simoninns/valiant-turtle/README.md

# valiant-turtle
Information and resources on the original 1980s Valiant Turtle robot

Please see the GitHub wiki for details.
