simoninns/valiant-turtle/valiant_docs/leaflets/The Valiant Turtle on the BBC.pdf

### VALIANT TECHNOLOGY LTD

(Sales) Gulf House, 370 York Aoad,Wandsworlh,London SW18 1SP Tel: (01) 874 8747/874 9000

THE VALIANT TURTLE ON THE BBC

The valiant Turtle can run fro,a most aicrocomputers. It is interfaced to various LOGOs and LOGO-type languages.

The performance of the Valiant TUrtle is affected by the software with which it is used. To obtain optimum performance, you should use a full implementation of LOGO.

These instructions cover the operation of the Valiant Turtle on the BBC Model 8 and BBC Kaster ~ith:

11 | Logotron LOGO and Serial Interface
21 | Logotron LOGO and Parallel Interface
3) LSL (LOGOsoftl LOGO
4) Acornsoft LOGO
51 | DART
6J | Valiant Mover Proqram.

We have recommended the adoption of a one-centimetre Turtle step as standard. You will find, however, that both the Loqotron Serial Interface and DART default to a TUrtle step of one millimetre. Using the software, in most cases you can altar the set Turtle step to your preference.

Unlike some other computer equipment, the Valiant TUrtle has a VERY PRECISE START-UP PROCEDURE. It is important to follow the instructions given step by step unless you are very confident
in using the equipment . This is because the Valiant Turtle is remote-controlled. The Communicator has to be synchronised with .the computer if the Turtle is to receive intelligible signal&.

If the Turtle does no t respond after you have carried out the various instructions IN TKE CORR£CT ORDER, consult the Trouble-shootinq section at the back of the Valiant Turtle User Guide.

(c J 1987 Valiant Technology Ltd. Part No. 29716 Issue B

The Valiant Turtle on the BBC

I N D E X

Page No.

Introduction

I N D E X

STARTING THE VALIANT TURTLE WITH,

pl

p2

1) Logotron LOGO & Serial Interface | pJ
2) Logotron LOGO & Parallel Interface | p4
3) LSL (LOGOsoft, LOGO | p5
4) Acornsoft LOGO | p6
5) DART {Making a Valiant driver file) | pi
DART (Starting up) | p8
6) Valiant Mover Program (Starting up) | p9
Valiant Mover Program details | plO,
Multiple Valiant Turtles | p6

pll

1 ) Starting the Valiant Turtle with Logotron ux;o and the Serial Interface

l | Switch the computer OFF.
2 | Position the 4 small coloured switches on the side of the Communicator
as follows (see Fig. l):
~ Switches l & 2 ON | i | g Switches 3 & 4 OFF | 0
Fig. l | Fig. 2 | Fig. 3
3 | Set both switches underneath the Turtle to OFF (see Fig 2).
4 | Insert the end of the Communicator lead which corresponds to Fig. 3 into
the serial socket on the Communicator Csee Fig. 4).
Fig . 4 | ~
~

Fig. 5
5 Insert the other end of the Communicator lead {Fig. 5)
into the RS423 socket at the back of the microcomputer.
IMPORTANT NOTE: | (a) | If you are using a BBC 'B' computer, FACE THE NOTCH
TOWARDS THE RGB SCX:KET 4on the left hand side when viewed from the rear of the computer].
(b) If you are using a BBC MASTER computer, FACE THE NOTCH AWAY FROM THE RGB SOCKET (on the right hand side when viewed from the rear of the computer).
Care MUST be taken since it is possible for the lead to be plugged in the wrong way round, when no signals will be transmitted to the Turtle.
6 | Switch ON the computer.
7 | Plug the Valiant power adaptor into your niains supply and turn on the
power.

B Push the jack plug on the end of the power adapter ' s lead firmly into the power socket at the rear of the Communicator (see Fig. 4).

9 If the red light behind the red Communicator screen does not illwninate, consult the Troubleshooting section of the Valiant Turtle User Guide.

10 You may switch on your Turtla any time from now.

11 Type *LOGO and press the RETURN key.

12 Insert EITHER the Valiant BBC software disc 29903 issue J or later OR Logotron LOGO Extension disc (from your LOGO pack) into the disc drive.

13 If you hav,e inserted the Valiant disc, type USE ·vALIANT and press the RETURN key.

If you have inserted the Lo9otron Extension dis c , type USE "uVAL and press the RETURN key .

14 Your Turtle system is now r e ady for use .

Remember your special Floor Turtle primitives in the Serial Interface: FLOOR, SCREEN, BOTH, SCALE, SETSCALE. The turtle's steps a re set at 1mm . Typing SCALE tells you this is 3 units. So typin9 St:rSCALE 30, for example, will set the turtle's steps at 1 centimetce.

2) starting the Valiant Turtle with Logotron LOGO and the Parallel Interface

Switch the computer OFF.

2 Position the 4 small coloured switches on the side of the Conununicator as follows (see Fig. 1):
~ Switch l OFF | lffi Switches 2, 3 "4 OM
Fig. 1 | Fig. 2 | Fig. 3
3 | Set both small switches underneath the Turtle to OFF (see Fig.2>.

### 4 Insert the end of the Communicator lead with 15 holes (see Fig. J) into

the D-shaped ("Parallel"! socket on the Communicator (see Fig. 4).

,~r1d,pCot
1,11d 1oock.tl

~
\.!!!!!!!.I | Fig. 4
5 | Insert the other end of the Communicator lead into the socket marked
'User Port' located underneath the computer.
6 | Switch ON the computer.
7 | Plug the Valiant power adaptor into your mains supply and turn on the
power.

8 Push the jack plug on the end of the power adaptor's lead firmly into the power socket at the rear of the Communicator Csee Fig. 41.

9 If the red light behind the red Communicator screen does not illuminate, consult the Troubleshooting section of the Valiant Turtle User Guide.

10 | You may switch on your TUrtle any ti•e from now.
11 | Typ@ *LOGO and press the RETURN key.
12 | Insert the Valiant BBC software disc 29903 OR the Logotron LOGO
Extension disc (from your LOGO pack] into the disc drive.

13 If you have inserted the Valiant disc, type USE "VI\LIANl and press the RETURN key.

| If you have inserted the Logotron Extension disc, type USE "uV.PARA
- and press t he RETURN key.

14 Your Turtle system is now ready for use.

The special Valiant floor turtle primitives in the Parallel Interface are : TURTLEON (floor and screen turtles f o llow LOGO commandst, TURTLEOFF (screen turtle only), SCALE (tells you the size of the turtle's steps in mi lli metres), and SETSCALE !allows you t o set the si~e of the turtle's steps in whole millimetres - decimal places are not e ffective).

- !late : If you have an early version of the Logotron Extension disc, you n,ay find that you need to type USE ftuVAL to find the Valiant Para llel Interface. On later versions, uVAL is used only for the Serial Interface.

3) Starting the Valiant Turtle "'ith LSL (L(X;OSoft) LOGO
Note: | You will need the Valiant 88C Serial Interface Kit.
l | switch the computer OFF.
2 | Position the 4 small coloured switches on the side of the Communicator
as follows (see Fig. 1):

Fig.

Switches l & 2 ON
Switches 3 & 4 OFF

Fig. 2

3 Set both switches underneath the Turtle to OFF (see Fig. 2).

~
~

Fig. 3

4 Insert the end of the Collllllunicator lead which corresponds to Fig. 3 into the Serial socket on the Communicator (see Fig. 4J.

'o n r,::::::;)
~\..:!!!!.::..I
\ | \ | [ "•· .
® ⁰
z | j | s ,~ ,1d.lp1Df | Seri.\! | P.ui1ll.t
lt?~d jO(kCl | Soehl | SGCkfl

Fig. 5

5 Insert the other end of the Communicator lead (Fig. SI into the RS423 socket at the back of the microcomputer.
IMPORTANT NOTE: | (a) | If you are using a BBC 'B' computer, FACE THE NOTCH
TOWARDS THE RGB SOCKET (on the left hand side when viewed from the rear of the computer) .
(b) If you are using a BBC MASTER computer, FACE THE NOTCH AWAY FROM THE RGB SOCKET (on the right hand side when viewed from the rear of the computer) .

plugged in the

### 6 Switch ON

Care must be taken since it is possible for the lead to be wrong way round, when no signals will be transmitted to the Turtle . the computer.

7 Plug the Valiant power adaptor into your mains supply and turn on the power.

8 Push the jack plug an the end of the power adaptor' s lead firmly into th~ power socke t at the rear of the Communic ator (see Fig . 41.

9 If the red light behind the r e d Conununicator screen does not illumi nate , cons ult the Troubleshooting s e c tion of the Valiant Turtle User Guide .

10 | You may switch on your Turtle any time from now.
11 | Type *LOGO and press the RETURN key .
12 | If you have LSL LOGO version 1.0, insert the Valiant BBC so ftware disc
29903 issue I or later into the disc drive.
If you have LSL LOGO version 1. 2 or later, insert t he LOGOs o ft Toolkit Disc l [comes with your LOGO pack> into the disc drive .

13 If you have inserted the Valiant disc, type *EXEC LSL and press RETURN. If you have inserted the LOGOso ft disc , EITHER type *EXEC VALOBJ
OR ho ld down the SHIFT ke y a nd press the BREAK key (ca lled "SHIFT-BREAK") .

14 Your Turtle system is now ready f or use.

Your special fl oo r turtle co1111n3nds a dde d to LOGO are, TURTLE OFF (stops the floor tur tle moving], TURTLE ON (sta r ts it again), a nd UNITS (turtle's steps are 1cm - or UNITS 10. Size of ste p can be changed by typ~ng UNITS
and a new number.).

41

fig. s

Starting the Vali .. nt Turtle with Acornsoft LOOO

Note: You will need the Valiant BBC Parallel interfac e Kit.

1 | Swi t ch the computer OFF.
2 | Position the 4 small coloured switches on the side of the Co!Mlunicator
as follows (see Fig. 1):

Fig. l

Swit ches
Switches

& 2 OFF
and 4 ON
Fig. 2 | Fig. 3
3 | Set both small switches underneath the Turtle to Off (see Fig. 2).

### 4 Jnsert the end of the Communicator lead with 15 holes (see Fig. 3) into

the P-shaped ("Parallel") socket on the Coma,unicator (see Fig. 4 ).

,ow~ ~ | lat | S.,... | ,M~~ I ,C~fi ~lr.M | So(lrt | ~cd,f't
5 | Insert the other end o! the Comraunicator lead into the &ocket ~arked
'User Port • located underneath the compute r.
6 | Switch ON the computer.
7 | Plug the Valiant power adaptor into your mains supply and turn on the
power.

8 Push the Jack plug on the end of the power adaptor lead firmly into the power socket at the rear of the Communicator (see Fig. 4 ) .

9 It the red light behind th• red Communicator screen does not illuminate, consult the Troubleshooting sec tion of the Valiant Turtle user Guide.

10 | You ma y switch on your Turtle a ny time froM no1,1.
11 | Type ' l,OGO a nd pres s the RETURN key.
12 | Insert the disc provided with Acornsoft LOGO into the dis c drive,
13 | Type LOAO " VALIANT and press the RETURN key. Type FLOOR and press RETURN .
14 | Your Turtle syste~ is now ready for use.

For details of the specia l Valiant floor turtle options, see your Aco rnsoft L(X;O manual .

Using Multiple Turtles with Acornsott LOGO

You can program up to 4 Vali ant Turtles independently using Acornsoft LOGO . See Chapter 12 in the Acornsof t LOGO <Mnual for information.

Follo,_. t.he i nstruc tions above, but set the SD\al l s1,1i tches underneath Turtl~ as follows jsee fig . 5):

each
[i;] | ~ ~ | ~

5) Starting the Valiant TUrtle with DART

Note; You will need the Valiant BBC S£R1AL Interface Kit.
You will need a BASIC 2 chip in your BBC ~odel B computer unless you have Valiant BBC software disc 29903 (or 29908) ISSUE Kor later.

TO_MAKE_A_VALIANT_TURTLE_DRIVER_FILE_ON_T"E DART_DISC

(al | If you have DART version 2.4 or later versions -
Type CHAIN "DART" | DART will then ask you to select which floor
turtle you want to use. Select l | for the Valiant TUrtla and follow
the instruct ions in the program. You will finish up with a tile saved onto disc or. tape called CART3
(bi | If you have DART version 2 . 3 -
Type LOAD "DART" | Then type

22020A\ z lJ:CALL&FFEE:PR0Cdy(l00):A\=B5:CALL&FFEE:PR0Cdy(l00) :A\;0: CALL&FFEE:A\z-p\•16:CALL&FFEE:*FXJ,O

then type SAVE "DART" Now follow the instructions above for CART version 2.4 or later versions.

(cl If you have DART version 2.2 or earlier versions, you will not be able to drive the Valiant Turtle from your copy of DART. Please contact The Advisory Unit at Hatfield, Herts., telephone (07072) 65443, who will advise you about obtaining an up to date version.

The steps outlined above need only be performed once. When they have been completed and when you subsequently want to use the Valiant Turtle, please follow the instruc tions overleaf (pages 8 and 9).

... the Valiant Turtle with DART {/continued)

TO START_UP_THE_TURTLE_SYSTEH

1 | Switch the computer OFF.
2 | Position the 4 small coloured switches on the side of the Collllllunicator
as follows (see Fig. 1):

Fig. 1

Switches l, 2 ON
Switches 3, 4 OFF

Fig. 2

3 Set both switches underneath the Turtle to OFF (see Fig. 2).

~
~

Fig. )

4 Insert the end of the C0111111,unicator lead which corresponds to Fig. 3 into the Serial socket on the C0111municator (see Fig. 4).

Fig. 4

row•• .idaplor
k,•d wckN
Se•i•I | P•r..Uel Sockel | Socket

~
~ Fig. 5

5 Insert the other
socket at the back o!

end o! the Communicator
the co.puter.

lead (Fig. 5) into the RS423

IMPORTANT NOTE: {al If you are using a BBC 'B' computer, FACE THE NOTCH TOWARDS THE RGB SOCKET (on the left hand side when viewed from the rear of the computer) .
(b) If you are using a BBC MASTER computer, FACE THE NOTCH AWAY FROM THE RGB SOCKET {on the right hand side when viewed from the rear of the computer).
Care must be taken since it is possible for the lead to be plugged in the other way round, when no signal will be transmitted to the Turtle
6 | Switc h ON the computer.
7 | Plug the Valiant power adaptor into your mains supply and turn on the
power.

8 Push the jack plug on the end of the power adaptor's lead firmly i nto the power socket at the rear of the Coamunicator (sea Fig. 4).

9 If the red light behind the red Communicator screen does not illuminate, consult the Troubleshooting se c tion of the Valiant Turtle User Guide.

10 | You may switch on your turtle any time from now .
11 | Insert the DART disc into the disc drive .
12 | Type CHAHI "DART]" and press the RETURN key .
13 | When yo u wish t o sta rt the floor turtle, type TURTLE ON and press the
Rl::TURN key.

14 Your Turtle s ystem is now ready f or use .

6) Starting the Valiant Turtle with the Valiant Mover Program

This software was written before any full LOGOs for the BBC were available. The program is limited and is not reconunended for long-term use. It will
move the Valiant TUrtle, however, in the absence of an alternative.
Note - You will need the BBC SERIAL Interface kit.
Unless you have Valiant BBC software disc 29903 (or 299081 issue Kor later you will need a BASIC 2 chip in your BllC Model B computer.
1 | Switch the computer OFF.
2 | Position the 4 small coloured switches on the side of the Conununicator
as follows (see Fig, 1):

Fig. 1

Switchea 1 ~ 2 ON
Switches 3 & 4 OFF

Fig. 2

3 Set both switches underneath the TUrtle to OFF (see Fig. 2).

~
~

Fig. 3

4 Insert the end of the Communicator lead which corresponds to· Fig. 3 into the Serial socket on the Connunicator (see Fig. 4).

P~rMJ~plor
Sc.-.ad )tK.ef
5 Insert" the other
socket at the back of
Suial | P•r~Uel
Sock<1 | Sockot
| end of the Cornmunicator
| the computer.

Fig. 4

~
~

Fig. 5

| | lead (Fig. 5) into the RS423

IMPORTANT NOTE: If you are using a BBC Model B computer, FACE THE NOTCH TOWARDS THE RGB SOCKET (on the left hand side when viewed from the rear of the computer).
If you are using a BBC Master computer, FACE THE NOTCH AWAY FROM THE RGB SOCKET (on the right hand side when viewed from the rear of the computer).
Care must be taken since it is possible for the lead to be plugged in the wrong way round, when the Turtle will not respond to commands.
6 | Switch ON the computer.
7 | Plug the Valiant power adaptor into your mains supply and turn on the
power.

8 Push the jack plug on the end of the power adaptor lead firmly into the power socket at the rear of the Communicator (see Fig. 4).

9 !f the red light behind the red Communicator screen does not illuminate, consult the Troubleshooting section of the Valiant TUrtle User Guide.

10 | You •ay switch on your TUrtle any time from now.
11 | Insert the Valiant BBC Software disc (or tape) into the disc drive (or
tape recorder).

12 Type CHAIN "TURTLE" and press the RETURN key. With the disc version , you can save time by holding down the SHIFT key and then pressing BRE~K (called "SHIFT-BREAK·).

13 The scree n will tell you to check the Conununicator and Turtle are both switched on. Then press the RETURN key.
14 | Your TUrtle system is now ready for use. | !More details overleaf/ .. )

... the Valiant Turtle with the Valiant Mover Program (/continued l)

USlNG THE VALIANT MOVER PROGRAM

Note : With the disc version of the Valiant Mover Prograa if you have any problems keep the disc in the disc drive, type HELP and then press the RETURN key.

onc e you have the Valiant MOver Prograa started, you will see a ~enu of cOCMtands at your disposal. This is a guide to the use of these commands .

FORWARD (FO) and
BACK (BK)

RIGHT (RT) and
LEFT (LT)

PENUP (PU) and
PENDOWN (PO)

SCALE

QUIT

HELP (disc only)

HELP (disc only!

EDIT (ED) and
TO

Both of these c01M1ands need to be given a nwaber. This nuaber represents the distance in 'turtle steps' that the Turtle will aove . You need to put a space between the coamand and the nwnber, e.g.
FO 10

These two c01M1ands require a nuaber which is the nUllber of degrees that the Turtle is to turn. As with FORWARD and BACK, you must put a space between the command and the nuaber, e .g .
RT 90

These co ... ands make the Turtle raise and lower its pen. They do not need any other information and so should be entered on their own .

This coemand allows you to change the size of the Turtle's steps (set automatically to 10mm, lcmi. Just enter the word SCALE on its own and the computer will tell you what the current size ot a Turtle step is and give you the opportunity to change it if you wish.

When you have finished using the Turtle, type QUlT. The coaputer will ask if you are sure you want to QUIT.
Enter YES or you will be returned to the .. nu .
The coamand QUIT allow• you to leave the Valiant Mover Program. It will erase all the procedures in the computer's aUIOry.

HELP will tell you how to get infonaation on any co111111and.

HELP followed by a co111111&nd will give you inforiaation on how to use that command, e.g. HELP FD will tell you how to use FORWARD.

It is possible to define a 'procedure'. This is a way of stringing several coaiaanda together. To write a procedure, type TO followed by the name of your procedure, or EDlT followed by the na111e of the procedure .

This will get you into the 'Editor'. The Editor will allow you to enter text using the alphabetic and numeric keys, and to change text using the cursor keys and DELETE key . In the Editor, the DELETE key deletes the character behind the cursor.

The backslash key can be used to insert spaces into your procedure.

CURSOR KEYS

BACKSLASH KEY

••. the Valiant Turtle with the Valiant Mover Program.C/continued 21

USING THE VALIANT MOVER PROGRAM (/continued)

PROCS (PR)

ERASE (ERJ

SAVE

LOAD

Your procedures should comprise one CO!lffland to a line and may not exceed the size of the screen .

When you have finished writing or editing your procedure, press fO, or if you want to leave the Editor without saving the procedure, press f9.

If subsequently you wish to change your procedure, you can do so by entering
EDIT and the procedure name.

Note: (ii To rep<!at a routine a number of times, typ<! REPEAT space number space <:( space routine space> e.g.

TO SQUARE
REPEAT 4 Z FD 10 RT 90 >

You must insert a space before and after each angular bracket.

(iiJ To input a variable to a procedure, type : and t he variable name in the title line of the procedure, e.g.

TO SQUARE , SIDE
REPEAT 4 < FD :SIDE RT 90 >

SQUARE will then require a numeric input, e .g.
SQUARE 20

You may use •ore than one input with a procedure, e.g . TO POLY :NUMBER :SIDE :ANGLE

This command gives a list of the procedures in the
computer ' s memory . It does not need any othbr information.

This colNl!and needs the name of a procedure to follow it, e.g. ERASE SQUARE. ERASE will make the computer forget that procedure.

Note , Use this command with care. Once erased, a procedure cannot be got back again .

This comma nd will allow you to save either a specific procedure (e .g. SAVE SQUARE), or all the procedures currently in the computer 's memory, on disc or tape under the chosen file name (e.g. SAVE FILENAME).

This command will all ow you to load t he procedure you have saved on disc or tape back into the computer , e . g. LOAD SQUARE , or all the procedures saved under the chosen file name, e.g. LOAD FILENAME.

Note: Any procedure(sl already of that file name in the computer's memory will t her eby be erased.
