simoninns/valiant-turtle/valiant_docs/service/Valiant - Circuit Schematics.pdf

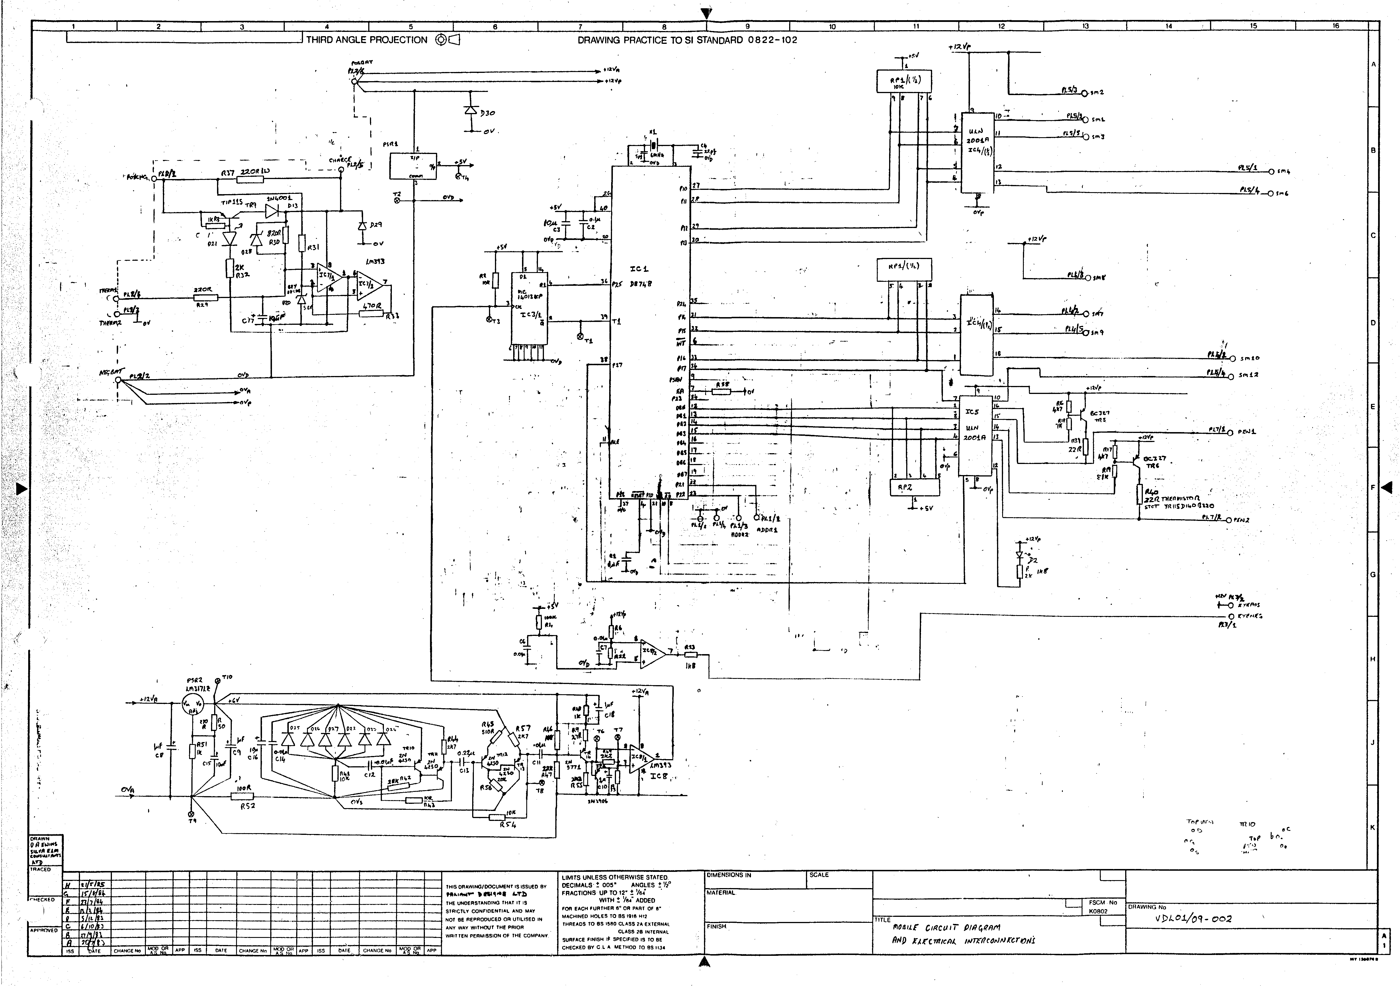
[picture p25: page 1]
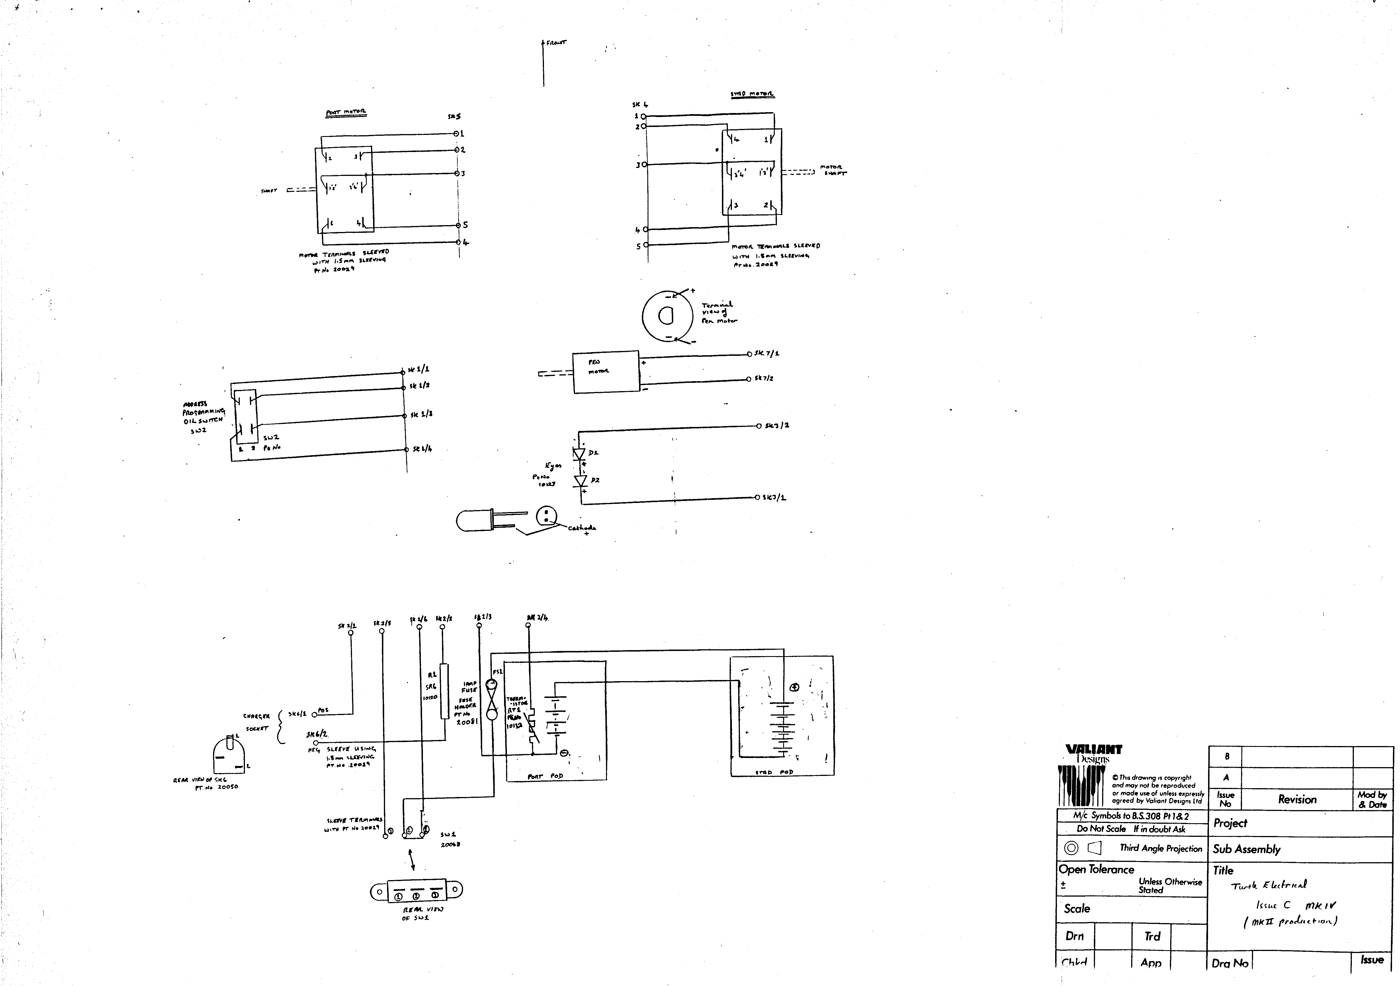
[picture p26: page 2]
