simoninns/valiant-turtle/valiant_docs/service/Valiant - Parts List for Mark II Valiant Turtle.pdf

\~~1.1,~NT

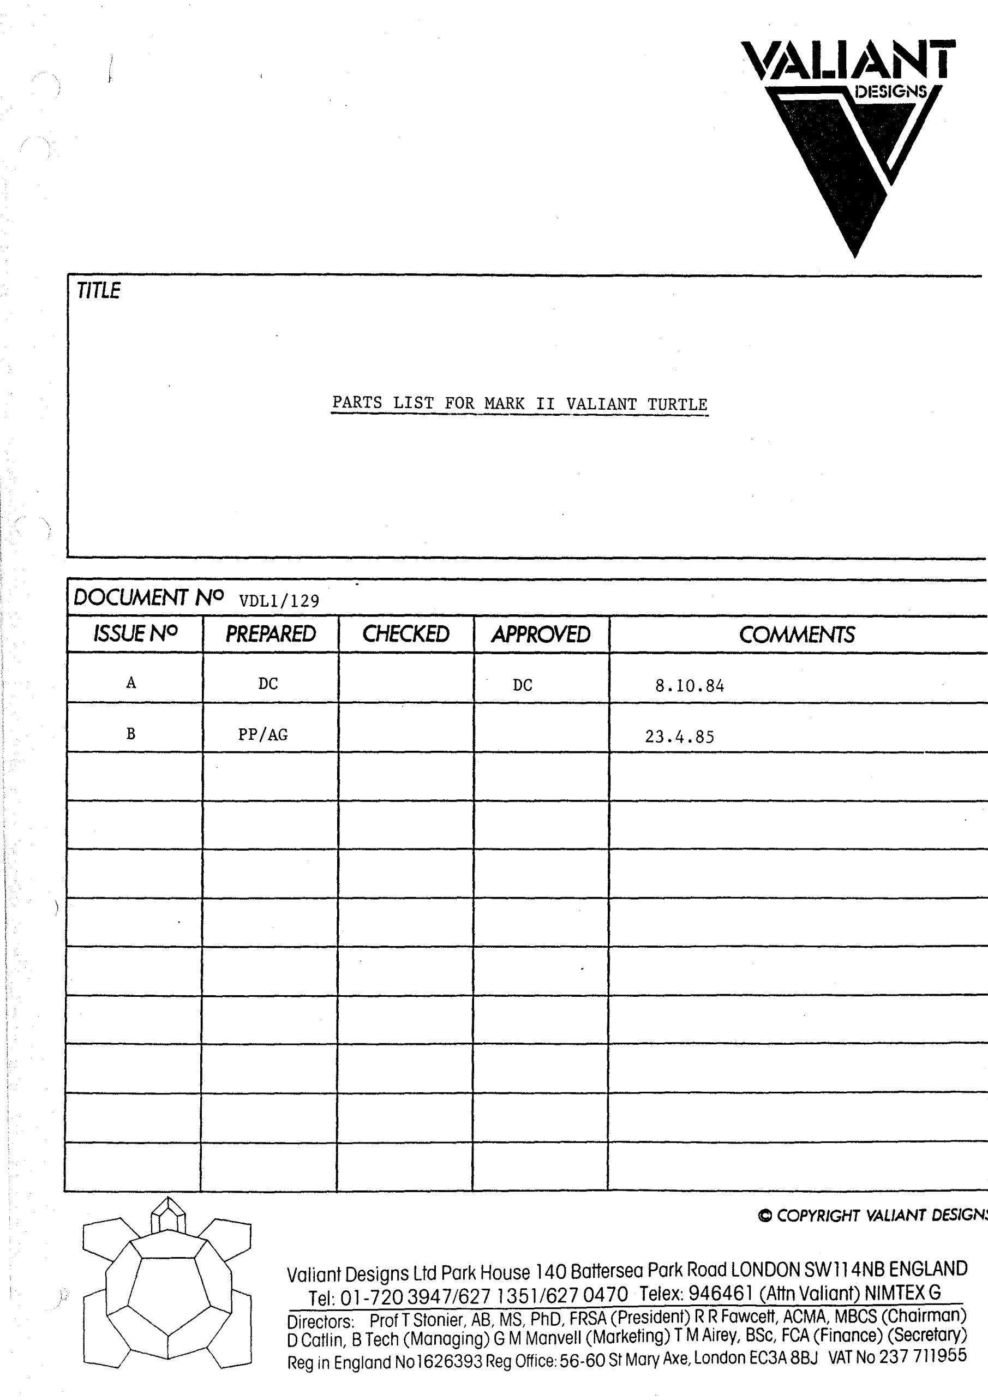
[picture p33: page 1]

### TITLE

PARTS LIST FOR MARK II VALIANT TURTLE

### DOCUMENT NO VDLl/129 ISSUE NO

A

B

PREPARED | CHECKED | APPROVED | COMMENTS
DC | DC | 8.10.84 | -
PP/AG | 23.4.85 | I

I

C COPYRIGHT VALIANT DESIGNS

Valiant Designs Ltd Park House 140 Battersea Park Road LONDON SWl l 4NB ENGLAND Tel: 01-720 394 7 /627 1351/62704 70 Telex: 946461 (Attn Valiant) NIMTEX G Directors: Prof T Stonier, AB, MS, PhD, FRSA (President) RR Fawcett, ACMA, MBCS (Chairman) D Catlin, B Tech (Managing) GM Manvel! (Marketing) TM Airey, BSc, FCA (Finance) (Secretary) Reg in England No 1626393 Reg Office: 56-60 St Mary Axe, London EC3A 8BJ VAT No 237 711955

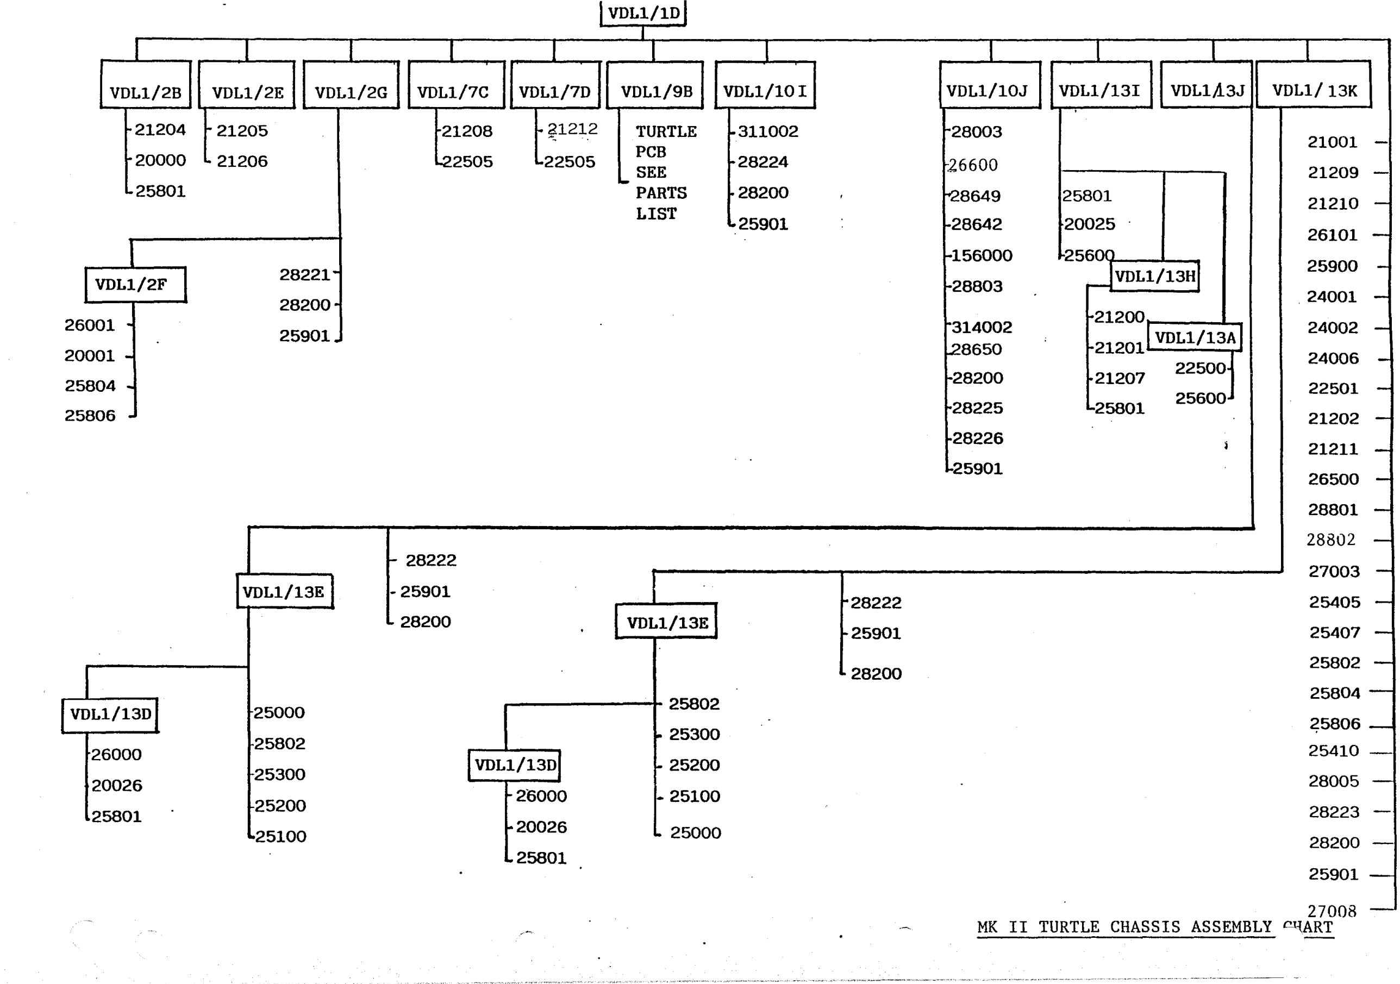
[picture p34: page 2]

VDL1/2B 11 VDL1/2E 11 VDL1/2G 11 VDL1/7C 11 VDL1/7D 11 VDL1/9B I I VDLl/10 I 21204 t 21205

20000 21206
25801

VDL1/2F

26001
20001
25804
25806

VDL1/13D

26000
20026
25801

28221
28200
25901

VDL1/13E

25000
25802
25300
25200
25100

21208
2505

28222
- 25901
28200

~1212
22505

TURTLE
PCB
SEE
PARTS
LIST

VDL1/13E

.--~~~~~+25802
25300
VDL1/13D
20000
20026
25801

25200
- 25100

25000

311002
28224
28200
25901

28222
25901

28200

VDLl/lOJ I I VDL1/13I 11 VDL1A.3J II VDLl/ 13K

28003
:26600
8649
28642
156000
28803

314002
8650
28200
28225
28226
·25901

25801
20025

21200

21201,-1 VD-Ll_/_1_1_~~ I

21207
25801

22500
25600

21001
21209
21210
26101
25900
24001
24002
24006
22501
21202
21211
26500
28801
28802
27003
25405
25407
25802
25804
~5806
25410 -
28005
28223
28200
25901
27008
MK II TURTLE CHASSIS ASSEMBLY ~qART

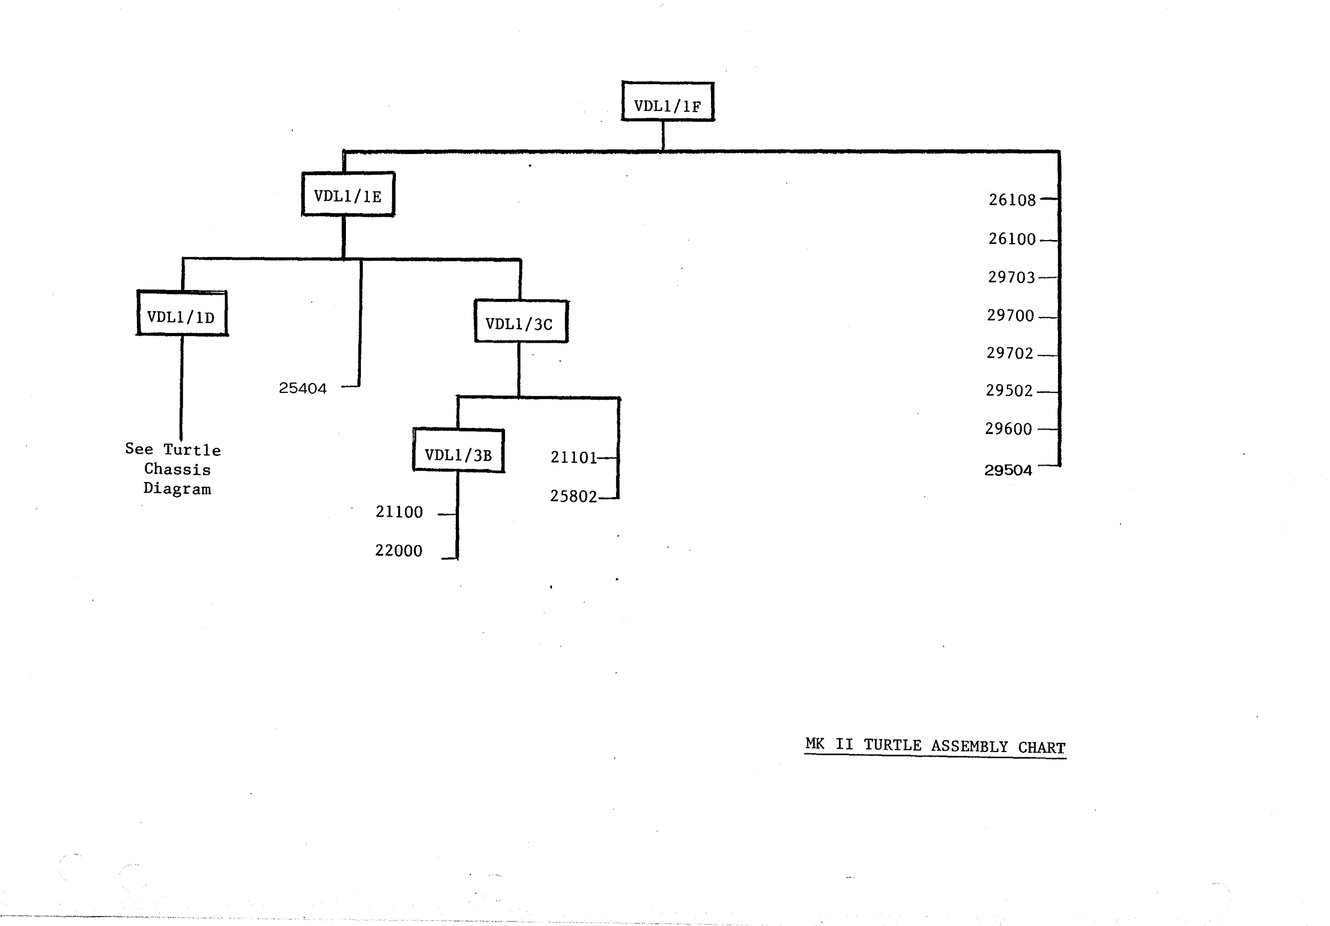
[picture p35: page 3]

VDL1/1D

See Turtle
Chassis
Diagram

VDLl/lE

25404

21100

22000

VDL1/3C

VDL1/3B | 21101
| 25802

VDLl/lF

26108

26100

29703-

29700

29702

29502

29600

29504

MK II TURTLE ASSEMBLY CHART

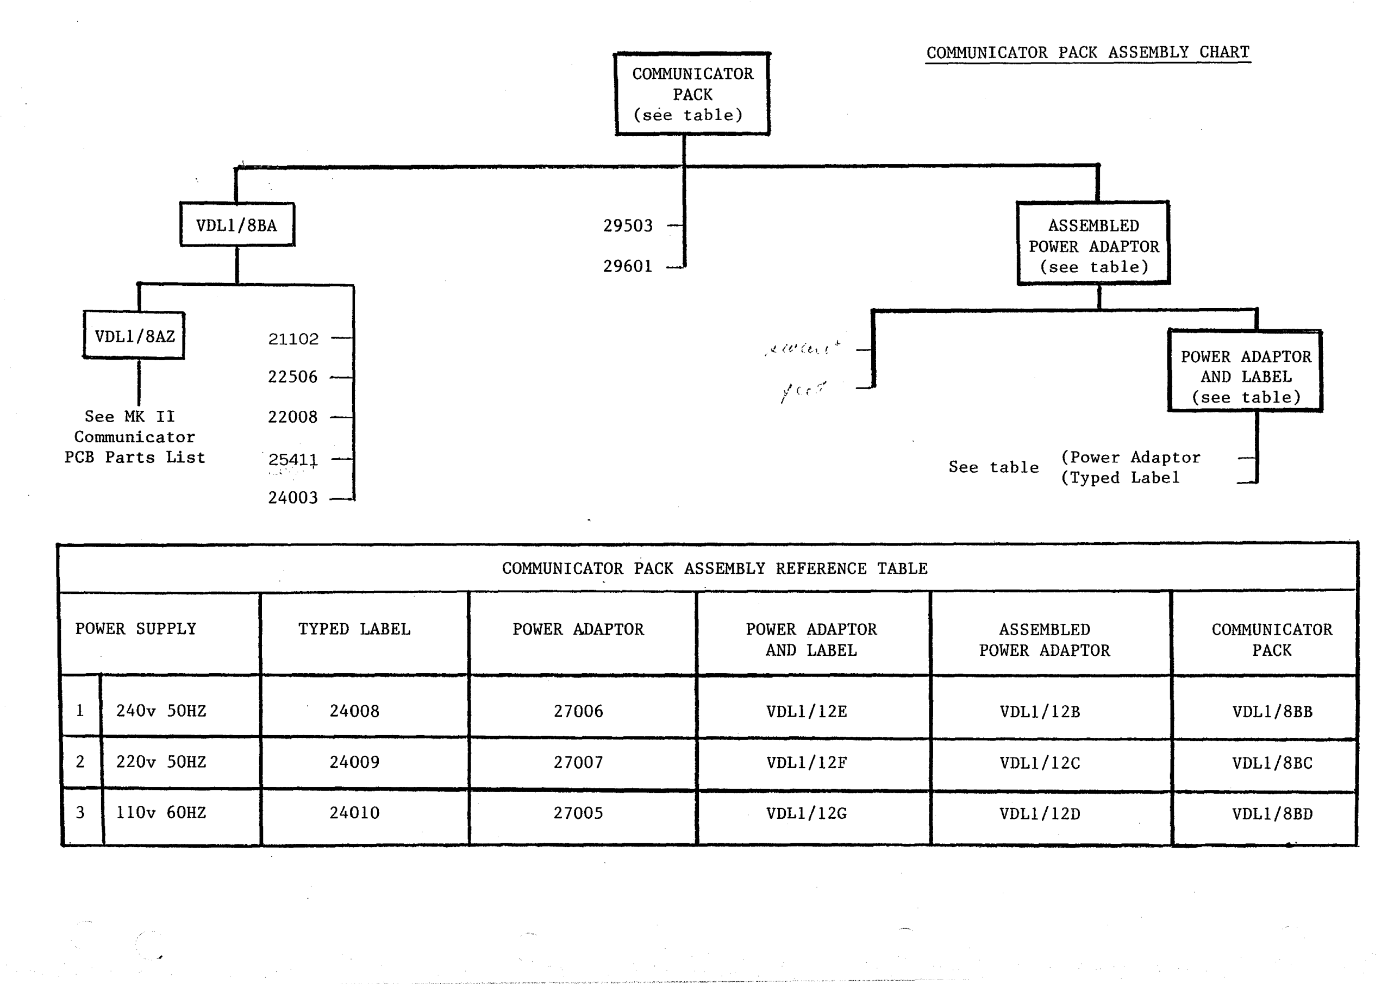
[picture p36: page 4]

VDL1/8BA

VDL1/8AZ

See MK II
Communicator
PCB Parts List

POWER SUPPLY

1 | 240v 50HZ
2 | 220v 50HZ
3 | 110v 60HZ

21102
22506

22008

2541+
24003

TYPED LABEL

24008

24009

24010

COMMUNICATOR PACK ASSEMBLY CHART COMMUNICATOR
PACK
(see table)

29503

29601

it. It' (ti t

/' ( r ·/

COMMUNICATOR PACK ASSEMBLY REFERENCE TABLE

POWER ADAPTOR | POWER ADAPTOR AND LABEL
27006 | VDLl/ 12E
27007 | VDL1/12F
27005 | VDL1/12G

ASSEMBLED
POWER ADAPTOR
(see table)

POWER ADAPTOR
AND LABEL
(see table)

See table (Power Adaptor
(Typed Label
ASSEMBLED | COMMUNICATOR
POWER ADAPTOR | PACK
VDL1/12B | VDL1/8BB
VDL1/12C | VDL1/8BC
VDL1/12D | VDL1/8BD

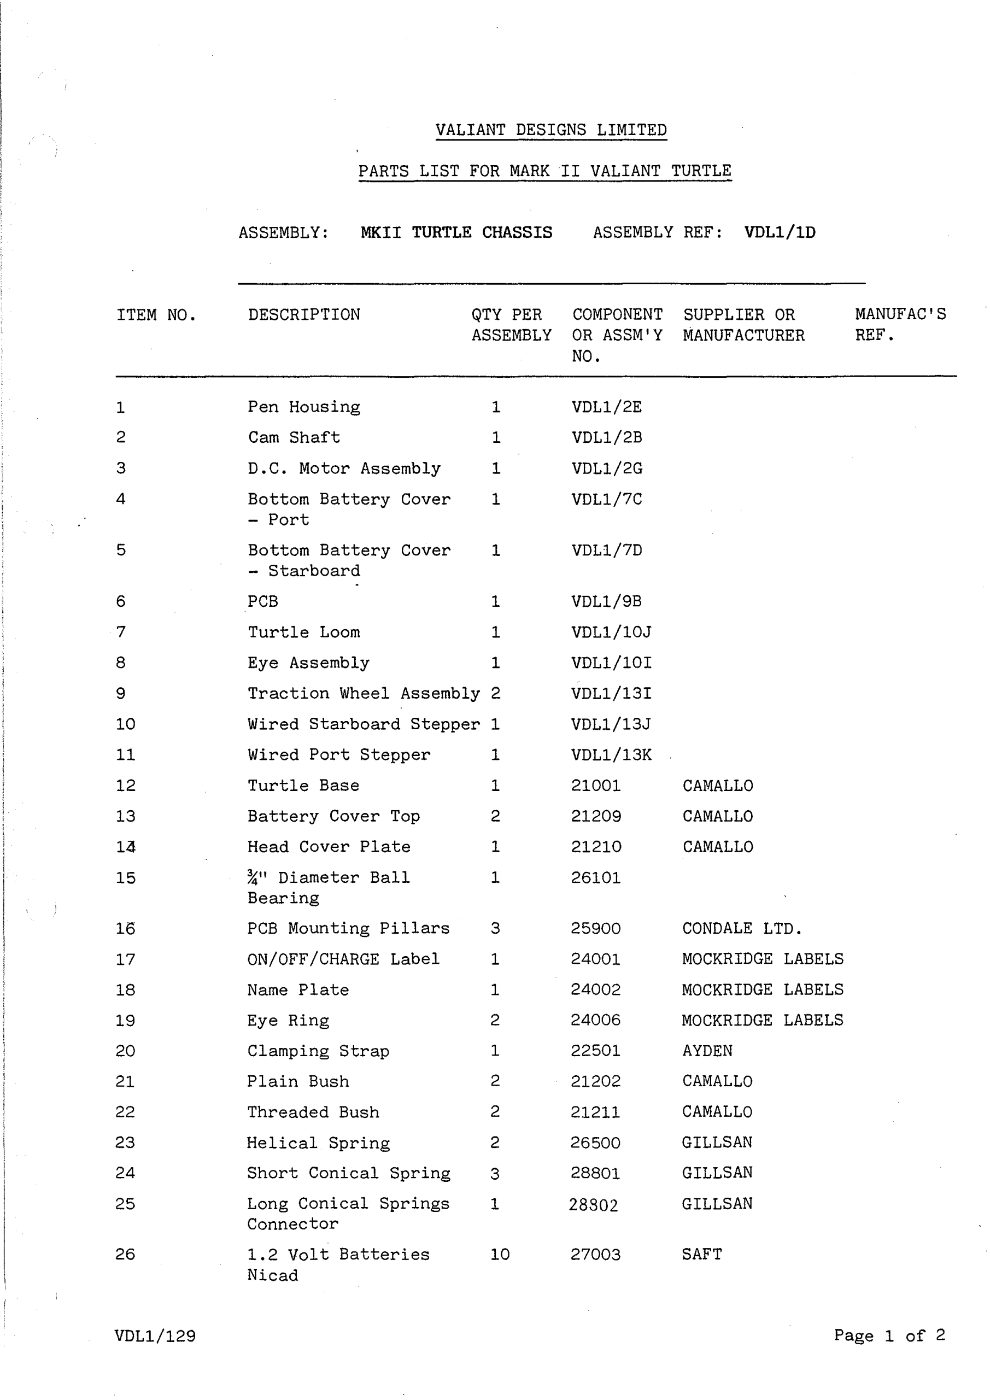
[picture p37: page 5]

ITEM NO.

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
VDLl/129

VALIANT DESIGNS LIMITED

PARTS LIST FOR MARK II VALIANT TURTLE

ASSEMBLY: | MKII TURTLE CHASSIS | ASSEMBLY REF: VDL1/1D
DESCRIPTION | QTY PER | COMPONENT SUPPLIER OR
ASSEMBLY OR ASSM'Y MANUFACTURER
| | NO.

Pen Housing
Cam Shaft
D.C. Motor Assembly
Bottom Battery Cover
- Port
Bottom Battery Cover
- Starboard
PCB
Turtle Loom
Eye Assembly

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
Traction Wheel Assembly 2
Wired Starboard Stepper 1
Wired Port Stepper
Turtle Base
Battery Cover Top
Head Cover Plate
%¹¹ Diameter Ball
Bearing
PCB Mounting Pillars
ON/OFF/CHARGE Label
Name Plate
Eye Ring
Clamping Strap
Plain Bush
Threaded Bush
Helical Spring
Short Conical Spring
Long Conical Springs
Connector
1.2 Volt Batteries
Nicad

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
VDL1/2E
VDL1/2B
VDL1/2G
VDL1/7C

VDL1/7D

VDL1/9B
VDLl/lOJ
VDLl/lOI
VDL1/13I
VDL1/13J
VDL1/13K
21001
21209
21210
26101

25900
24001
24002
24006
22501
21202
21211
26500
28801
28802

27003

CAMALLO
CAMALLO
CAMALLO

CONDALE LTD.
MOCKRIDGE LABELS
MOCKRIDGE LABELS
MOCKRIDGE LABELS
AYDEN
CAMALLO
CAMALLO
GILLSAN
GILLSAN
GILLSAN

SAFT

MANUFAC'S
REF.

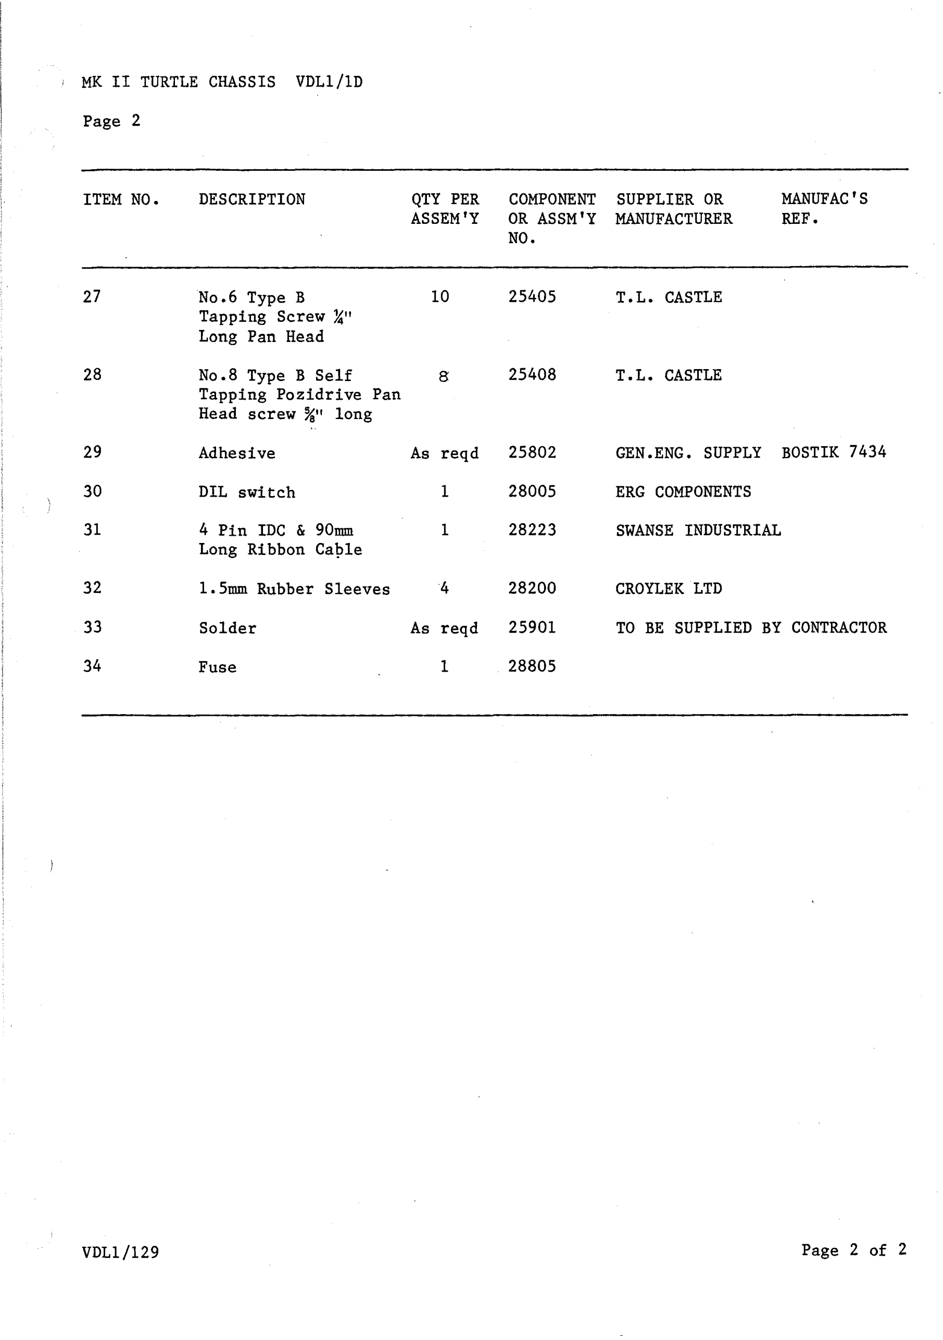
[picture p38: page 6]

1 | MK II TURTLE CHASSIS VDLl/lD
| Page 2
ITEM NO. | DESCRIPTION
27 | No.6 Type B Tapping Screw~" Long Pan Head
28 | No.8 Type B Self Tapping Pozidrive Pan Head screw%" long ..
29 | Adhesive
30 | DIL switch
31 | 4 Pin !DC & 90mm. Long Ribbon Caple
32 | 1.5mm Rubber Sleeves
33 | Solder
34 | Fuse
QTY PER | COMPONENT SUPPLIER OR | MANUFAC'S
ASSEM'Y | OR ASSM'Y MANUFACTURER | REF.
NO.
10 | 25405 | T.L. CASTLE
8 | 25408 | T.L. CASTLE
As reqd | 25802 | GEN.ENG. SUPPLY BOSTIK 7434
1 | 28005 | ERG COMPONENTS
1 | 28223 | SWANSE INDUSTRIAL
4 | 28200 | CROYLEK LTD
As reqd | 25901 | TO BE SUPPLIED BY CONTRACTOR
1 | 28805

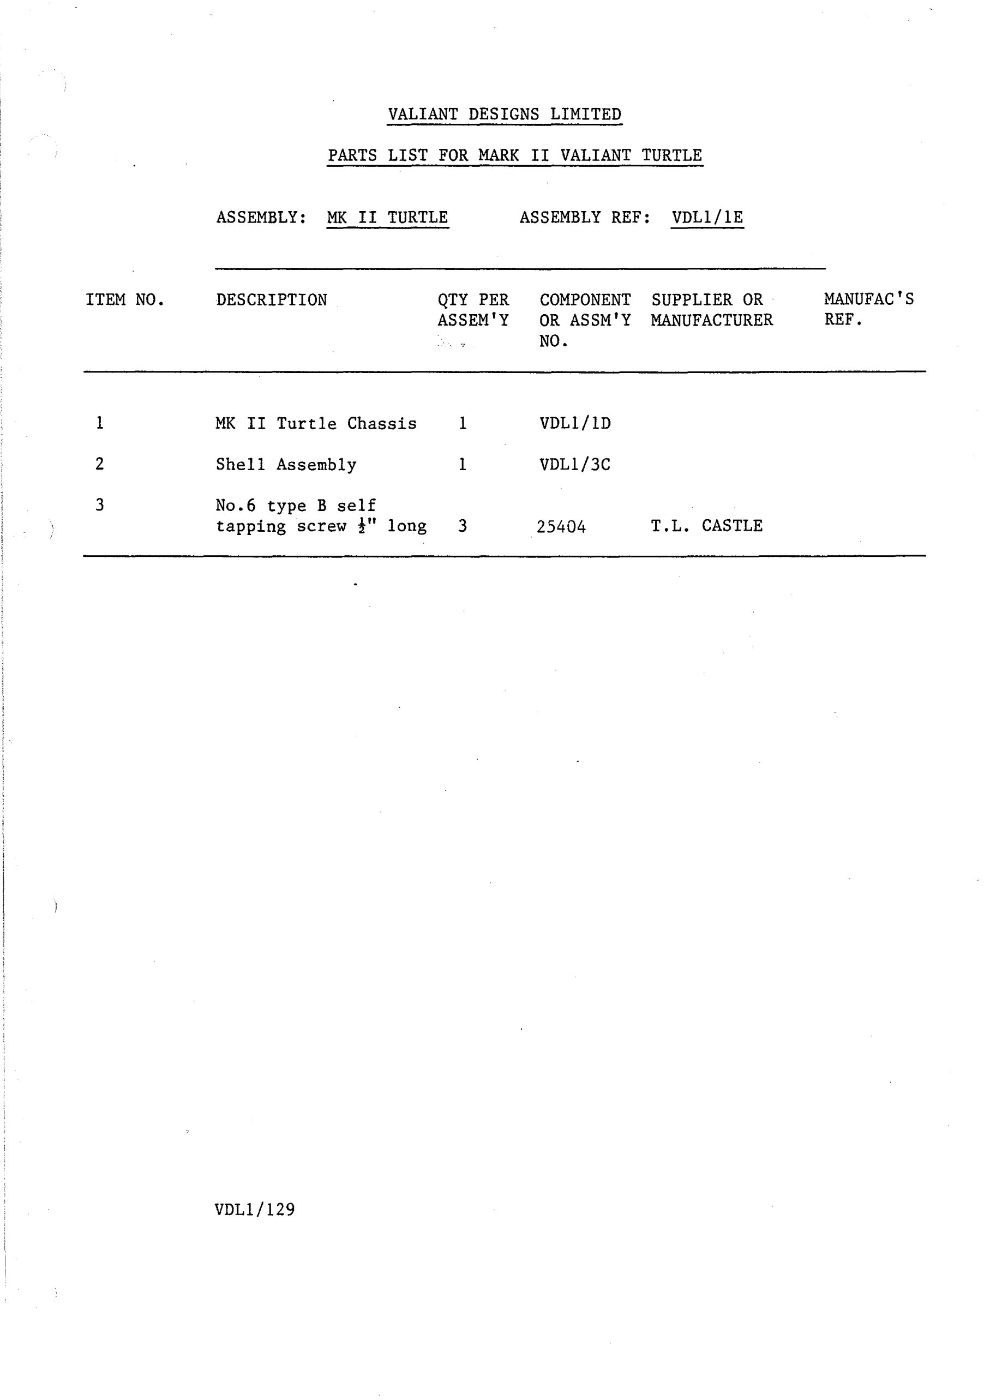
[picture p39: page 7]

ITEM NO.

1

2

3

VALIANT DESIGNS LIMITED

PARTS LIST FOR MARK II VALIANT TURTLE

ASSEMBLY: MK II TURTLE | ASSEMBLY REF: VDLl/lE

DESCRIPTION

MK II Turtle Chassis

Shell Assembly

No.6 type B self

QTY PER | COMPONENT SUPPLIER OR
ASSEM'Y | OR ASSM'Y MANUFACTURER
| NO.

1

1

VDLl/lD

VDL1/3C

tapping screw!" long | 3 | 25404 | T.L. CASTLE

VDLl/129

MANUFAC'S
REF.

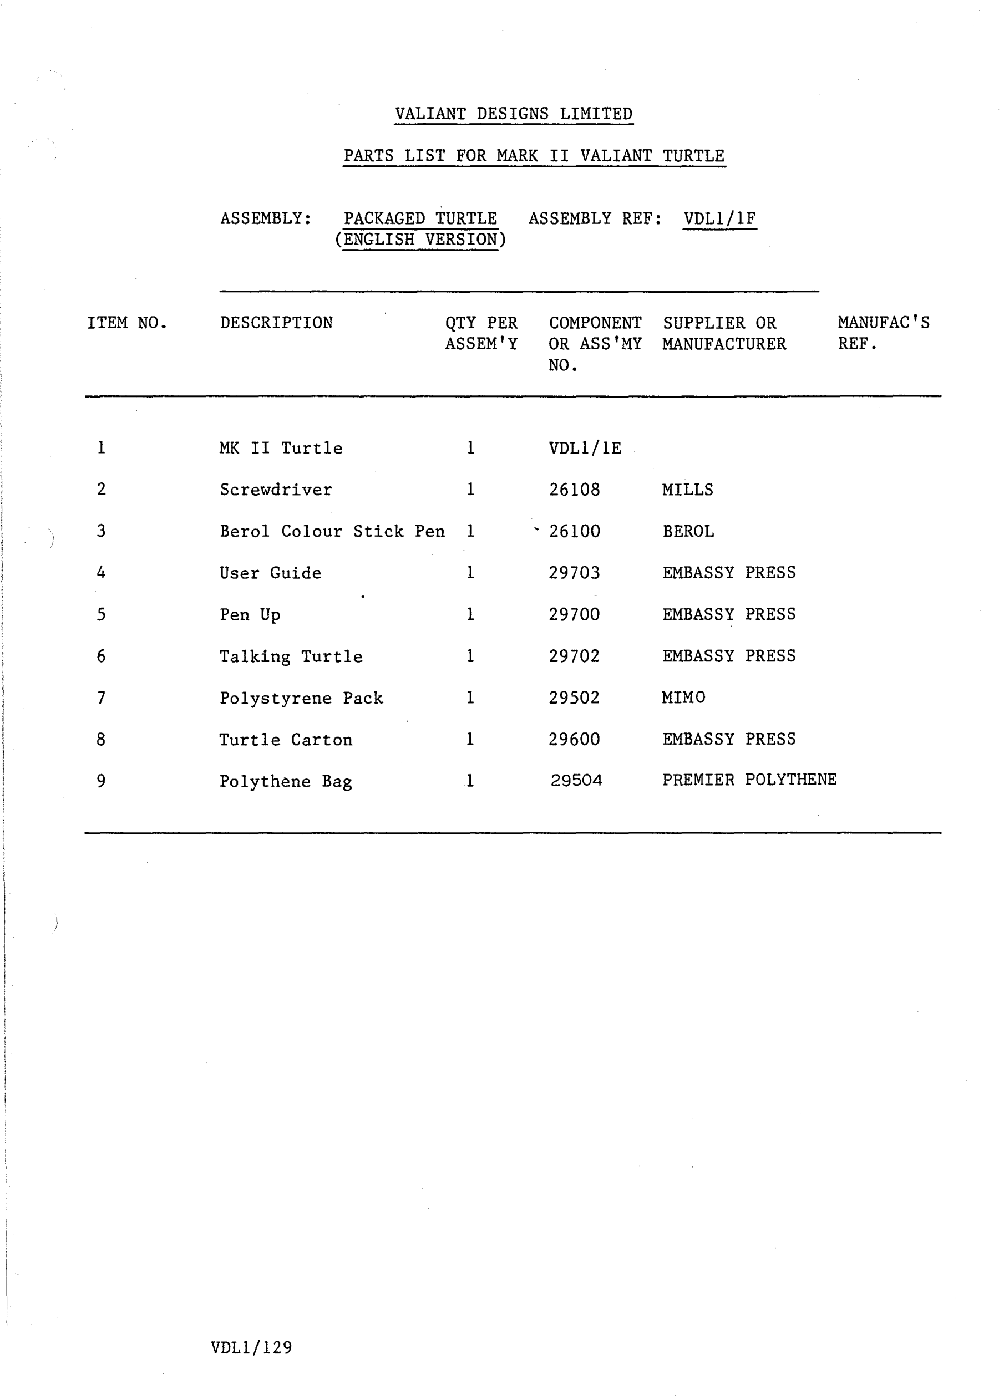
[picture p40: page 8]

ITEM NO.

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
VALIANT DESIGNS LIMITED

PARTS LIST FOR MARK II VALIANT TURTLE

ASSEMBLY: | PACKAGED TURTLE | ASSEMBLY REF: VDLl/lF
| (ENGLISH VERSION)

DESCRIPTION

MK II Turtle

Screwdriver

Berol Colour Stick Pen

User Guide

Pen Up

Talking Turtle

Polystyrene Pack

Turtle Carton

Polythene Bag

QTY PER | COMPONENT SUPPLIER OR
ASSEM'Y | OR ASS'MY MANUFACTURER
| NO.
1 | VDLl/lE
1 | 26108 | MILLS
1 | ~ 26100 | BEROL
1 | 29703 | EMBASSY PRESS
1 | 29700 | EMBASSY PRESS
1 | 29702 | EMBASSY PRESS
1 | 29502 | MIMO
1 | 29600 | EMBASSY PRESS
1 | 29504 | PREMIER POLYTHENE

MANUFAC'S
REF.

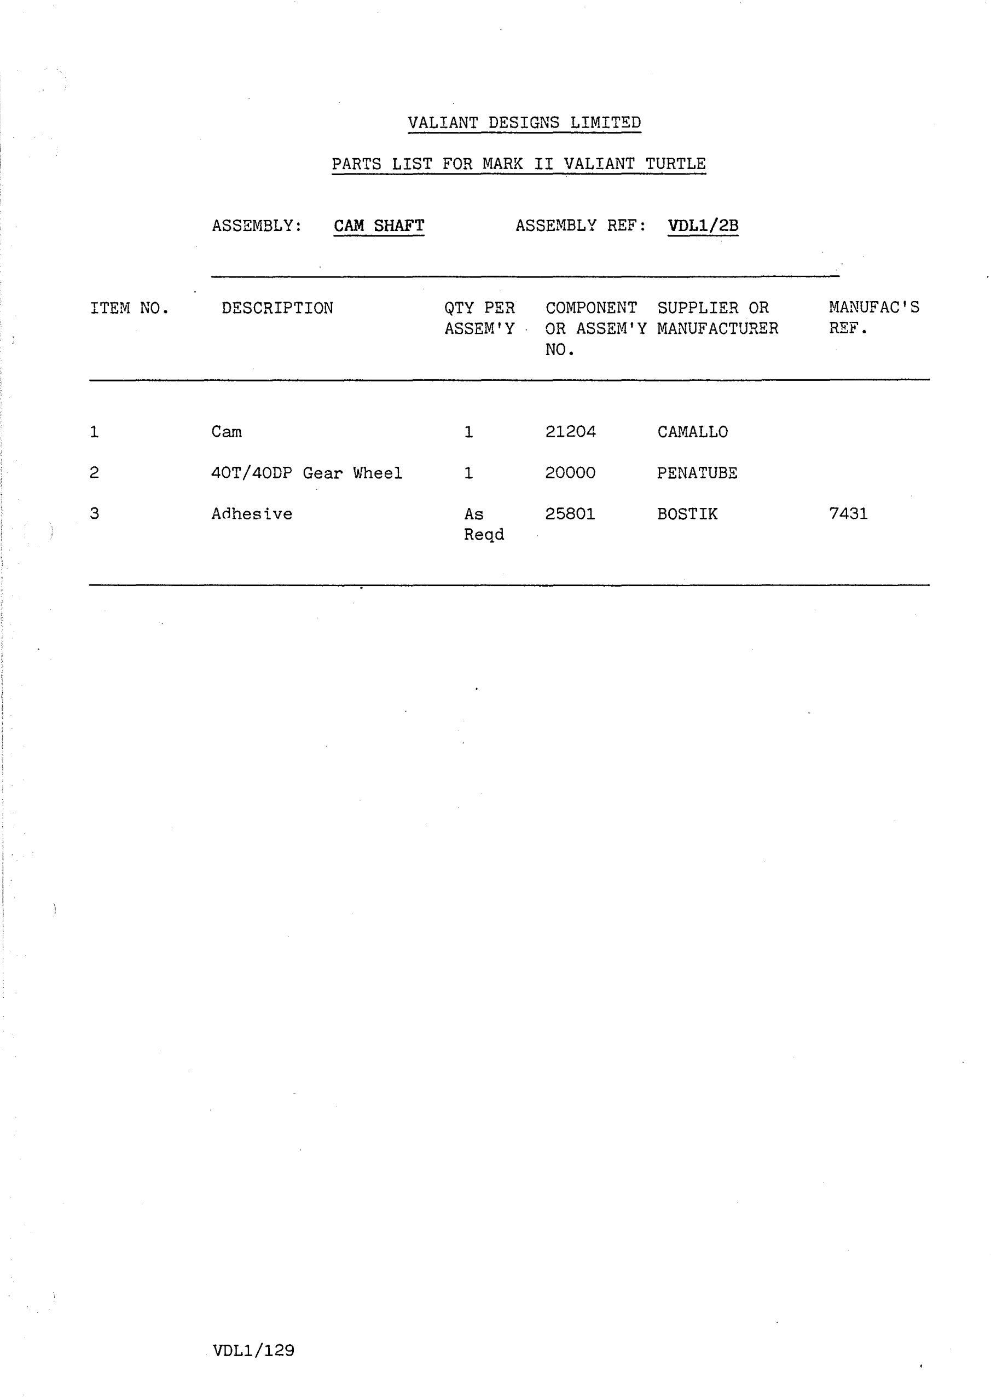
[picture p41: page 9]

ITEM NO.

1

2

3

VALIANT DESIGNS LIMITED

PARTS LIST FOR MARK II VALIANT TURTLE

ASSEMBLY: CAM SHAFT

DESCRIPTION

Cam
40T/40DP Gear Wheel

Adhesive

QTY PER
ASSEM'Y

1

1

As
Reqd

ASSEMBLY REF: VDL1/2B

COMPONENT SUPPLIER OR
OR ASSEM'Y MANUFACTURER
NO.

21204

20000

25801

CAMALLO

PENATUBE

BOSTIK

MANUFAC'S
REF.

7431

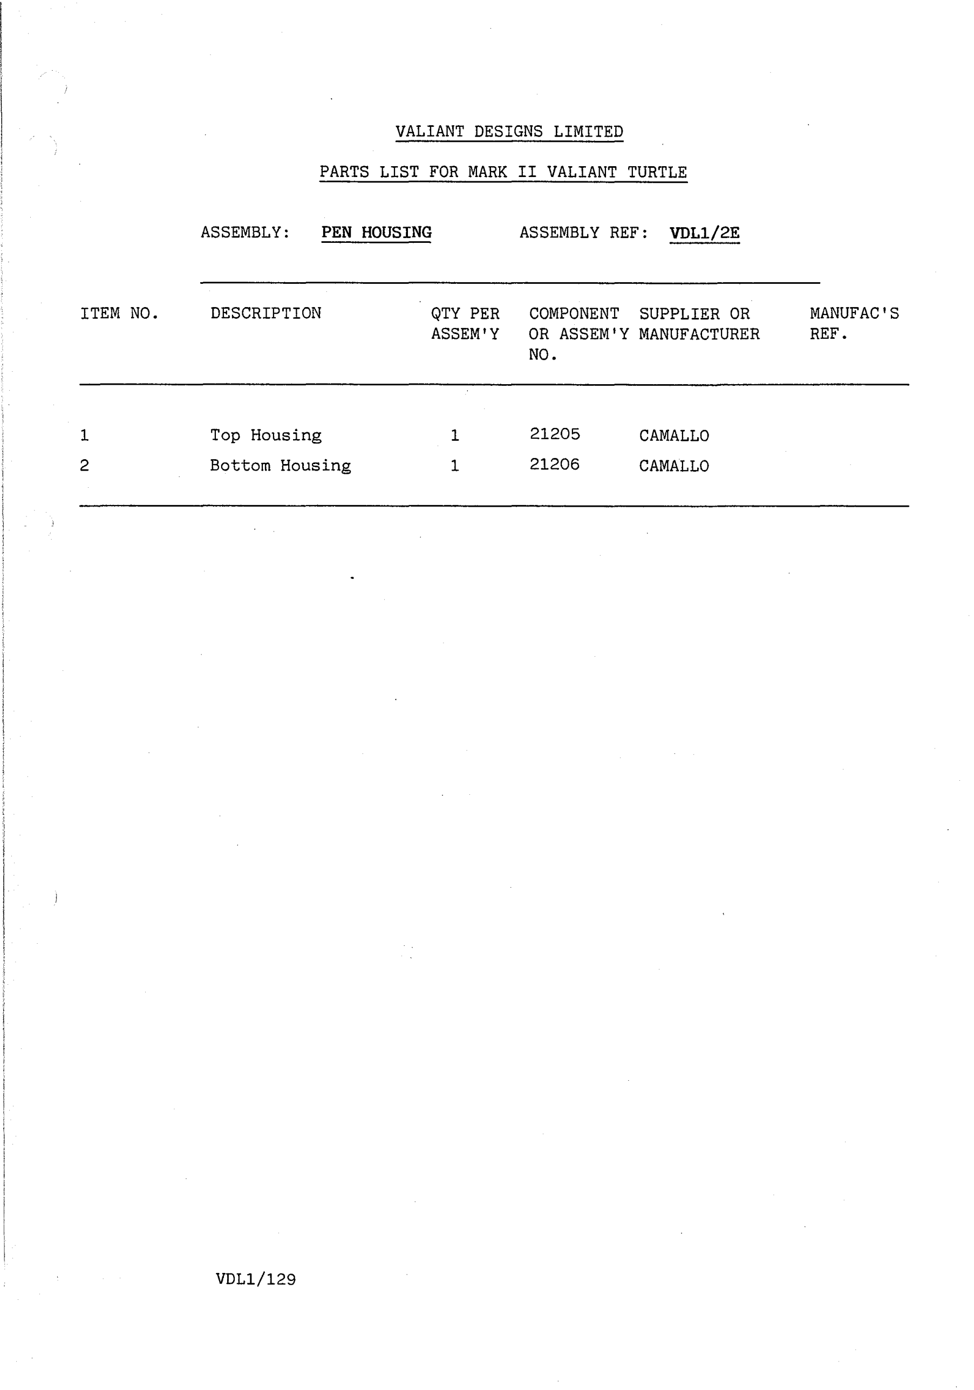
[picture p42: page 10]

ITEM NO.

1
2

VALIANT DESIGNS LIMITED

PARTS LIST FOR MARK II VALIANT TURTLE

ASSEMBLY: | PEN HOUSING | ASSEMBLY REF: VDL1/2E

DESCRIPTION

Top Housing
Bottom Housing
QTY PER | COMPONENT SUPPLIER OR
ASSEM'Y | OR ASSEM'Y MANUFACTURER
| NO.

1
1

21205
21206

CAMALLO
CAMALLO

MANUFAC'S
REF.

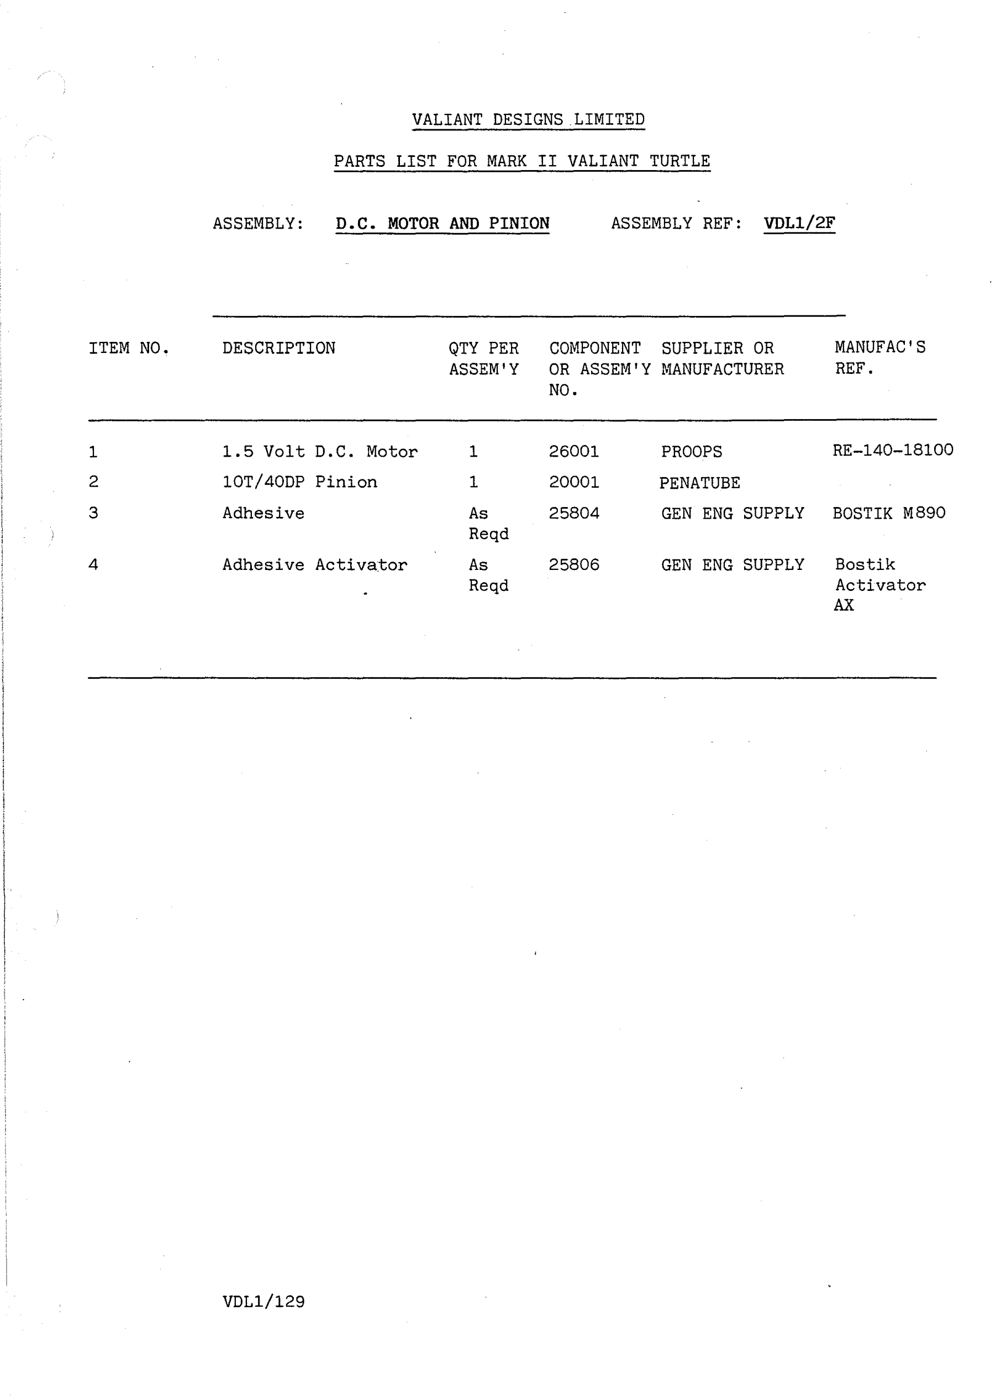
[picture p43: page 11]

VALIANT DESIGNS LIMITED

PARTS LIST FOR MARK II VALIANT TURTLE

ASSEMBLY: | D.C. MOTOR AND PINION | ASSEMBLY REF: VDL1/2F
ITEM NO. | DESCRIPTION | QTY PER | COMPONENT SUPPLIER OR | MANUFAC'S
ASSEM'Y | OR ASSEM'Y MANUFACTURER | REF.
NO.
1 | 1.5 Volt D.C. Motor | 1 | 26001 | PROOPS | RE-140-18100
2 | 10T/40DP Pinion | 1 | 20001 | PENATUBE
3 | Adhesive | As | 25804 | GEN ENG SUPPLY | BOSTIK M890
| | Reqd
4 | Adhesive Activator | As | 25806 | GEN ENG SUPPLY | Bostik
| | Reqd | | | Activator
| | | | | AX

VDLl/129

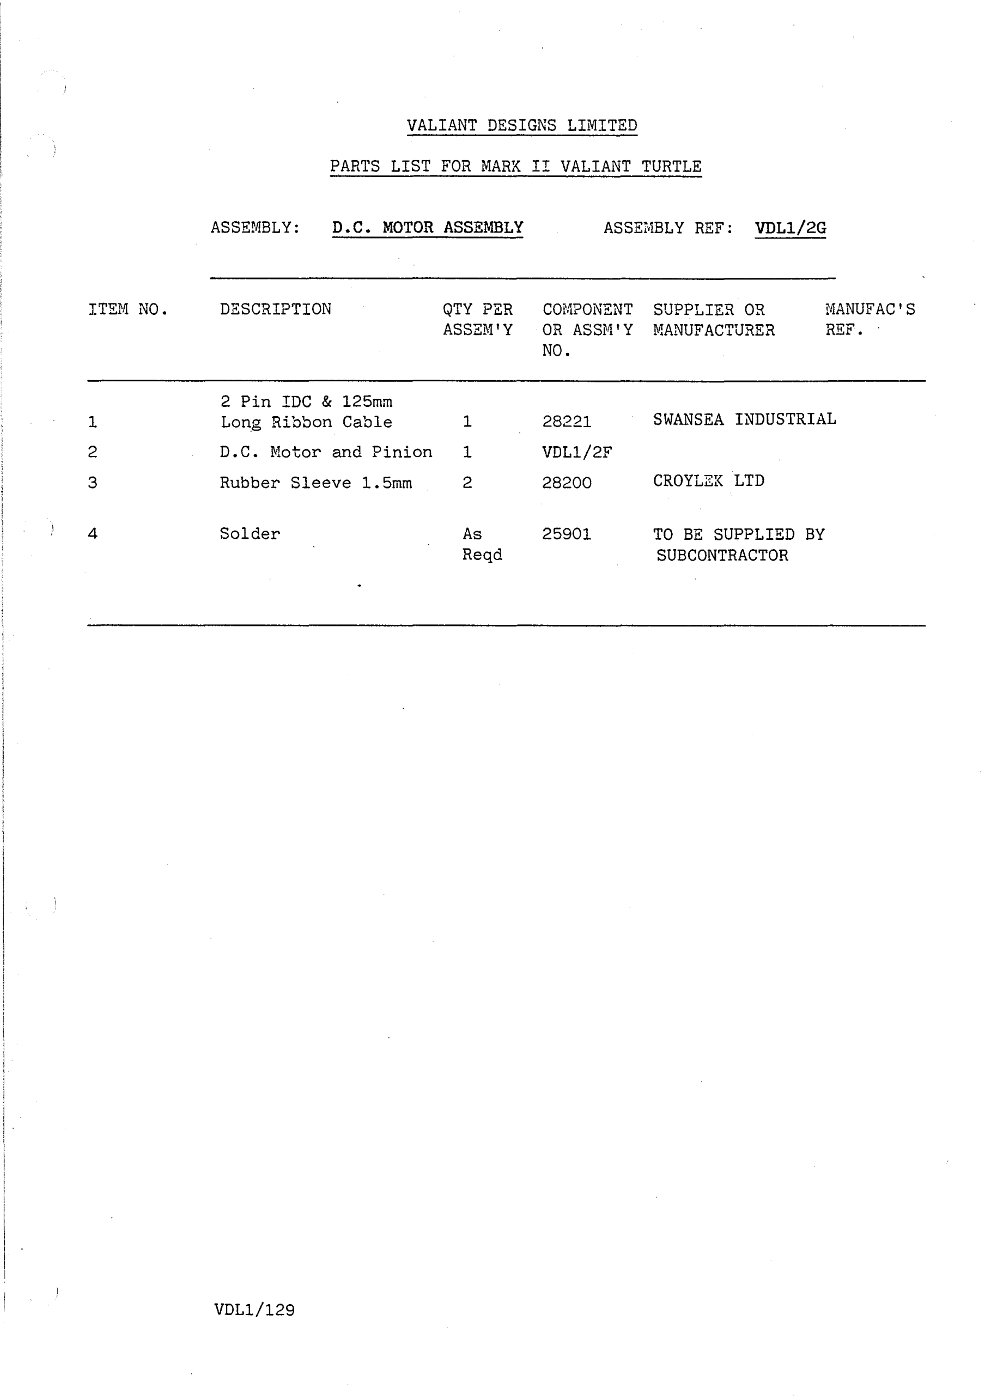
[picture p44: page 12]

VALIANT DESIGNS LIMITED

PARTS LIST FOR MARK II VALIANT TURTLE

ASSEMBLY: | D.C. MOTOR ASSEMBLY | ASSEMBLY REF: VDL1/2G
ITEM NO. | DESCRIPTION | QTY PER | COMPONENT SUPPLIER OR | MANUFAC'S
ASSEM'Y | OR ASSM'Y MANUFACTURER | REF.
NO.

2 Pin IDC & 125mm
1 | Long Ribbon Cable | 1 | 28221 | SWANSEA INDUSTRIAL
2 | D.C. Motor and Pinion | 1 | VDL1/2F
3 | Rubber Sleeve 1.5mm | 2 | 28200 | CROYLEK LTD
4 | Solder | As | 25901 | TO BE SUPPLIED BY
Reqd | SUBCONTRACTOR

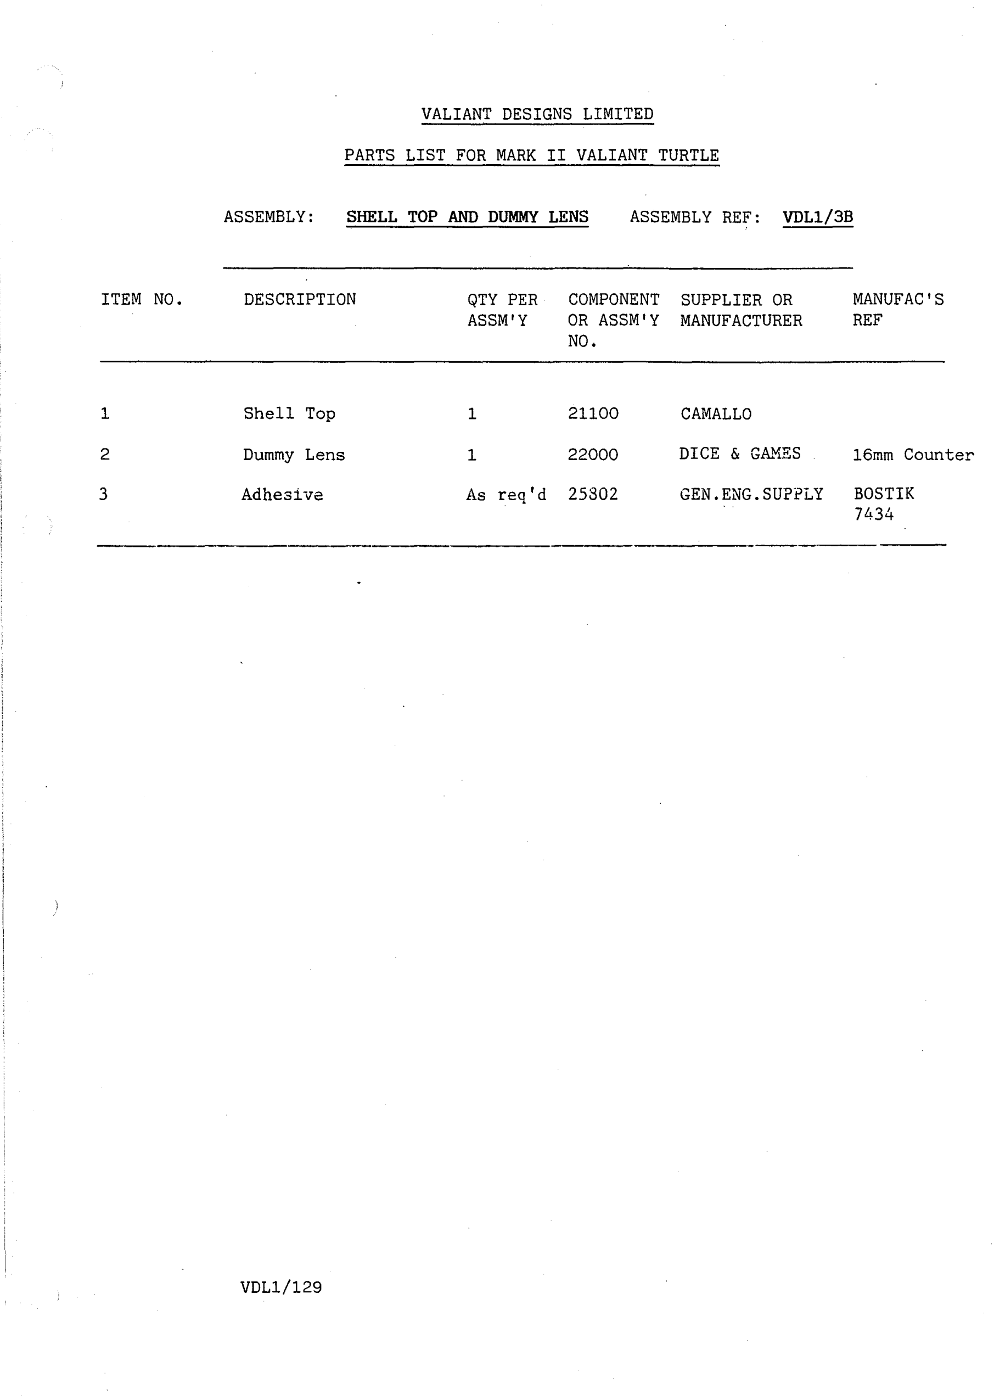
[picture p45: page 13]

ITEM NO.

1

2

3

VALIANT DESIGNS LIMITED

PARTS LIST FOR MARK II VALIANT TURTLE

ASSEMBLY: | SHELL TOP AND DUMMY LENS | ASSEMBLY REF: VDL1/3B
DESCRIPTION | QTY PER | COMPONENT SUPPLIER OR | MANUFAC'S REF

Shell Top

Dummy Lens

Adhesive

VDLl/129

ASSM'Y | OR ASSM'Y MANUFACTURER NO.
1 | 21100
1 | 22000

As req'd 25302

CAMALLO

DICE & GAJ.~ES | 16mm Counter
GEN.ENG.SUPPLY | BOSTIK
7434

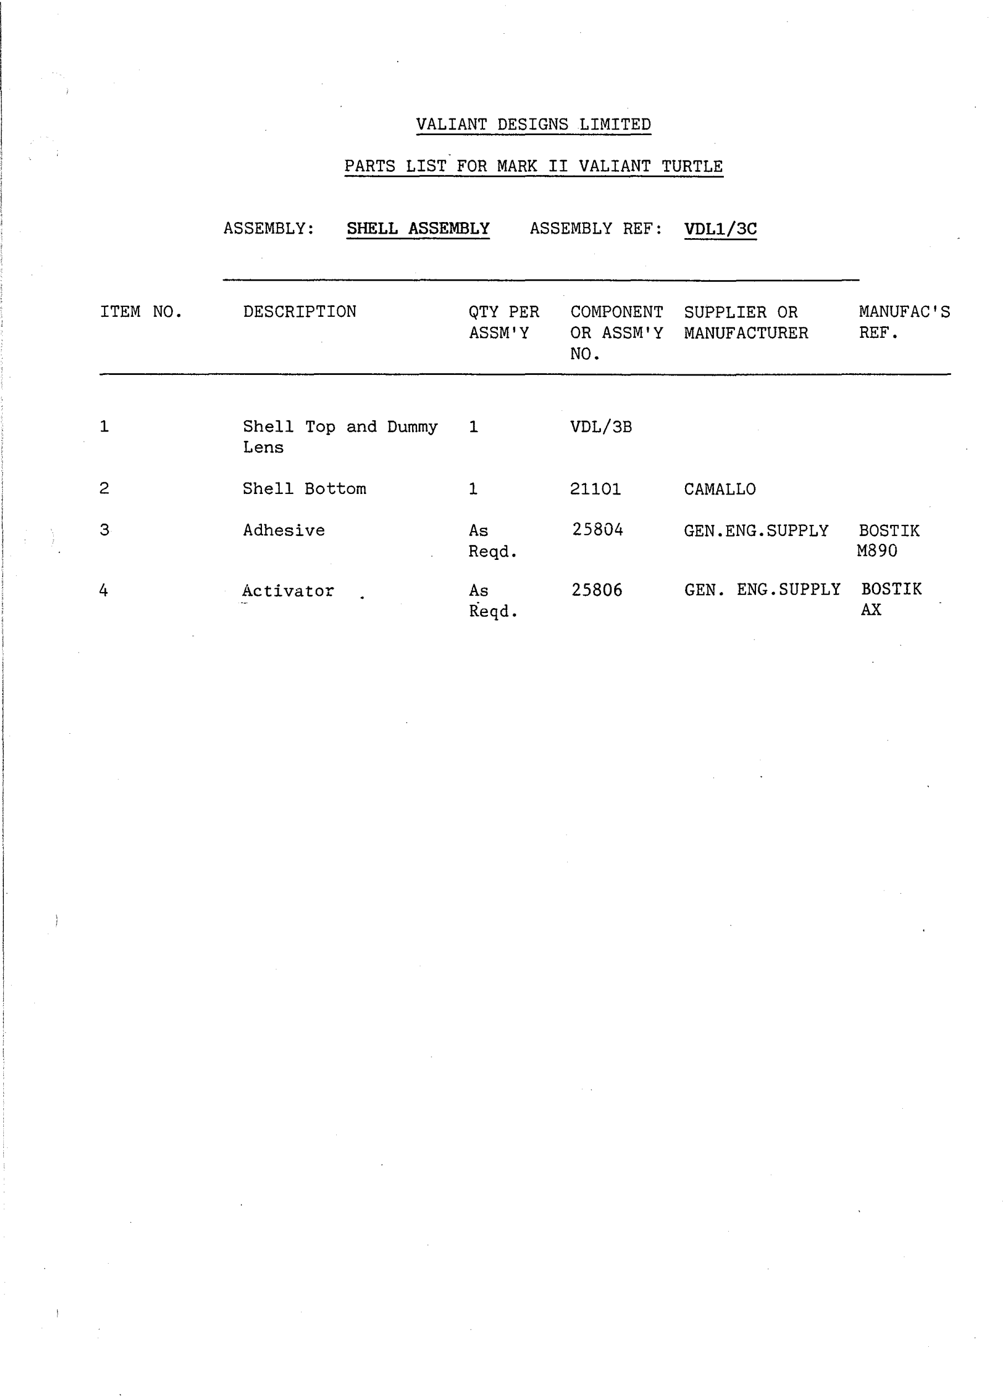
[picture p46: page 14]

ITEM NO.

1

2

3

4

VALIANT DESIGNS LIMITED

PARTS LIST FOR MARK II VALIANT TURTLE

ASSEMBLY: | SHELL ASSEMBLY | ASSEMBLY REF: VDL1/3C

DESCRIPTION

Shell Top and Dummy
Lens

Shell Bottom

Adhesive

Activator

QTY PER | COMPONENT SUPPLIER OR
ASSM'Y | OR ASSM'Y MANUFACTURER
NO.
1 | VD1/3B
1 | 21101 | CAMALLO
As | 25804 | GEN.ENG.SUPPLY
Reqd.
As | 25806 | GEN. ENG.SUPPLY
Reqd.

MANUFAC'S
REF.

BOSTIK
M890
BOSTIK
AX

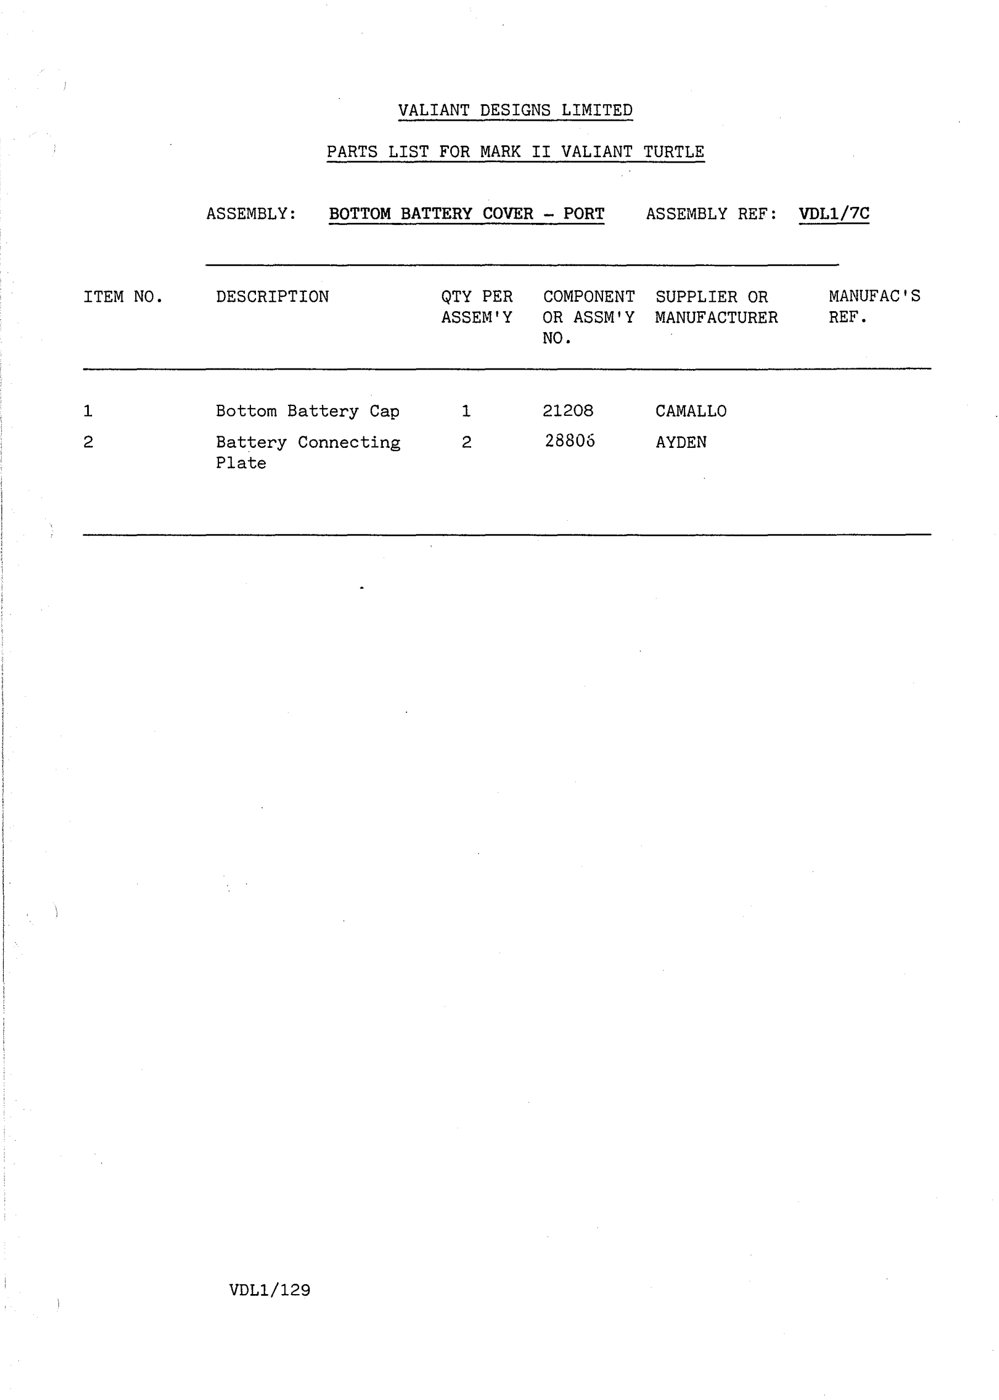
[picture p47: page 15]

ITEM NO.

1
2

VALIANT DESIGNS LIMITED

PARTS LIST FOR MARK II VALIANT TURTLE

ASSEMBLY: | BOTTOM BATTERY COVER - PORT | ASSEMBLY REF: VDL1/7C

DESCRIPTION

Bottom Battery Cap
Battery Connecting
Plate

VDLl/129

QTY PER | COMPONENT SUPPLIER OR
ASSEM'Y | OR ASSM'Y MANUFACTURER
| NO.

1
2

21208
28806

CAMALLO
AYDEN

MANUFAC'S
REF.

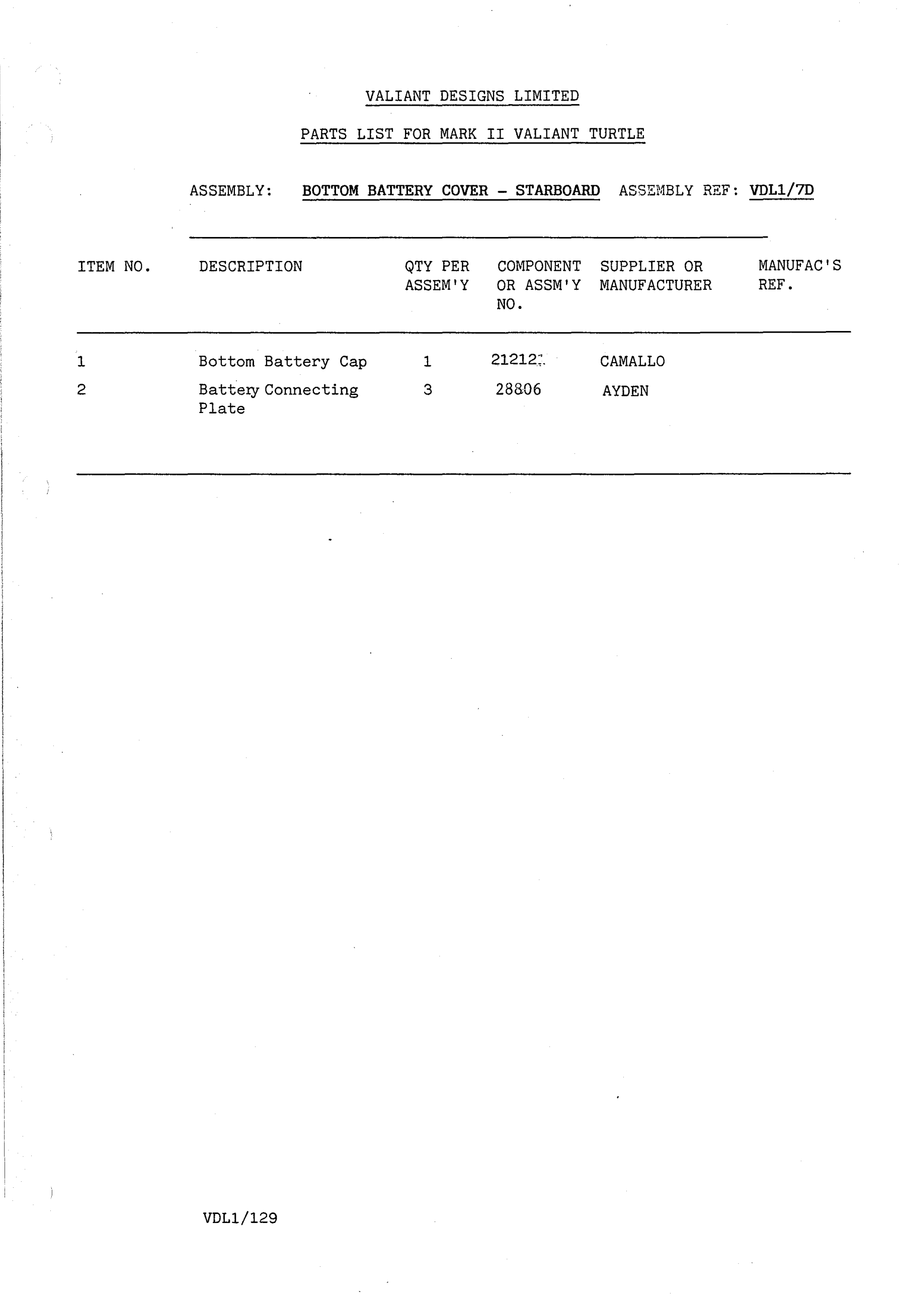
[picture p48: page 16]

VALIANT DESIGNS LIMITED

PARTS LIST FOR MARK II VALIANT TURTLE

ASSEMBLY: | BOTTOM BATTERY COVER - STARBOARD ASSEMBLY REF: VDL1/7D
ITEM NO. | DESCRIPTION | QTY PER | COMPONENT SUPPLIER OR | MANUFAC'S
ASSEM'Y | OR ASSM'Y MANUFACTURER | REF.
NO.
1 | Bottom Battery Cap | 1 | 21212;. | CAMALLO
2 | Batte:ty Connecting | 3 | 28806 | AYDEN
Plate

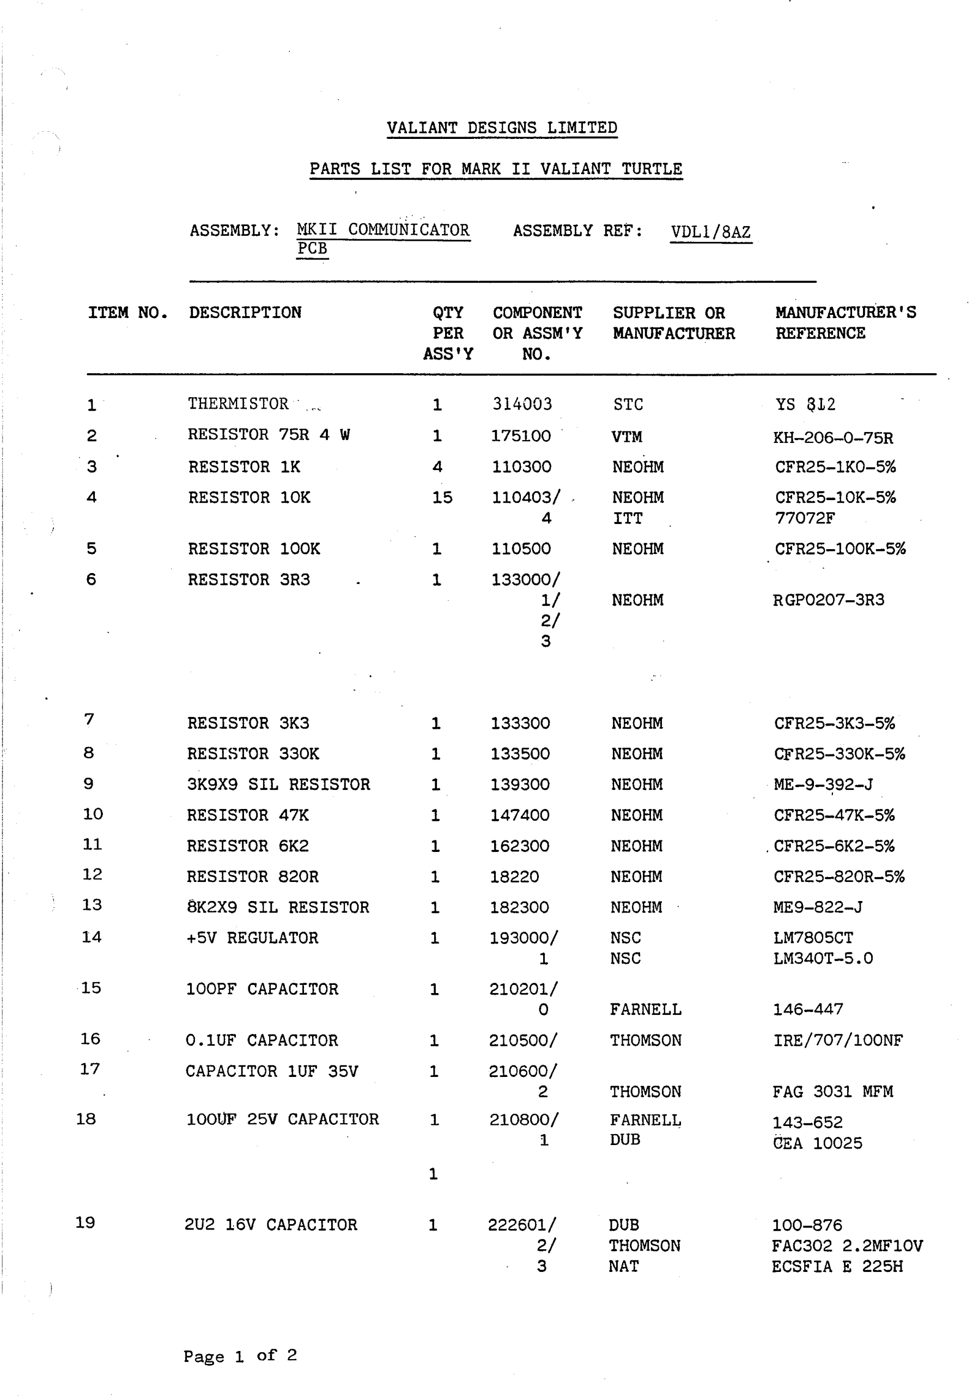
[picture p49: page 17]

ITEM NO.

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
VALIANT DESIGNS LIMITED

PARTS LIST FOR MARK II VALIANT TURTLE

·: ,•
ASSEMBLY: MKII COMMUNICATOR PCB
DESCRIPTION | QTY PER ASS'Y
THERMISTOR··"' | 1
RESISTOR 75R 4 W | 1
RESISTOR lK | 4
RESISTOR lOK | 15
RESISTOR lOOK | 1
RESISTOR 3R3 | 1
RESISTOR 3K3 | 1
RESISTOR 330K | 1
3K9X9 SIL RESISTOR | 1
RESISTOR 47K | 1
RESISTOR 6K2 | 1
RESISTOR 820R | 1
8K2X9 SIL RESISTOR | 1
+5V REGULATOR | 1
lOOPF CAPACITOR | 1
O.lUF CAPACITOR | 1
CAPACITOR lUF 35V | 1
lOOUF' 25V CAPACITOR | 1
| 1
202 16V CAPACITOR | 1
ASSEMBLY REF: | VDL1/8AZ
COMPONENT | SUPPLIER OR
OR ASSM'Y | MANUFACTURER
NO.
314003 | STC
175100 . | VTM
110300 | NEOHM
110403/ | NEOHM
4 | ITT
110500 | NEOHM
133000/
1/ NEOHM
2/
3
133300 | NEOHM
133500 | NEOHM
139300 | NEOHM
147400 | NEOHM
162300 | NEOHM
18220 | NEOHM
182300 | NEOHM
193000/ | NSC
1 | NSC
210201/
0 | FARNELL
210500/ | THOMSON
210600/
2 | THOMSON
210800/ | FARNELL
1 | DUB
222601/ | DUB
2/ | THOMSON
3 | NAT

MANUFACTURER'S
REFERENCE

YS 612
KH-206-0-75R
CFR25-1K0-5%
CFR25-10K-5%
77072F
CFR25-100K-5%

R GP0207-3R3

CFR25-3K3-5%
CFR25-330K-5%
ME-9-392-J
CFR25-47K-5%
.CFR25-6K2-5%
CFR25-820R-5%
ME9-822-J
LM7805CT
LM340T-5.0

146-447
IRE/707/lOONF

FAG 3031 MFM
143-652
CEA 10025

100-876
FAC302 2.2MF10V
ECSFIA E 225H

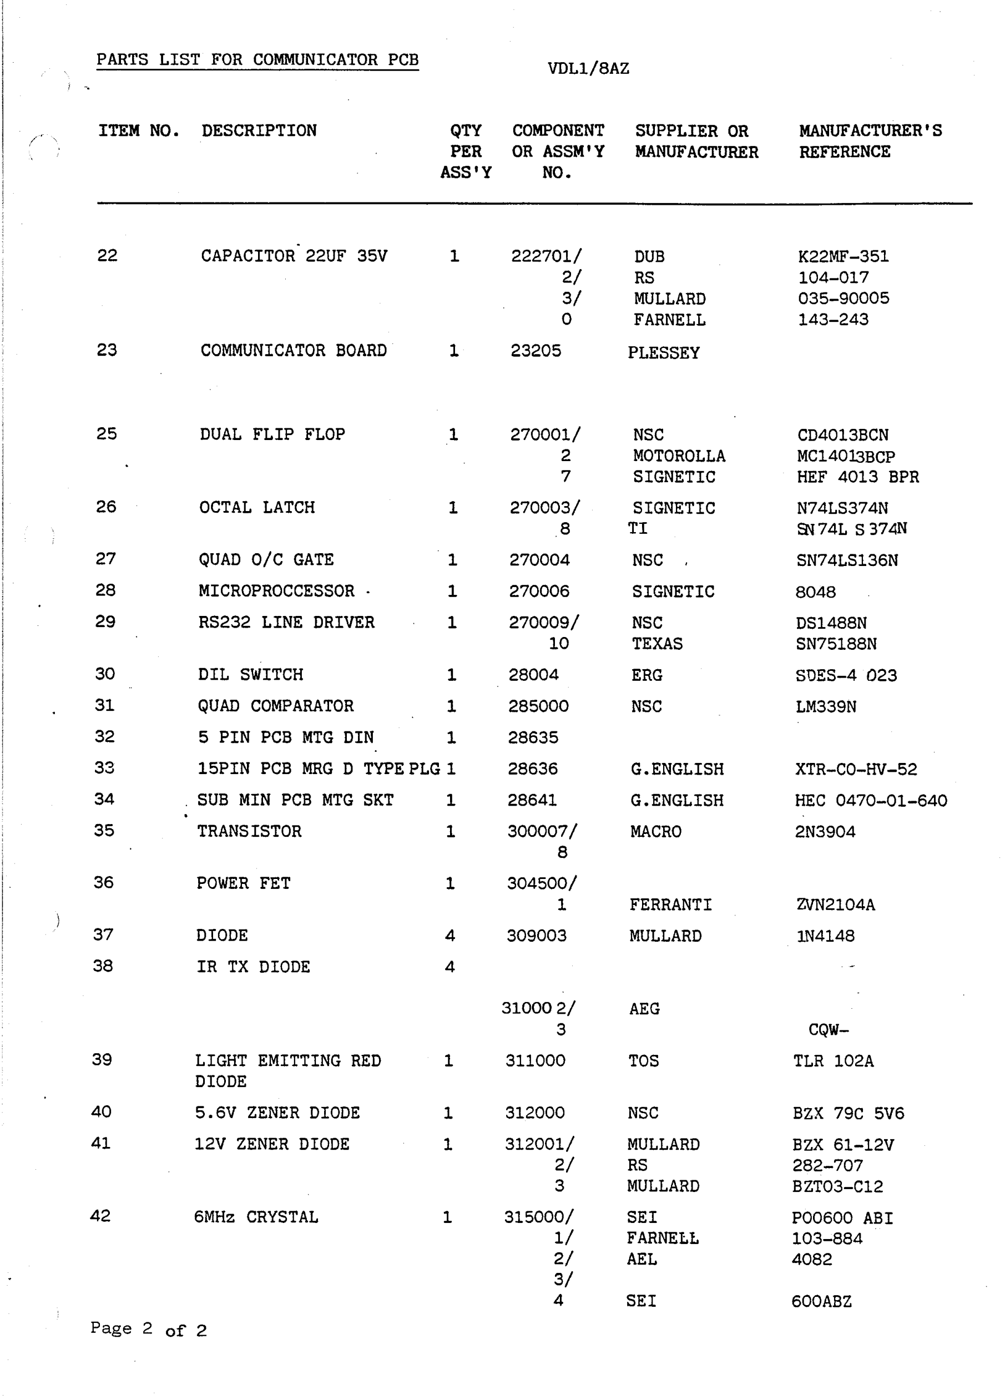
[picture p50: page 18]

/ '

PARTS LIST FOR COMMUNICATOR PCB

ITEM NO. DESCRIPTION

22 | CAPACITOR 22UF 35V
23 | COMMUNICATOR BOARD
25 | DUAL FLIP FLOP
26 | OCTAL LATCH
27 | QUAD 0/C GATE

### 28 MICROPROCCESSOR 29 RS232 LINE DRIVER

30 | OIL SWITCH
31 | QUAD COMPARATOR
32 | 5 PIN PCB MTG DIN

VDL1/8AZ

QTY | COMPONENT | SUPPLIER OR
PER | OR ASSM'Y | MANUFACTURER
ASS'Y | NO.
1 | 222701/ | DUB
| 2/ | RS
| 3/ | MULLARD
| 0 | FARNELL
1 | 23205 | PLESSEY
| | 1 | 270001/ | NSC
| | | 2 | MOTOROLLA
| | | 7 | SIGNETIC
| | 1 | 270003/ | SIGNETIC
| | | 8 | TI
| | 1 | 270004 | NSC
| | 1 | 270006 | SIGNETIC
| | 1 | 270009/ | NSC
| | | 10 | TEXAS
| | 1 | 28004 | ERG
| | 1 | 285000 | NSC
| | 1 | 28635
33 | 15PIN PCB MRG D TYPE PLG 1 | 28636 | G.ENGLISH
34 | . SUB MIN PCB MTG SKT | 1 | 28641 | G.ENGLISH
35 | TRANSISTOR | 1 | 300007/ | MACRO
| | | 8
36 | POWER FET | 1 | 304500/
| | | 1 | FERRANTI
37 | DIODE | 4 | 309003 | MULLARD
38 | IR TX DIODE | 4
| | | 31000 2/ | AEG
| | | 3
39 | LIGHT EMITTING RED | 1 | 311000 | TOS
| DIODE
40 | 5.6V ZENER DIODE | 1 | 312000 | NSC
41 | 12V ZENER DIODE | 1 | 312001/ | MULLARD
| | | 2/ | RS
| | | 3 | MULLARD
42 | 6MHz CRYSTAL | 1 | 315000/ | SEI
| | | 1/ | FARNELL
| | | 2/ | AEL
| | | 3/
| | | 4 | SEI

MANUFACTURER'S
REFERENCE

K22MF-351
104-017
035-90005
143-243

CD4013BCN
MC14013BCP
HEF 4013 BPR
N74LS374N
SN74L S 374N
SN74LS136N
8048
DS1488N
SN75188N
SDES-4 023
LM339N

XTR-CO-HV-52
HEC 0470-01-640
2N3904

ZVN2104A
1N4148

CQW-
TLR 102A

BZX 79C 5V6
BZX 61-12V
282-707
BZT03-Cl2
P00600 ABI
103-884
4082

600ABZ

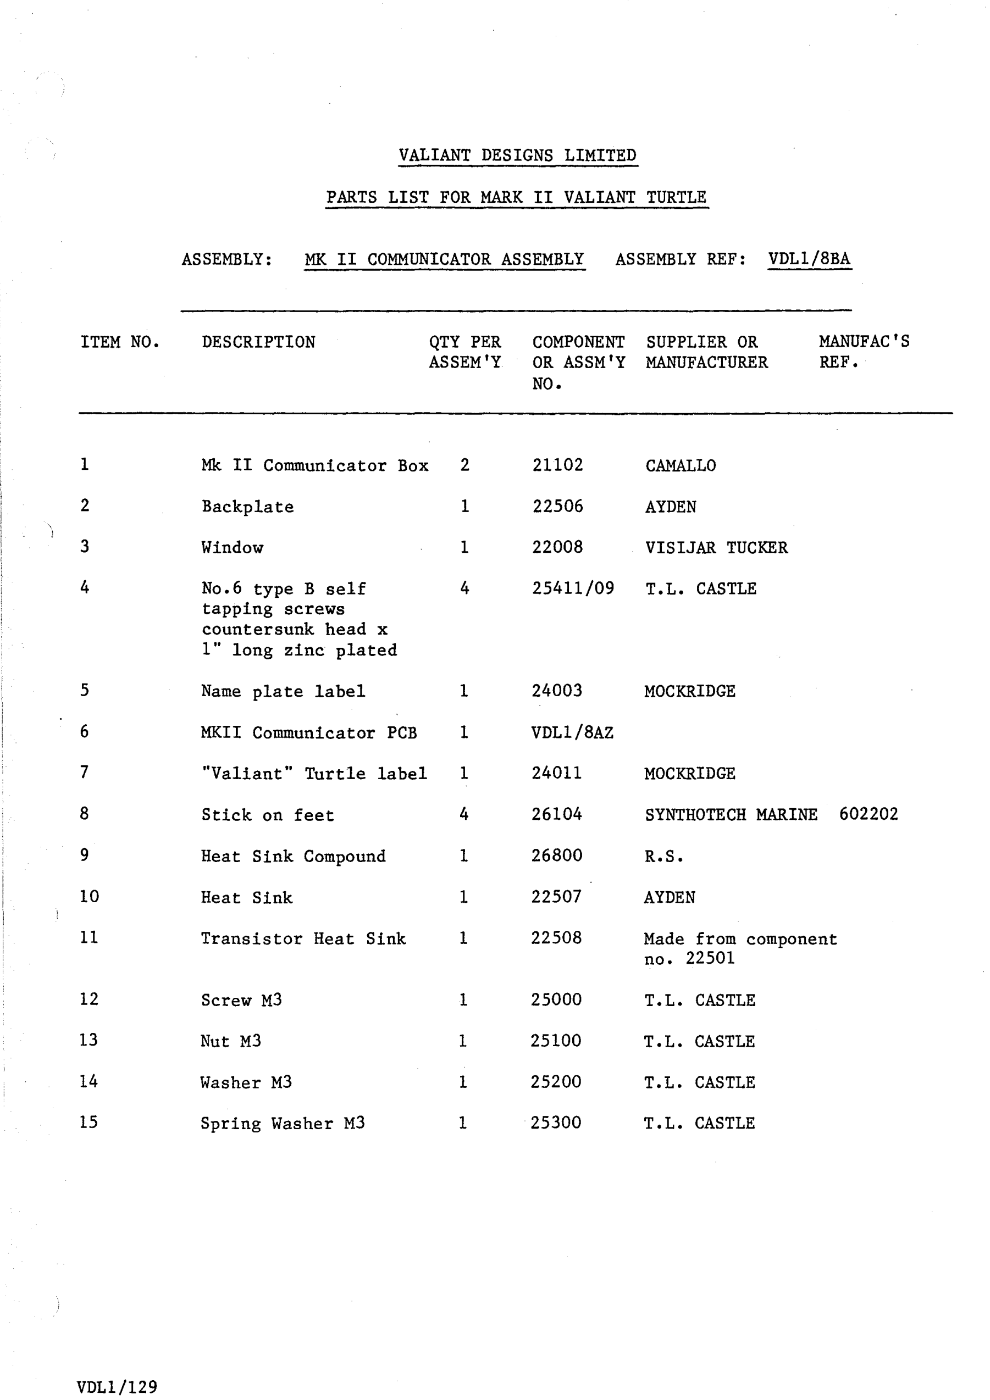
[picture p51: page 19]

ITEM NO.

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
VALIANT DESIGNS LIMITED

PARTS LIST FOR MARK II VALIANT TURTLE

ASSEMBLY: | MK II COMMUNICATOR ASSEMBLY | ASSEMBLY REF: VDL1/8BA

DESCRIPTION

Mk II Communicator Box

Backplate

Window

No.6 type B self
tapping screws
countersunk head x
1" long zinc plated

Name plate label

MKII Communicator PCB

"Valiant" Turtle label

Stick on feet

Heat Sink Compound

Heat Sink

Transistor Heat Sink

Screw M3

Nut M3

Washer M3

Spring Washer M3

QTY PER | COMPONENT SUPPLIER OR
ASSEM'Y | OR ASSM'Y MANUFACTURER
| NO.
2 | 21102 | CAMALLO
1 | 22506 | AYDEN
1 | 22008 | VISIJAR TUCKER
4 | 25411/09 | T.L. CASTLE
1 | 24003 | MOCKRIDGE
1 | VDL1/8AZ
1 | 24011 | MOCKRIDGE
4 | 26104 | SYNTHOTECH MARINE
1 | 26800 | R.S.
1 | 22507 | AYDEN

MANUFAC'S
REF.

602202

1 | 22508 | Made from component no. 22501
1 | 25000 | T.L. CASTLE
1 | 25100 | T.L. CASTLE
1 | 25200 | T.L. CASTLE
1 | 25300 | T.L. CASTLE

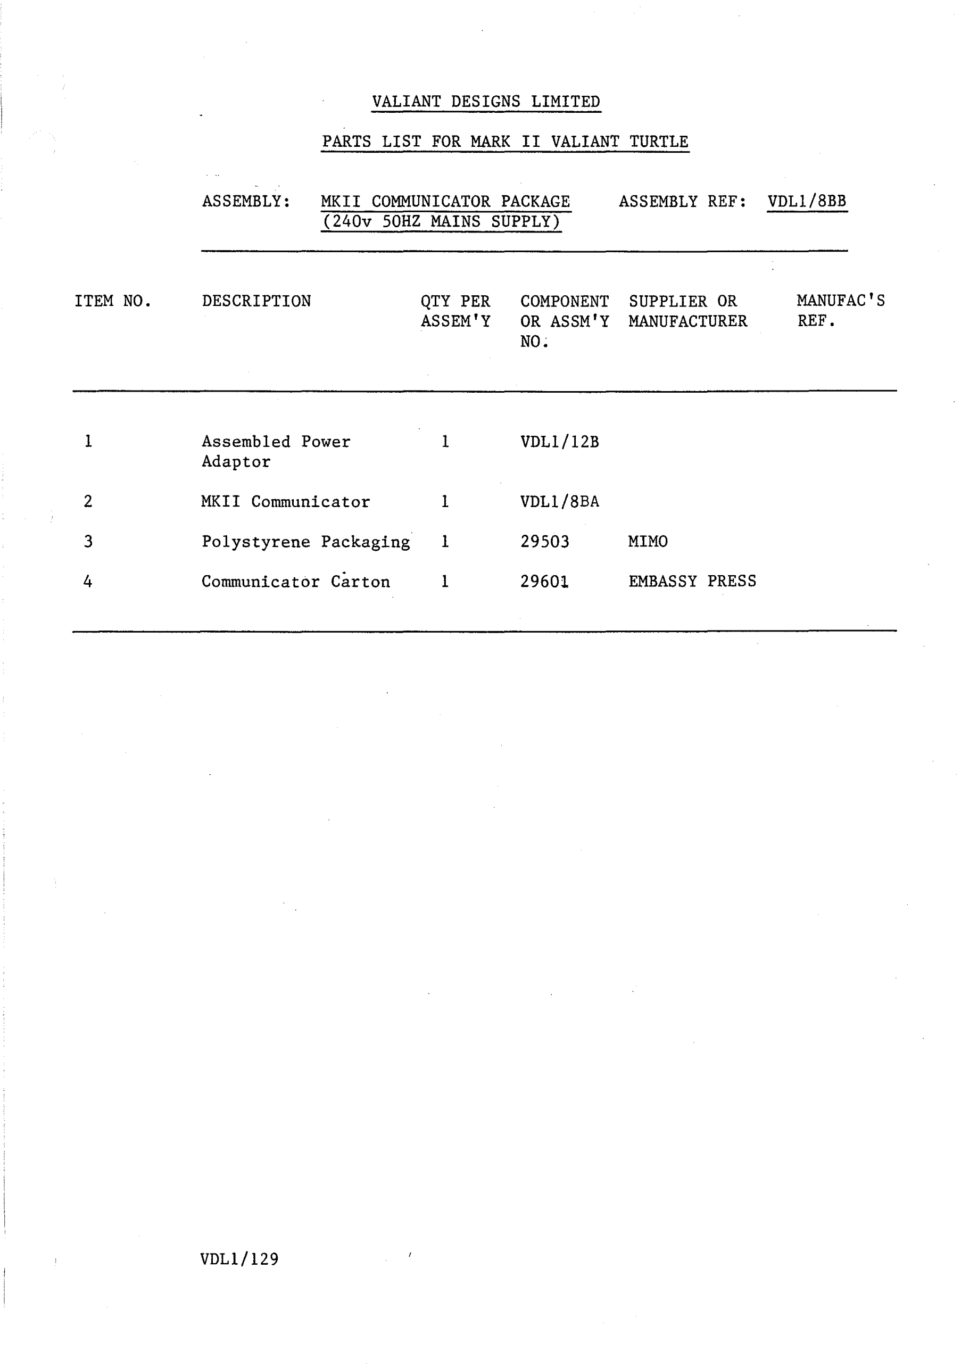
[picture p52: page 20]

ITEM NO.

1

2

3

4

VALIANT DESIGNS LIMITED

PARTS LIST FOR MARK II VALIANT TURTLE

ASSEMBLY: MKII COMMUNICATOR PACKAGE (240v SOHZ MAINS SUPPLY)

ASSEMBLY REF: VDL1/8BB

DESCRIPTION

Assembled Power
Adaptor

MKII Communicator

Polystyrene Packaging

Communicator Carton

QTY PER | COMPONENT SUPPLIER OR
ASSEM'Y | OR ASSM'Y MANUFACTURER
| NO~
1 | VDL1/12B
1 | VDL1/8BA
1 | 29503 | MIMO
1 | 29601 | EMBASSY PRESS

MANUFAC'S
REF.

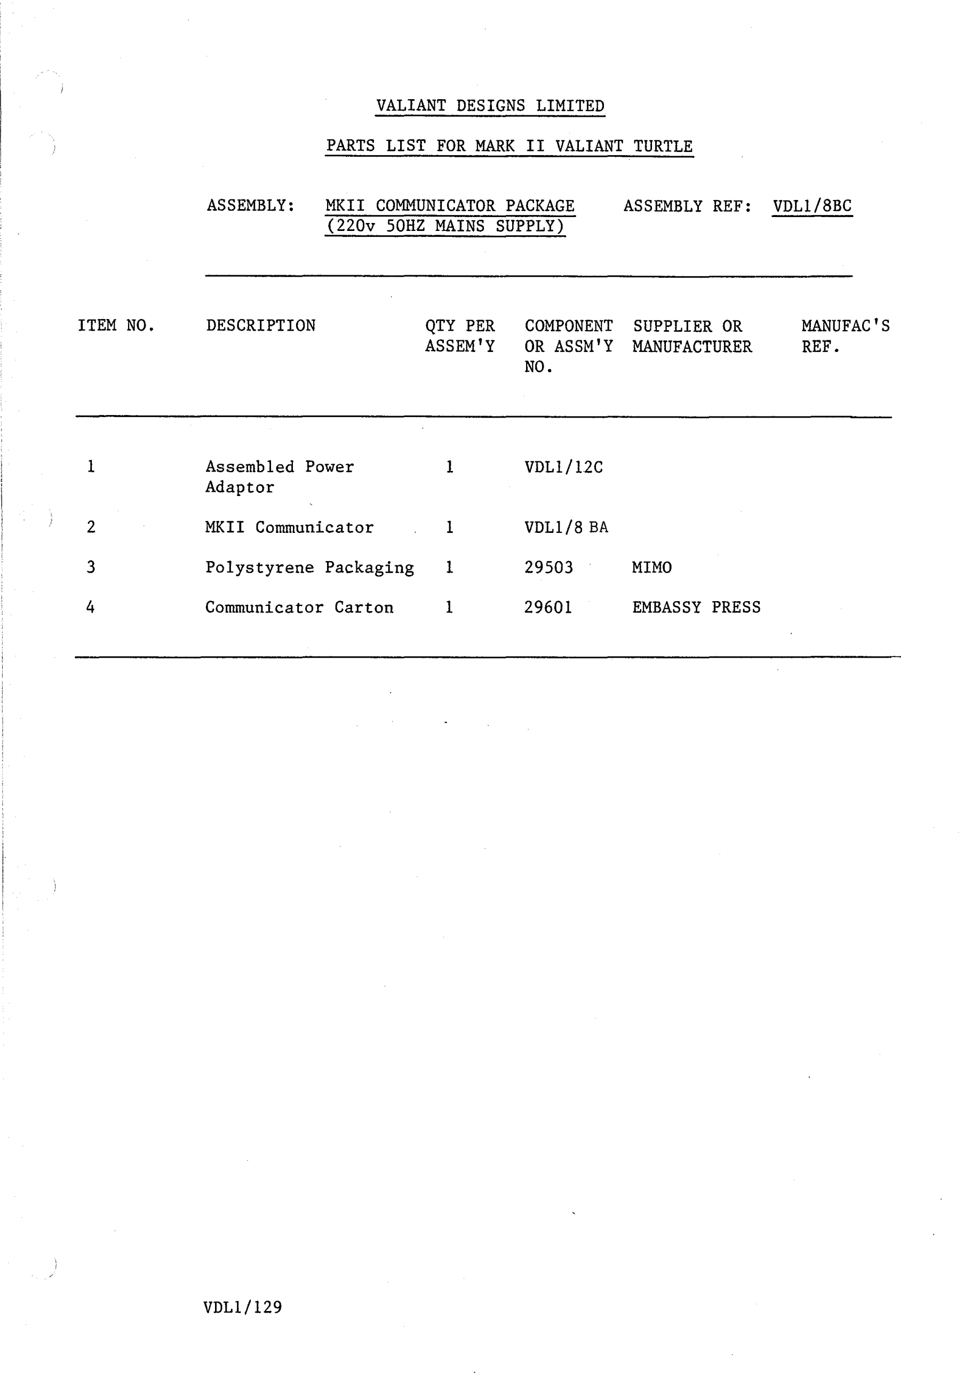
[picture p53: page 21]

ITEM NO.

1

2

3

4

VALIANT DESIGNS LIMITED

PARTS LIST FOR MARK II VALIANT TURTLE

ASSEMBLY: MKII COMMUNICATOR PACKAGE (220v SOHZ MAINS SUPPLY) ASSEMBLY REF: VDL1/8BC

DESCRIPTION

Assembled Power
Adaptor

MKII Communicator

QTY PER | COMPONENT SUPPLIER OR
ASSEM'Y | OR ASSM'Y MANUFACTURER
| NO.
1 | VDL1/12C

1

Polystyrene Packaging | 1
Communicator Carton | 1

VDLl/8 BA

29503

29601

MIMO

EMBASSY PRESS

MANUFAC'S
REF.

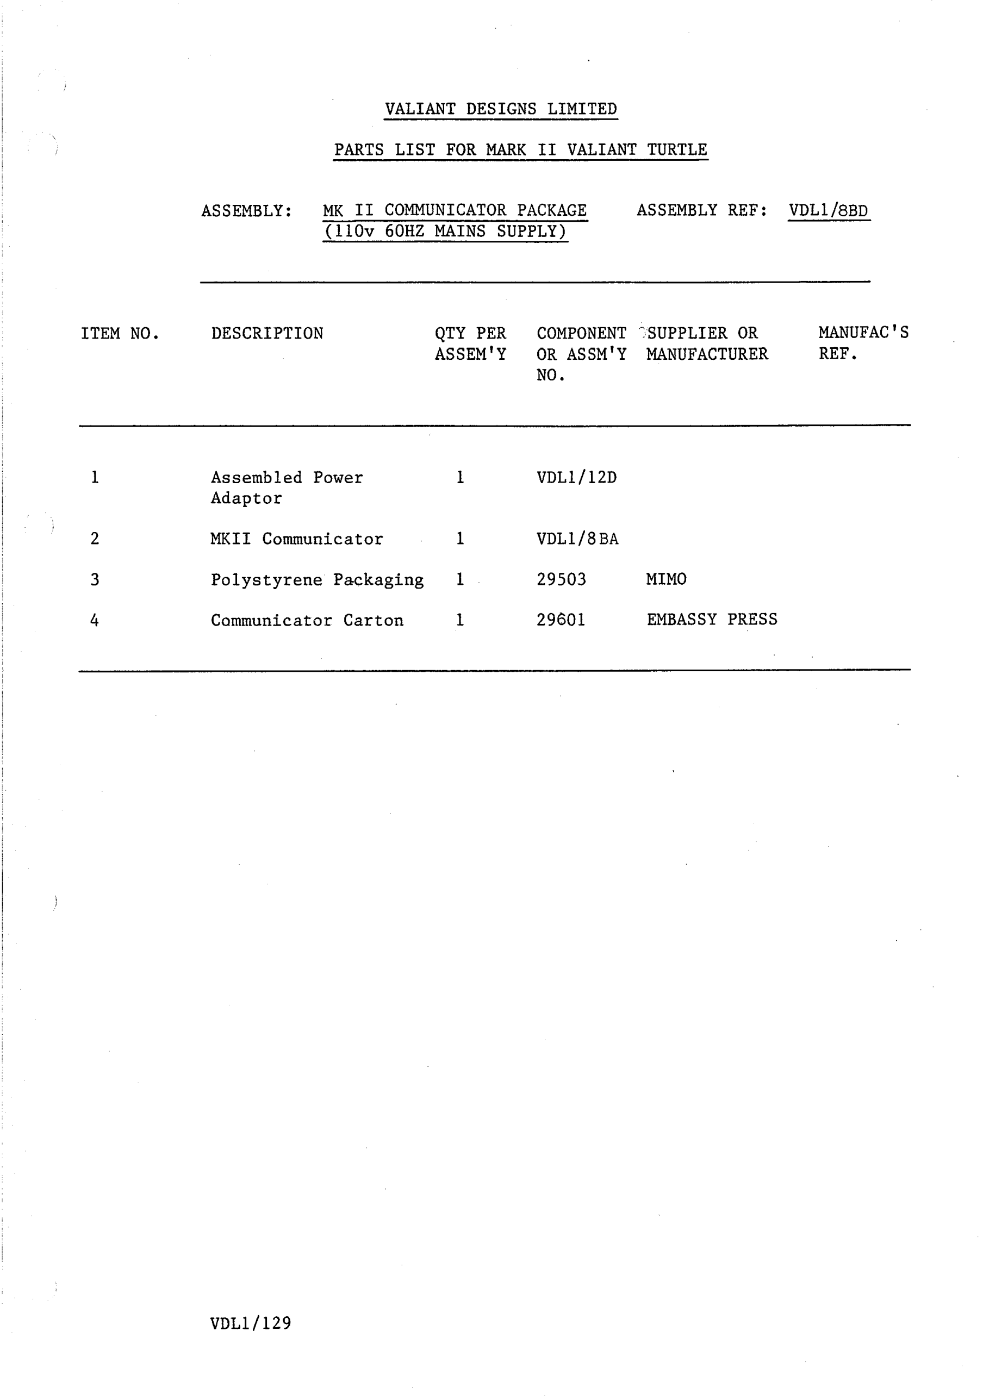
[picture p54: page 22]

ITEM NO.

1

2

3

4

VALIANT DESIGNS LIMITED

PARTS LIST FOR MARK II VALIANT TURTLE

ASSEMBLY: MK II COMMUNICATOR PACKAGE (110v 60HZ MAINS SUPPLY)

ASSEMBLY REF: VDL1/8BD

DESCRIPTION

Assembled Power
Adaptor

MKII Communicator

QTY PER | COMPONENT -,SUPPLIER OR
ASSEM'Y | OR ASSM'Y MANUFACTURER NO.
1 | VDL1/12D

1
Polystyrene Packaging | 1
Communicator Carton | 1

VDL1/8BA

29503

29601

MIMO

EMBASSY PRESS

MANUFAC'S
REF.

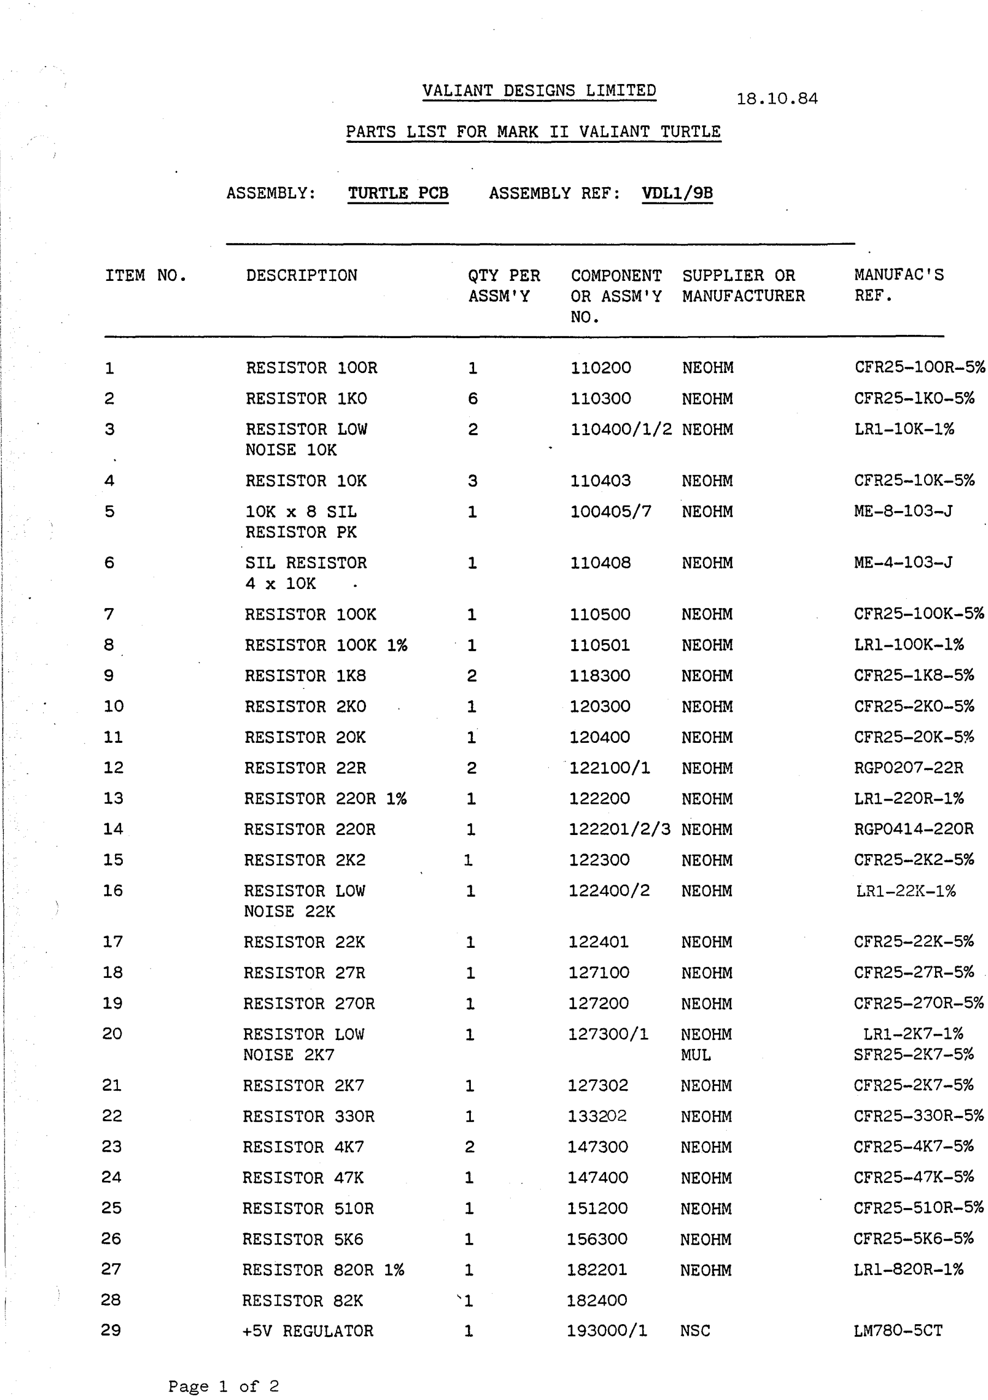
[picture p55: page 23]

VALIANT DESIGNS LIMITED | 18.10.84

PARTS LIST FOR MARK II VALIANT TURTLE

ASSEMBLY: | TURTLE PCB | ASSEMBLY REF: VDL1/9B
ITEM NO. | DESCRIPTION | QTY PER | COMPONENT SUPPLIER OR | MANUFAC'S
ASSM'Y | OR ASSM'Y MANUFACTURER | REF.
NO.
1 | RESISTOR lOOR | 1 | 110200 | NEOHM | CFR25-100R-5%
2 | RESISTOR lKO | 6 | 110300 | NEOHM | CFR25-1K0-5%
3 | RESISTOR LOW | 2 | 110400/1/2 NEOHM | LRl-lOK-1%
| NOISE lOK
4 | RESISTOR lOK | 3 | 110403 | NEOHM | CFR25-10K-5%
5 | lOK x 8 SIL | 1 | 100405/7 | NEOHM | ME-8-103-J
| RESISTOR PK
6 | SIL RESISTOR | 1 | 110408 | NEOHM | ME-4-103-J
| 4 x lOK
7 | RESISTOR 100K | 1 | 110500 | NEOHM | CFR25-100K-5%
8 | RESISTOR 100K 1% | 1 | 110501 | NEOHM | LRl-lOOK-1%
9 | RESISTOR 1K8 | 2 | 118300 | NEOHM | CFR25-1K8-5%
10 | RESISTOR 2KO | 1 | 120300 | NEOHM | CFR25-2K0-5%
11 | RESISTOR 20K | 1 | 120400 | NEOHM | CFR25-20K-5%
12 | RESISTOR 22R | 2 | 122100/1 | NEOHM | RGP0207-22R
13 | RESISTOR 220R 1% | 1 | 122200 | NEOHM | LR1-220R-1%
14 | RESISTOR 220R | 1 | 122201/2/3 NEOHM | RGP0414-220R
15 | RESISTOR 2K2 | 1 | 122300 | NEOHM | CFR25-2K2-5%
16 | RESISTOR LOW | 1 | 122400/2 | NEOHM | LR1-22K-1%
| NOISE 22K
17 | RESISTOR 22K | 1 | 122401 | NEOHM | CFR25-22K-5%
18 | RESISTOR 27R | 1 | 127100 | NEOHM | CFR25-27R-5%
19 | RESISTOR 270R | 1 | 127200 | NEOHM | CFR25-270R-5%
20 | RESISTOR LOW | 1 | 127300/1 | NEOHM | LR1-2K7-1%
| NOISE 2K7 | | | MUL | SFR25-2K7-5%
21 | RESISTOR 2K7 | 1 | 127302 | NEOHM | CFR25-2K7-5%
22 | RESISTOR 330R | 1 | 133202 | NEOHM | CFR25-330R-5%
23 | RESISTOR 4K7 | 2 | 147300 | NEOHM | CFR25-4K7-5%
24 | RESISTOR 47K | 1 | 147400 | NEOHM | CFR25-47K-5%
25 | RESISTOR 510R | 1 | 151200 | NEOHM | CFR25-510R-5%
26 | RESISTOR 5K6 | 1 | 156300 | NEOHM | CFR25-5K6-5%
27 | RESISTOR 820R 1% | 1 | 182201 | NEOHM | LR1-820R-1%
28 | RESISTOR 82K | '1 | 182400
29 | +5V REGULATOR | 1 | 193000/1 | NSC | LM780-5CT

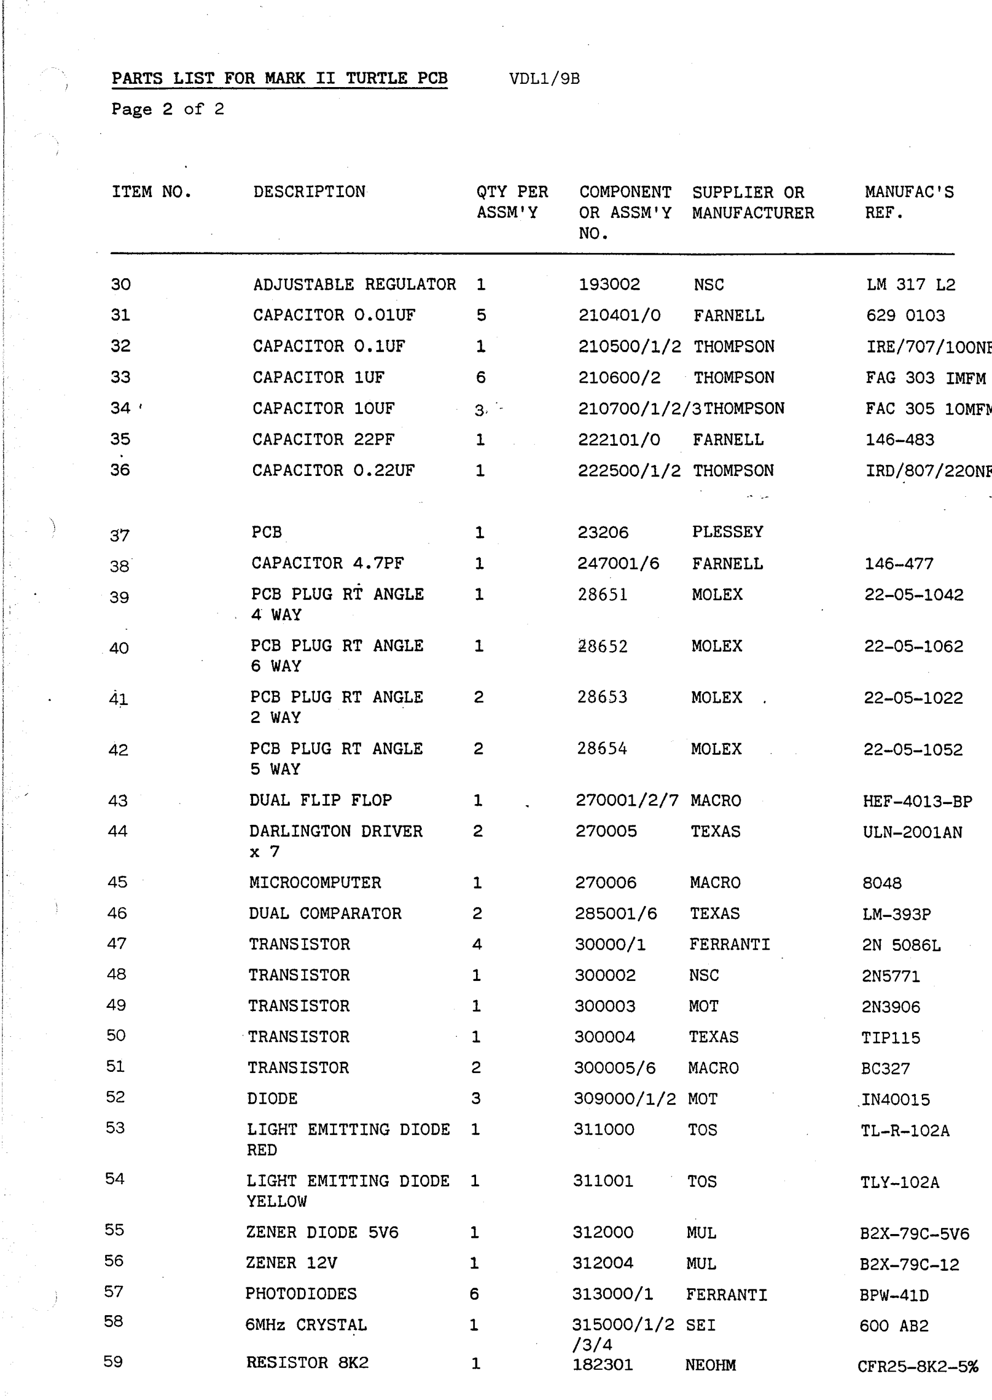
[picture p56: page 24]

PARTS LIST FOR MARK II TURTLE PCB

ITEM NO. | DESCRIPTION
30 | ADJUSTABLE REGULATOR
31 | CAPACITOR O.OlUF
32 | CAPACITOR O.lUF
33 | CAPACITOR lUF
34 I | CAPACITOR lOUF
35 | CAPACITOR 22PF
36 | CAPACITOR 0.22UF
37 | PCB
38 | CAPACITOR 4.7PF
39 | PCB PLUG RT ANGLE 4 WAY
40 | PCB PLUG RT ANGLE 6 WAY
4;i. | PCB PLUG RT ANGLE 2 WAY
42 | PCB PLUG RT ANGLE 5 WAY
43 | DUAL FLIP FLOP
44 | DARLINGTON DRIVER X 7
45 | MICROCOMPUTER
46 | DUAL COMPARATOR
47 | TRANSISTOR
48 | TRANSISTOR
49 | TRANSISTOR
50 | TRANSISTOR
51 | TRANSISTOR
52 | DIODE
53 | LIGHT EMITTING DIODE RED
54 | LIGHT EMITTING DIODE YELLOW
55 | ZENER DIODE 5V6
56 | ZENER 12V
57 | PHOTODIODES
58 | 6MHz CRYSTAL
59 | RESISTOR 8K2

VDL1/9B

QTY PER | COMPONENT SUPPLIER OR | MANUFAC'S
ASSM'Y | OR ASSM'Y MANUFACTURER | REF.
NO.
1 | 193002 | NSC | LM 317 L2
5 | 210401/0 | FARNELL | 629 0103
1 | 210500/1/2 THOMPSON | IRE/707 /lOONE
6 | 210600/2 | THOMPSON | FAG 303 IMFM
3, | 210700/l/2/3THOMPSON | F AC 305 lOMFfl
1 | 222101/0 | FARNELL | 146-483
1 | 222500/1/2 THOMPSON | IRD/807/220NF
1 | 23206 | PLESSEY
1 | 247001/6 | FARNELL | 146-477
1 | 28651 | MOLEX | 22-05-1042
1 | g8652 | MOLEX | 22-05-1062
2 | 28653 | MOLEX | 22-05-1022
2 | 28654 | MOLEX | 22-05-1052
1 | 270001/2/7 MACRO | HEF-4013-BP
2 | 270005 | TEXAS | ULN-2001AN
1 | 270006 | MACRO | 8048
2 | 285001/6 | TEXAS | LM-393P
4 | 30000/1 | FERRANTI | 2N 5086L
1 | 300002 | NSC | 2N5771
1 | 300003 | MOT | 2N3906
1 | 300004 | TEXAS | TIP115
2 | 300005/6 | MACRO | BC327
3 | 309000/1/2 MOT | .IN40015
1 | 311000 | TOS | TL-R-102A
1 | 311001 | TOS | TLY-102A
1 | 312000 | MUL | B2X-79C-5V6
1 | 312004 | MUL | B2X-79C-12
6 | 313000/1 | FERRANTI | BPW-41D
1 | 315000/1/2 SEI | 600 AB2
| /3/4
1 | 182301 | NEOHM | CFR25-8K2-5%

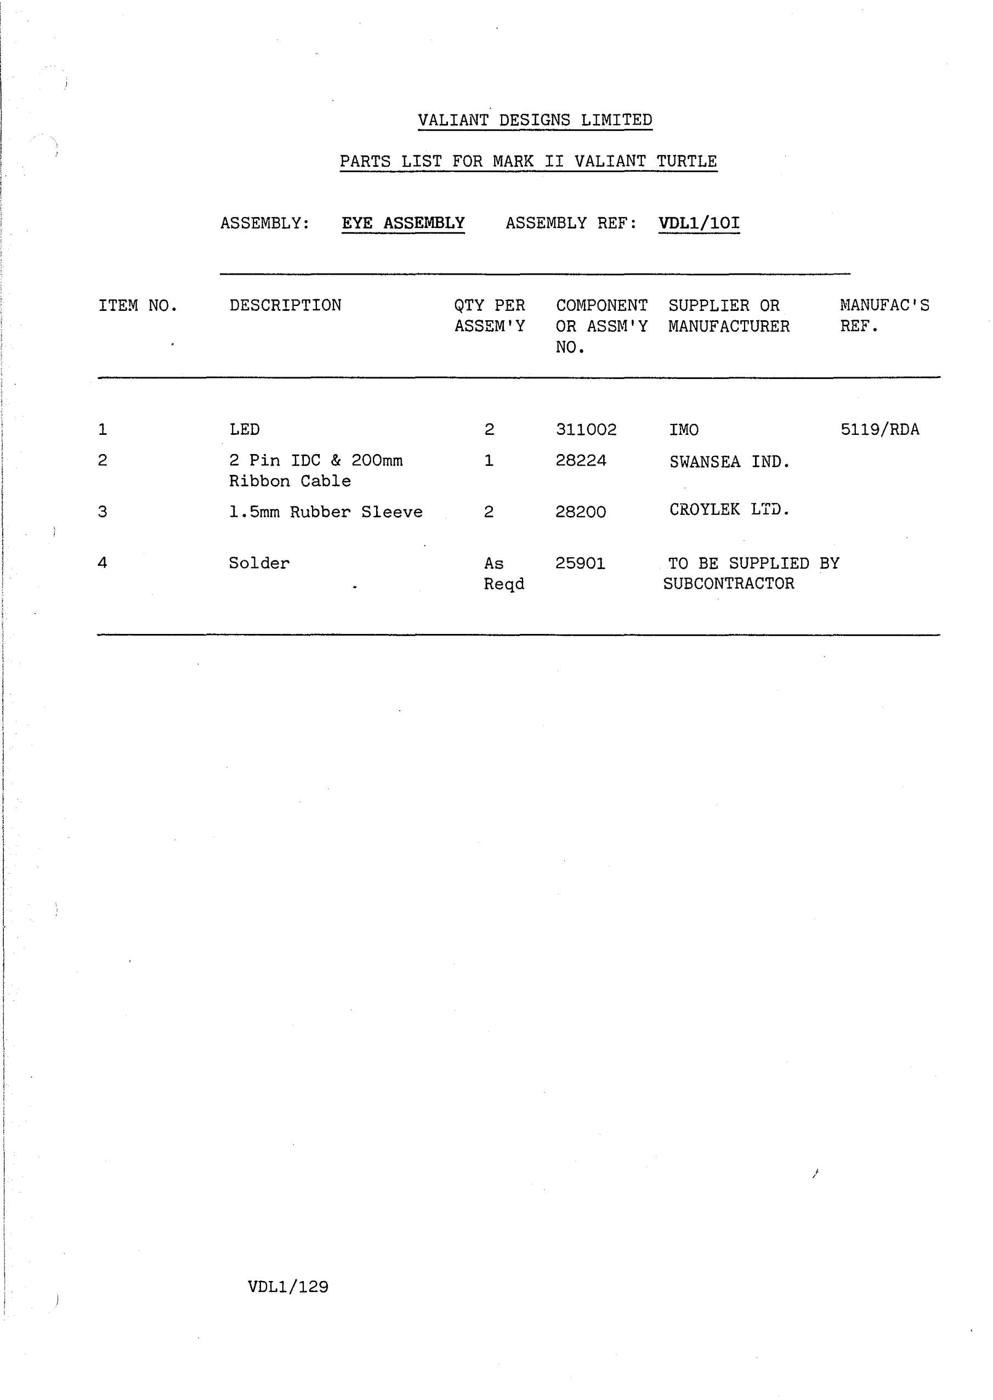
[picture p57: page 25]

ITEM NO.

1
2

3

4

VALIANT DESIGNS LIMITED

PARTS LIST FOR MARK II VALIANT TURTLE

ASSEMBLY: | EYE ASSEMBLY | ASSEMBLY REF: VDL1/10I

DESCRIPTION

LED
2 Pin IDC & 200mm
Ribbon Cable
1.5mm Rubber Sleeve

Solder

VDLl/129

QTY PER | COMPONENT SUPPLIER OR
ASSEM'Y | OR ASSM'Y MANUFACTURER
| NO.
2 | 311002 | IMO
1 | 28224 | SWANSEA IND.
2 | 28200 | CROYLEK LT:U.
As | 25901 | TO BE SUPPLIED
Reqd | | SUBCONTRACTOR

BY

/

MANUFAC'S
REF.

5119/RDA

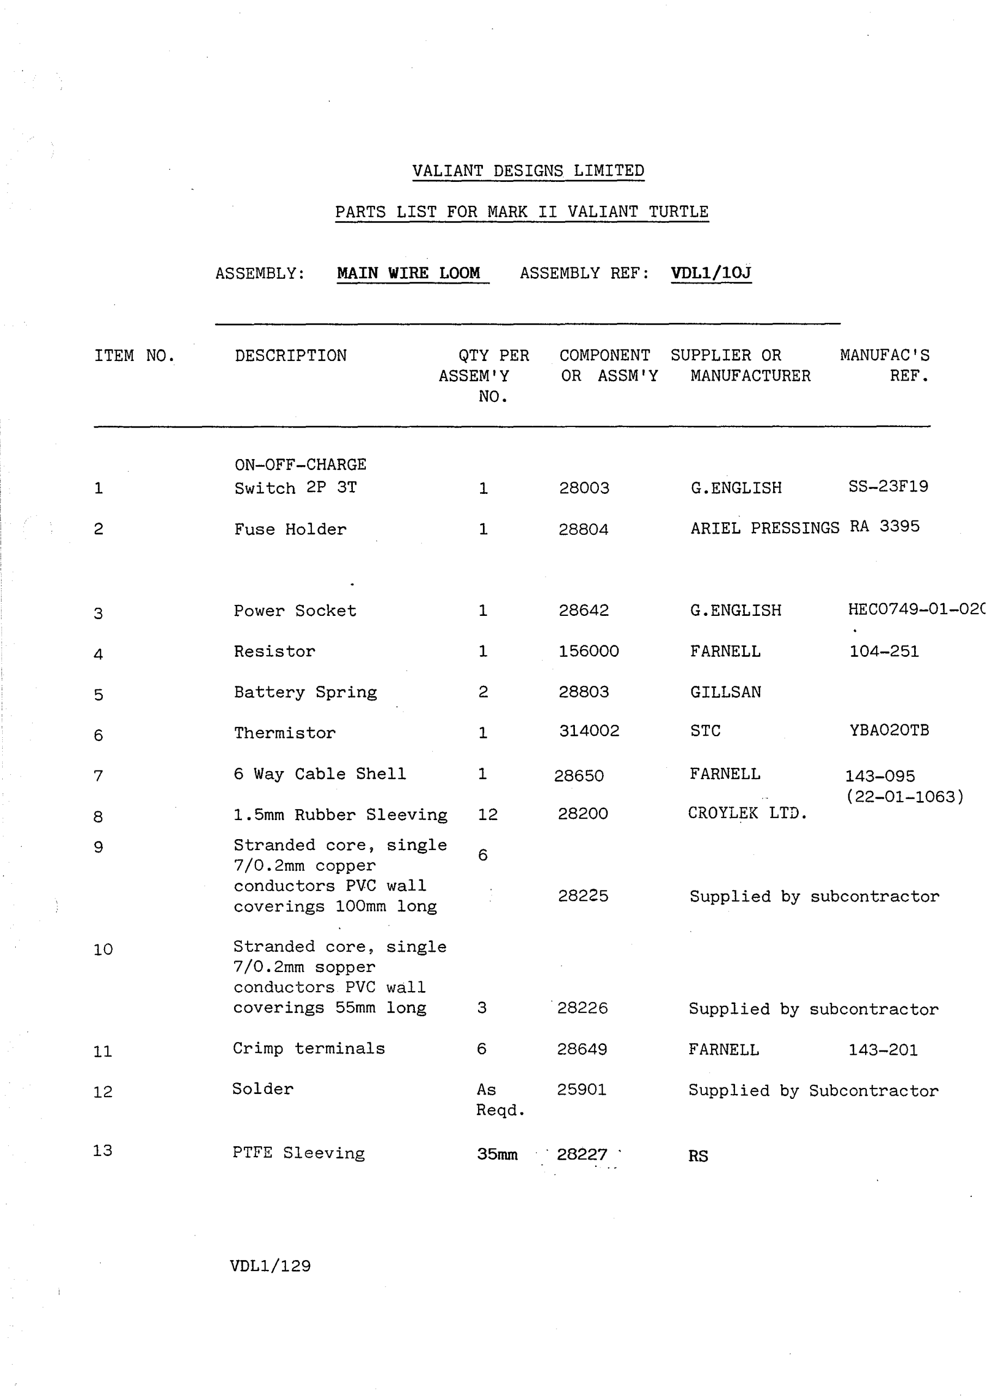
[picture p58: page 26]

ITEM NO.

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
VALIANT DESIGNS LIMITED

PARTS LIST FOR MARK II VALIANT TURTLE

ASSEMBLY: | MAIN WIRE LOOM | ASSEMBLY REF: VDLl/lOJ

DESCRIPTION

ON-OFF-CHARGE
Switch 2P 3T

Fuse Holder

Power Socket

Resistor

Battery Spring

Thermistor

QTY PER
ASSEM'Y
NO.

1

1

1

1

2

1

6 Way Cable Shell | 1
1.5mm Rubber Sleeving | 12
Stranded core, single | 6 7/0.2mm copper

conductors PVC wall
coverings 100mm long

Stranded core, single
7/0.2mm sopper
conductors PVC wall
coverings 55mm long | 3
Crimp terminals | 6
Solder | As
| Reqd.
PTFE Sleeving | 35mm

VDLl/129

COMPONENT SUPPLIER OR | MANUFAC'S
OR ASSM' Y | MANUFACTURER | REF.

28003

28804

28642

156000

28803

314002

28650

28200

28225

28226

28649

25901

- 28227 ·
G.ENGLISH | SS-23F19

ARIEL PRESSINGS RA 3395

G.ENGLISH | HEC07 49-01-02(
FARNELL | 104-251

GILLSAN

STC | YBA020TB
FARNELL | 143-095
(22-01-1063) CROYLEK LTD.

Supplied by subcontractor

Supplied by subcontractor

FARNELL | 143-201

Supplied by Subcontractor

RS

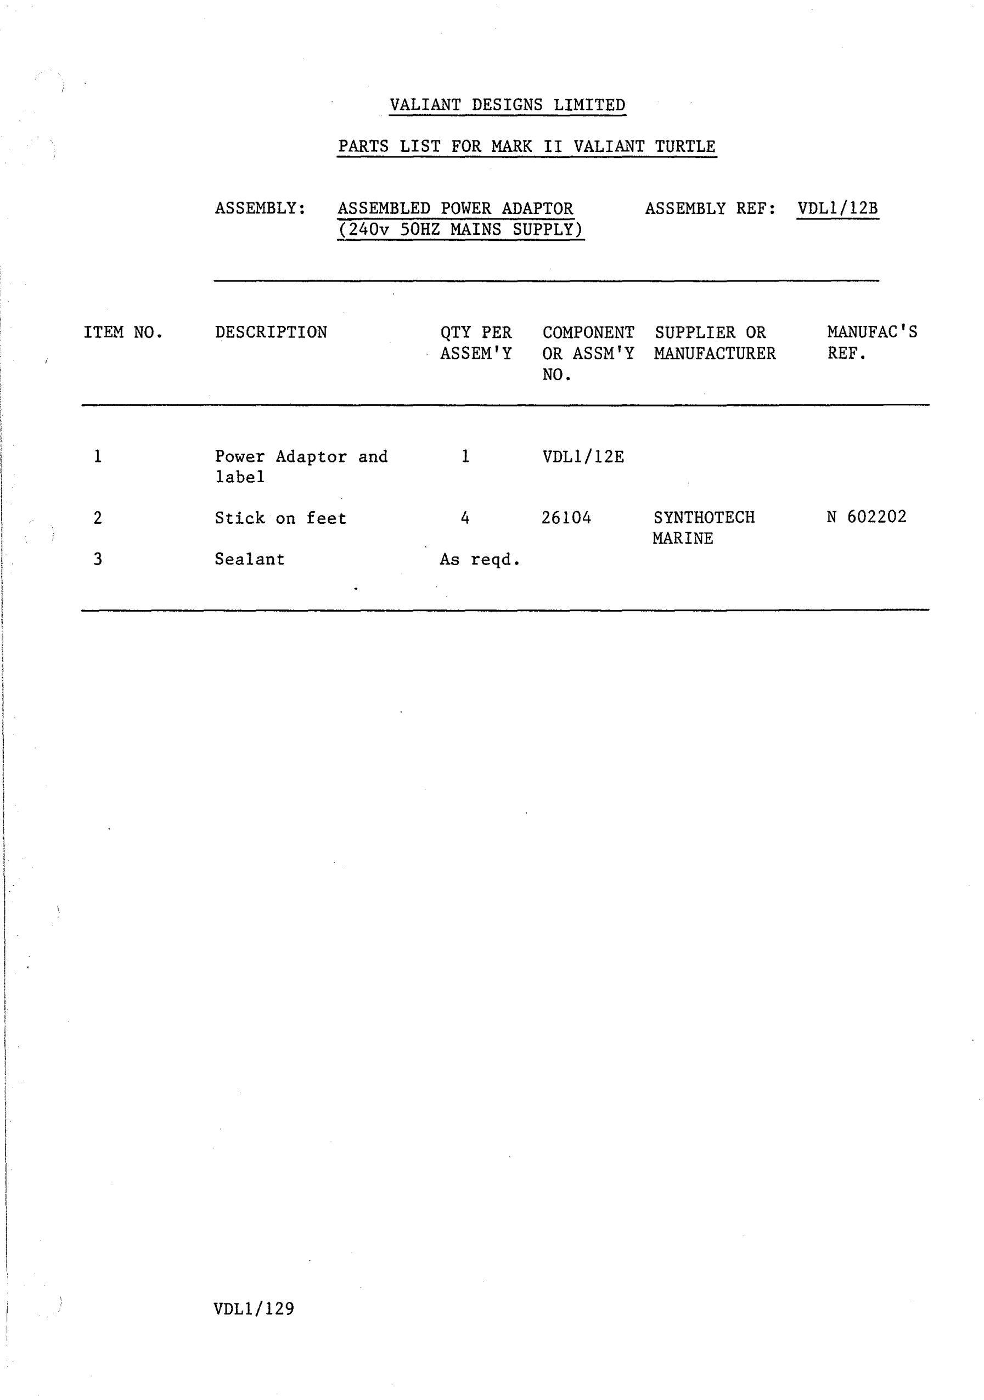
[picture p59: page 27]

ITEM NO.

1

2

3

VALIANT DESIGNS LIMITED

PARTS LIST FOR MARK II VALIANT TURTLE

ASSEMBLY: ASSEMBLED POWER ADAPTOR (240v SOHZ MAINS SUPPLY)

ASSEMBLY REF: VDL1/12B

DESCRIPTION

Power Adaptor and
label

Stick on feet

Sealant

QTY PER | COMPONENT SUPPLIER OR
ASSEM'Y | OR ASSM'Y MANUFACTURER
| NO.

1

4

As reqd.

VDL1/12E

26104 SYNTHOTECH MARINE

MANUFAC'S
REF.

N 602202

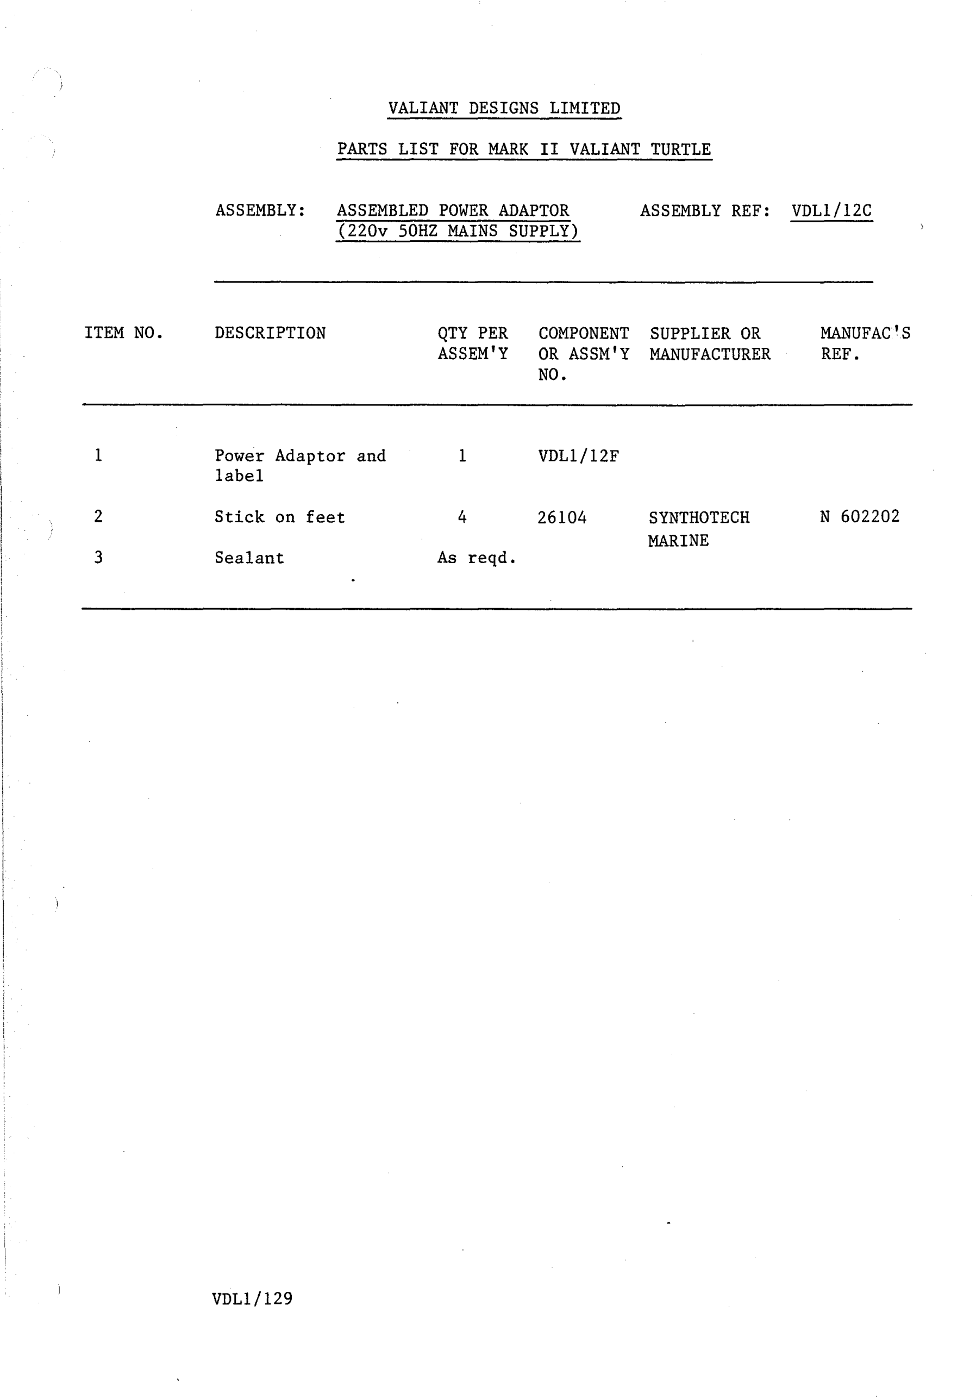
[picture p60: page 28]

ITEM NO.

1

2

3

VALIANT DESIGNS LIMITED

PARTS LIST FOR MARK II VALIANT TURTLE

ASSEMBLY: ASSEMBLED POWER ADAPTOR (220v SOHZ MAINS SUPPLY) ASSEMBLY REF: VDL1/12C

DESCRIPTION

Power Adaptor and
label

Stick on feet

Sealant

QTY PER | COMPONENT SUPPLIER OR
ASSEM'Y | OR ASSM'Y MANUFACTURER
| NO.

1

4

As reqd.

VDL1/12F

26104 SYNTHOTECH MARINE

MANUFAG'S
REF.

N 602202

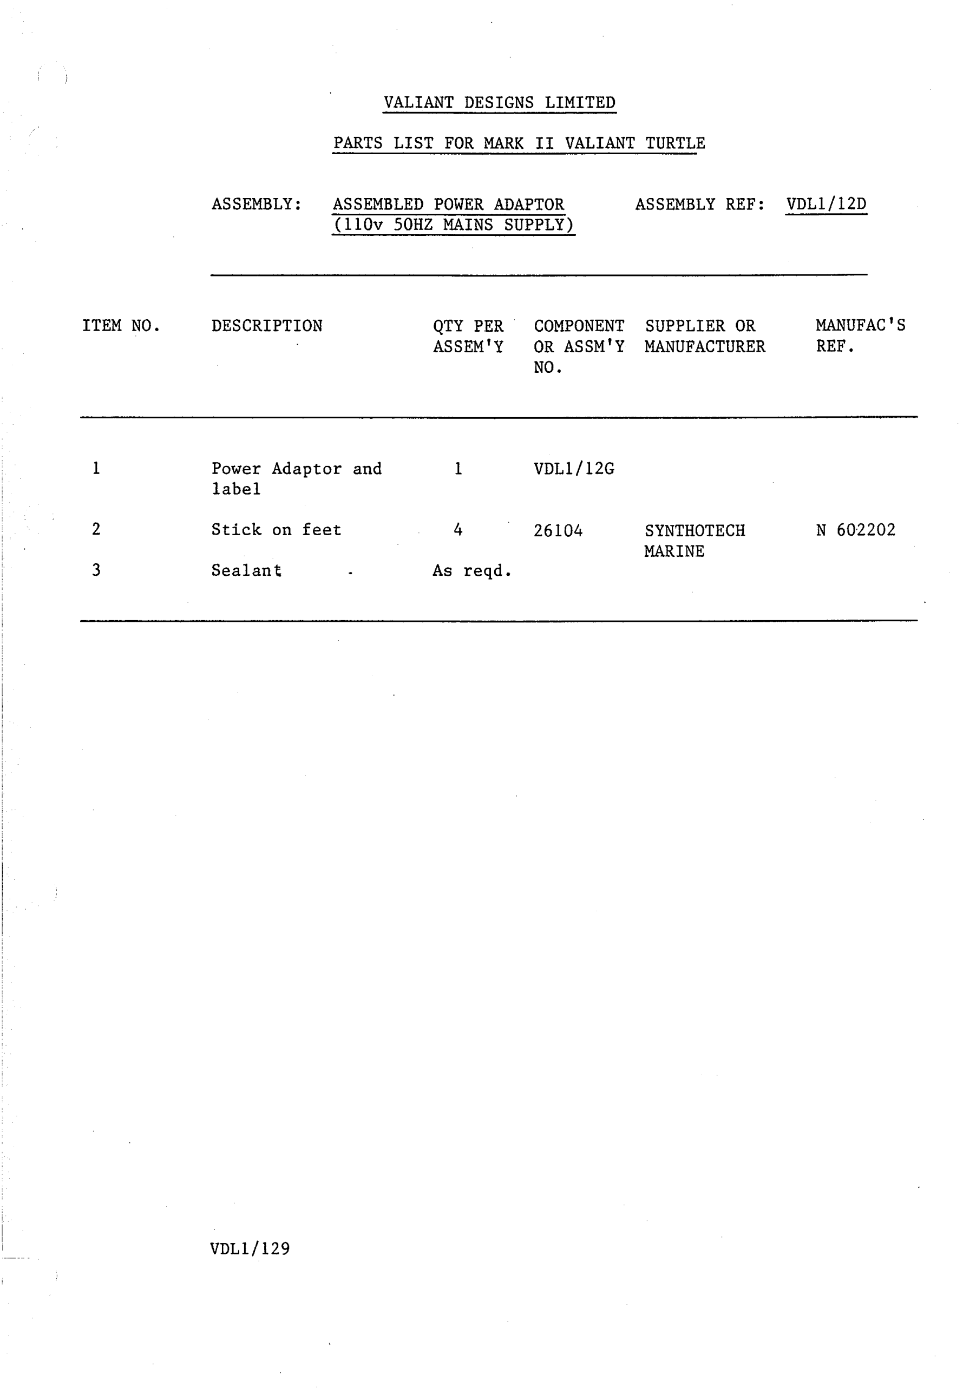
[picture p61: page 29]

ITEM NO.

1

2

3

VALIANT DESIGNS LIMITED

PARTS LIST FOR MARK II VALIANT TURTLE

ASSEMBLY: ASSEMBLED POWER ADAPTOR (110v SOHZ MAINS SUPPLY)

ASSEMBLY REF: VDL1/12D

DESCRIPTION

Power Adaptor and
label

Stick on feet

Sealant

VDLl/129

QTY PER | COMPONENT SUPPLIER OR
ASSEM'Y | OR ASSM'Y MANUFACTURER
| NO.

1

4

As reqd.

VDL1/12G

26104 SYNTHOTECH MARINE

MANUFAC'S
REF.

N 602202

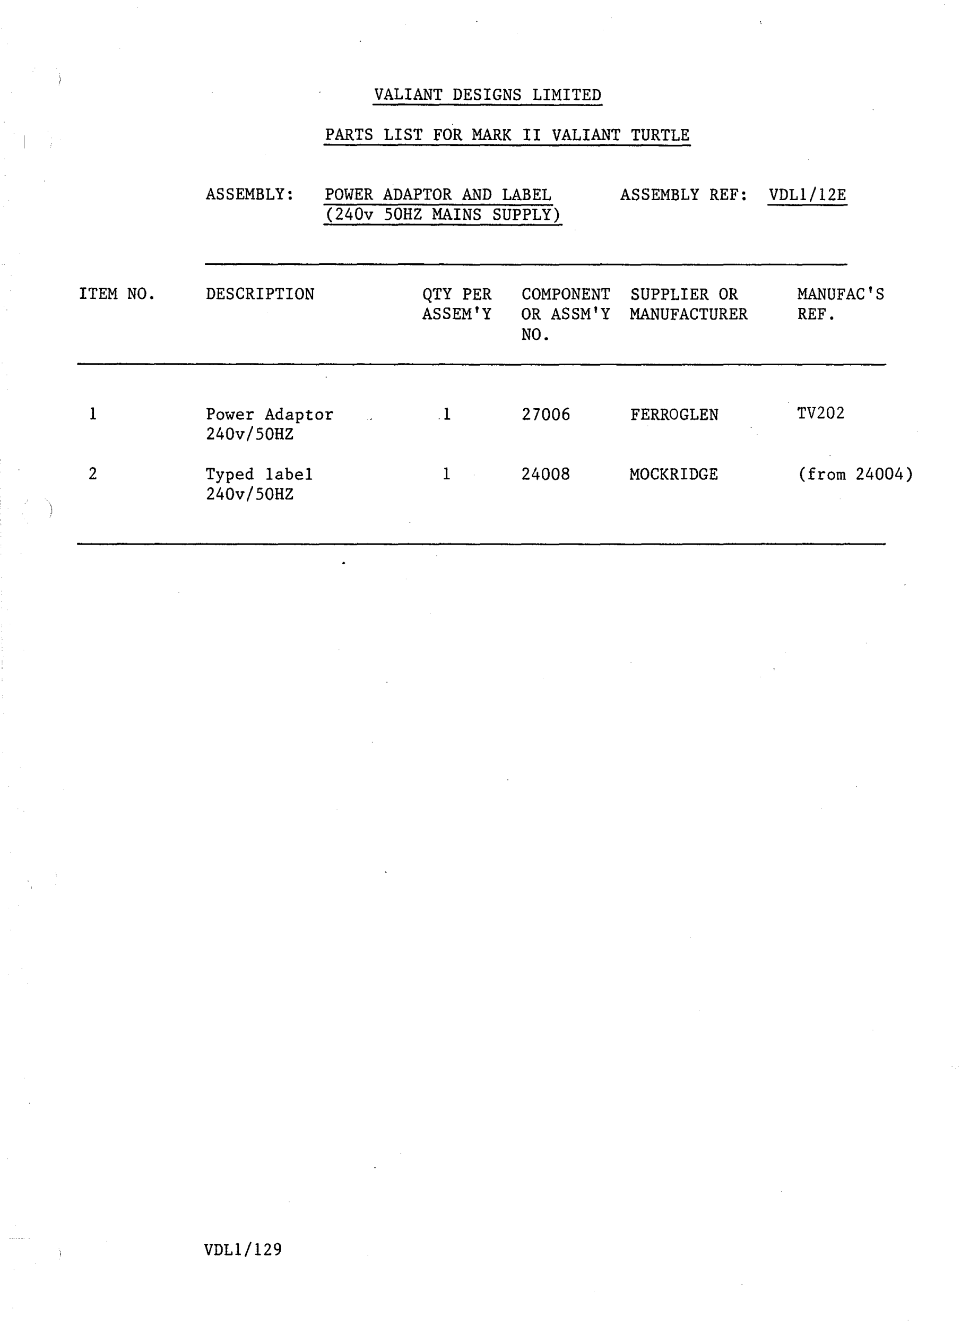
[picture p62: page 30]

ITEM NO.

1

2

VALIANT DESIGNS LIMITED

PARTS LIST FOR MARK II VALIANT TURTLE

ASSEMBLY: POWER ADAPTOR AND LABEL (240v 50HZ MAINS SUPPLY) ASSEMBLY REF: VDL1/12E

DESCRIPTION

Power Adaptor
240v/50HZ

Typed label
240v/50HZ
QTY PER | COMPONENT SUPPLIER OR
ASSEM'Y | OR ASSM'Y MANUFACTURER
| NO.
1 | 27006 | FERROGLEN
1 | 24008 | MOCKRIDGE

MANUFAC'S
REF.

TV202

(from 24004)

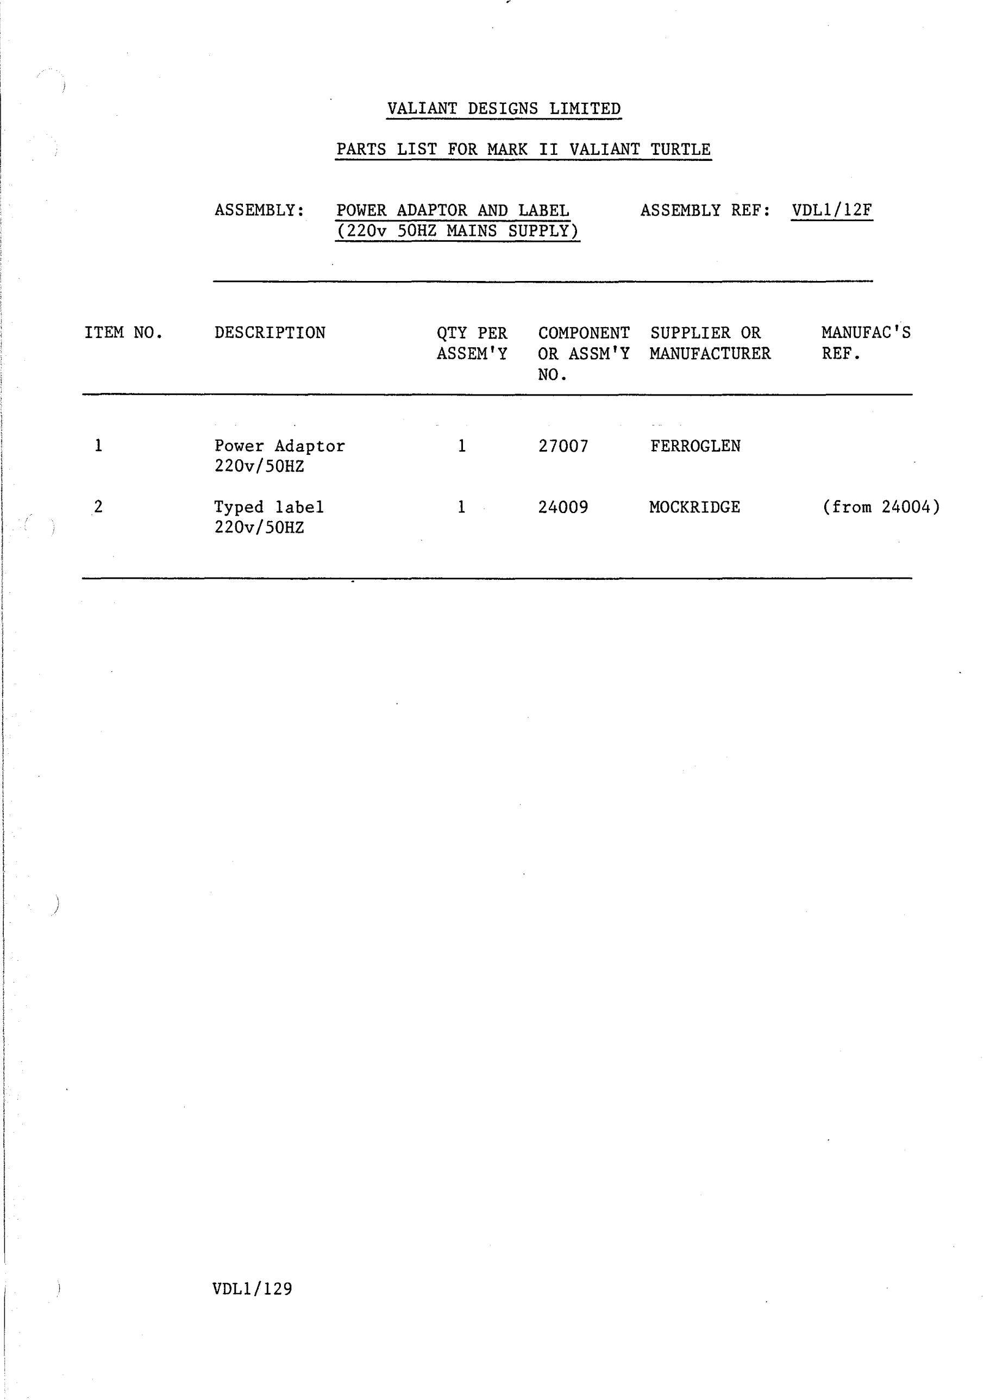
[picture p63: page 31]

ITEM NO.

1

2

VALIANT DESIGNS LIMITED

PARTS LIST FOR MARK II VALIANT TURTLE

ASSEMBLY: POWER ADAPTOR AND LABEL (220v 50HZ MAINS SUPPLY) ASSEMBLY REF: VDL1/12F

DESCRIPTION

Power Adaptor
220v/50HZ

Typed label
220v/50HZ
QTY PER | COMPONENT SUPPLIER OR
ASSEM'Y | OR ASSM'Y MANUFACTURER
NO.
1 | 27007 | FERROGLEN
1 | 24009 | MOCKRIDGE

MANUFAC'S
REF.

(from 24004)

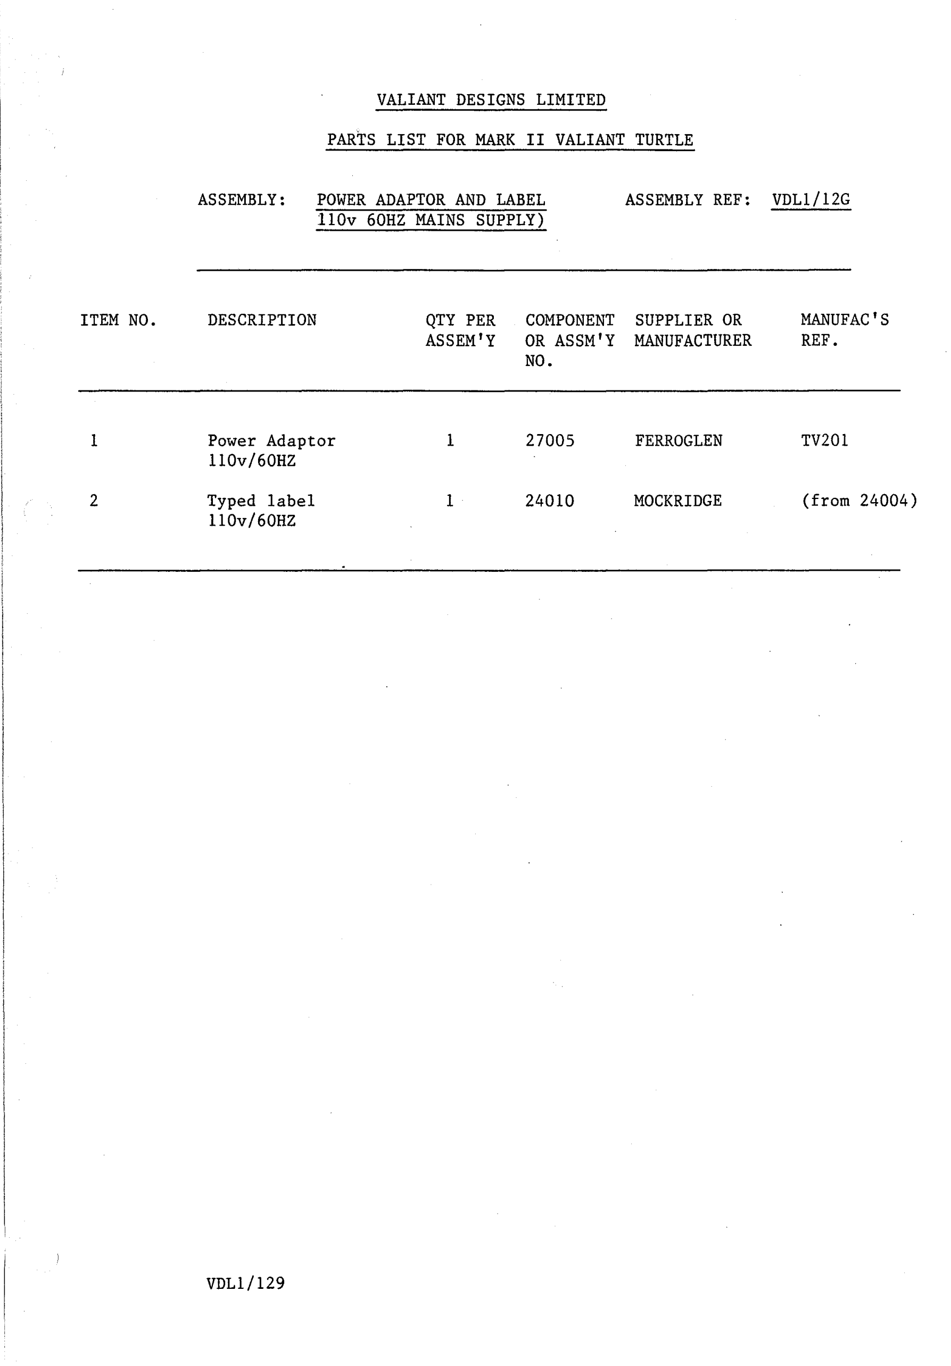
[picture p64: page 32]

ITEM NO.

1

2

VALIANT DESIGNS LIMITED

PARTS LIST FOR MARK II VALIANT TURTLE

ASSEMBLY: POWER ADAPTOR AND LABEL 110v 60HZ MAINS SUPPLY) ASSEMBLY REF: VDL1/12G

DESCRIPTION

Power Adaptor
110v/60HZ

Typed label
110v/60HZ
QTY PER | COMPONENT SUPPLIER OR
ASSEM'Y | OR ASSM'Y MANUFACTURER
| NO.
1 | 27005 | FERROGLEN
1 | 24010 | MOCKRIDGE

MANUFAC'S
REF.

TV201

(from 24004)

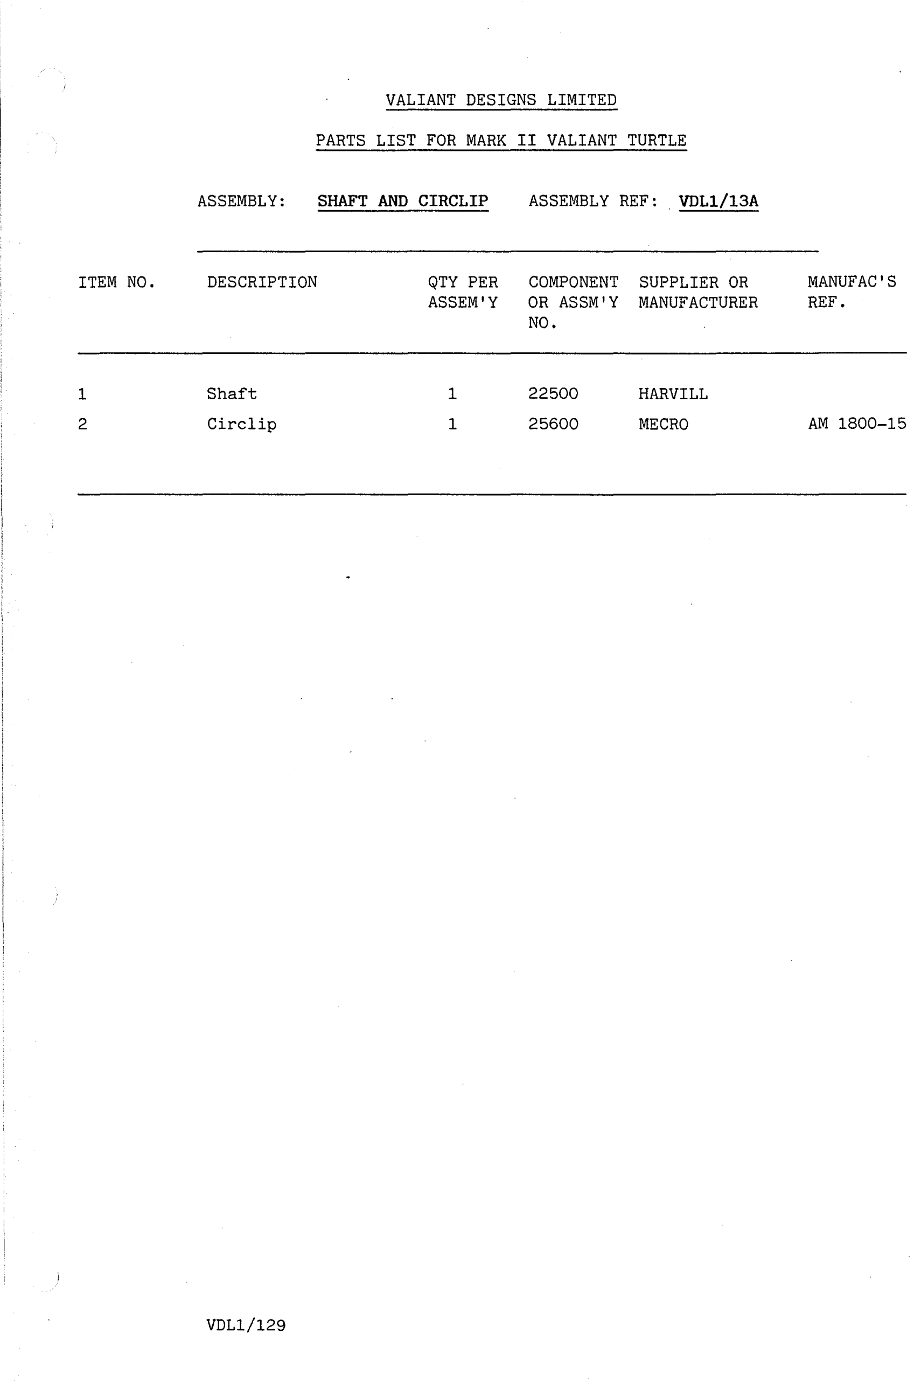
[picture p65: page 33]

ITEM NO.

1
2

VALIANT DESIGNS LIMITED

PARTS LIST FOR MARK II VALIANT TURTLE

ASSEMBLY:

DESCRIPTION

Shaft
Circlip
SHAFT AND CIRCLIP | ASSEMBLY REF:. VDL1/13A
QTY PER | COMPONENT SUPPLIER OR
ASSEM'Y | OR ASSM'Y MANUFACTURER
| NO.

1
1

22500
25600

HARVILL
MECRO

MANUFAC'S
REF.

AM 1800-15

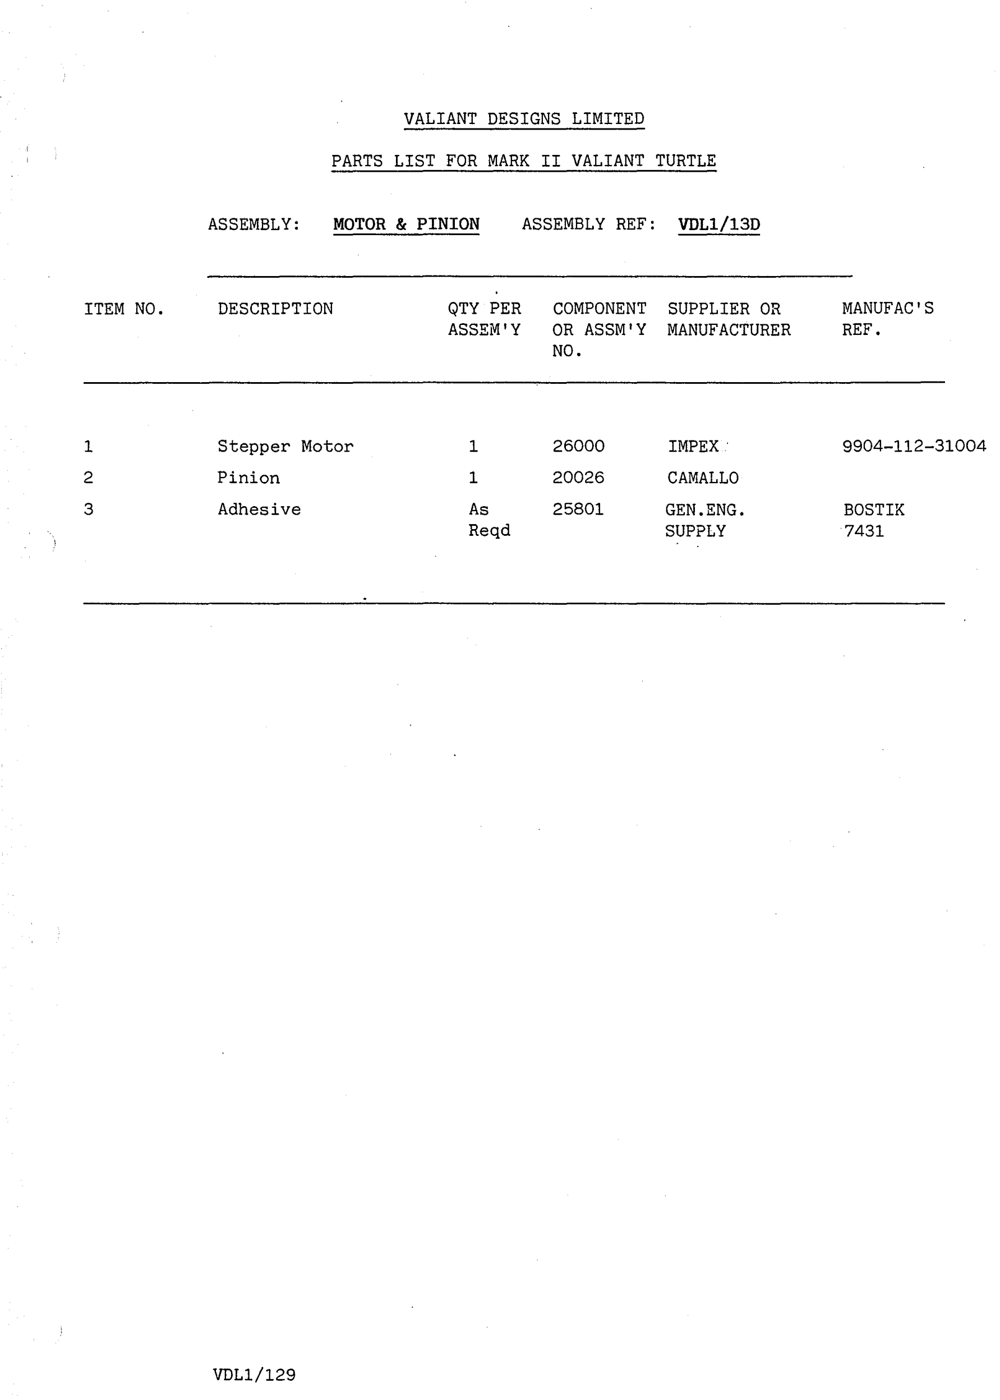
[picture p66: page 34]

ITEM NO.

1
2
3

VALIANT DESIGNS LIMITED

PARTS LIST FOR MARK II VALIANT TURTLE

ASSEMBLY: | MOTOR & PINION | ASSEMBLY REF: VDL1/13D

DESCRIPTION

Stepper Motor
Pinion
Adhesive
QTY PER | COMPONENT SUPPLIER OR
ASSEM'Y | OR ASSM'Y MANUFACTURER
| NO.

1
1
As
Reqd

26000
20026
25801

IMPEX ·
CAMALLO
GEN.ENG.
SUPPLY

MANUFAC'S
REF.

9904-112-31004

BOSTIK
7431

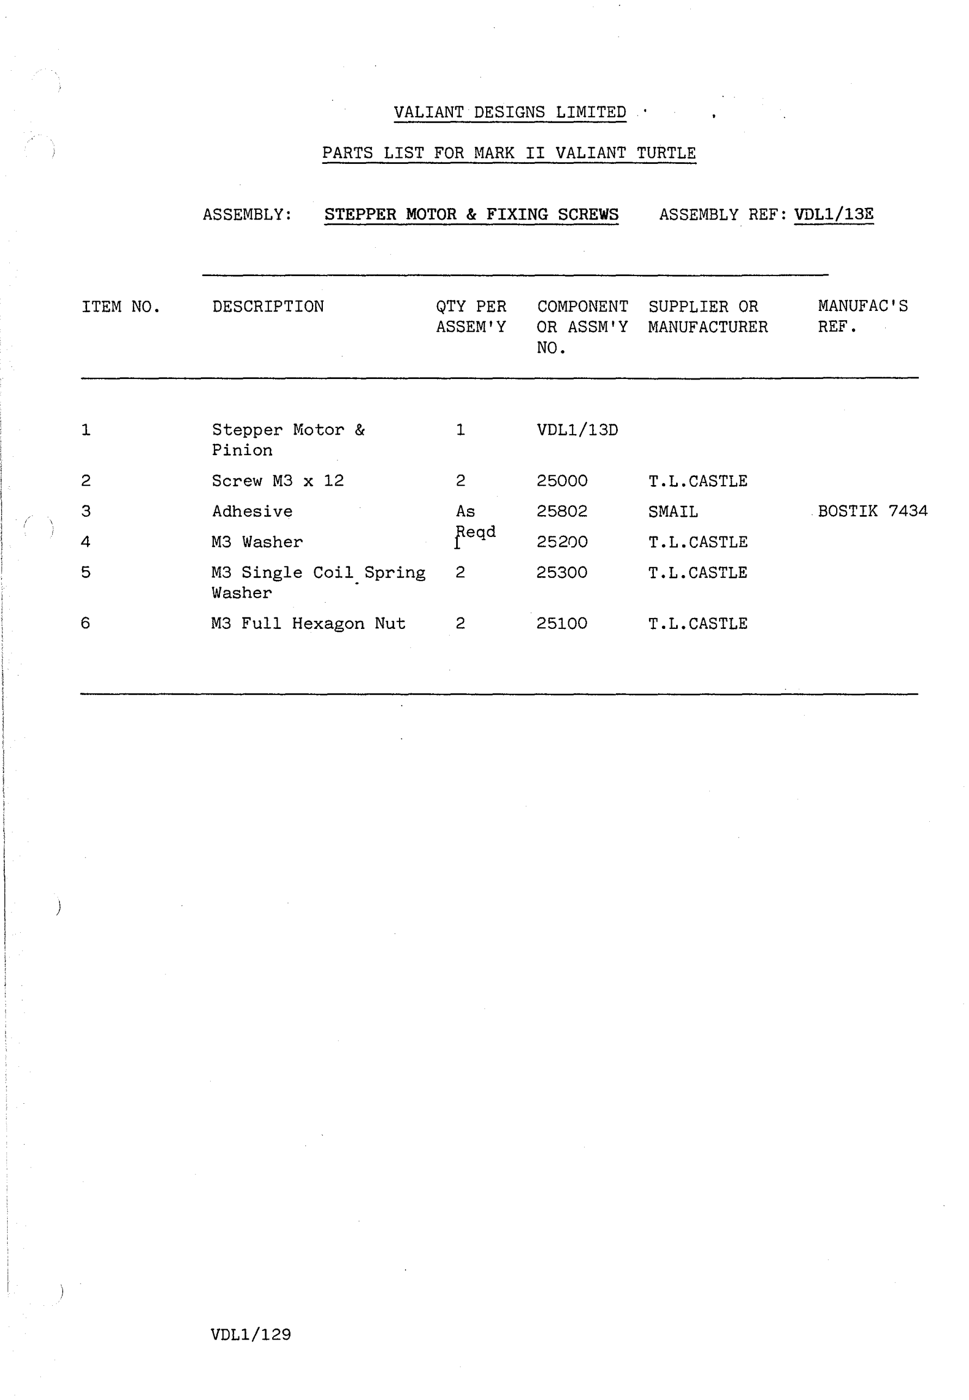
[picture p67: page 35]

ITEM NO.

1

2

3
4
5

6

VALIANT DESIGNS LIMITED

PARTS LIST FOR MARK II VALIANT TURTLE

ASSEMBLY: | STEPPER MOTOR & FIXING SCREWS | ASSEMBLY REF: VDL1/13E

DESCRIPTION

Stepper Motor &
Pinion
Screw M3 X 12
Adhesive
M3 Washer
M3 Single Coil_Spring
Washer
M3 Full Hexagon Nut
QTY PER | COMPONENT SUPPLIER OR
ASSEM'Y | OR ASSM'Y MANUFACTURER
| NO.
1 | VDL1/13D
2 | 25000 | T.L.CASTLE
As | 25802 | SMAIL
reqd | 25200 | T.L.CASTLE
2 | 25300 | T.L.CASTLE
2 | 25100 | T.L.CASTLE

MANUFAC'S
REF.

BOSTIK 7434

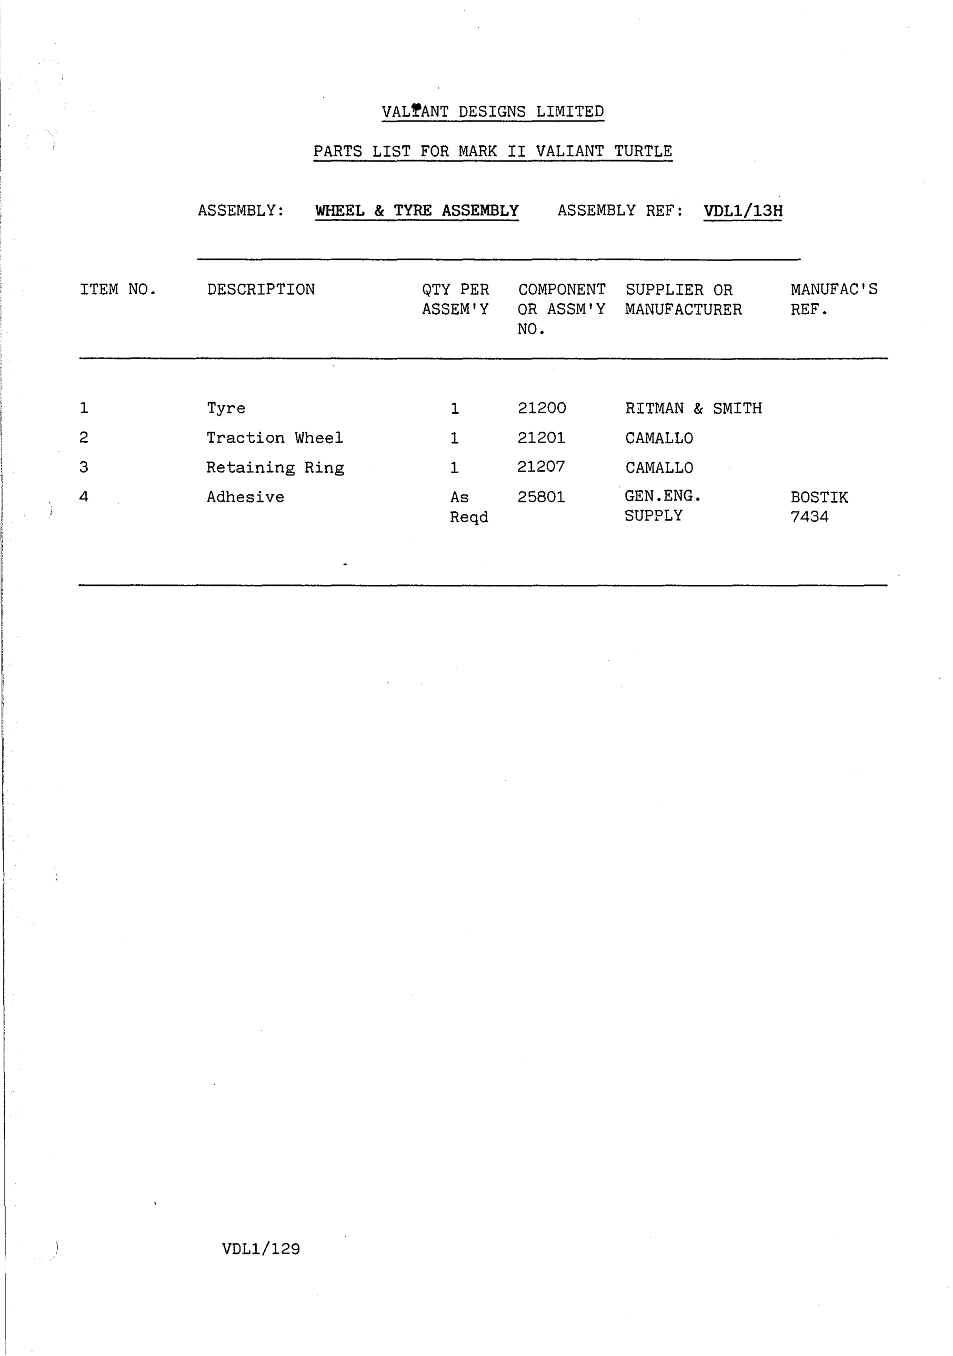
[picture p68: page 36]

ITEM NO.

1
2

3
4

VAL!ANT DESIGNS LIMITED

PARTS LIST FOR MARK II VALIANT TURTLE

ASSEMBLY: | WHEEL & TYRE ASSEMBLY | ASSEMBLY REF: VDL1/13H

DESCRIPTION

Tyre
Traction Wheel
Retaining Ring
Adhesive
QTY PER | COMPONENT SUPPLIER OR
ASSEM'Y | OR ASSM'Y MANUFACTURER
| NO.
1 | 21200 | RITMAN & SMITH
1 | 21201 | CAMALLO
1 | 21207 | CAMALLO
As | 25801 | GEN.ENG.
Reqd | | SUPPLY

MANUFAC'S
REF.

BOSTIK
7434

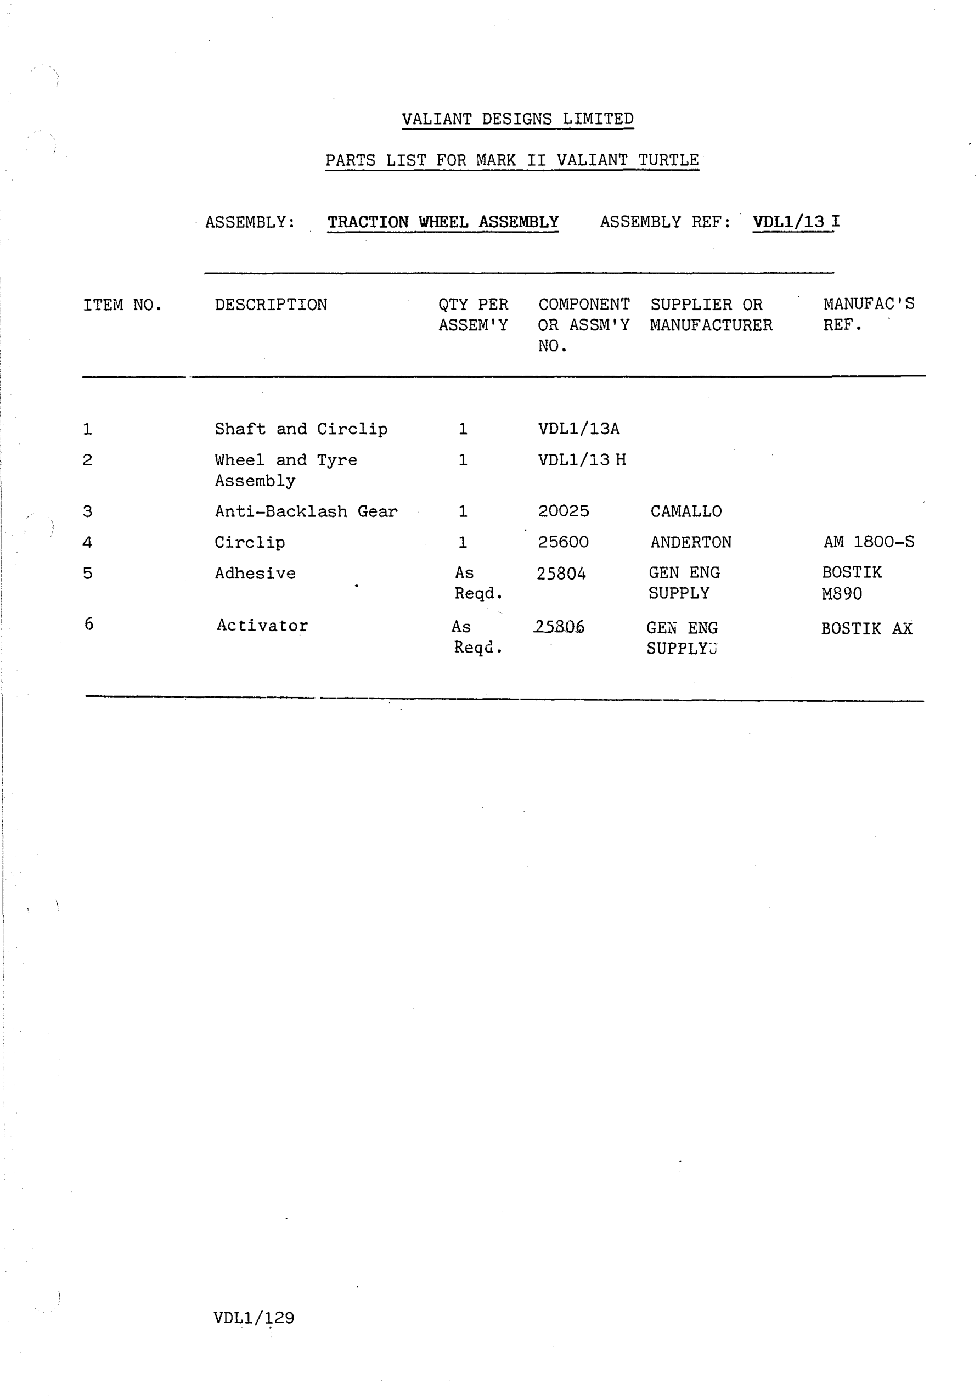
[picture p69: page 37]

ITEM NO.

1
2

3

4
5

6

VALIANT DESIGNS LIMITED

PARTS LIST FOR MARK II VALIANT TURTLE

ASSEMBLY: | TRACTION \\IHEEL ASSEMBLY | ASSEMBLY REF: VDLl/13 I

DESCRIPTION

Shaft and Circlip
Wheel and Tyre
Assembly
Anti-Backlash Gear
Circlip
Adhesive

Activator

VDLl/~29

QTY PER | COMPONENT SUPPLIER OR
ASSEM'Y | OR ASSM'Y MANUFACTURER
| NO.
1 | VDL1/13A
1 | VDLl/13 H
1 | 20025 | CAMALLO
1 | 25600 | ANDERTON
As | 25804 | GEN ENG
Reqd. | | SUPPLY
As | 25.BD.6 | GEN ENG
Reqd. | | SUPPLY'J

MANUFAC'S
REF.

AM 1800-S
BOSTIK
M890
BOSTIK AX

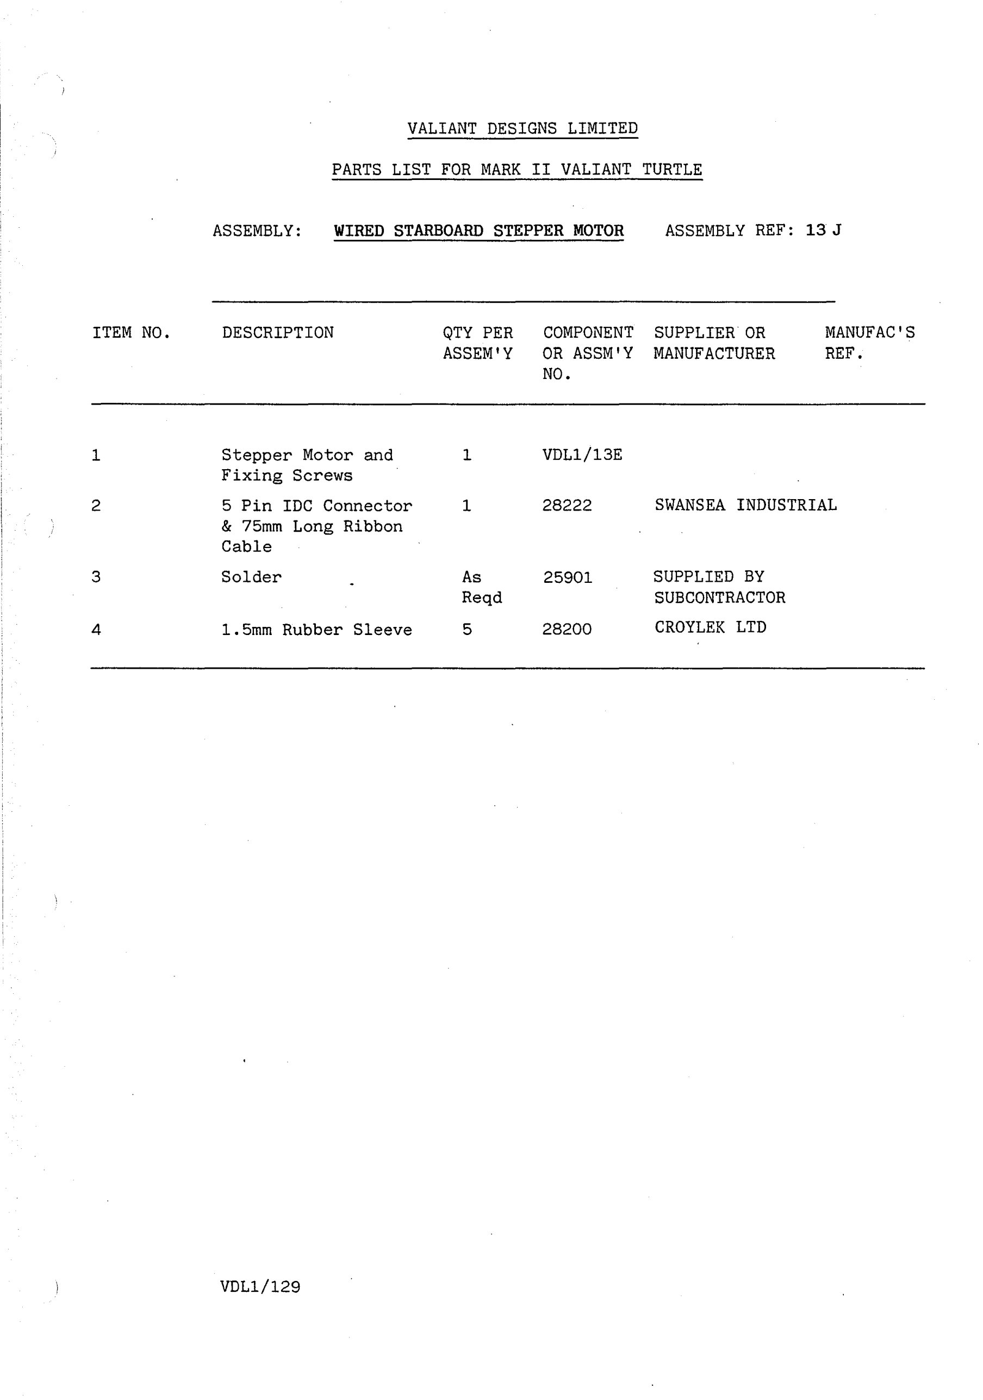
[picture p70: page 38]

ITEM NO.

1

2

3

4

VALIANT DESIGNS LIMITED

PARTS LIST FOR MARK II VALIANT TURTLE

ASSEMBLY: | WIRED STARBOARD STEPPER MOTOR | ASSEMBLY REF: 13J

DESCRIPTION

Stepper Motor and
Fixing Screws
5 Pin IDC Connector
& 75mm Long Ribbon
Cable
Solder

1.5mm Rubber Sleeve

QTY PER | COMPONENT SUPPLIER OR
ASSEM'Y | OR ASSM'Y MANUFACTURER
| NO.
1 | VDL1/13E

MANUFAC'S
REF.
1 | 28222 | SWANSEA INDUSTRIAL
As | 25901 | SUPPLIED BY
Reqd | | SUBCONTRACTOR
5 | 28200 | CROYLEK LTD

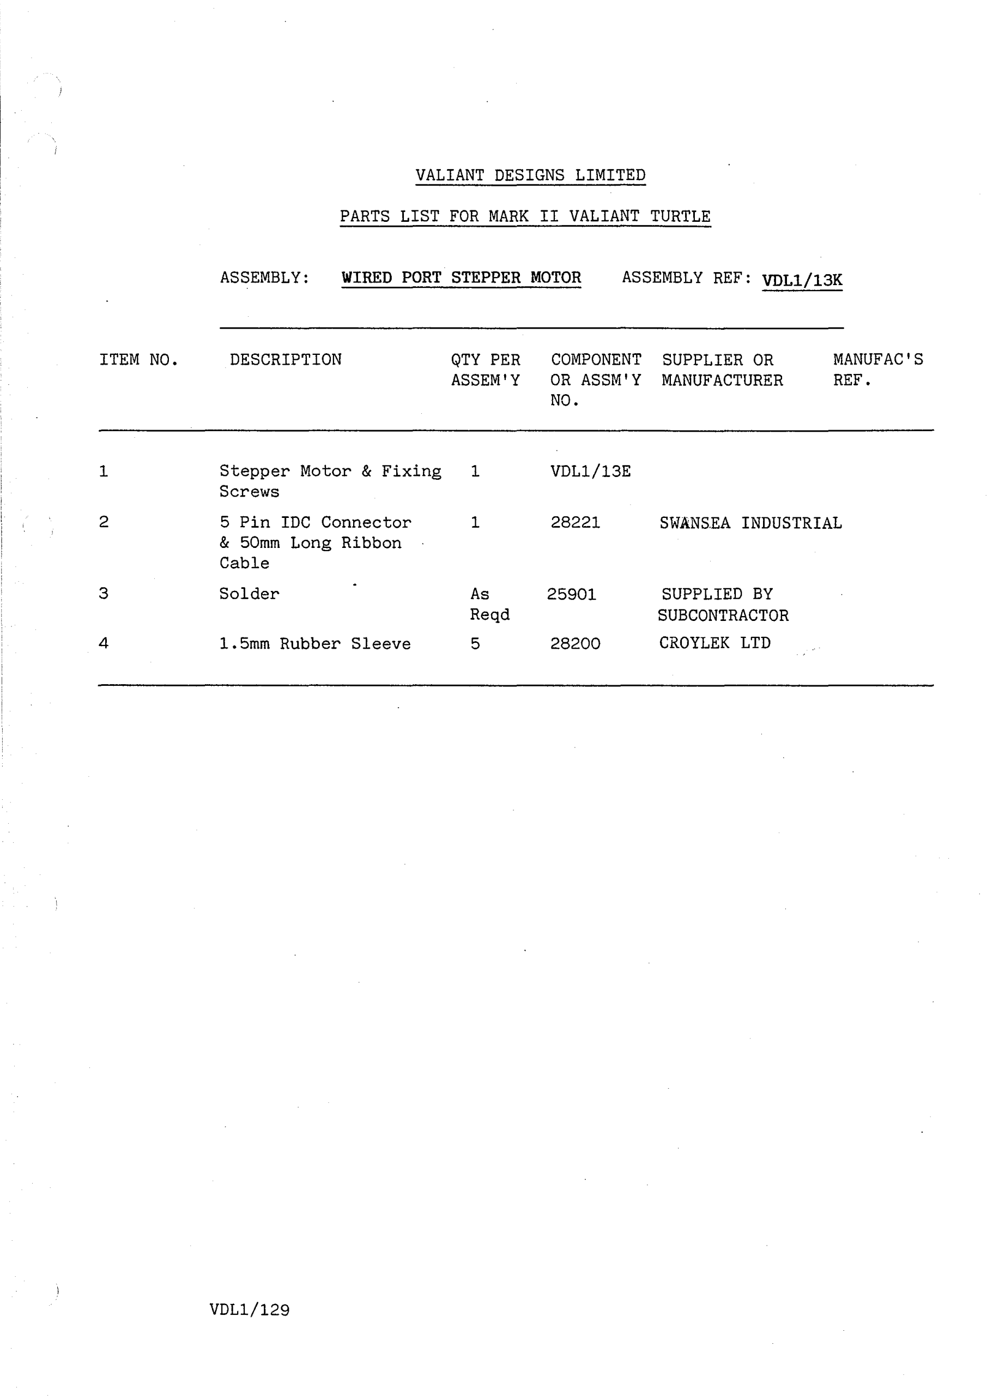
[picture p71: page 39]

ITEM NO.

1

2

3

4

VALIANT DESIGNS LIMITED

PARTS LIST FOR MARK II VALIANT TURTLE

ASSEMBLY: | WIRED PORT STEPPER MOTOR | ASSEMBLY REF: VDL1/13K

DESCRIPTION

Stepper Motor & Fixing
Screws
5 Pin IDC Connector
& 50mm Long Ribbon
Cable
Solder

1.5mm Rubber Sleeve

QTY PER | COMPONENT SUPPLIER OR
ASSEM'Y | OR ASSM'Y MANUFACTURER
| NO.
1 | VDL1/13E

MANUFAC'S
REF.
1 | 28221 | SWANS.EA INDUSTRIAL
As | 25901 | SUPPLIED BY
Reqd | | SUBCONTRACTOR
5 | 28200 | CROYLEK LTD

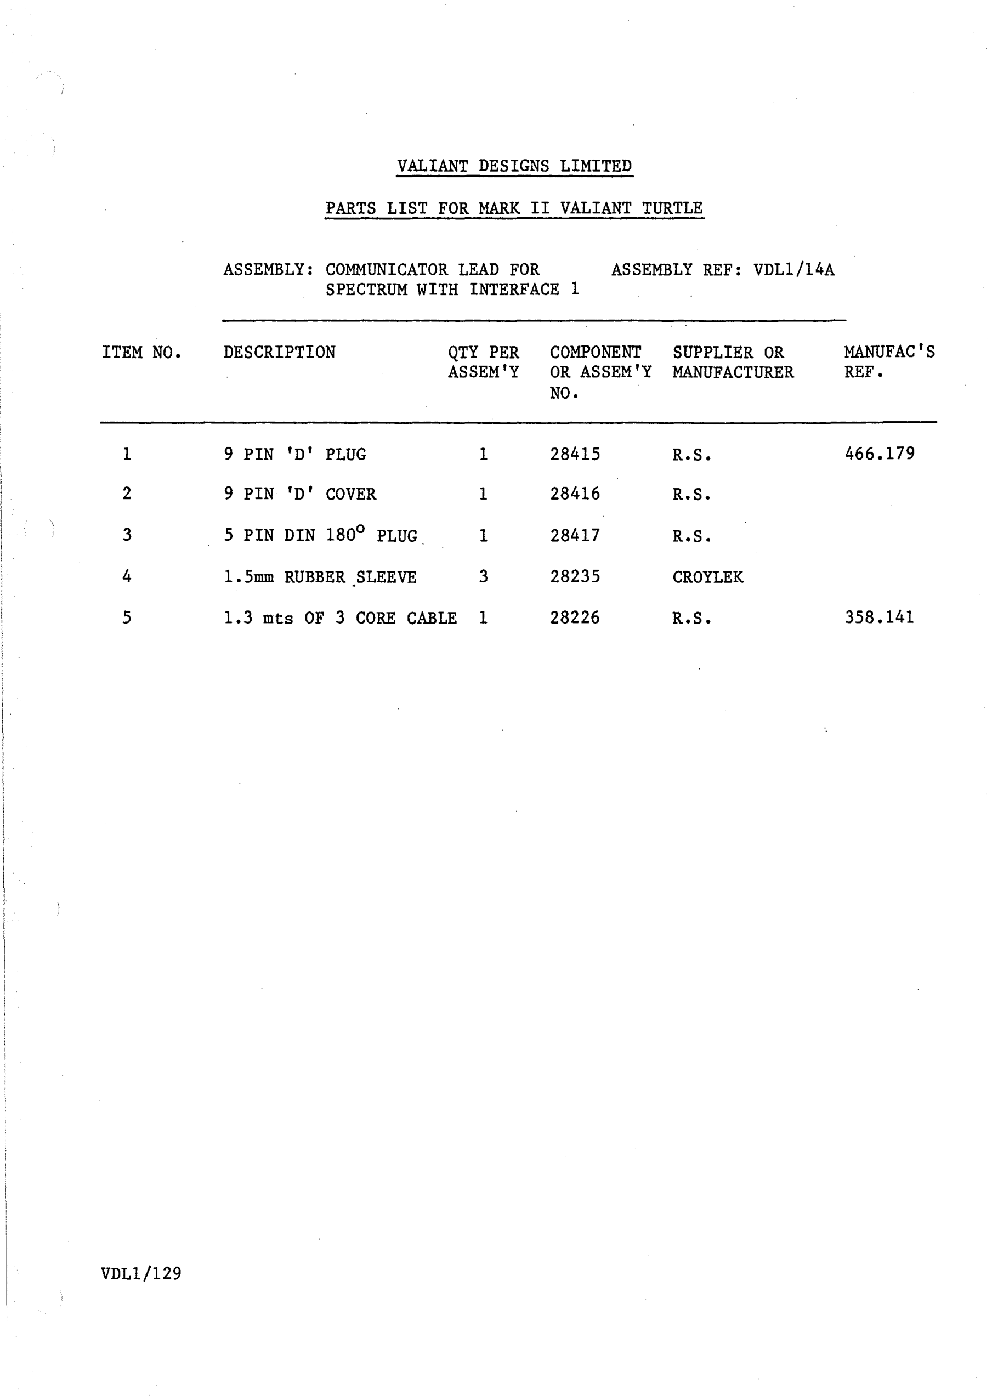
[picture p72: page 40]

ITEM NO.

1

2

3

4

5

VDLl/129

VALIANT DESIGNS LIMITED

PARTS LIST FOR MARK II VALIANT TURTLE

ASSEMBLY: COMMUNICATOR LEAD FOR | ASSEMBLY REF: VDL1/14A
SPECTRUM WITH INTERFACE 1

DESCRIPTION

9 PIN 'D' PLUG
9 PIN 'D' COVER

5 PIN DIN 180° PLUG

1.5mm RUBBER.SLEEVE

QTY PER | COMPONENT | SUPPLIER OR
ASSEM'Y | OR ASSEM'Y MANUFACTURER
| NO.

1

1

1

3 | | R.S.
| | R.S.

1.3 mts OF 3 CORE CABLE 1

28415
28416

28417

28235

28226

R.S.

CROYLEK

R.S.

MANUFAC'S
REF.

466.179

358.141

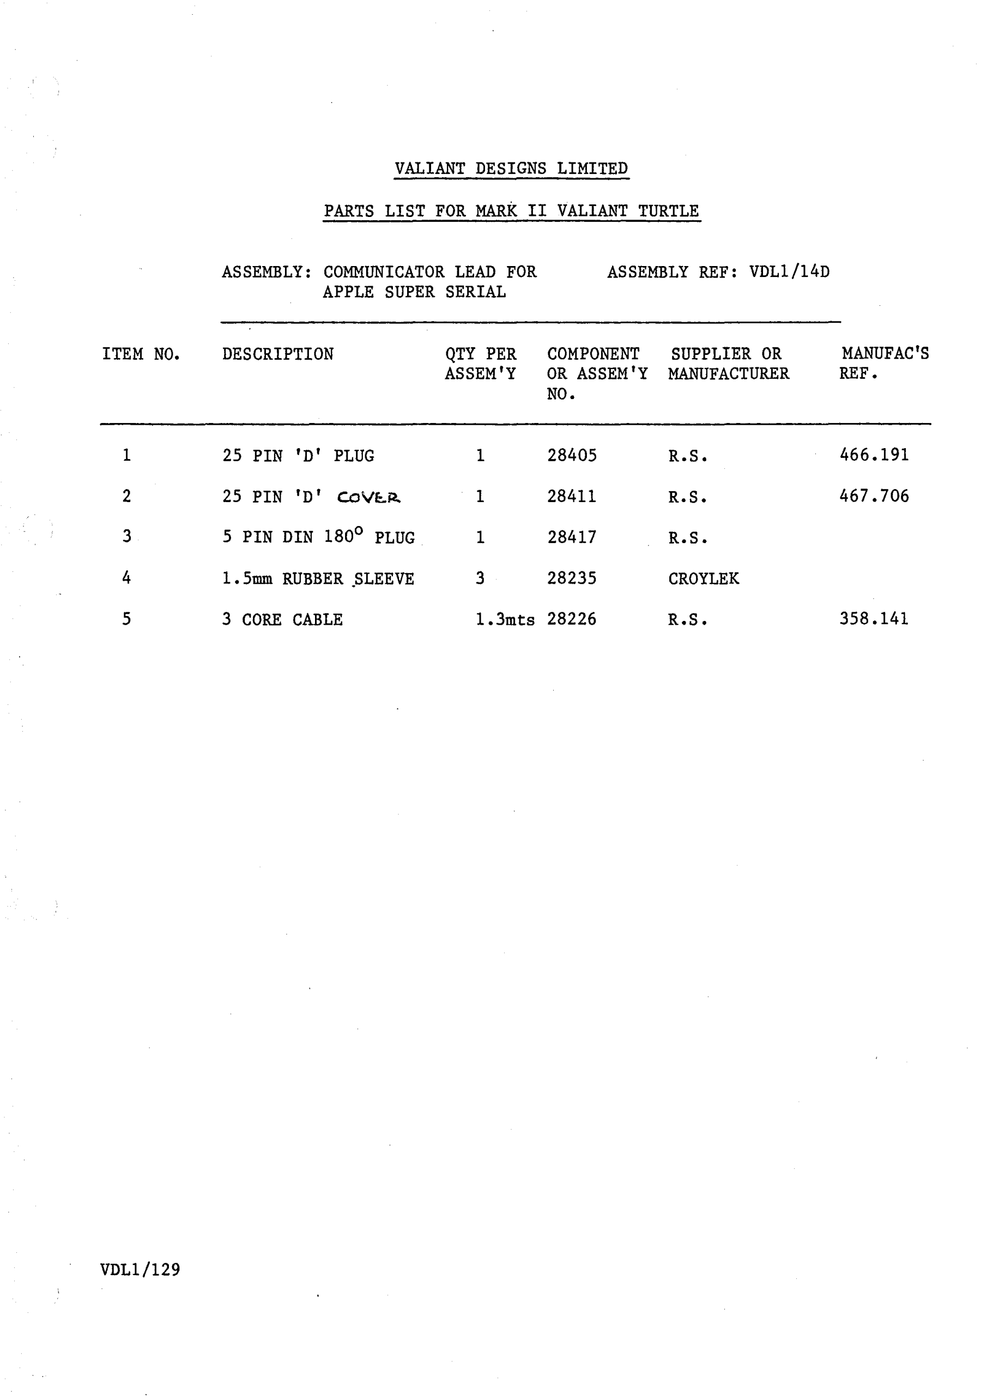
[picture p73: page 41]

ITEM NO.

1

2

3

4

5

VDLl/129

VALIANT DESIGNS LIMITED
PARTS LIST FOR MARK II VALIANT TURTLE

ASSEMBLY: COMMUNICATOR LEAD FOR APPLE SUPER SERIAL

ASSEMBLY REF: VDL1/14D

DESCRIPTION

25 PIN 'D' PLUG

25 PIN 'D' COVE:..R.

5 PIN DIN 180° PLUG

1.5mm RUBBER ~LEEVE

3 CORE CABLE

QTY PER | COMPONENT | SUPPLIER OR
ASSEM'Y | OR ASSEM'Y MANUFACTURER
| NO.

1

1

1

3 | 28405
| 28411
| 28417
| 28235

l.3mts 28226

| | R.S.
| | R.S.
R. S.
| | CROYLEK
| | R.S.

MANUFAC'S
REF.

466.191

467.706

358.141

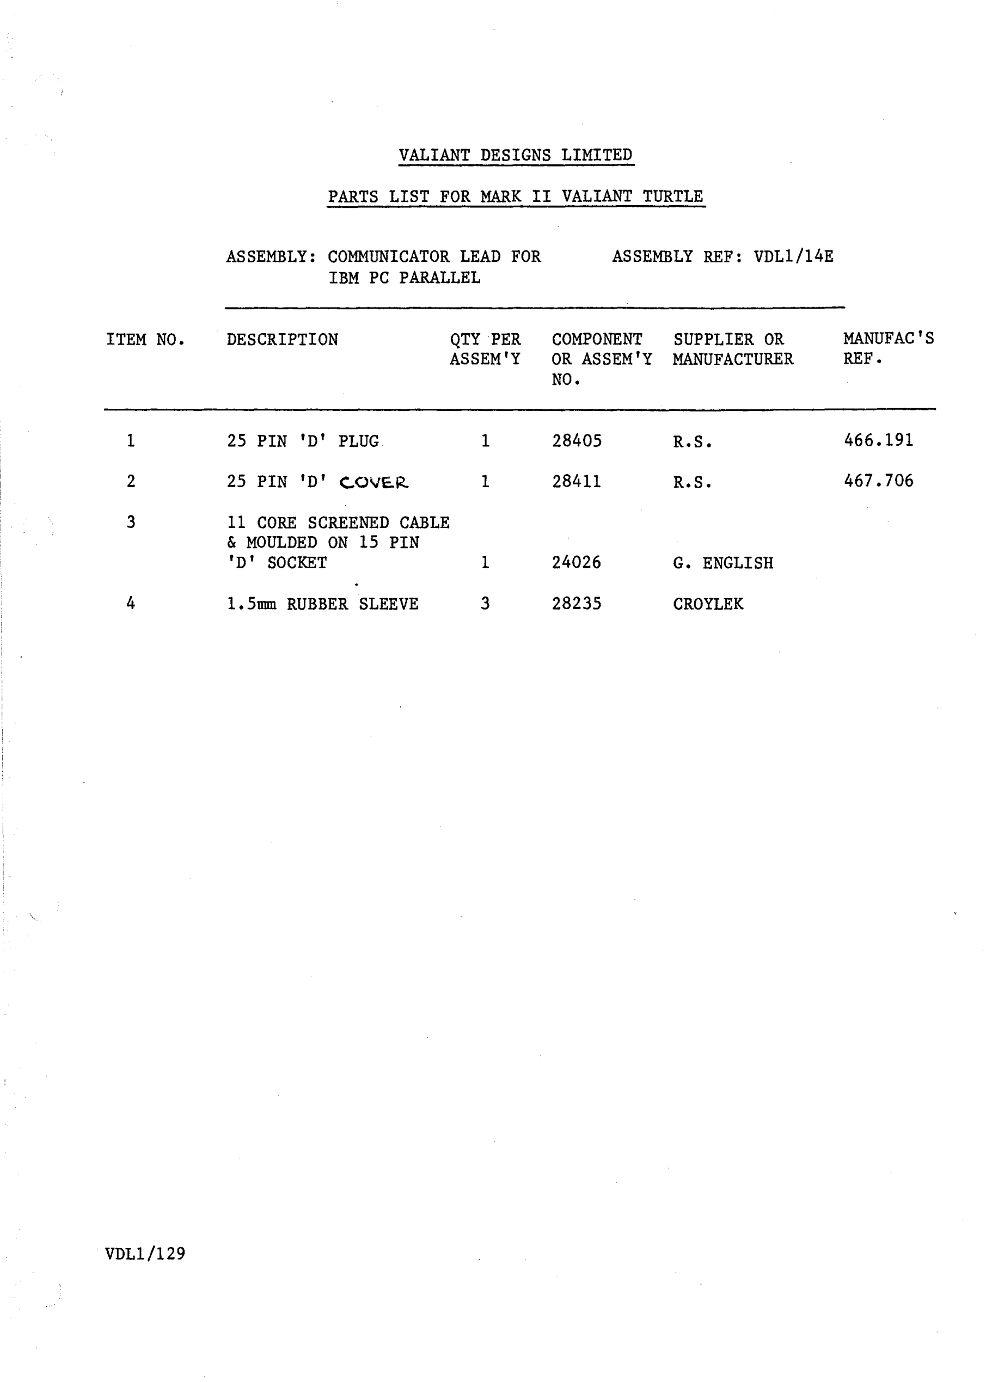
[picture p74: page 42]

ITEM NO.

1

2

3

4

VDLl/129

VALIANT DESIGNS LIMITED

PARTS LIST FOR MARK II VALIANT TURTLE

ASSEMBLY: COMMUNICATOR LEAD FOR IBM PC PARALLEL

ASSEMBLY REF: VDL1/14E

DESCRIPTION

25 PIN 'D' PLUG

25 PIN 'D' C.OVE.R.

11 CORE SCREENED CABLE
& MOULDED ON 15 PIN
'D' SOCKET

l.5unn RUBBER SLEEVE

QTY PER | COMPONENT | SUPPLIER OR
ASSEM'Y | OR ASSEM'Y MANUFACTURER
| NO.
1 | 28405 | R.S.
1 | 28411 | R.S.
1 | 24026 | G. ENGLISH
3 | 28235 | CROYLEK

MANUFAC'S
REF.

466.191

467.706

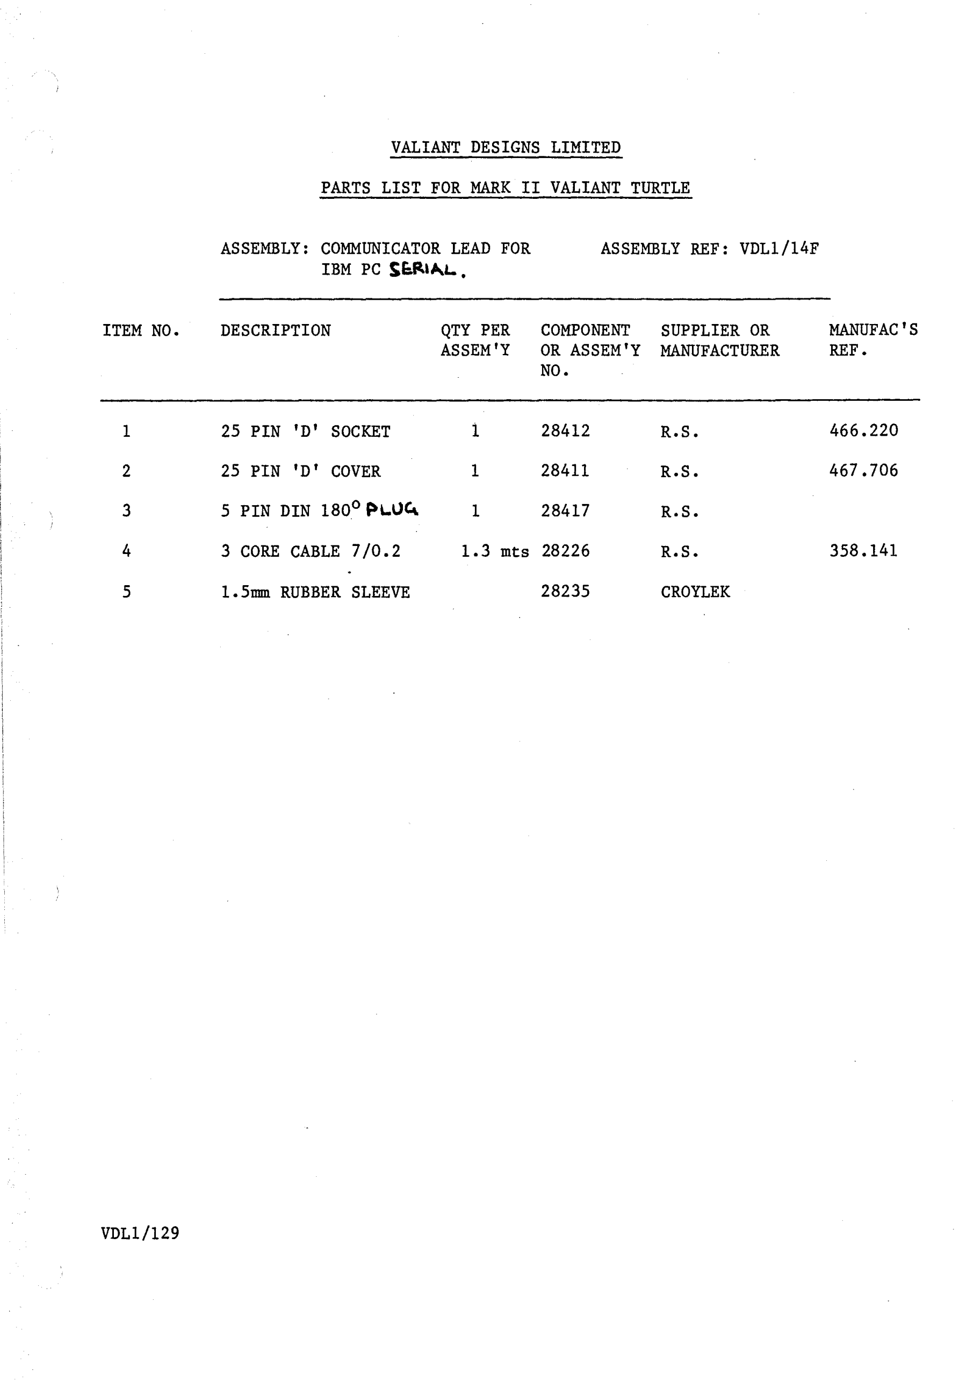
[picture p75: page 43]

ITEM NO.

1

2

3

4

5

VDLl/129

VALIANT DESIGNS LIMITED

PARTS LIST FOR MARK II VALIANT TURTLE

ASSEMBLY: COMMUNICATOR LEAD FOR
IBM PC SEJ1.l,t..L •

ASSEMBLY REF: VDL1/14F

DESCRIPTION

25 PIN 'D' SOCKET

25 PIN 'D' COVER
5 PIN DIN 180° PL.\JC..

3 CORE CABLE 7/0.2

1.5mm RUBBER SLEEVE

QTY PER | COMPONENT | SUPPLIER OR
ASSEM'Y | OR ASSEM'Y MANUFACTURER
| NO.

1

1

1 | 28412
| 28411
| 28417
1. 3 mts 28226
| 28235 | R.S.
| | R.S.
| | R.S.
| | R.S.
| | CROYLEK

MANUFAC'S
REF.

466.220

467.706

358.141

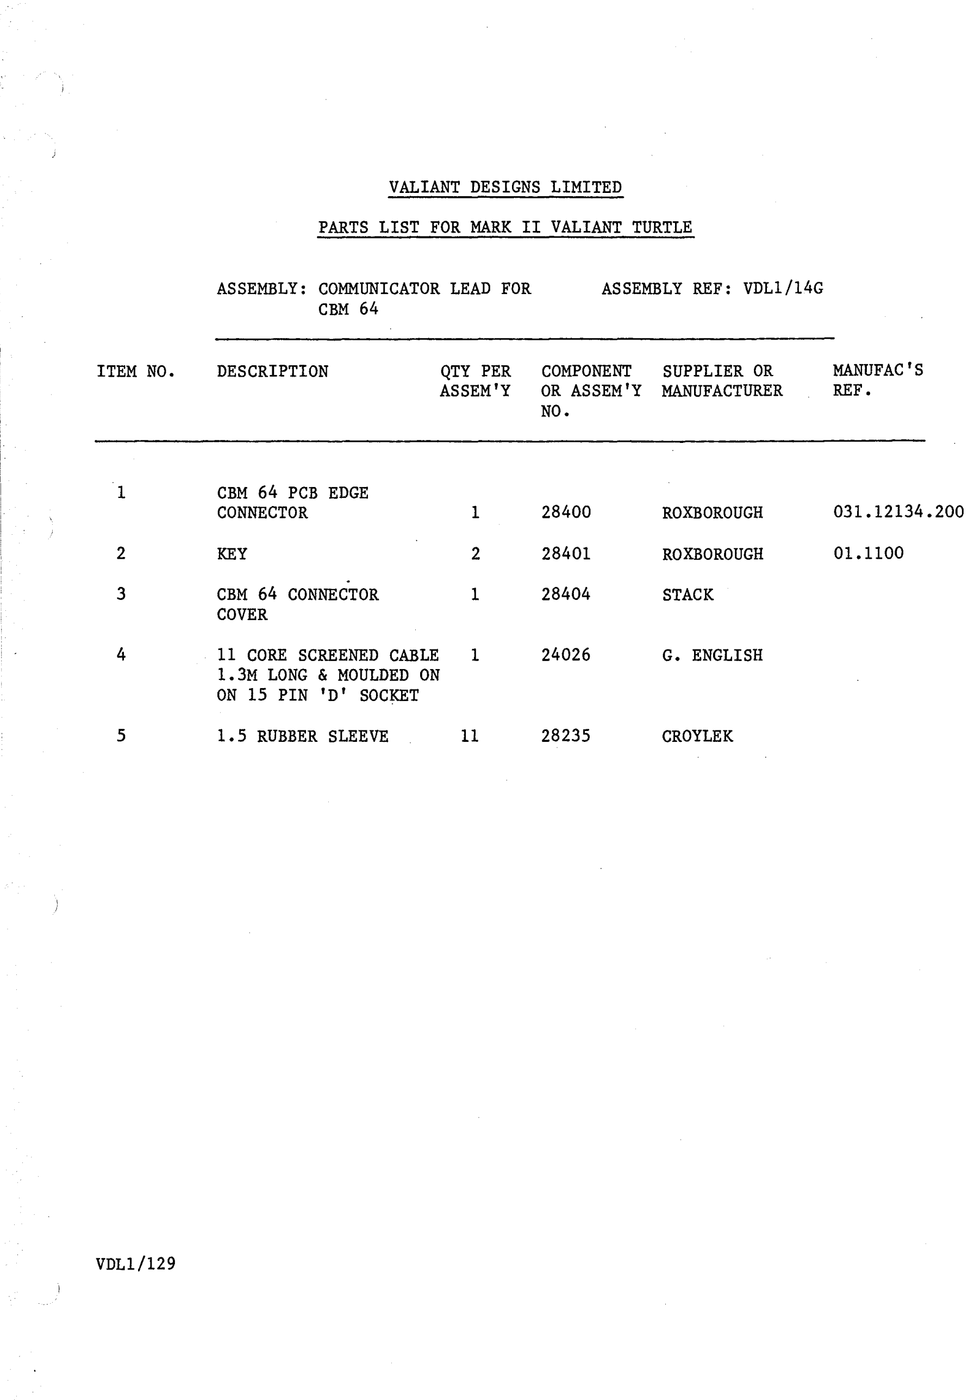
[picture p76: page 44]

ITEM NO.

1

2

3

4

5

VDLl/129

VALIANT DESIGNS LIMITED

PARTS LIST FOR MARK II VALIANT TURTLE

ASSEMBLY: COMMUNICATOR LEAD FOR CBM 64

ASSEMBLY REF: VDL1/14G

DESCRIPTION

CBM 64 PCB EDGE
CONNECTOR

KEY

CBM 64 CONNECTOR
COVER

11 CORE SCREENED CABLE

QTY PER | COMPONENT | SUPPLIER OR
ASSEM'Y | OR ASSEM'Y MANUFACTURER
| NO.
| 1 | 28400 | ROXBOROUGH
| 2 | 28401 | ROXBOROUGH
| 1 | 28404 | STACK
| 1 | 24026 | G. ENGLISH
1.3M LONG & MOULDED ON
ON 15 PIN 'D' SOCKET
1.5 RUBBER SLEEVE | 11 | 28235 | CROYLEK

MANUFAC'S
REF.

031.12134.200

01.1100

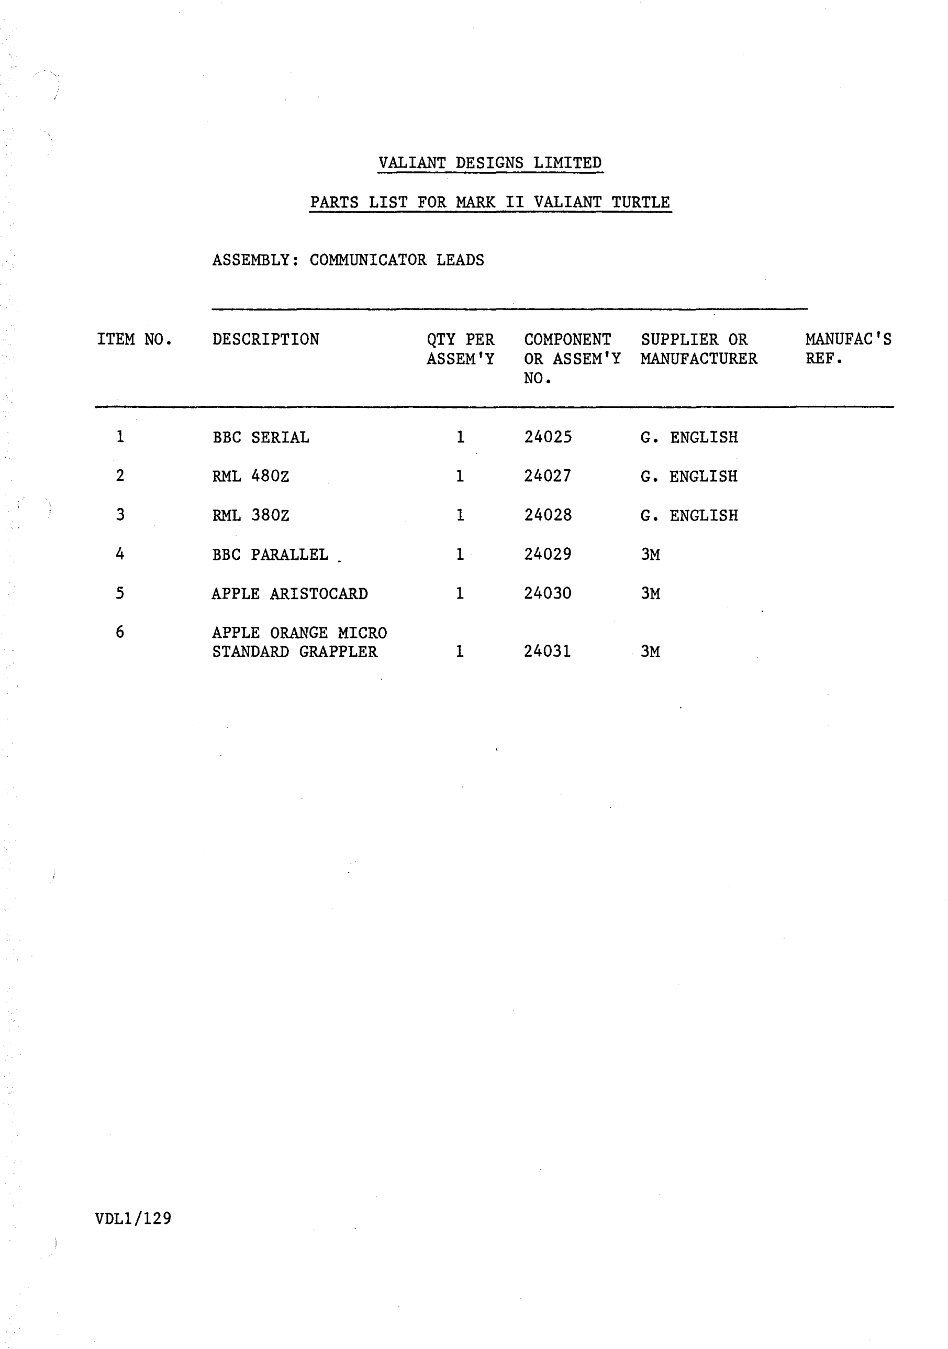
[picture p77: page 45]

VALIANT DESIGNS LIMITED

PARTS LIST FOR MARK II VALIANT TURTLE

ASSEMBLY: COMMUNICATOR LEADS

ITEM NO. | DESCRIPTION | QTY PER | COMPONENT | SUPPLIER OR | MANUFAC'S
ASSEM'Y | OR ASSEM'Y MANUFACTURER | REF.
| | | NO.
1 | BBC SERIAL | 1 | 24025 | G. ENGLISH
2 | RML 480Z | 1 | 24027 | G. ENGLISH
3 | RML 380Z | 1 | 24028 | G. ENGLISH
4 | BBC PARALLEL | 1 | 24029 | 3M
5 | APPLE ARISTOCARD | 1 | 24030 | 3M
6 | APPLE ORANGE MICRO
| STANDARD GRAPPLER | 1 | 24031 | 3M

VDLl/129
