simoninns/valiant-turtle/valiant_docs/leaflets/How to use your Valiant Turtle with the BBC Microcomputer.pdf

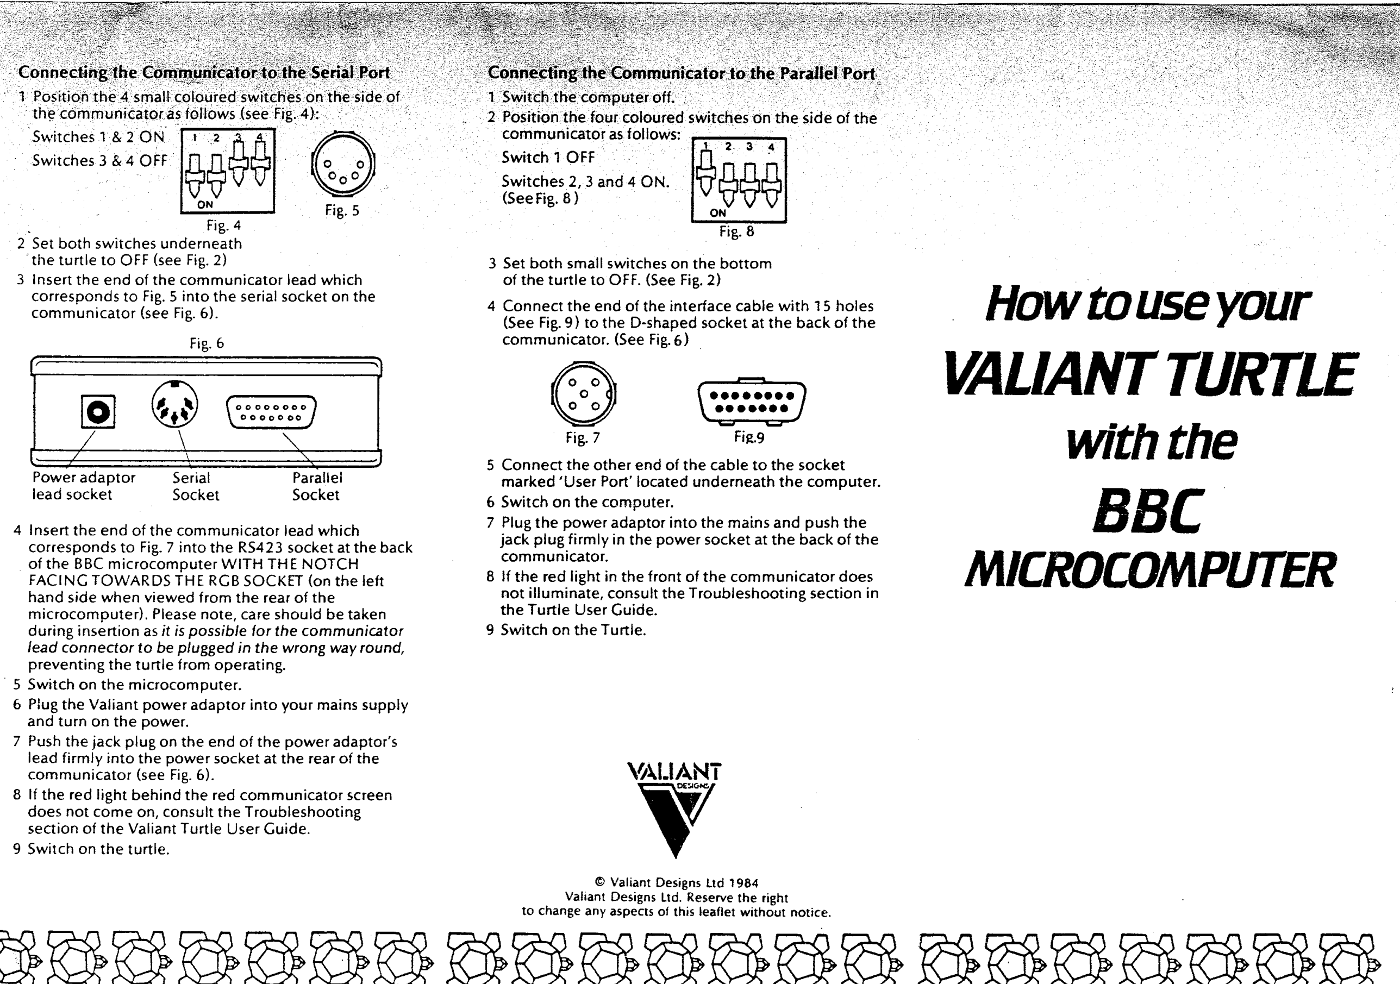
[picture p78: page 1]
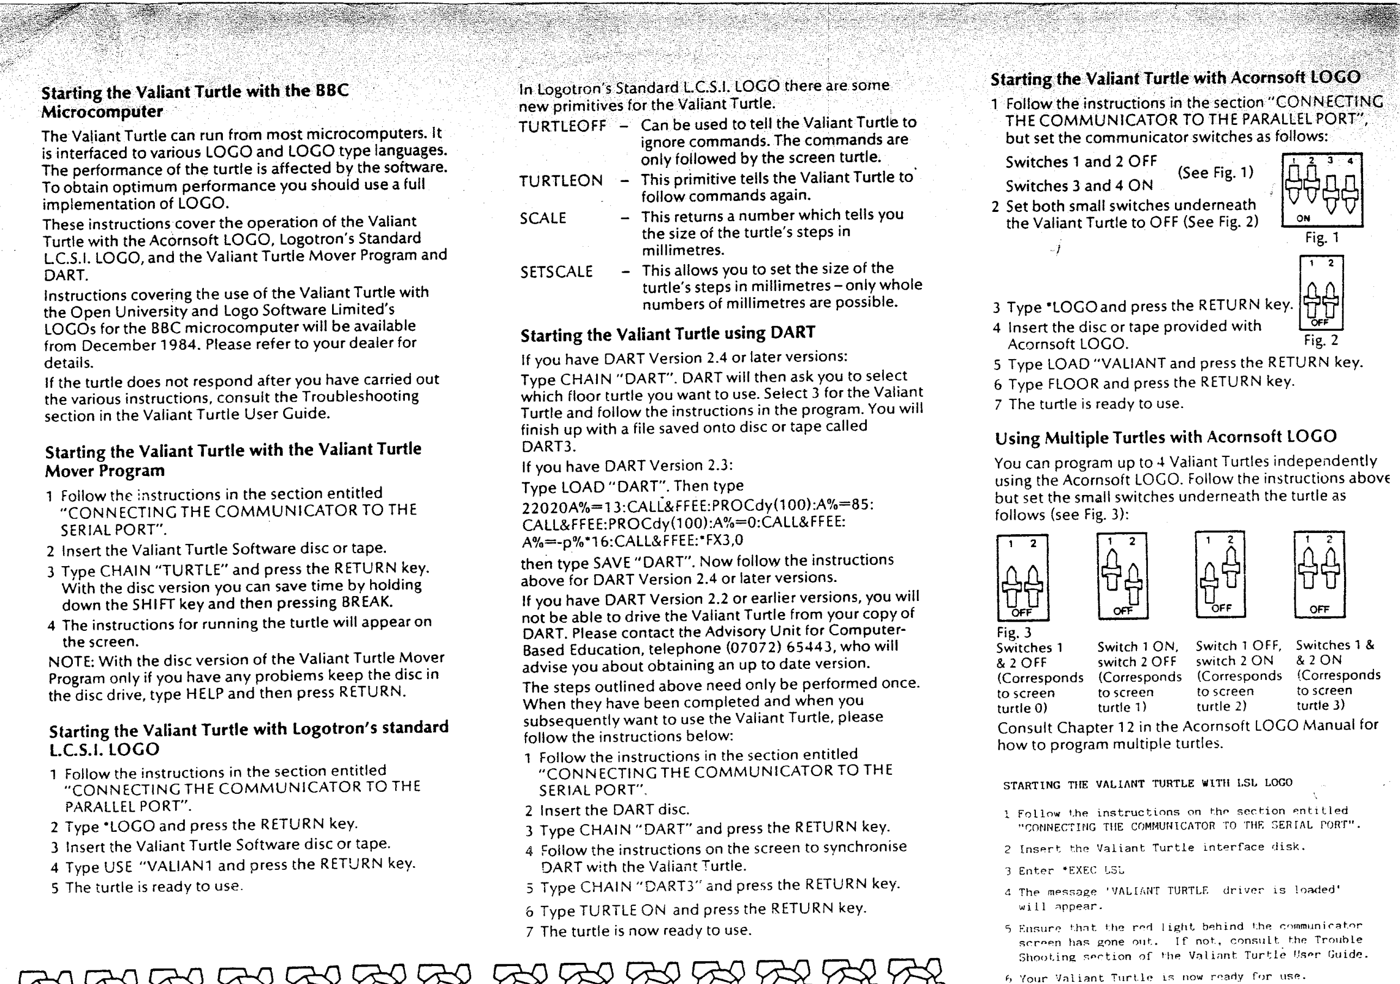
[picture p79: page 2]
