simoninns/valiant-turtle/valiant_docs/service/Valiant - Power Adaptor Test Specification.pdf

\1.1,Ni

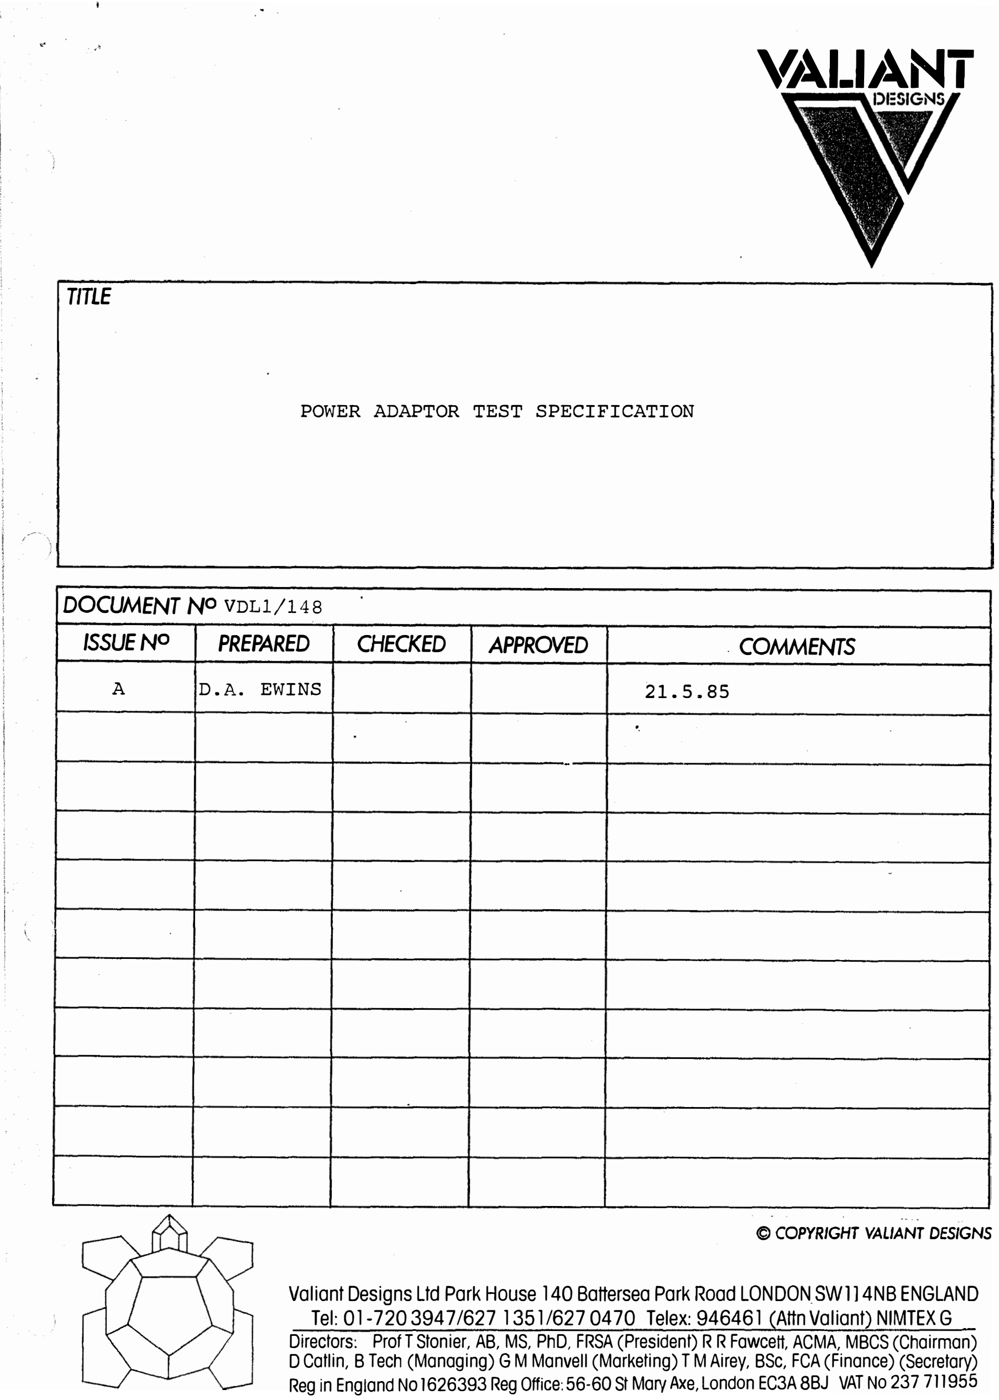
[picture p89: page 1]

TITLE

POWER ADAPTOR TEST SPECIFICATION

DOCUMENT NO VDLl/148

ISSUE NO

A

PREPARED | CHECKED | APPROVED | . COMMENTS
D.A. EWINS | | | 21.5.85

•.

© COPYRIGHT VALIANT DESIGNS

Valiant Designs Ltd Park House 140 Battersea Park Road LONDON SWl l 4NB ENGLAND Tel: 01-720 394 7 /627 1351 /627 04 70 Telex: 946461 (Attn Valiant) NIMTEX G Directors: Prof T Stonier, AB, MS, PhD, FRSA (President) RR Fawcett, ACMA, MBCS (Chairman) D Catlin, B Tech (Managing) GM Manvell (Marketing) TM Airey, BSc, FCA (Finance) (Secretary) Reg in England No 1626393 Reg Office: 56-60 St Mary Axe, London EC3A 8BJ VAT No 237 711955

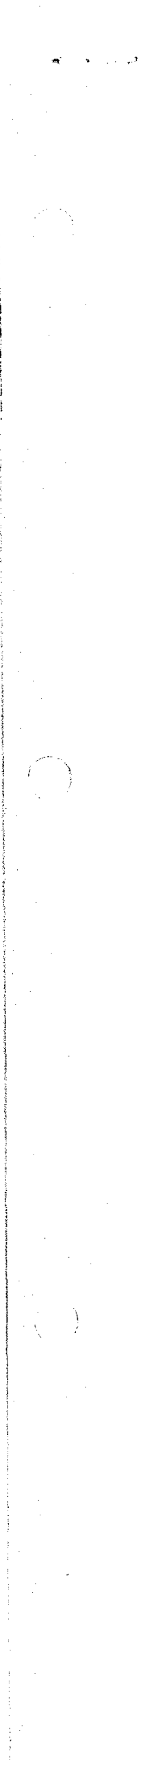
[picture p90: figure]

POWER ADAPTOR TEST SPECIFICATION: VDLl/148

The following parameters define the output requirements in order to assess the integrity of the power adaptor. It is assumed that the input mains voltage is applied according to its nominal rating.
The output levels should be as follows:

*

Recommended No Load output nominally 26VDC

*
Recommended output with 139ohm Load nominally 23VDC

*
Recommended output with 39ohm Load nominally 19VDC

Notes: A tolerance + of -0.SV is normal, although manufacturing spreads may take this up to + -lV.

However, faulty units normally show a gross discrepency from the nominal value.
All output levels are DC measurements with the power jack centre pole positive.
The units are sealed at manufacture and are not repairable.
