simoninns/valiant-turtle/valiant_docs/service/Valiant - Test Specification for MK IV Turtle Controller Board.pdf

# ·· TURTLE PROJECT

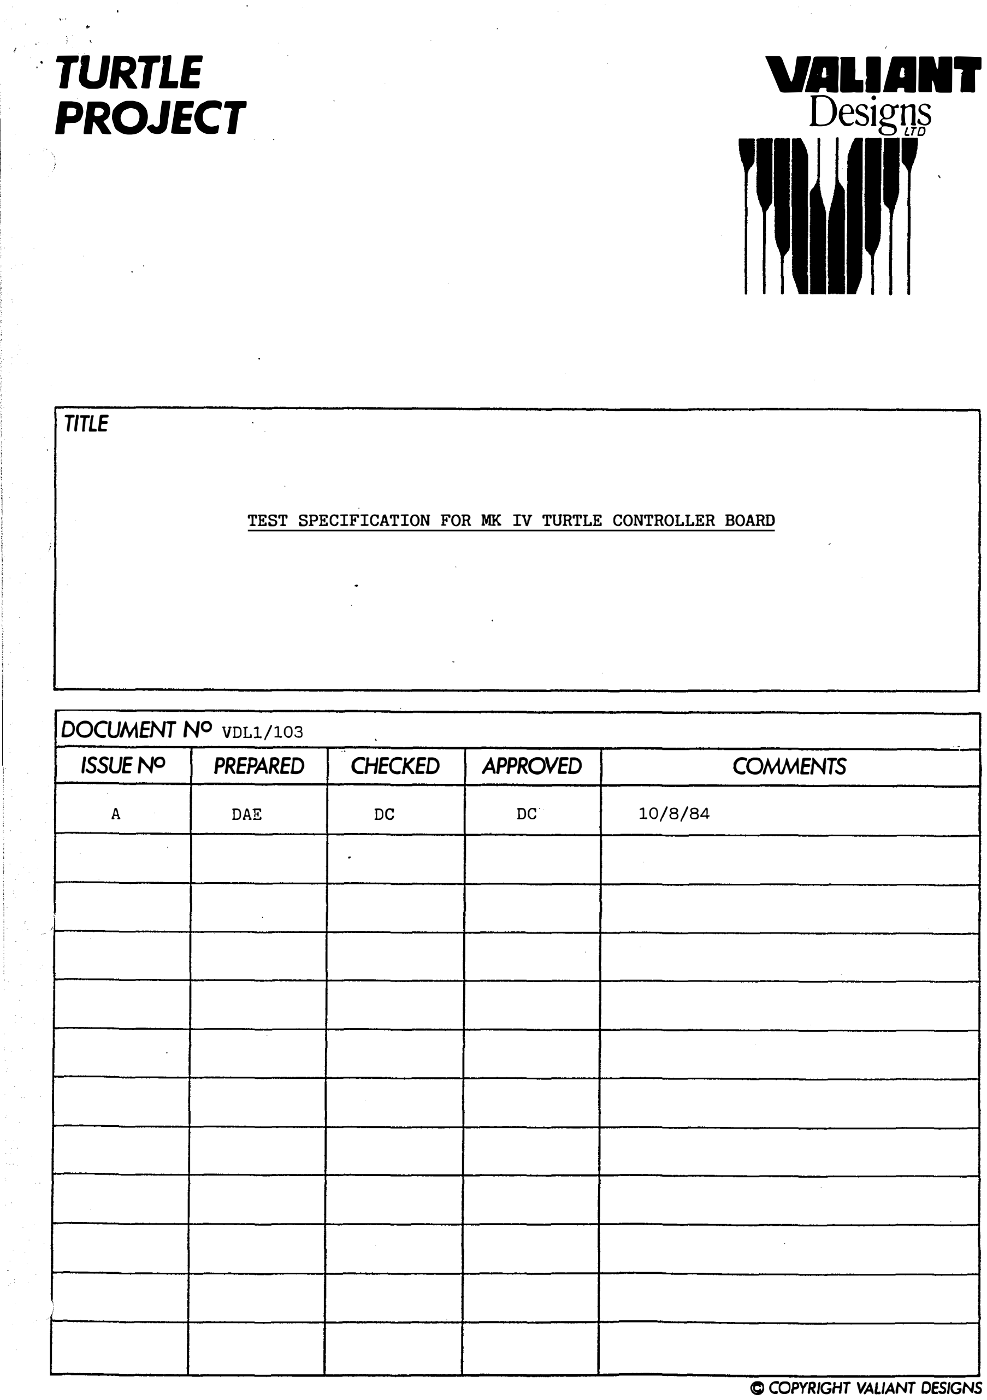
[picture p124: page 1]

TITLE

# v,a11,aNT Desigg

TEST SPECIFICATION FOR MK IV TURTLE CONTROLLER BOARD

DOCUMENT NO VDLl/103

ISSUE NO | PREPARED | CHECKED | APPROVED | COMMENTS
A | DAE | DC | DC | 10/8/84

C COPYRIGHT VALIANT DESIGNS

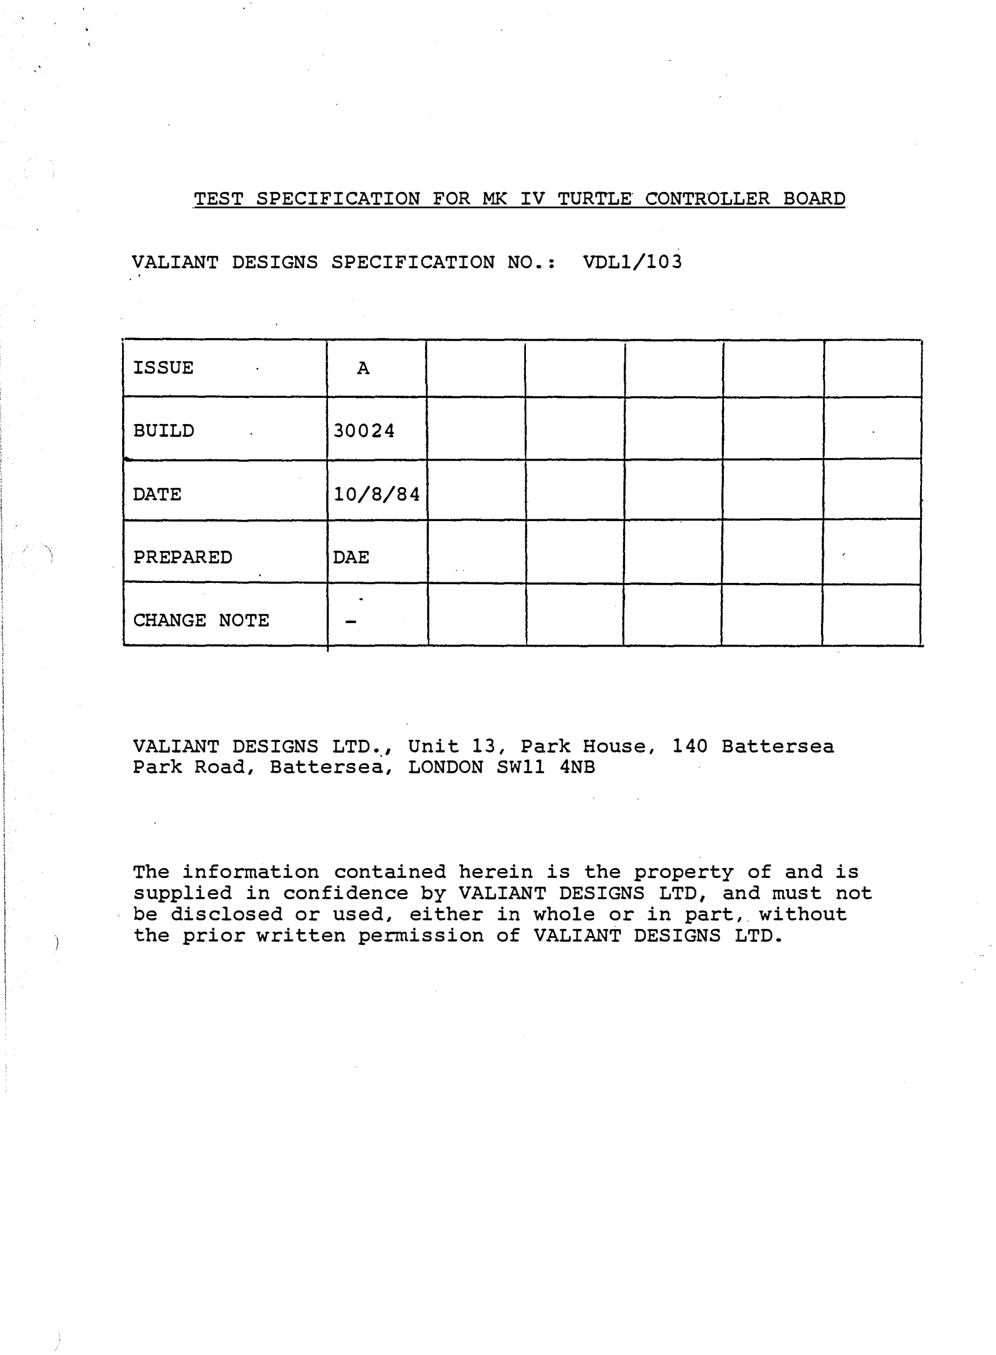
[picture p125: page 2]

### TEST SPECIFICATION FOR MK IV TURTLE. CONTROLLER BOARD

VALIANT DESIGNS SPECIFICATION NO.: | VDLl/103
ISSUE | A
BUILD | 30024
DATE | 10/8/84
PREPARED | DAE
CHANGE NOTE | -

### VALIANT DESIGNS LTD., Unit 13, Park House, 140 Battersea Park Road, Battersea, LONDON SWll 4NB

### The information contained herein is the property of and is supplied in confidence by VALIANT DESIGNS LTD, and must not be disclosed or used, either in whole or in part, without

the prior written permission of VALIANT DESIGNS LTD.

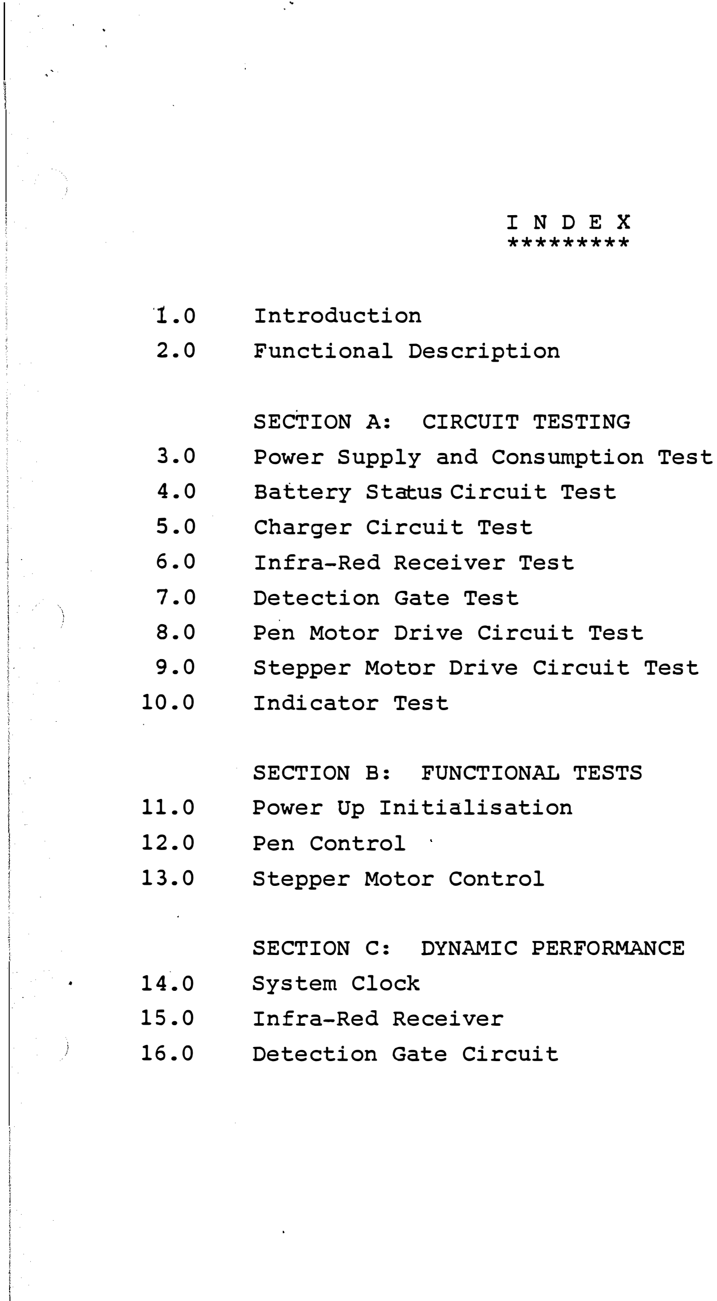
[picture p126: figure]
Introduction; Functional Description; SECTION A:; CIRCUIT TESTING; Power Supply and Consumption Test; Battery Status Circuit Test; Charger Circuit Test; Infra-Red Receiver Test; Detection Gate Test Pen Motor Drive Circuit Test; Stepper Motor Drive Circuit Test; Indicator Test; SECTION B:; FUNCTIONAL TESTS; Power Up Initialisation; Pen Control; Stepper Motor Control; SECTION C:; DYNAMIC PERFORMANCE; System Clock; Infra-Red Receiver; Detection Gate Circuit

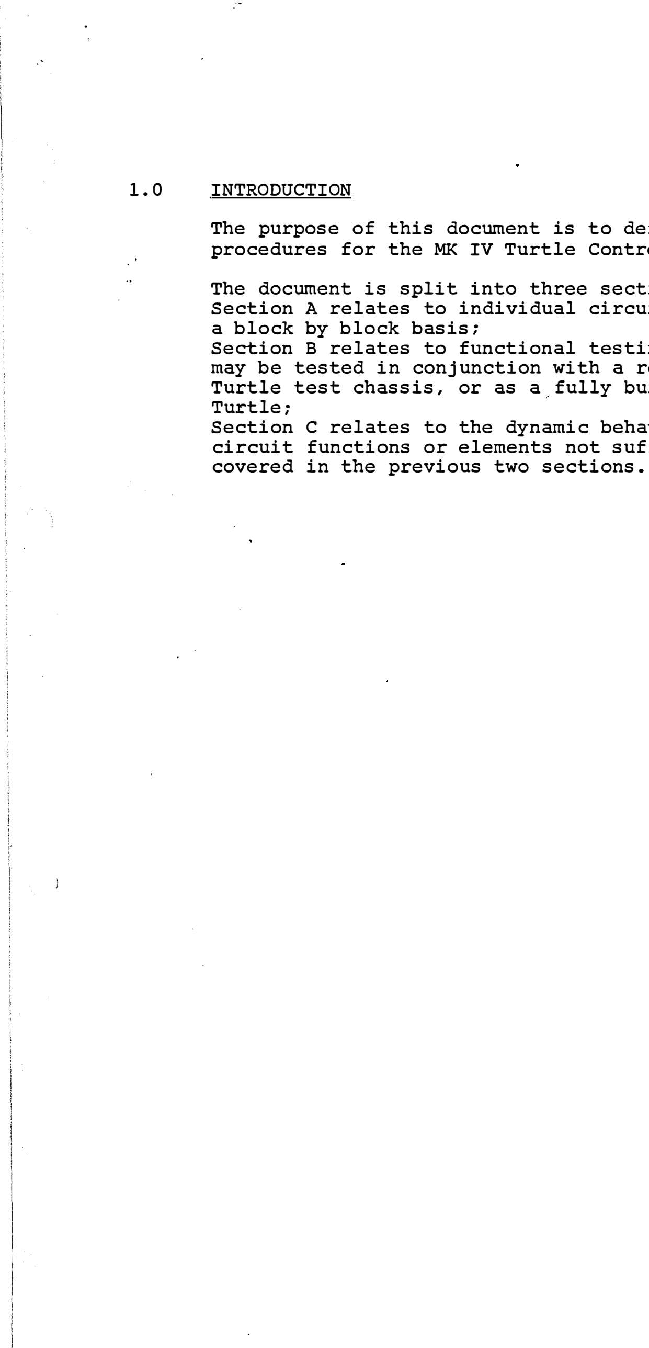
[picture p127: figure]
1.0 INTRODUCTION; a block by block basis;; Turtle;; covered in the previous two sections.

The purpose of this document is to define the test procedures for the MI< IV Turtle Controller Board.

The document is split into three sections - A,B, and C: Section A relates to individual circuit testing on

Section B relates to functional testing, where the board may be tested in conjunction with a representative Turtle test chassis, or as a fully built production

Section C relates to the dynamic behaviour of those circuit functions or elements not sufficiently

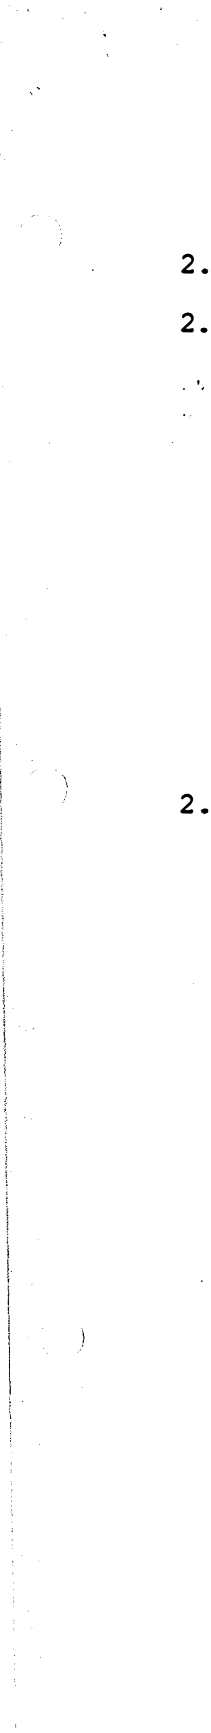
[picture p128: figure]

2.0

2.1

FUNCTIONAL DESCRIPTION

Turtle Robot

The Turtle Robot is a remotely controlled educational instrument which performs as a perfect slave to commands transmitted from the Host Computer System.

The.unit receives commands via an infra-red link, and, following decoding, will activate its stepper motors, as appropriate, to provide unit motion, or its pen motor to either lift or lower a pen in order to provide drawing control.

The unit is powered via a nicad battery pack and fast charge facility is provided in order to minimise down time.

2.2 Turtle Controller Board

The Turtle Controller board provides all of the circuitry necessary to facilitate the functions described in
2.1 above.
Figure 1 is a block schematic of the board showing the major constituent parts and inter-connections.

The charge controller is used only during battery charging and is powered only during this mode - selected by the Turtle three position power switch. The circuit permits unit fast charging until such time as the on-board monitoring circuitry detects a charged stack status, causing reversion to a slow charge condition, which may be maintained indefinitely.
The charger supply is the same power unit as used to power the Communicator.

The Infra-Red Receiver performs the task of I.R. detection and amplification in order that the signal be digitised prior to input to the Detection Gate.

The Detection Gate 'opens' under microcomputer control at specific times in order to search and store infra-red detections. At the end of the gating period, the microcomputer reads the status of the circuit and then resets it in readiness for the next detection period.

The microcomputer reads and decodes the input I.R. command read from the Detection Gate and powers the Pen Motor or Stepper Motor drive circuits accordingly.

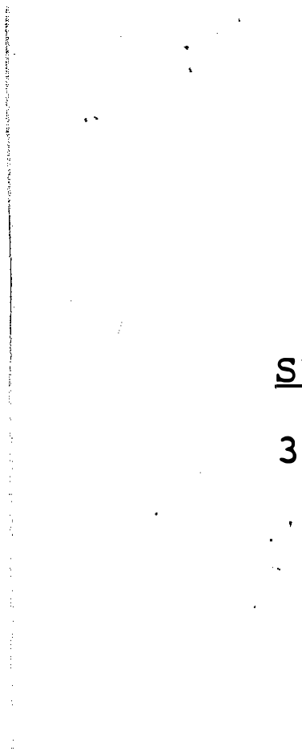
[picture p129: figure]

SECTION A: | CIRCUIT TESTS
3.0 | POWER SUPPLY AND CONSUMPTION TEST
Special Note: | Power supply application should be
implemented on a short duration power application basis in order to prevent component burn up. Special consideration must be attributed to the Pen Motor
Drive Circuit which is toleranced for
short drive durations (of order of 1 second}.

3.1 Short ICS Pins 1,2,3,4 to OV in order to disable Pen Motor Drive Circuits.

3.2 Apply 12 Volts D.C. ! 0.1 between PL2/6 (positive} and PL2/2 with current limit set to 200mA.

3.3 Confirm that current consumption lies between 60mA and 140mA.

3.4 Confirm that voltage between ICl Pin 40 and main ground plane is +SV +0.25V.

3.5 Confirm that voltage between PSR2 output terminal and main ground plane is 6V +0.4V.

3.6 Confirm that voltage at R6/R22 node with respect to main ground plane is T.B.A.

3.7 Turn off supply - end of test.

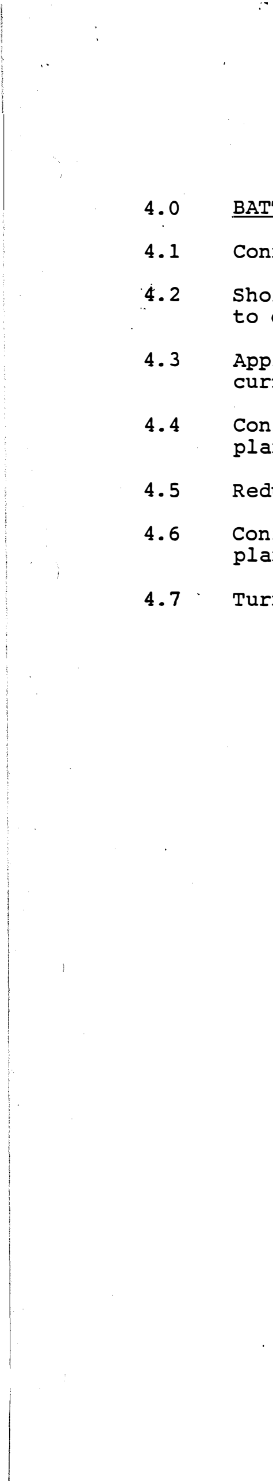
[picture p130: figure]

## BATTERY STATUS CIRCUIT TEST

Connect PL3/2 to PL3/l.

## Short ICS Pins 1,2,3,4 to OV ground plane in order

to disable the Pen Motor Drive Circuits.

## Apply +12V between PL2/6 (positive) and PL2/2 with

current limit set to 200mA.

## Confirm that the voltage at IC8 Pin 7 w.r.t. ground

plane is less than 0.4 Volts.
+ Reduce supply to 10 Volts - 0.1 Volts.

## Confirm that the voltage at IC8 Pin 7 w.r.t. ground

plane is 10 Volts 0.1 Volts.

Turn off supply volts.

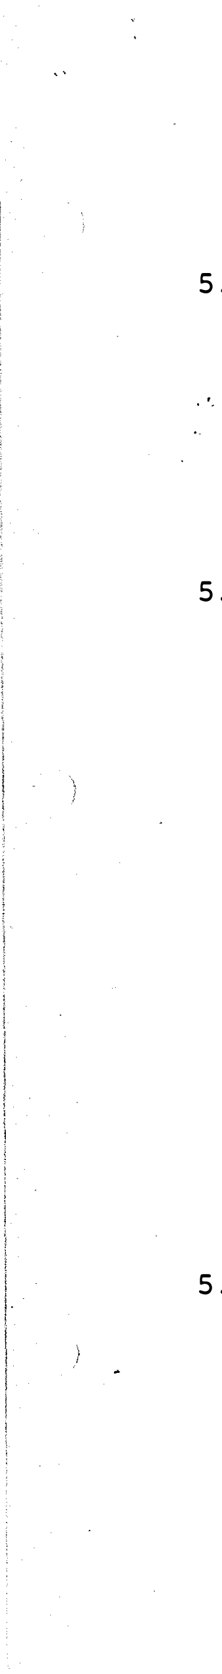
[picture p131: figure]

5.0 | CHARGER CIRCUIT TEST
Special Note: | To enable testing of this circuit,

### constant voltage source of 12V with current sink capability of up to 0.7 Amp is required in order to

simulate the Turtle battery pack.

### Refer to Figure 2 for details of

wiring inter-connection.

### 5.1 Unloaded Charger Circuit Test

5.2

Apply short circuit between PL2/4 and PL2/3.

### Apply 12.0 0.1 Volts between PL2/5 (positive)

and PL2/2 with current limit set to 25mA.

### Confirm that the voltage at IC7 Pin 2 w.r.t. OV

ground plane is 5.5V + 0.5V.

### Confirm that the voltage at IC7 Pin 1 w.r.t. OV

is less than 1 Volt.

Open circuit connection between PL2/4 and PL2/3.

### Confirm that the voltage at IC7 Pin 2 w.r.t. OV

is between 0.5 Volts and 0.7 Volts.

### Confirm that the voltage at IC7 Pin 1 is greater

than 10 Volts.

### Confirm that the voltage at IC7 Pin 3 is

12.0 + 0.1 Volts.
Turn off supply and disconnect.

### Loaded Charger Circuit Test

5.2.1 Short PL2/4 to PL2/3.

### 5.2.2 Connect 12V voltage source/sink between PL2/5

(positive) and PL2/2.

### 5.2.3 Connect 17V D.C. source (output capability 0.7 Amp max.) between PL2/1 (positive) via limiter

resistor 5R6 4W and PL2/2 (Refer to Figure 2).

### 5.2.4 Confirm that the current dump out of terminal

PL2/5 is 0.5 Amp 0.1 Amp.
5.2.5 Open circuit PL2/3 from PL2/4.

### 5.2.6 Confirm that the current dump out of terminal

PL2/5 is 60rnA + 20mA.

### 5.2.7 Turn off supply and disconnect voltage source -

end of test.

6.0 | INFRA-RED RECEIVER TEST
| Special Note: The following test assumes the availability of an I.R. Reference source producing two levels of infra-red radiation at the detection diodes mounted on the board under test.
6 .1 | D. c·. Measurements

6.2

6.3

## 6.1.1 Short IC5 Pins 1,2,3,4 to OV ground plane in

order to disable the Pen Motor Drive Circuit.

## 6.1.2 Apply 12.0 0.1 Volts between PL2/6 (positive)

and PL2/2 with current limit set to 200rnA.

## 6.1.3 With the infra-red source turned off, confirm that the voltage w.r.t. OV ground plane at

IC8 Pin 2 is between 2.0 and 3.1 Volts.

## 6.1.4 Confirm that the voltage at IC8 Pin 3 is 0.955 + 2% of the voltage measured in 6.1.3 6.1.5 Confirm that the noise level at IC8 Pin 2 is

between 80mV pk-pk and 120mV pk-pk (2 a- level). 6.1.6 Confirm that the output at IC8 Pin 1 is logic '0'.

## Non-Saturating Receiver Test

6.2.1 With circuit board already powered from 6.1,

## turn on I.R. Reference Source and set to low

level output position.

## 6.2.2 Confirm that negative 5 microsecond duration + lOOmV are present at

Figure 4 Trace 4).

going pulses of approx.

## and arnplitide of 500 IC8 Pin 2 (Refer to

## 6.2.3 Confirm that positive going pulses of 5 microsecond

duration are output from IC8 Pin 1.

## Saturating Receiver Test

6.3.1 With circuit board already powered and I.R.

## Reference Source on, set I.R. Reference output

level to high.

## 6.3.2 Confirm that the voltage at IC8 Pin 3 has reduced to less than 1.5V w.r.t. ground plane

potential.

## 6.3.3 Test completed - turn off I.R. Reference Source

and turn off power to board.

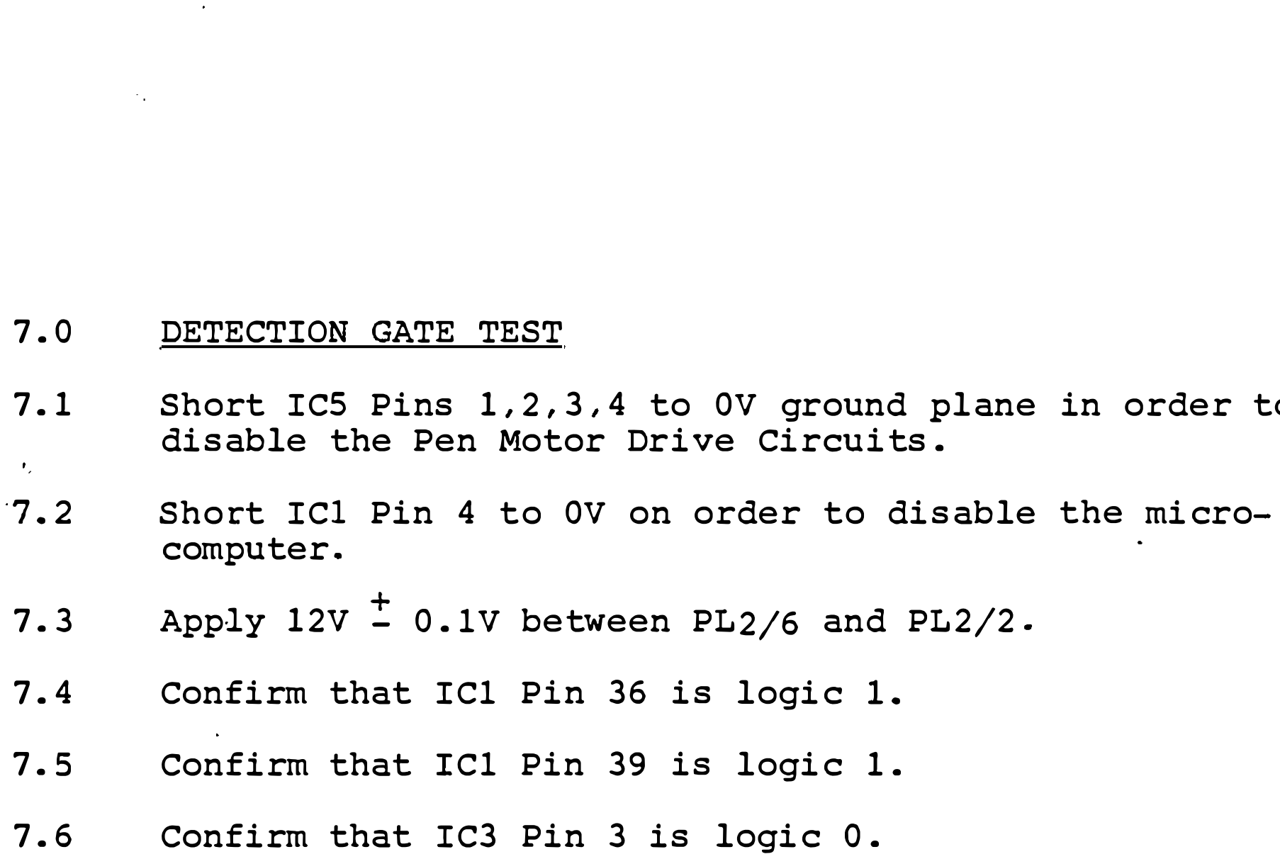
[picture p132: figure]
DETECTION GATE TEST; disable the Pen Motor Drive Circuits.; Short ICl Pin 4 computer.; Apply 12V + - O.lV; Confirm that ICl; Confirm that !Cl; Confirm that IC3; to OV on order to disable; between PL2/6 and PL2/2.; Pin 36 is logic 1.; Pin 39 is logic 1.; Pin 3 is logic 0.; the micro-

7.1 | Short ICS Pins 1,2,3,4 to OV ground plane in order to
7.7 | Set !Cl Pin 36 to logic O.
7.8 | Apply momentary short across RSS in order to generate a positive going TTL pulse at IC3 Pin 3.
7.9 | Confirm that IC! Pin 39 is logic O.
7.10 | Set ICl Pin 36 to logic 1.
7.11 | Confirm that ICl Pin 39 is logic 1.
7.12 | Remove power - end of test.

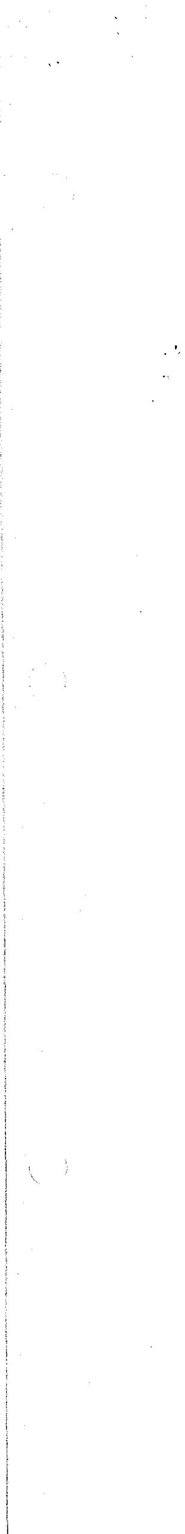
[picture p133: figure]

The Pen Motor Drive Circuit provides the power amplification and bi-directional drive output required to rotate the pen motor in either direction in order to achieve the 'pen lift' or 'pen lower' operations.

The Stepper Motor Drive Circuits provide the power amplification and drive outputs required to function the port and starboard stepper motors.

The Indicator Led provides a function similar to its equivalent on the Communicator Board, by essentially providing the user with a means of assessing certain operational states.

The Battery Status Circuit provides the function of continuously monitoring the charge state of the battery stack. It provides an output drive which illuminates the Turtle Eyes, mounted at the 'head' of the unit, extinguishing these only when the level of charge approaches a discharged state.

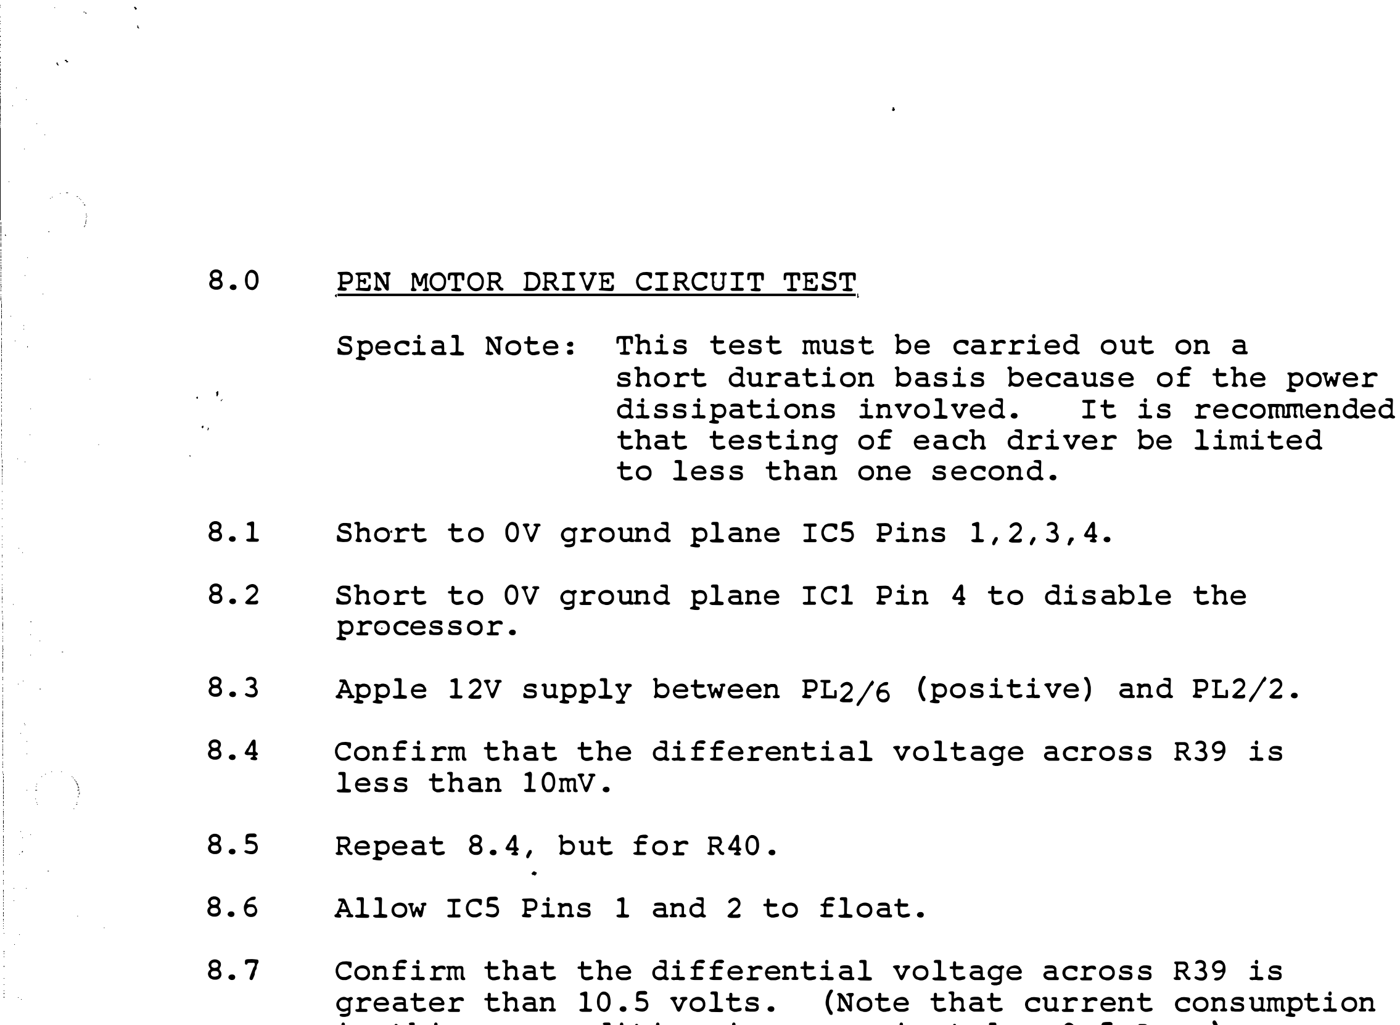
[picture p134: figure]
PEN MOTOR DRIVE CIRCUIT TEST; dissipations involved.; It is recommended; that testing of each driver be limited to less than one second.; processor.; less than lOmV.; Repeat 8.4, but for R40.; Allow IC5 Pins 1 and 2 to float.; greater than 10.5 volts.; (Note that current consumption

Special Note: | This test must be carried out on a short duration basis because of the power
8. 1 | Sho·rt to OV ground plane IC5 Pins 1, 2, 3, 4.
8.2 | Short to OV ground plane ICl Pin 4 to disable the
8.3 | Apple 12V supply between PL2/6 (positive) and PL2/2.
8.4 | Confirm that the differential voltage across R39 is
8.7 | Confirm that the differential voltage across R39 is
| in this on-condition is approximateley 0.5 Amps).
8.8 | Short IC5 Pins 1 and 2 to OV.
8.9 | Allow IC5 Pins 3 and 4 to float.
8.10 | Confirm that the differential voltage across R40 is greater than 10.5 volts.
8.11 | Short IC5 Pins 3 and 4 to OV.
8.12 | Remove power from board.

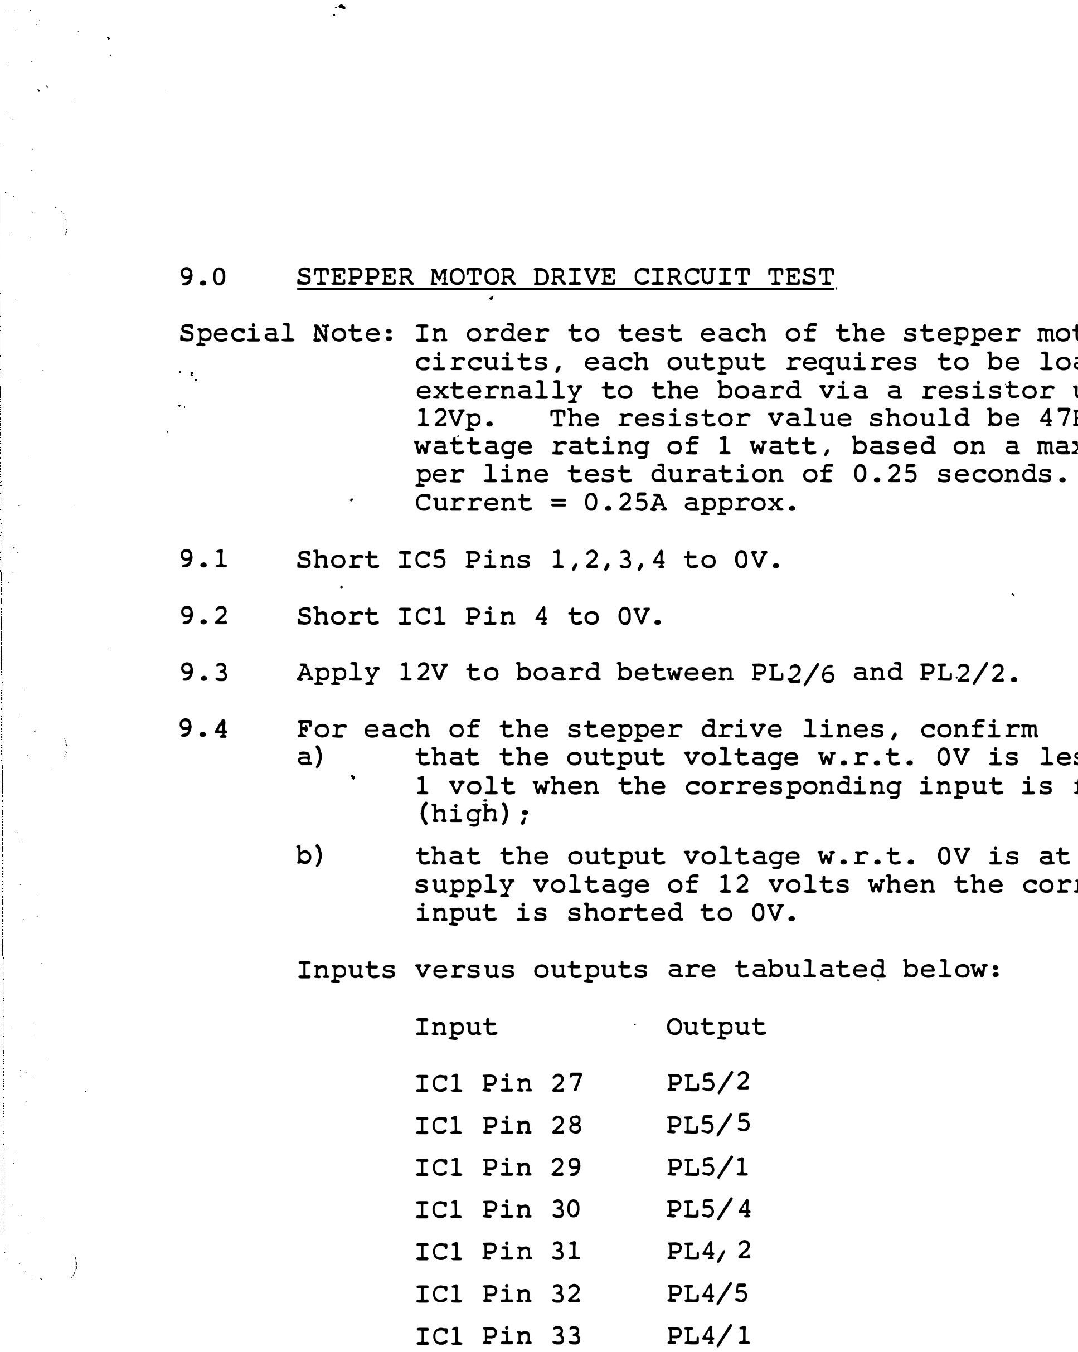
[picture p135: figure]
STEPPER MOTOR DRIVE CIRCUIT TEST; per line test duration of 0.25 seconds. Current = 0.25A approx.; Short ICS Pins 1,2,3,4 to OV.; Short ICl Pin 4 to OV.; (high) ;; input is shorted to OV.; Input; Output; ICl Pin 27; PLS/2; ICl Pin 28; PLS/5; ICl Pin 29; PLS/1; ICl Pin 30; PLS/4; IC! Pin 31; IC! Pin 32; IC! Pin 33

Special Note: In order to test each of the stepper motor drive circuits, each output requires to be loaded externally to the board via a resistor up to 12Vp. The resistor value should be 47R and wattage rating of 1 watt, based on a maximum

9.3 | Apply 12V to board between PL2/6 and PL.2/2.
9.4 | For each of the stepper drive lines, confirm
a) that the output voltage w.r.t. OV is less than
| 1 volt when the corresponding input is floating
b) that the output voltage w.r.t. OV is at the
| supply voltage of 12 volts when the corresponding
| Inputs versus outputs are tabulateq. below:
IC! Pin 34 | PL4/4

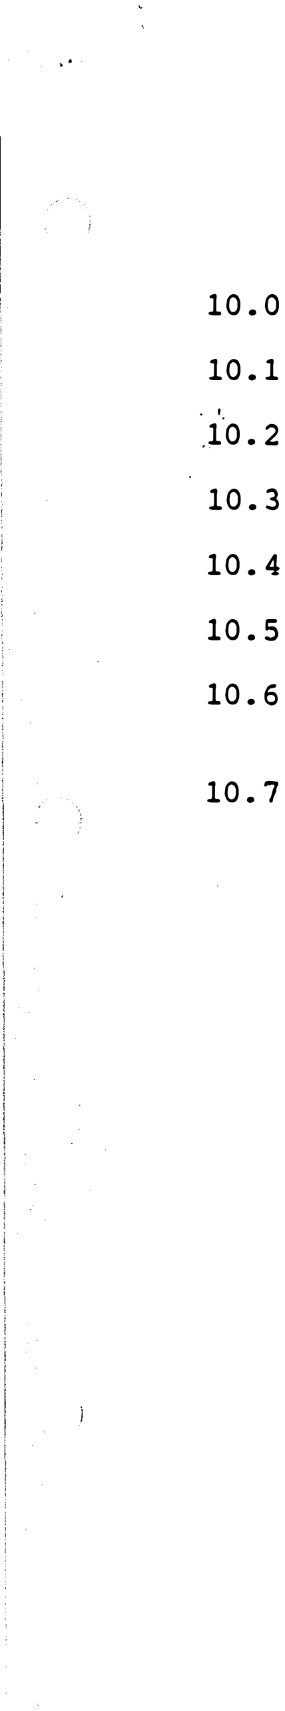
[picture p136: figure]

INDICATOR TEST

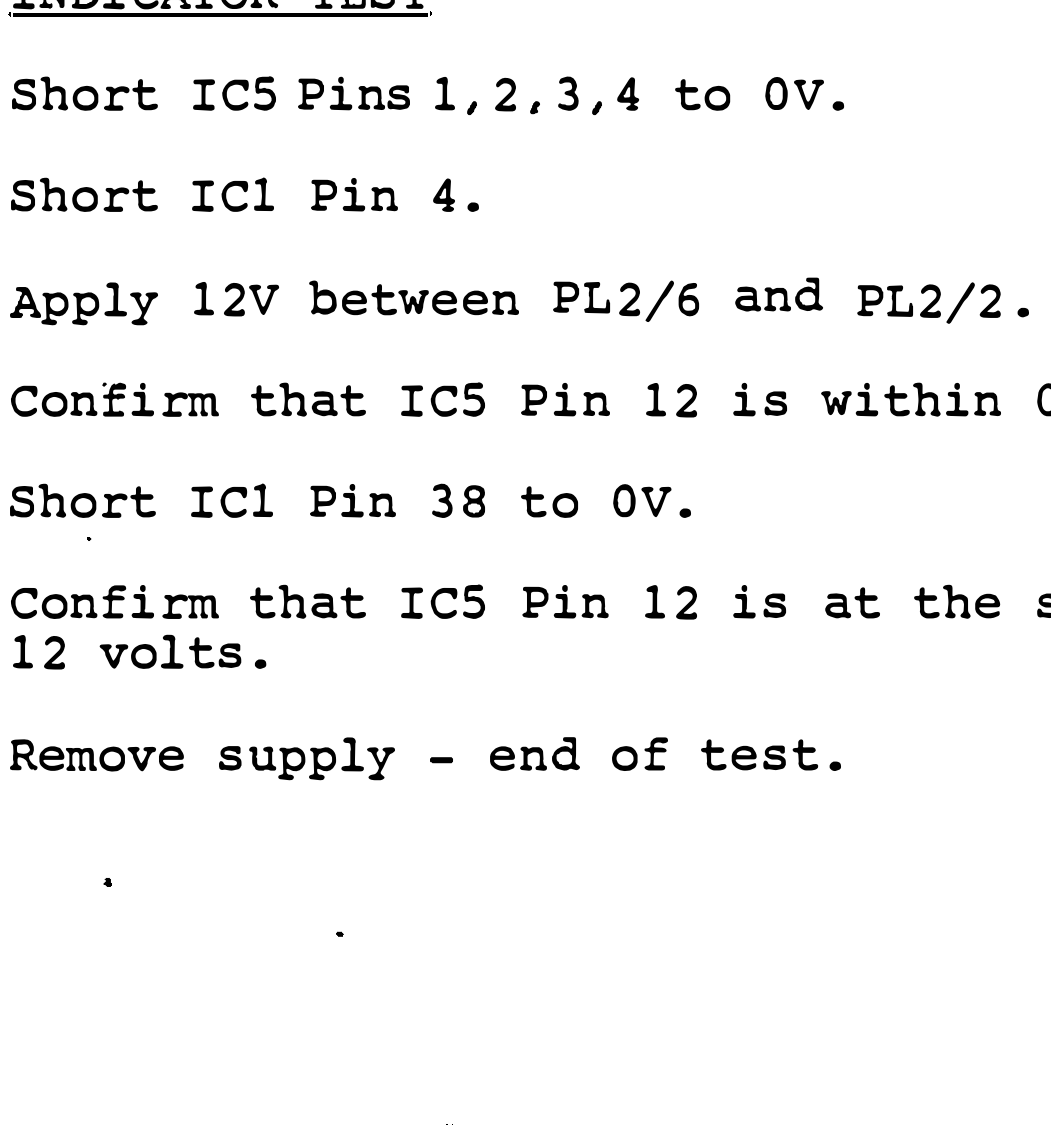
[picture p137: figure]
Short ICS Pins 1, 2, 3, 4 to OV.; Short IC! Pin 4.; Apply 12V between PL2/6 and PL2/2.; Short IC! Pin 38 to OV.; 12 volts.; Remove supply - end of test.

Confirm that ICS Pin 12 is within 0.4 volts of OV.

Confirm that ICS Pin 12 is at the supply level of

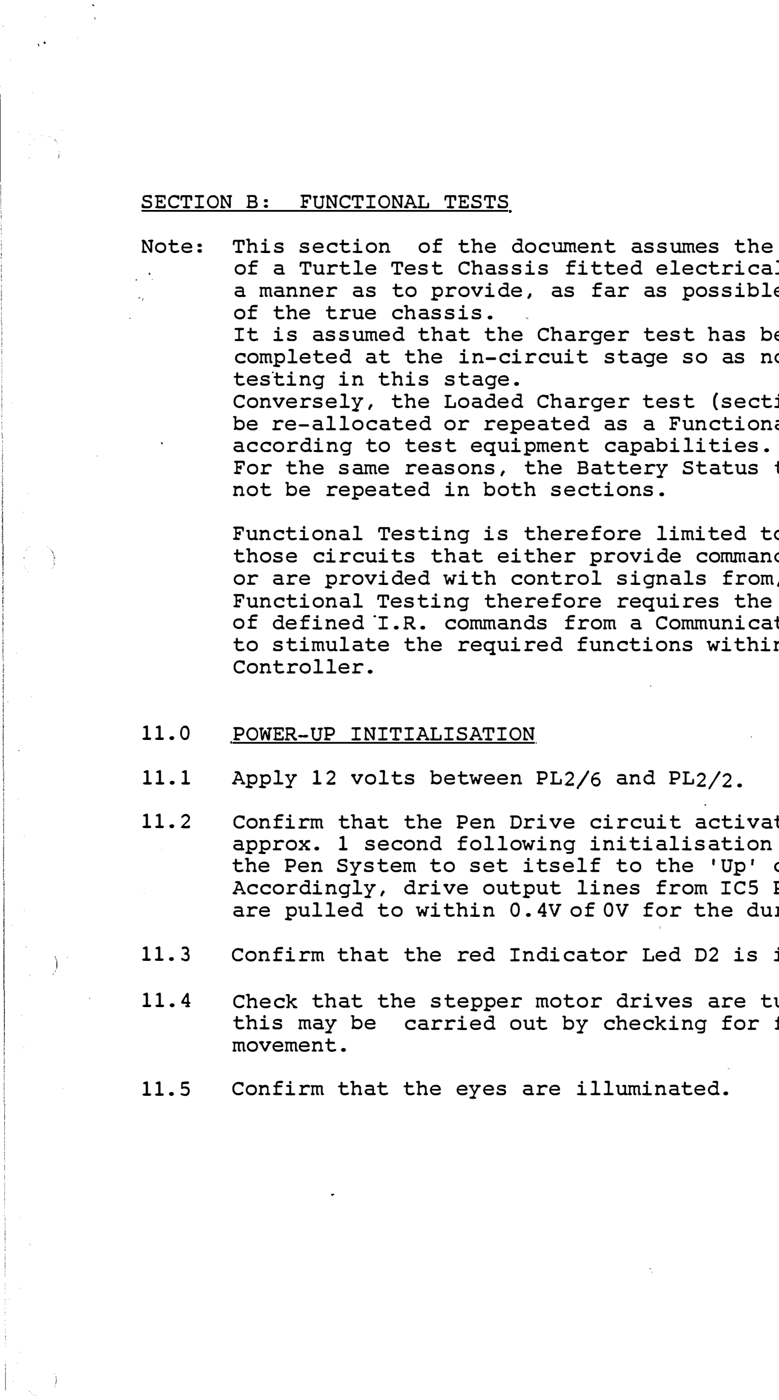
[picture p138: figure]
SECTION B:; FUNCTIONAL TESTS; of the true chassis.; testing in this stage.; according to test equipment capabilities.; not be repeated in both sections.; Controller.; POWER-UP INITIALISATION; Apply 12 volts between PL2/6 and PL2/2.; movement.; Confirm that the eyes are illuminated.

Note: | This section | of the document assumes the availability
of a Turtle Test Chassis fitted electrically in such
a manner as to provide, as far as possible, a simulation

It is assumed that the Charger test has been sufficiently completed at the in-circuit stage so as not to require

Conversely, the Loaded Charger test (section 5.2) may be re-allocated or repeated as a Functional Test

For the same reasons, the Battery Status test need

Functional Testing is therefore limited to testing
those circuits that either provide command signals to,
or are provided with control signals from, the microcomputer. Functional Testing therefore requires the transmission
of defined ·I.R. commands from a Communicator in order
to stimulate the required functions within the Turtle

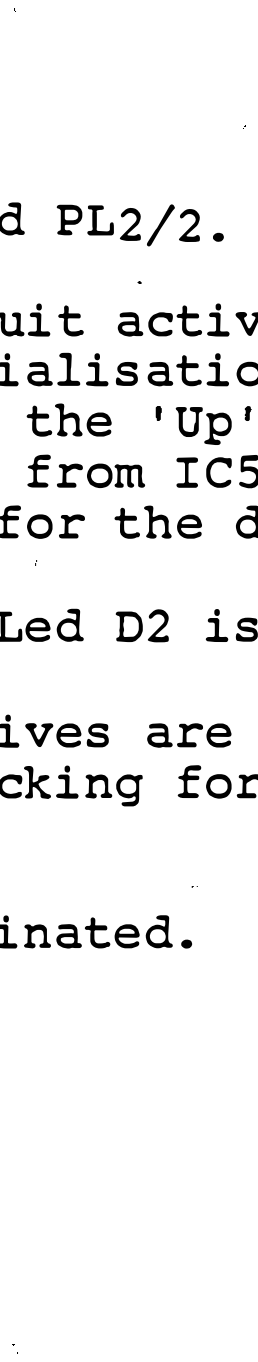
[picture p139: figure]

Confirm that the Pen Drive circuit activates for approx. 1 second following initialisation and causes the Pen System to set itself to the 'Up' condition. Accordingly, drive output lines from IC5 Pins 14 and 15 are pulled to within 0.4Vof 0V for the duration.

Confirm that the red Indicator Led D2 is illuminated.

Check that the stepper motor drives are turned off: this may be carried out by checking for free wheel

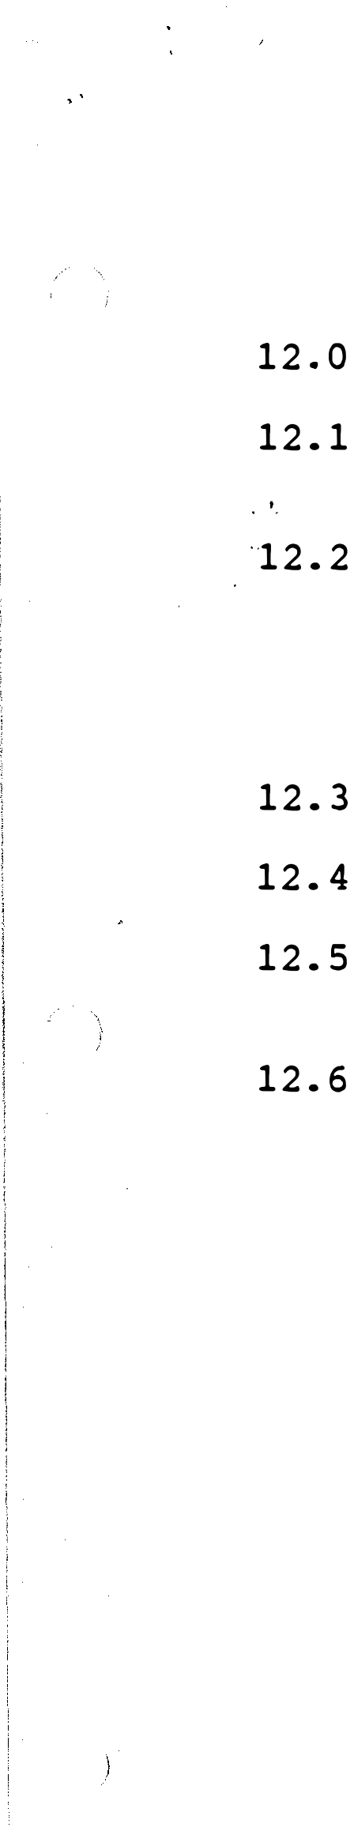
[picture p140: figure]

PEN CONTROL

Output the command code lOH from the Host Computer connected to the Communicator.

Confirm that the Pen Motor Circuit activates for approx. 1 second in such a manner as to cause the Pen to move to the 'DOWN' position: accordingly, drive output lines ICS Pins 13 and 16 are pulled to within 0.4V of OV for the duration.

Confirm that D2 is turned out.

Output code OOH from the Host System.

Confirm that the pen state reverts again to the 'UP' position.

Confirm that D2 is turned on.

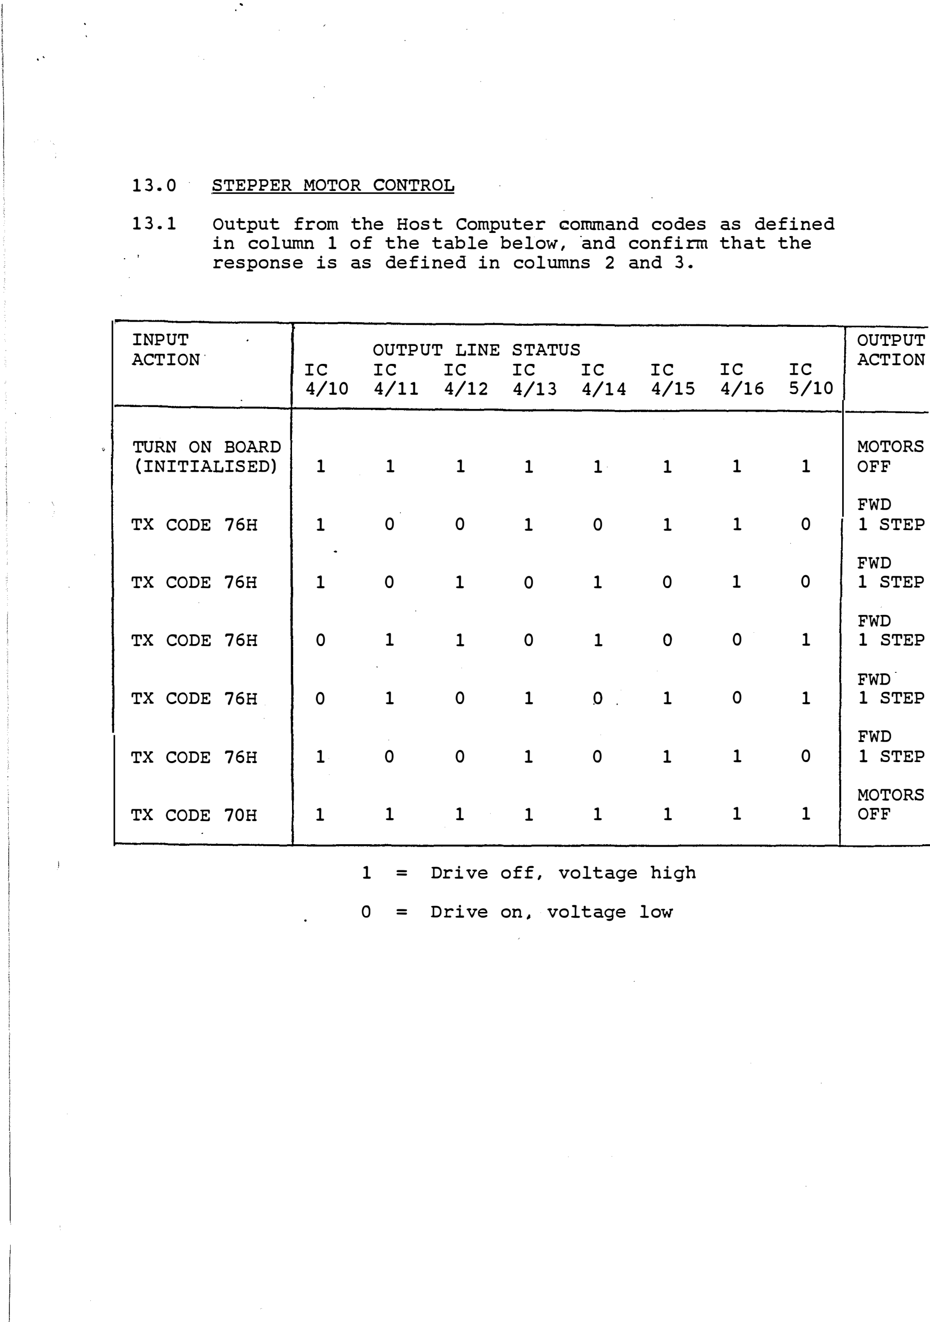
[picture p141: page 17]

13.0

13.1

INPUT
ACTION

STEPPER MOTOR CONTROL

Output from the Host Computer command codes as defined in column 1 of the table below, ·and confirm that the response is as defined in columns 2 and 3.

OUTPUT LINE STATUS
IC | IC | IC | IC | IC | IC | IC | IC
4/10 | 4/11 | 4/12 | 4/13 | 4/14 | 4/15 | 4/16 | 5/10

TURN ON BOARD
(INITIALISED) | 1
TX CODE 76H | 1
TX CODE 76H | 1
TX CODE 76H | 0
TX CODE 76H | 0
TX CODE 76H | 1
TX CODE 70H | 1
1 | 1 | 1 | 1 | 1
0 | 0 | 1 | 0 | 1
0 | 1 | 0 | 1 | 0
1 | 1 | 0 | 1 | 0
1 | 0 | 1 | 0 | 1
0 | 0 | 1 | 0 | 1
1 | 1 | 1 | 1 | 1
1 | = | Drive off, voltage high
O | = | Drive on, voltage low
1 | 1
1 | 0
1 | 0
0 | 1
0 | 1
1 | 0
1 | 1

OUTPUT
ACTION

MOTORS
OFF

FWD
1 STEP

FWD
1 STEP

FWD
1 STEP

FWD
1 STEP

FWD
1 STEP

MOTORS
OFF

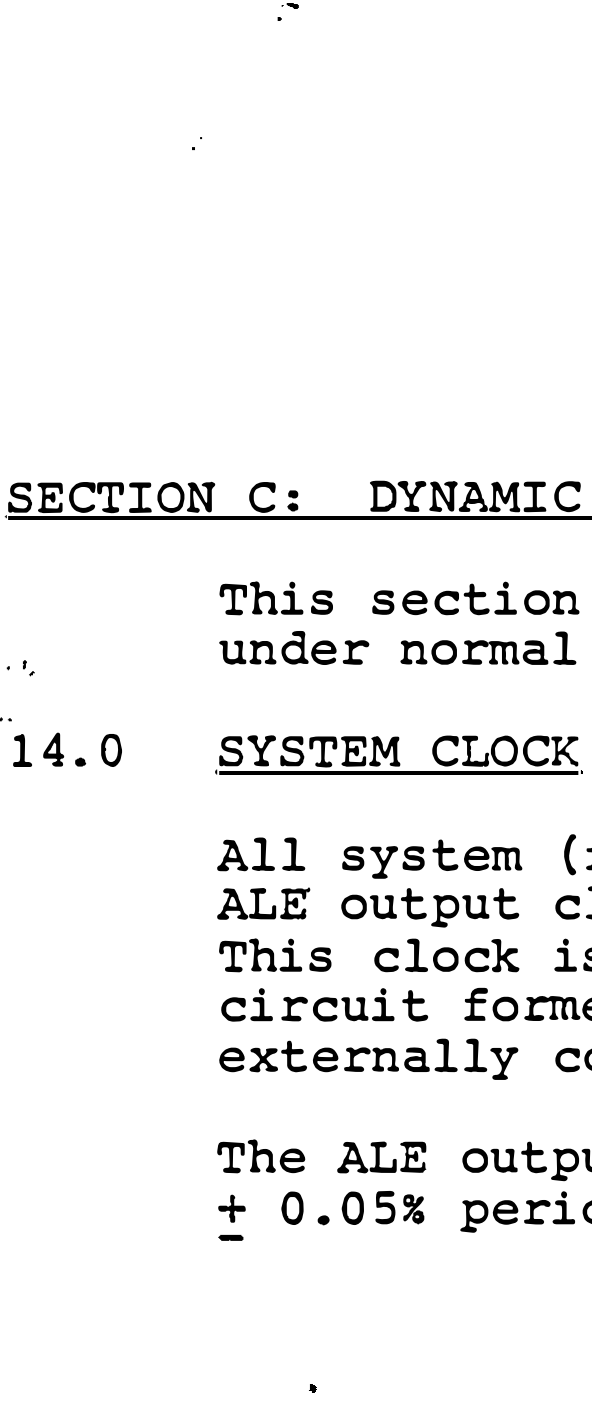
[picture p142: figure]
14.0 SYSTEM CLOCK
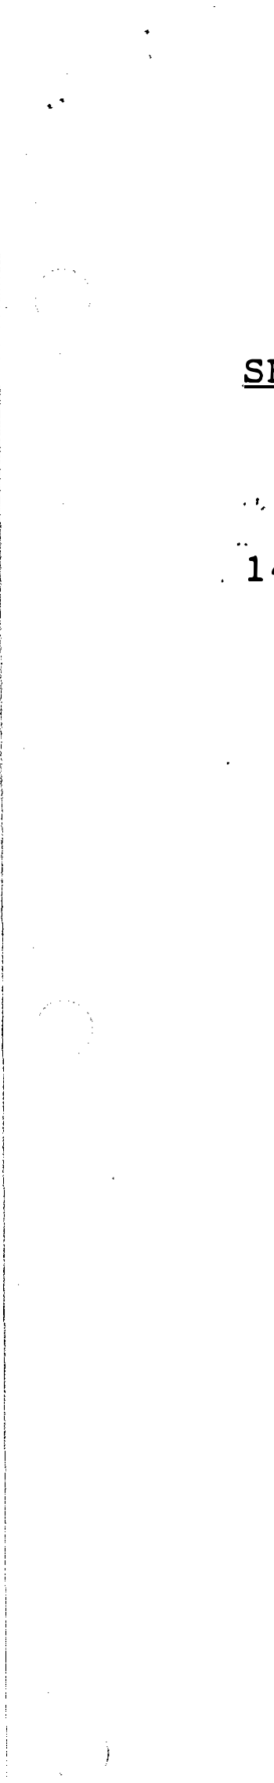
[picture p143: figure]

SECTION C: DYNAMIC PERFORMANCE

This section details the dynamic operation of the unit under normal operating conditions.

All system (firmware} operations are timed against the ALE output clock from ICl Pin 11.
This clock is itself derived from a GMHz oscillator circuit formed by the on-chip ICl circuitry and externally connected crystal.

The ALE output is reqired to be of a 2.5 microsecond
+ 0.05% period, with a high to low ratio of approx. 1 to 4.

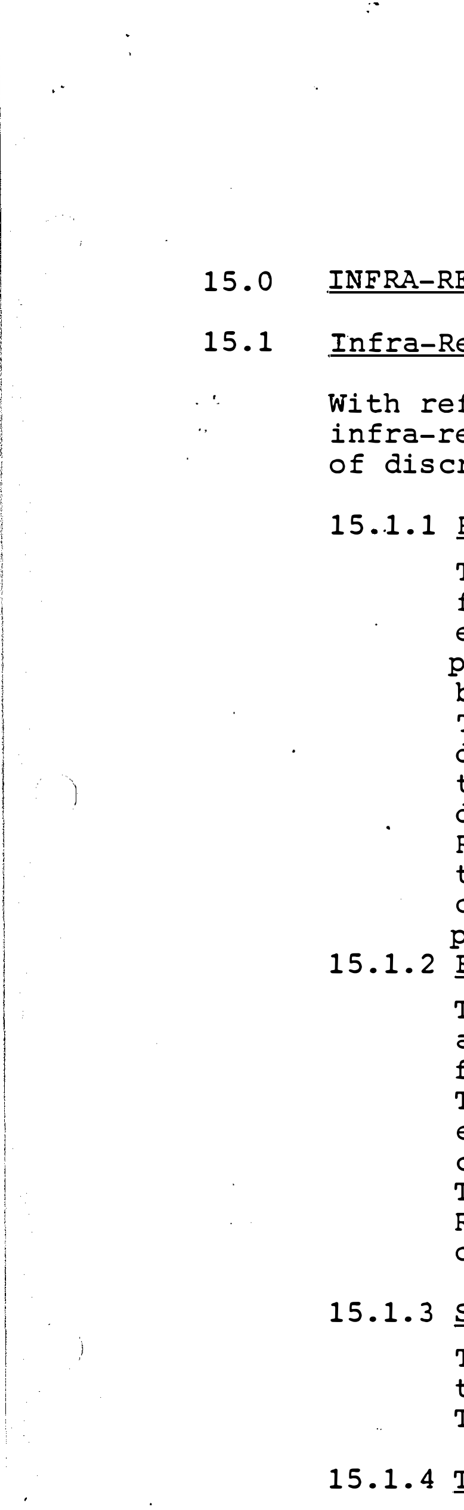
[picture p144: figure]

INFRA-RED RECEIVER

Infra-Red Receiver Circuit

With reference to Figure 3, it may be seen that the infra-red receiver circuit may be split into a number of discrete functional blocks.

15 • .1.1 Receiver Diodes
The series of fast infra-red pulses output from the Communicator are converted back to electrical signals by an array of p.i.n. photo-diodes mounted on the Turtle Controller board.
These signals comprise of current pulses directly proportional to the intensity of the infra-red wavelengths received by the diodes.
Refer to Figure 4 Trace 1 for an example of
the signal type to be found at the output
of this receiving stage for a repetitive 5us I.R. pulse signal.
15.1.2 First Stage Amplifier The current pulses from the receiver diodes
are capacitively coupled to the input of the first stage ampli.fier.
This amplifier is of transconductance type, exhibiting low input impedance and required to convert the current 'input into a voltage output. The transconductance gain = 9.8K typical. Refer to Trace 2 of Figure 4 for typical output from this stage.

15.1.3 Second Stage Amplifier The second stage amplifier receives as input the output voltage from the first stage.
The voltage gain of the circuit is 25, typically.

15.1.4 Third Stage Amplifier The third stage common emitter amplifier receives as a capacitively coupled input the output voltage from the second stage.
The voltage gain of this amplifier is 20, typically.

15.1.5 Auto-Reference Level Circuit The output from the third stage amplifier is
fed to a high input impedance voltage comparator via the Auto-Reference Level Circuit. The purpose of this circuit is to provide a nominal

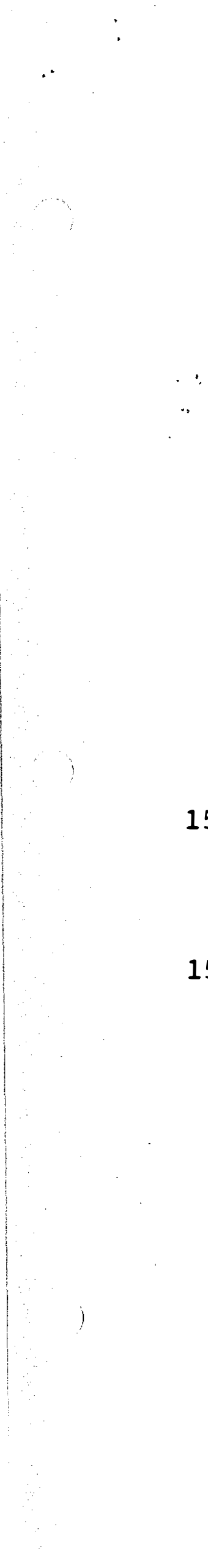
[picture p145: figure]

15.2

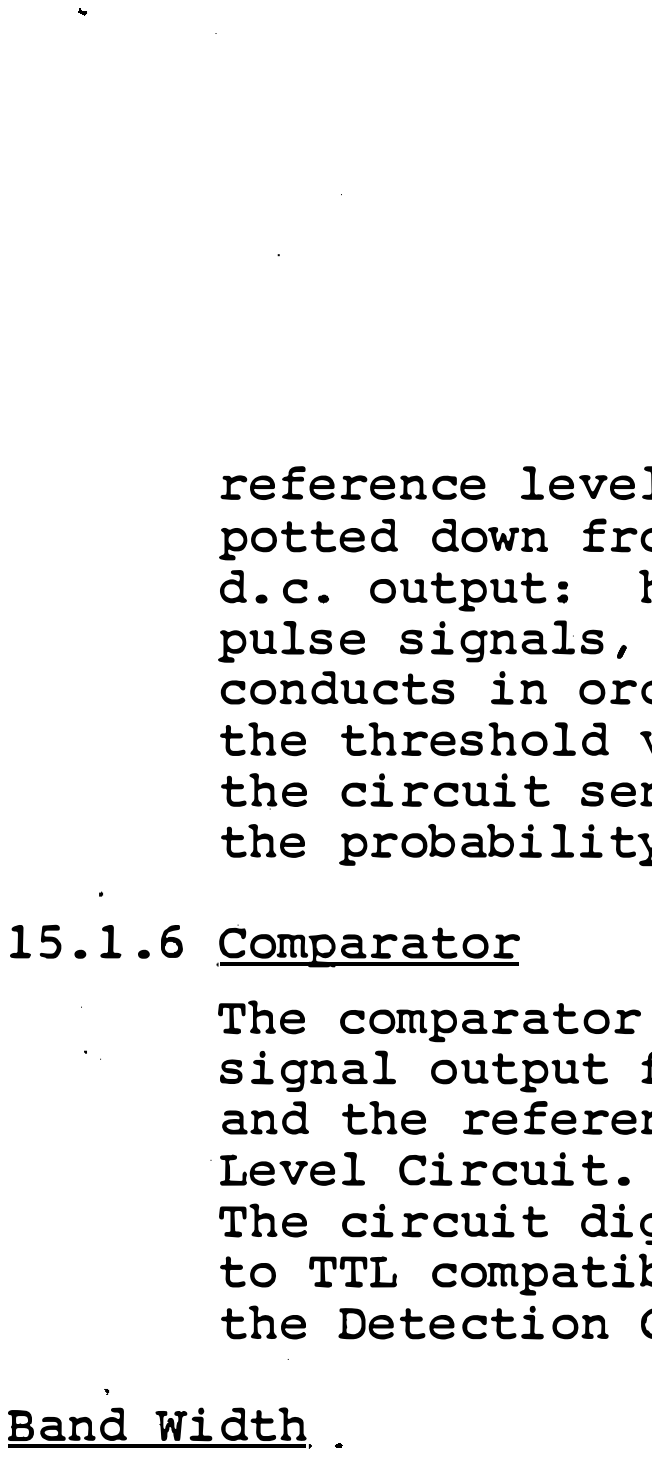
[picture p146: figure]
15.1.6 Comparator; Level Circuit.; Band Width

reference level to the comparator which is potted down from the third stage quiescent d.c. output: however, for large amplitude pulse signals, a pulldown transistor TRl conducts in order to, in voltage terms, reduce the threshold voltage; in thresholding terms, the circuit sensitivity is reduced, decreasing the probability of random noise interference.

The comparator receives as inputs the direct signal output from the third stage amplifier and the reference level from the Auto-Reference

The circuit digitises the I.R. pulses received to TTL compatible levels suitable for input to the Detection Gate Flip-Flop.

The amplifier band width is typically 10MHz with band stop below lOOkHz.

15.3 Amplifier Noise Output The amplifier output noise measured at IC8 Pin 2 is typically lOOmV pk-pk under normal indoor lighting conditions.

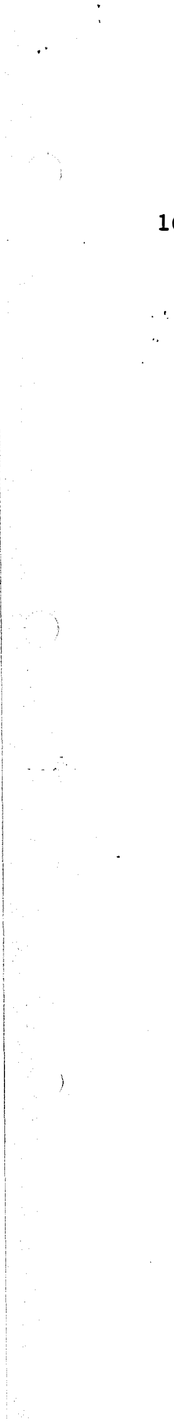
[picture p147: figure]

16.0 | DETECTION GATE CIRCUIT
| This circuit is based on a single D-type flip-flop. The purpose of the circuit in conjunction with control (reset) signals from the microcomputer is to sense and record the presence of I.R. inputs during defined 'gating' periods. The relationship of detected signal against gate period is analysed by the microcomputer in order to decode the digital cormnand.

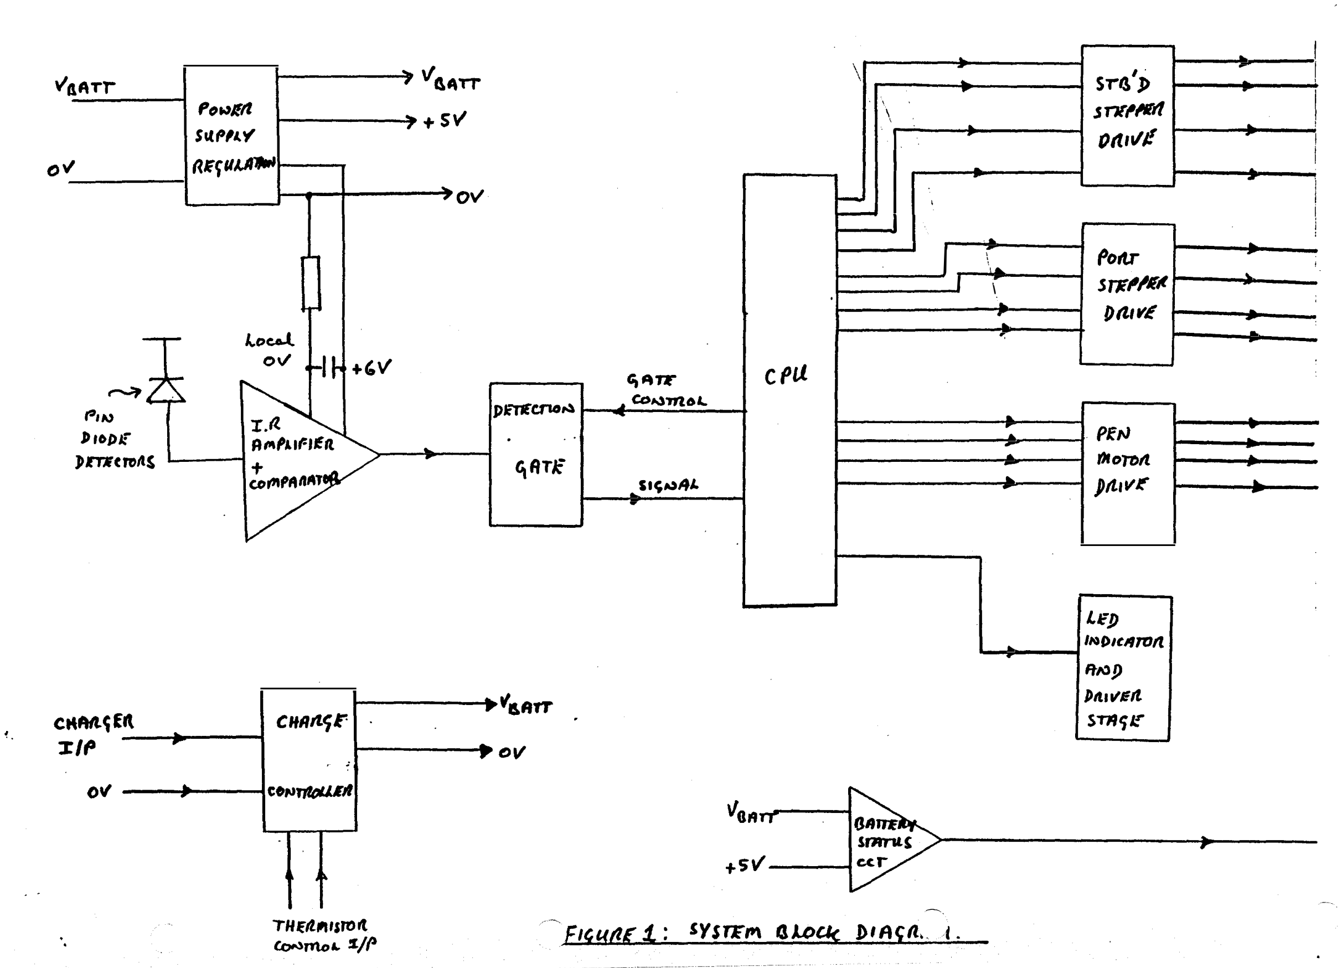
[picture p148: page 22]

) -

'r

4, Ill -
"'
t

,,

, ,. . , ,. '"

' '

+

"

-'r •r -·,

----, I,
p I ' '

------,

,,
- r

'

' 1,

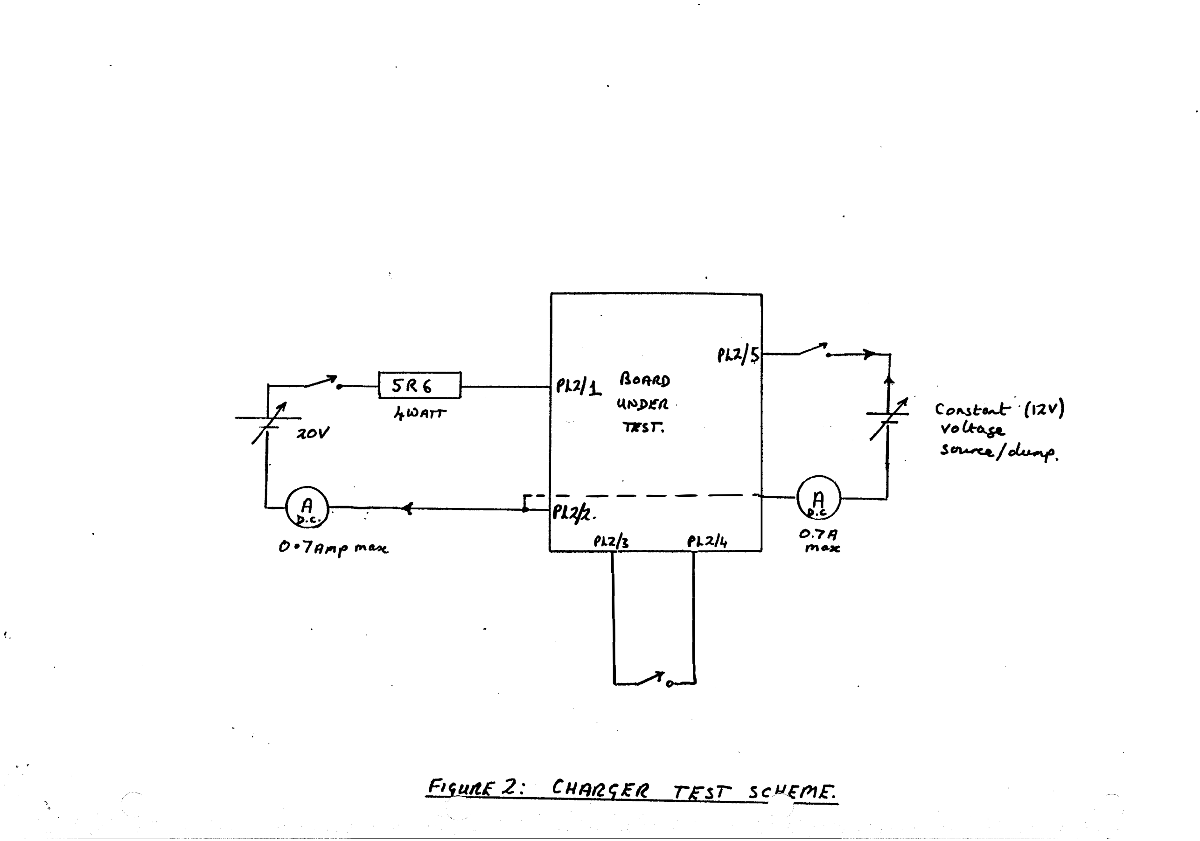
[picture p149: page 23]

;! I
I
-------t

I

I

...... ------i

I

I

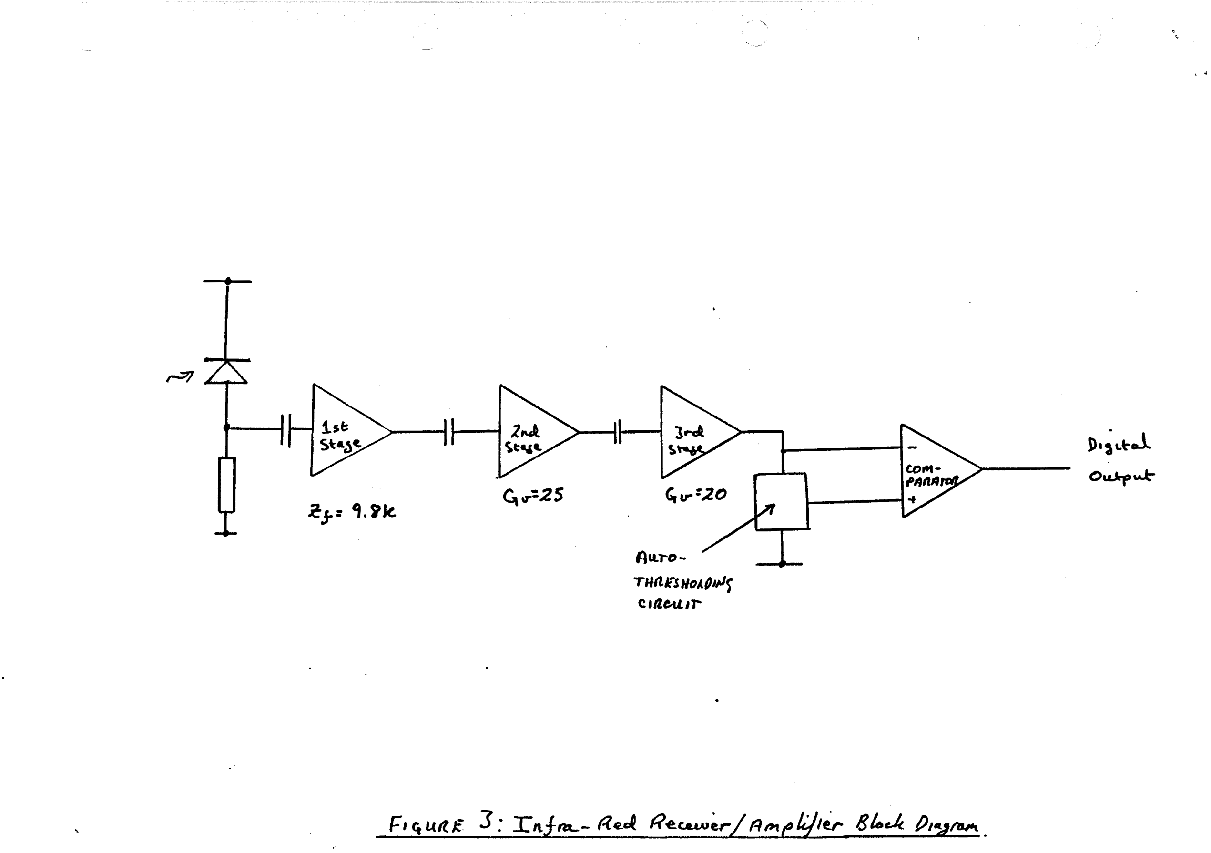
[picture p150: page 24]

M

. er
••

t

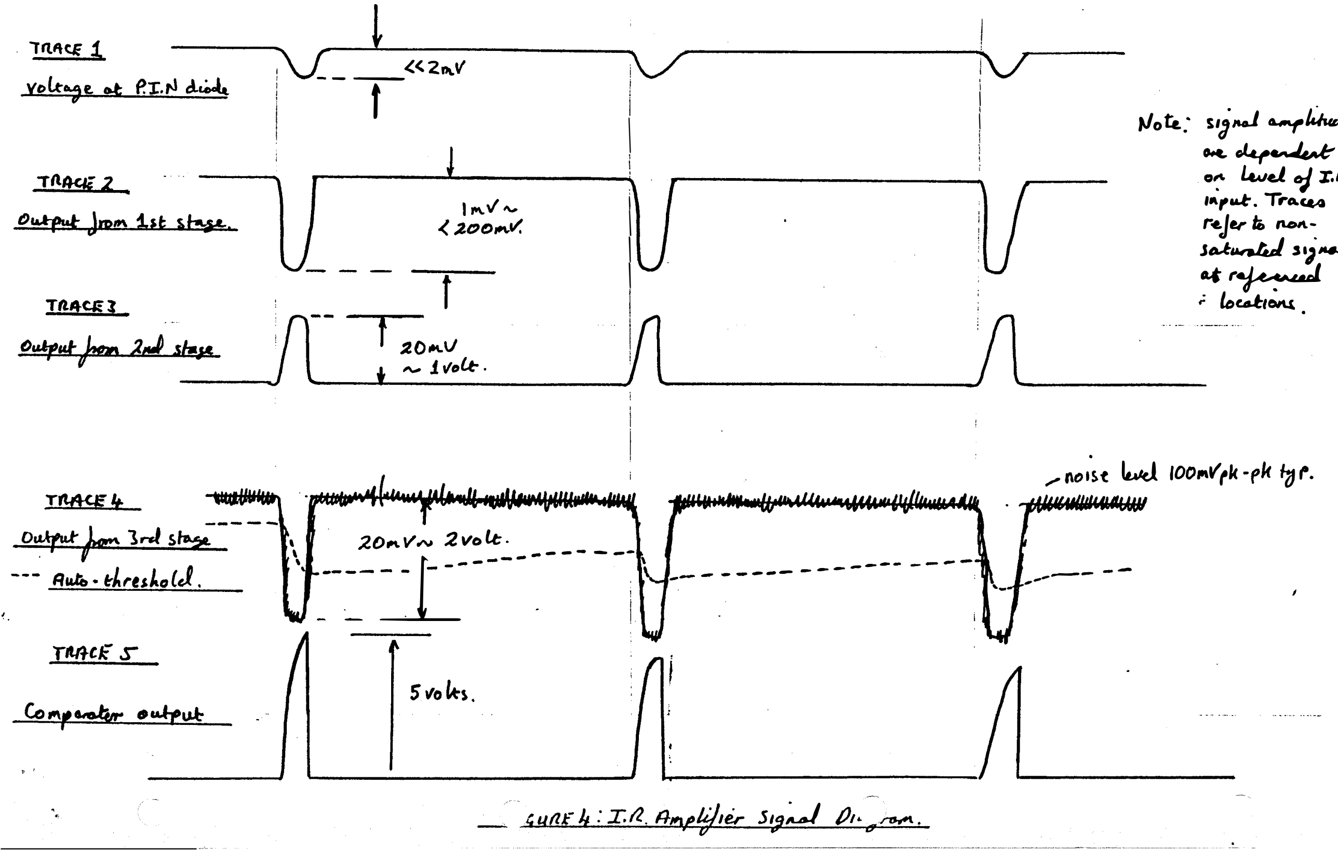
[picture p151: page 25]

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
I ·I''

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
:ii;-I
:-.

I
I

-I

-----· -----

N
.,
- --·--·- --- -· ---------------
I-"
.. 'I, :. .... - 0 s--, t..:·) J

## itt!>f.f

l

r 1t

r:.. t.t

# '-• I 4'1_ £ f

& tt
