simoninns/valiant-turtle/valiant_docs/service/Valiant - Valiant Turtle Testing Procedures - Test T1.pdf

# TURTLE PROJECT

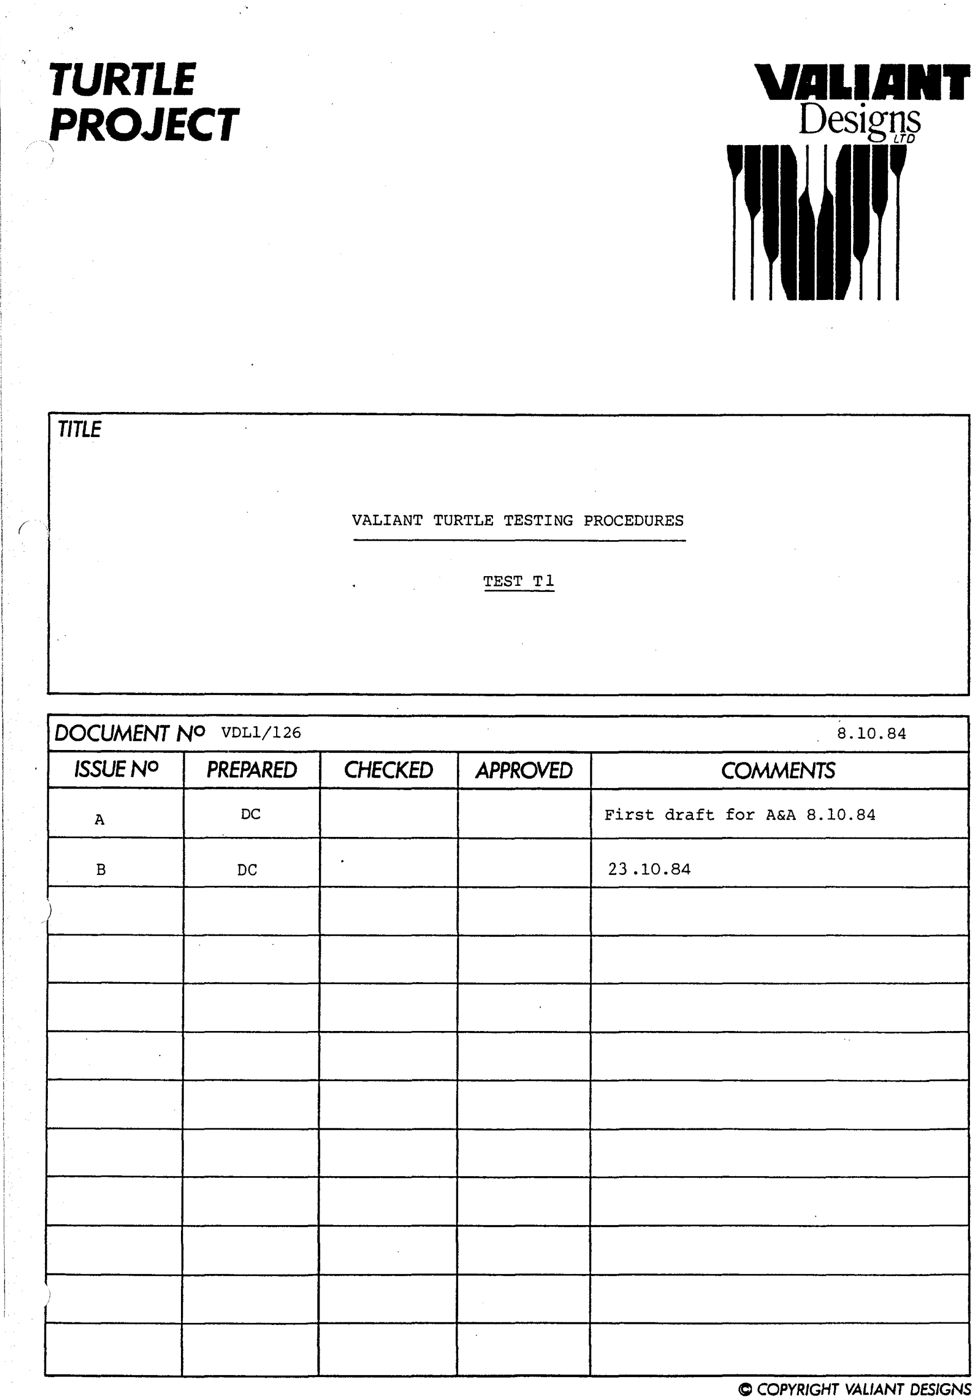
[picture p152: page 1]

(

'\

### TITLE

### DOCUMENT NO VDLl/126

ISSUE NO | PREPARED | CHECKED | APPROVED | COMMENTS
A | DC | | | First draft for A&A 8.10.84
B | DC | | | 23.10.84
)

VALIANT TURTLE TESTING PROCEDURES

TEST Tl

# v,aL1,aNT DesigtJ~

8.10.84

<Cl COPYRIGHT VALIANT DESIGNS

VALIANT TURTLE TESTING PROCEDURES

A. TEST T1

1.0 T1 is a thorough functional test designed to test every aspect of the Turtle and its operation.

2.0 TEST EQUIPMENT

The test equipment consists of:

a) A variable d.c. power supply capable of supplying up to 1 Amp and 30 volts.
b) A 1 metre long twin 7/0.25mm cable capable of connecting the power supply to the on-board power supply of the Turtle.
c) A cable with a connector capable of connecting the power supply to the Turtle's recharging socket.
d) A Valiant Communicator.
e) A Valiant Power Adaptor.
f) An appropriate computer and software capable of driving the Communicator - programmed with the test routines of T1

OR

g) A discreet electronic circuit capable of driving the Communicator in T1 modes.
h) Valiant Turtle Test Software.

3.0 VISUAL CHECK

This is an inspection procedure intended to ensure:

a) All work has been done and is satisfactory.
b) The quality of workmanship is good.
c) The appearance and finish are excellent.

A checklist in Appendix A should be completed for each Turtle to ensure all aspects of the product are inspected.

4.0 CHARGE CIRCUIT TEST

Part 1: | a) | Switch the Turtle into CHARGE mode.

VDL1/126
8 October 1984

VALIANT TURTLE TESTING PROCEDURES (contd) TEST T1

Page 2

b)

c)

Connect the power supply to the Turtle recharging socket.

Set the voltage supply to 20 volts.

d) Complete the Part 1 Charge Circuit section of the checklist in Appendix A.
Part 2: | e) | Switch the Turtle switch to OFF.
| f)
| g) | Increase the voltage (up to a maximum of 30 volts) until the yellow LED goes out on the PCB.
| | Complete the Part 2 section on the check list in Appendix A.

5.0 PEN TEST

5.1 TES~ PROCEDURES (HIGH VOLTAGE 14V)

a) The power supply should be set on 14 volts.

5.2 TEST PROCEDURES (LOW VOLTAGE 10.5V)

a) The power supply should be set on 10.5 volts and connected to the PCB's power system.
b) A pen should be inserted into the pen holder.
c) The Turtle should be switched on.
d) The computer and the Valiant Communicator should be powered up and the test program software loaded (see VDL1/ ).
E) The T1 pen test program should be activated.
f) The pen should be raised and lowered ten times.

N.B. ON NO ACCOUNT SHOULD THE PEN BE RAISED AND LOWERED WITHOUT THE "PAUSE" INSTRUCTION BETWEEN EACH COMMAND.

g) Complete the checklist of Appendix A.

6.0 DRIVE UNIT TEST

a) With the computer and Valiant Communicator and Turtle set up with the pen inserted into the Turtle pen tube, activate Pen Test routine on the computer.

VDL1/126
8 October 1984

VALIANT TURTLE TESTING PROCEDURES (contd)
TEST T1

Page 3

b) Make sure the pen is down (i.e. lowered for drawing).
c) Set the power supply to 10.5 volts.
d) The Turtle should move forward in a series of move-and-stop motions and return along the same line.
e) If there is a significant difference between the forward and return lines, the Turtle drive mechanism needs adjustment.
f) Complete the checklist of Appendix A.

7.0 MOTION TEST

a) With the set up as as the previous section, activate TIM routine.
b) Complete the checklist of Appendix A.

N.B. IT IS NOT NECESSARY TO ADJUST THE TURTLE'S ACCURACY.
a.o EYE TEST
a) Connect the Turtle to the power supply.
b) Set the power supply to 12 volts.
c) Switch on the Turtle.
d) Reduce the voltage from 12 vol ta to 10 volts.
e) Complete the checklist of Appendix A.

VDL1/126
8 October 1984

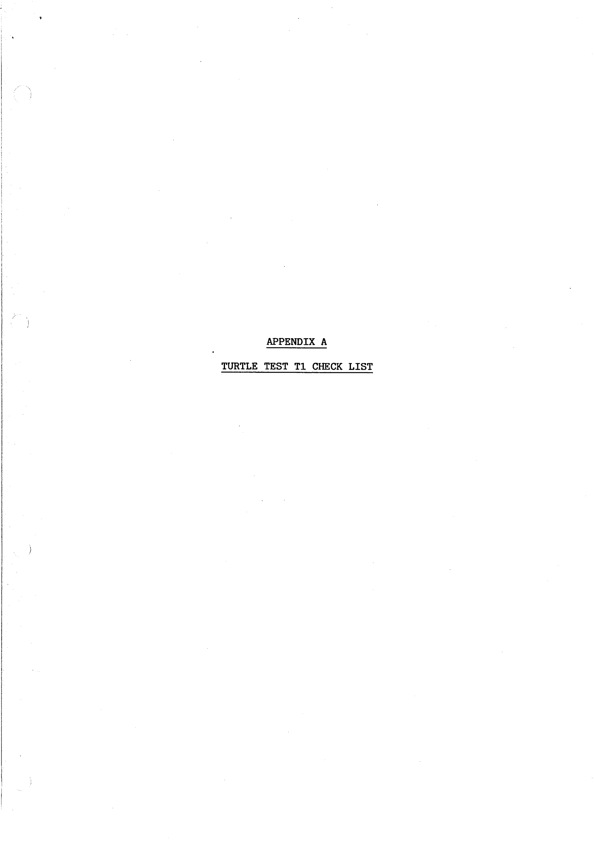
[picture p153: page 5]

APPENDIX A

TURTLE TEST Tl CHECK LIST

D
D

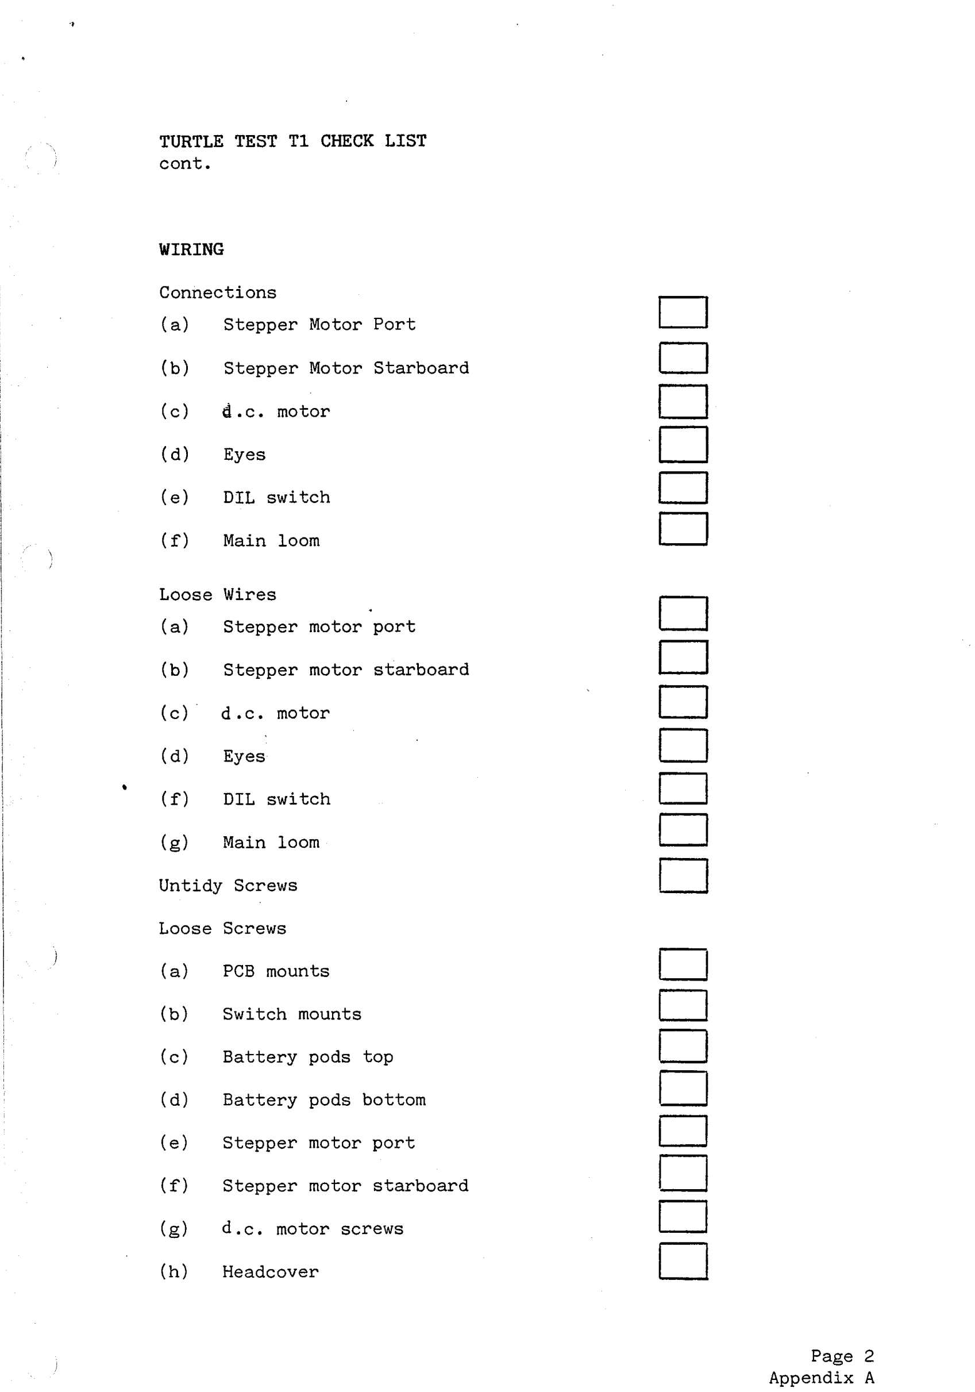
[picture p154: page 6]

.,

TURTLE TEST Tl CHECK LIST
cont.

WIRING

Connections
( a) Stepper Motor Port
(b) Stepper Motor Starboard
(c) d.c. motor

( d) Eyes

(e) DIL switch

( f) Main loom

Loose Wires
( a) Stepper motor port
(b) Stepper motor starboard
(c) d. C. motor
( d) | Eyes
( f) | DIL switch
(g) Main loom

Untidy Screws

Loose Screws

( a) PCB mounts

(b) Switch mounts
(c) Battery pods top

( d) Battery pods bottom

(e) Stepper motor port

( f) Stepper motor starboard

(g) d.c. motor screws
(h) Headcover

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
Appendix A

D
D

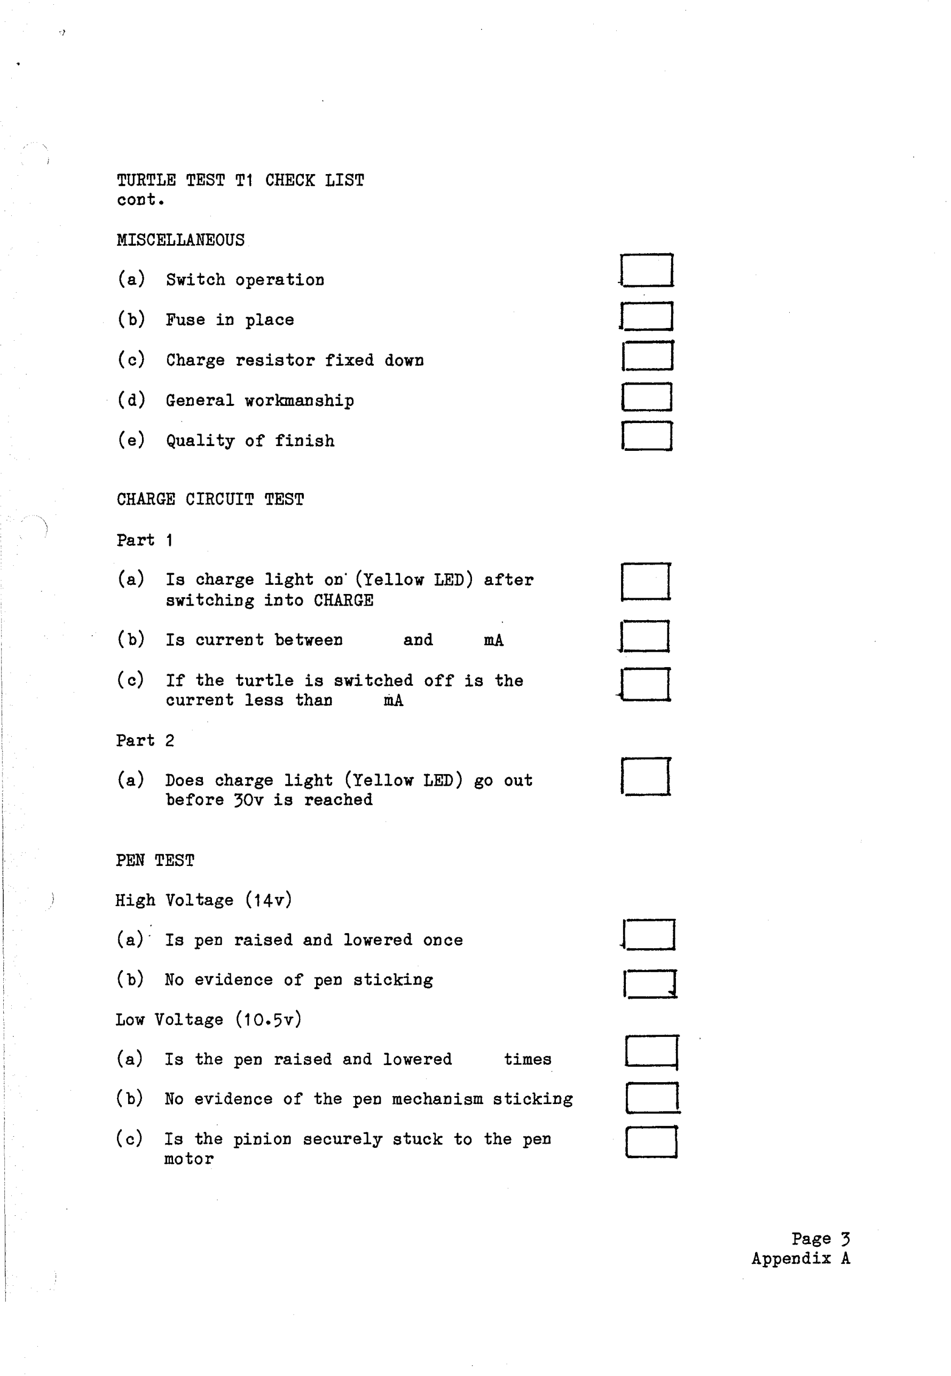
[picture p155: page 7]

·}

TURTLE TEST T1 CHECK LIST
cont.

MISCELLANEOUS

(a) Switch operation
(b) Fuse in place

( c) Charge resistor fixed

( d) General workmanship

(e) Quality of finish

CHARGE CIRCUIT TEST

Part

down

(a) Is charge light on· (Yellow LED) after switching into CHARGE
(b) Is current between | and | mA

( c) If the turtle is switched off is the current less than mA

Part 2

(a) Does charge light (Yellow LED) go out before 30v is reached

PEN TEST

High Voltage (14v)

(a)· Is pen raised and lowered once

(b) No evidence of pen sticking

Low Voltage (10.5v)
(a) Is the pen raised and lowered times

(b)

( c)

No evidence of the pen mechanism sticking

Is the pinion securely stuck to the pen motor

1==1
D
D

D
J:=J
D
D

D
D
D

Page 3
Appendix A

D

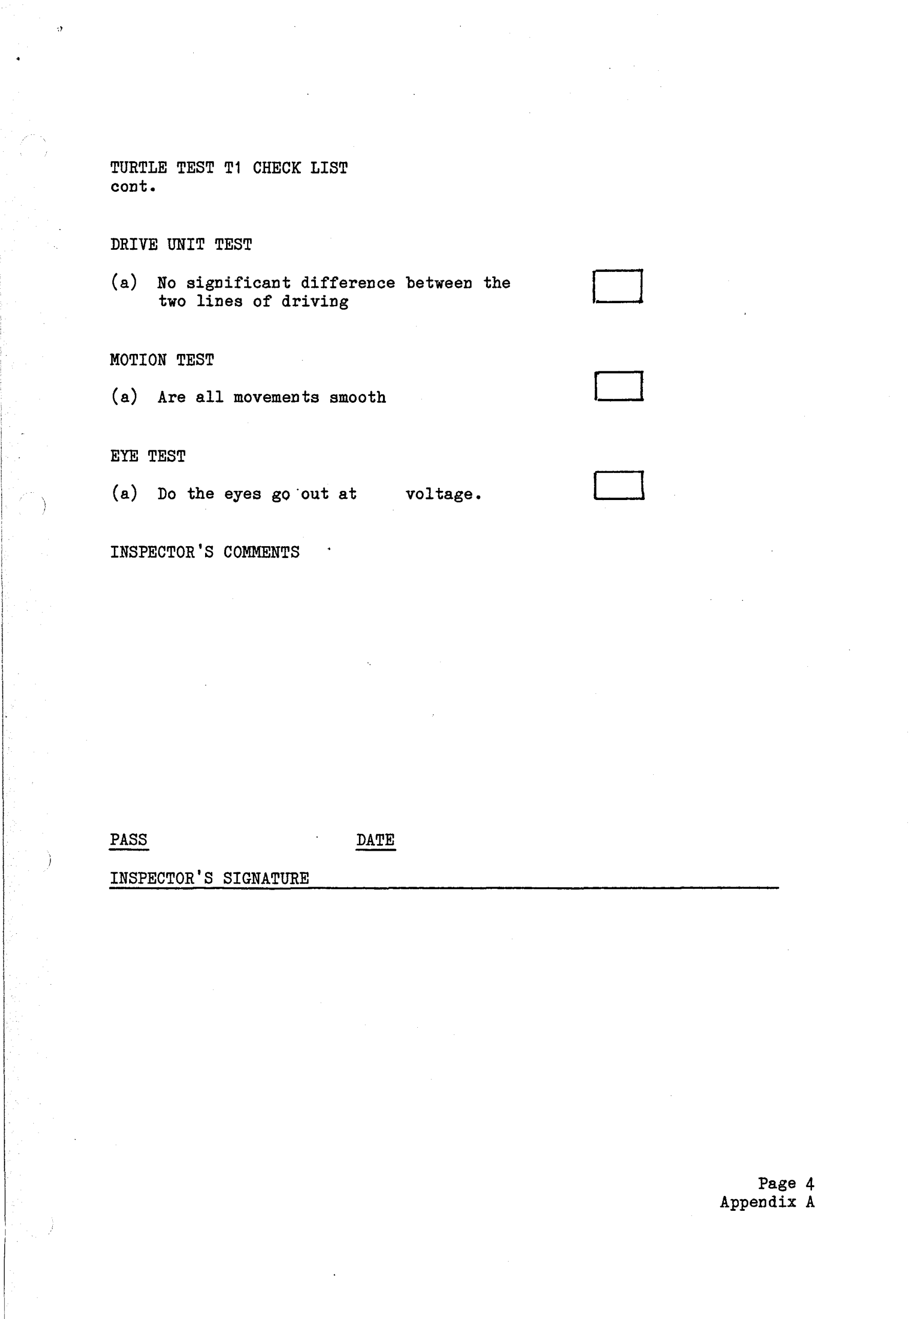
[picture p156: page 8]

TURTLE TEST T1 CHECK LIST
cont.

DRIVE UNIT TEST

(a) No significant difference between the two lines of driving

MOTION TEST

(a) Are all movements smooth

EYE TEST

(a) Do the eyes go·out at voltage.

INSPECTOR'S COMMENTS

PASS | DATE
INSPECTOR'S SIGNATURE

D

D

Page 4
Appendix A

D

D

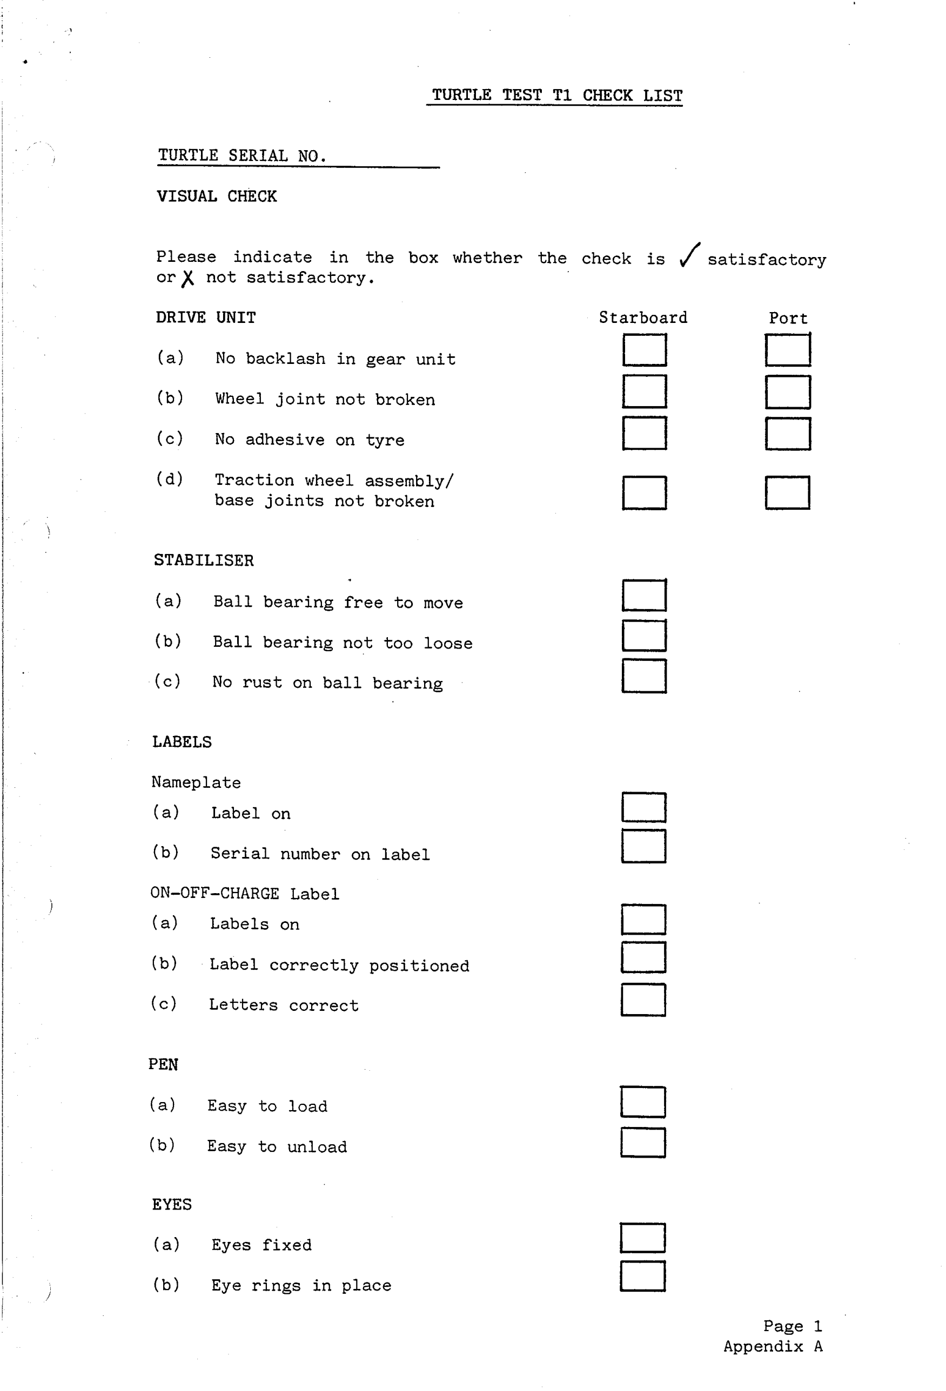
[picture p157: page 9]

TURTLE TEST Tl CHECK LIST

TURTLE SERIAL NO.

VISUAL CHECK

Please indicate in the box whether the check is / satisfactory or X not satisfactory.

DRIVE UNIT

( a) No backlash in gear unit

(b) Wheel joint not broken
(c) No adhesive on tyre

( d) Traction wheel assembly/ base joints not broken

STABILISER

( a) (b) (c) | Ball bearing free to move
| Ball bearing not too loose
| No rust on ball bearing

LABELS

Nameplate
( a) Label on
(b) Serial number on label

ON-OFF-CHARGE Label
( a)

(b)

(c)

PEN

( a)

( b)

EYES

( a)

(b)

Labels on

Label correctly positioned

Letters correct

Easy to load

Easy to unload

Eyes fixed

Eye rings in place

Starboard
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
Port
D
D
D

Appendix A
