simoninns/valiant-turtle/valiant_docs/service/Valiant - Valiant Turtle Testing Procedures - Test T2.pdf

# TURTLE PROJECT

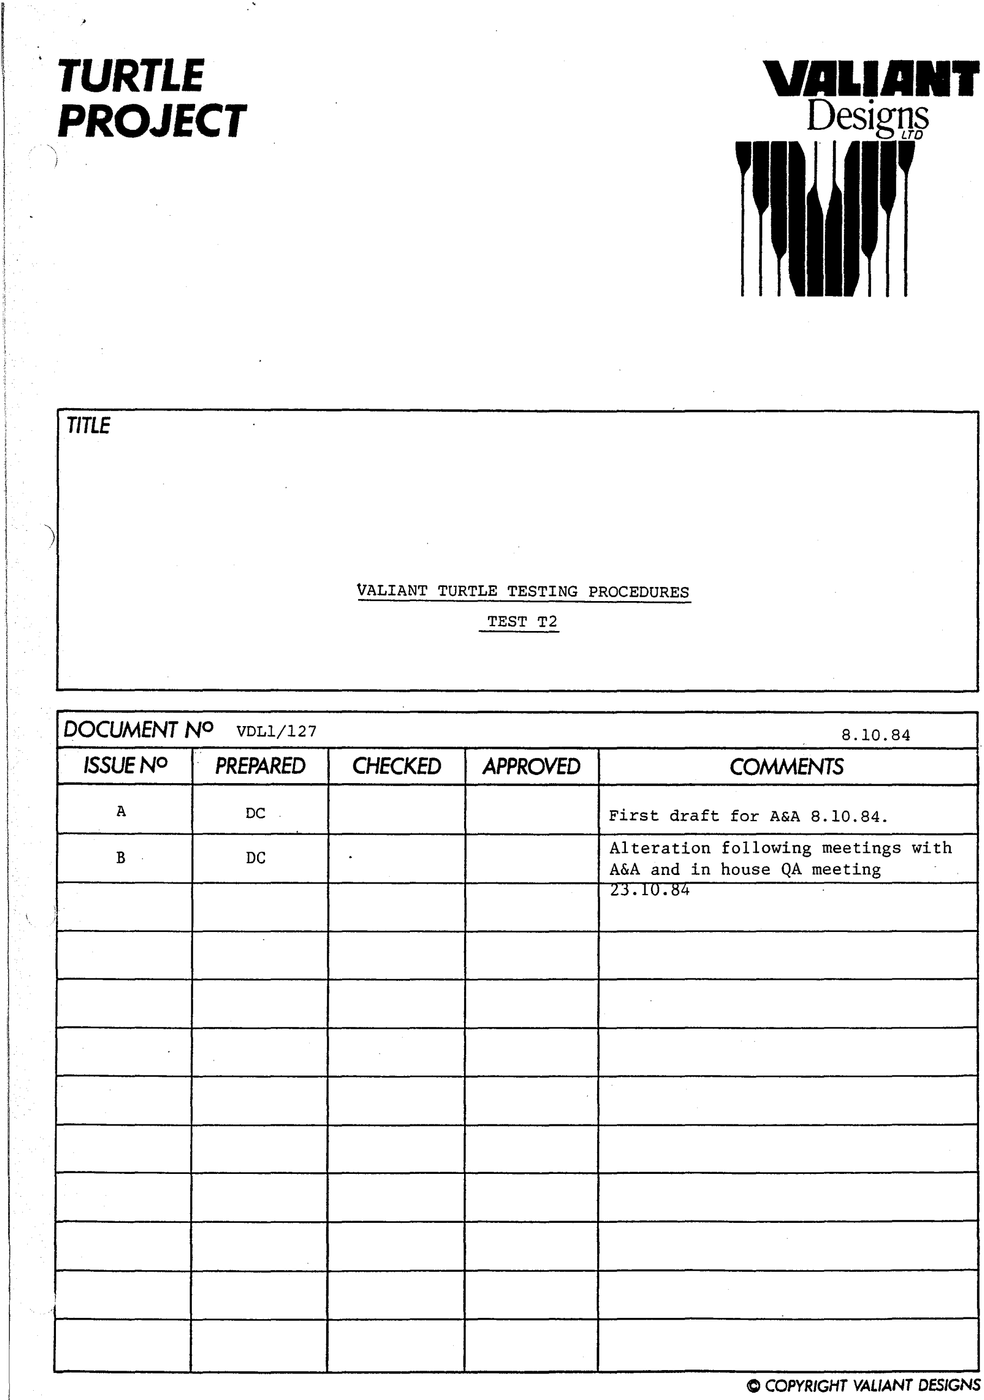
[picture p158: page 1]

)

I

TITLE

DOCUMENT NO VDLl/127
ISSUE NO | PREPARED | CHECKED | APPROVED | COMMENTS
A | DC | | | First draft for A&A 8.10.84.
B | DC | | | Alteration following meetings with A&A and in house QA meeting
I | | | | L,j. lU. l:)4

# v,a11••1 Desigg~

VALIANT TURTLE TESTING PROCEDURES TEST T2

8.10.84

C COPYRIGHT VALIANT DESIGNS

VALIANT TURTLE TESTING PROCEDURES

TEST T2

1.0 INTRODUCTION
This test is the test to be performed as the Q.A. examination of the Turtle.

2.0 TEST OBJECTIVES

This test is to be performed on the completed and packed Turtle. Its objective is to ascertain that all phases of the production, testing and packaging have been completed satisfactorily. This test should be performed without removing the Turtle shell.

3.0 Q.A. BASIS

a) The test should be performed to a 1% AQL to BS 6001:1972.
b) The purpose o~ the Q.A. is to ensure product confidence and consequentially Valiant may request samples in variation to the rules of BS 6001.
c) Changes in sample size should be approved by the Valiant Q.A. engineer.

4.0 TEST EQUIPMENT
a) Power supply as used on T1 (see VDL1/126).
b) Valiant Turtle Communicator.
c) Computer and software as T1 (see VDL1/126).
d) Valiant power adaptors.

5.0 MULTI TURTLE TESTING

It is' possible to test several Turtles at once. by the range of the communicator (8m).

6.0 VISUAL CHECK

This is only limited

This is an inspection procedure intended to ensure:

a) All the work has been satisfactorily completed.
b) The quality of workmanship is good.
c) The appearance and finish are excellent.

VDL1/127
23 October 1984

VALIANT TURTLE TESTING PROCEDURES
TEST T2 (contd)

The check list of Appendix A should be completed for each Turtle subjected to T2 testing.

7.0 CHARGE THE TURTLE

Page 2

7.1 The first charge for the Turtle is best done in a slow charge mode over a 14 hour period. If time is restricted for completing the tests then it is permissible to charge in the fast charge mode for a maximum of one hour and then charge in the slow charge mode for 3 hours.

7.2 How to charge the Turtle in slow charge mode:

a) Plug in the power adaptor to the Turtle charge socket.
b) Switch the Turtle into charge mode.
c) The yellow LED light should not illuminate.

7.3 How to charge the Turtle in the fast charge mode:

a) Switch the Turtle into charge mode.
b) Plug in the power adaptor to the Turtl~ charge socket.
c) The yellow LED charge light should illuminate.

8.0 CHARGE CIRCUIT TEST
Repeat the charge circuit test of VDL1/126 and complete the appropriate part of Appendix A.

9.0 T2 PEN TEST
a) Set up the computer, powering up the Communicator and loading the test software (see VDL1/130).
b) Position the Turtle with the others to be tested.
c) Switch on the turtles.
d) Activate T2 Pen Test Program.
e) Complete Appendix A checklist.

VDL1/127
23 October 1984

VALIANT TURTLE TESTING PROCEDURES TEST T2 (contd)

10.0 DRIVE TEST

Page 3

a) Set the Turtles in a position to perform the DRIVE UNIT Test of T1.
b) Activate the Drive Unit Test.
c) Complete the check list of Appendix A for each Turtle under test.

11.0 SQUARE TEST

a) Set the Turtles in a position to perform the Square Test {4-rawin~--a
~p~.
b) | Activate the Square | Test.
c) This is a continuous test designed to run for the full life of a battery charge (approximately 2 hours).
d) Checks should be made regarding the operation of the Turtles at frequent intervals and the relevant aspects of Appendix A checked.

Note: It is not necessary to tune the Turtle's accuracy in this test.

12.0 3600 TEST

a) Set turtles in a position to perform the 3600 test.
b) Activate the 360° test.
c) This test checks the setting of the stabiliser (on MKI only).

VDL1/127
23 October 1984

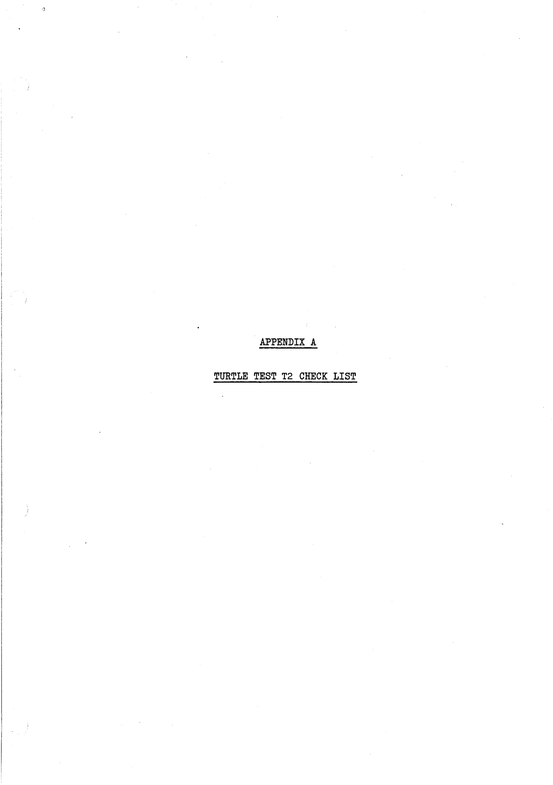
[picture p159: page 5]

APPENDIX A

TURTLE TEST T2 CHECK LIST

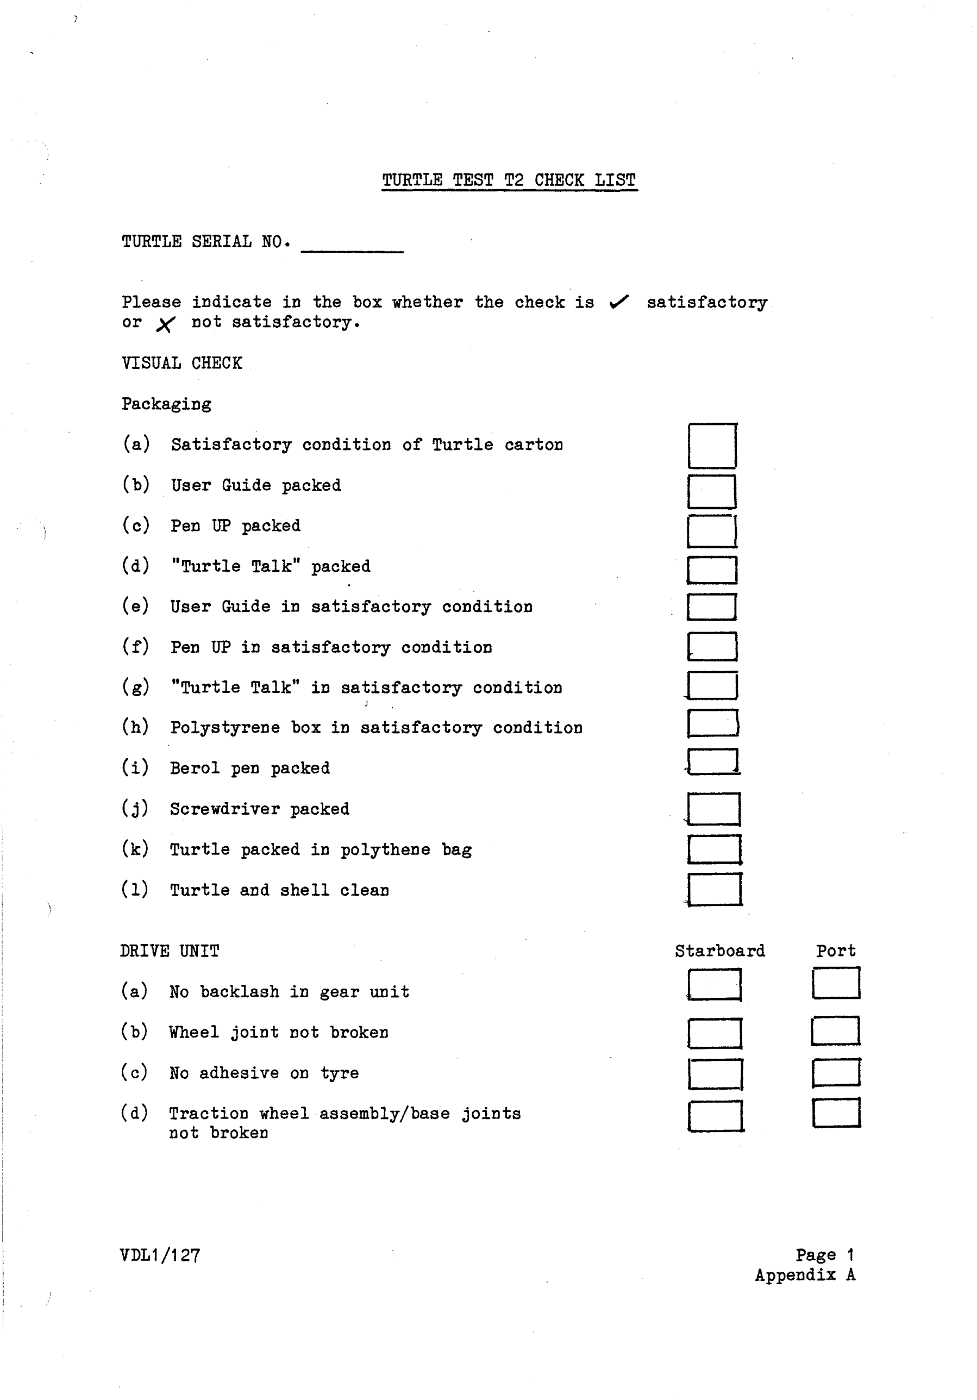
[picture p160: page 6]

TURTLE TEST T2 CHECK LIST

TURTLE SERIAL NO. -----

Please indicate in the box whether the check is ,./ satisfactory or X not satisfactory.

VISUAL CHECK

Packaging

(a) Satisfactory condition of Turtle carton
(b) User Guide packed
(c) Pen UP packed
(d) "Turtle Talk" packed
(e) User Guide in satisfactory condition
(f) Pen UP in satisfactory condition

( g) "Turtle Talk" in satisfactory condition J

(h) Polystyrene box in satisfactory condition
(i) Berol pen packed
(j) Screwdriver packed
(k) Turtle packed in polythene bag
(1) Turtle and shell clean

DRIVE UNIT

(a) No backlash in gear unit
(b) Wheel joint not broken
(c) No adhesive on tyre
(d) Traction wheel assembly/base joints not broken

VDL1/127

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
Starboard Port
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
Page 1
Appendix A

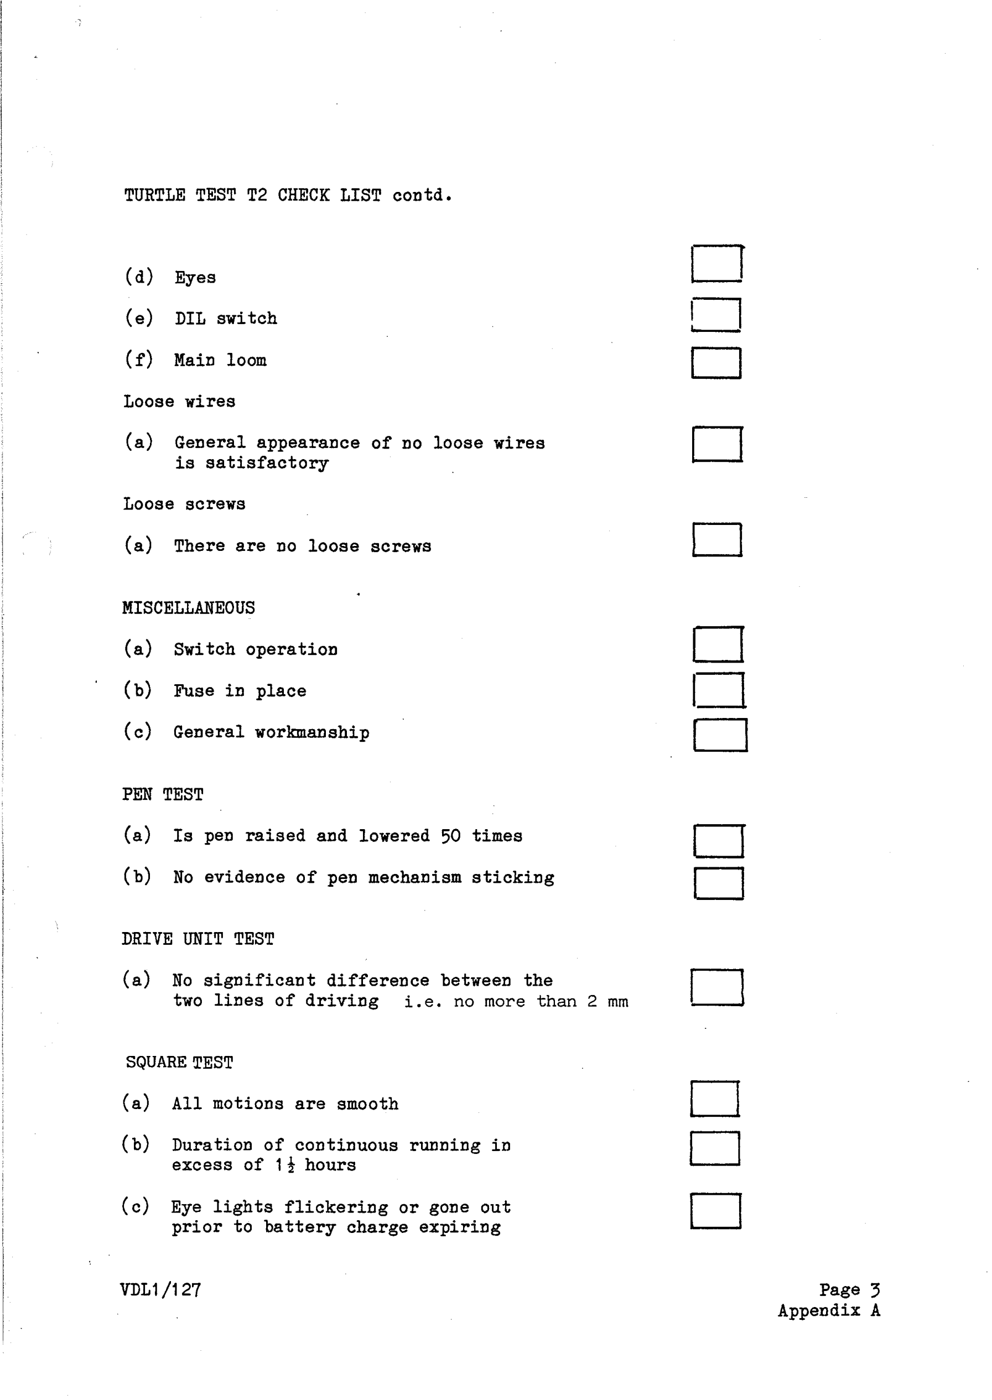
[picture p161: page 7]

TURTLE TEST T2 CHECK LIST contd.

(d) Eyes
(e) DIL switch

( f) Main loom

Loose wires

(a) General appearance of no loose wires is satisfactory

Loose screws

(a) There are no loose screws

MISCELLANEOUS

(a) Switch operation
(b) Fuse in place
(c) General workmanship

PEN TEST
(a) Is pen raised and lowered 50 times
(b) No evidence of pen mechanism sticking

DRIVE UNIT TEST

(a) No significant difference between the
two lines of driving i.e. no more than 2 mm

SQUARE TEST

(a) All motions are smooth
(b) Duration of continuous running in excess of 1i hours
(c) Eye lights flickering or gone out prior to battery charge expiring

VDL1/127

D
D
D
1==1
D

D
D
D

D
D
D

Page 3
Appendix A

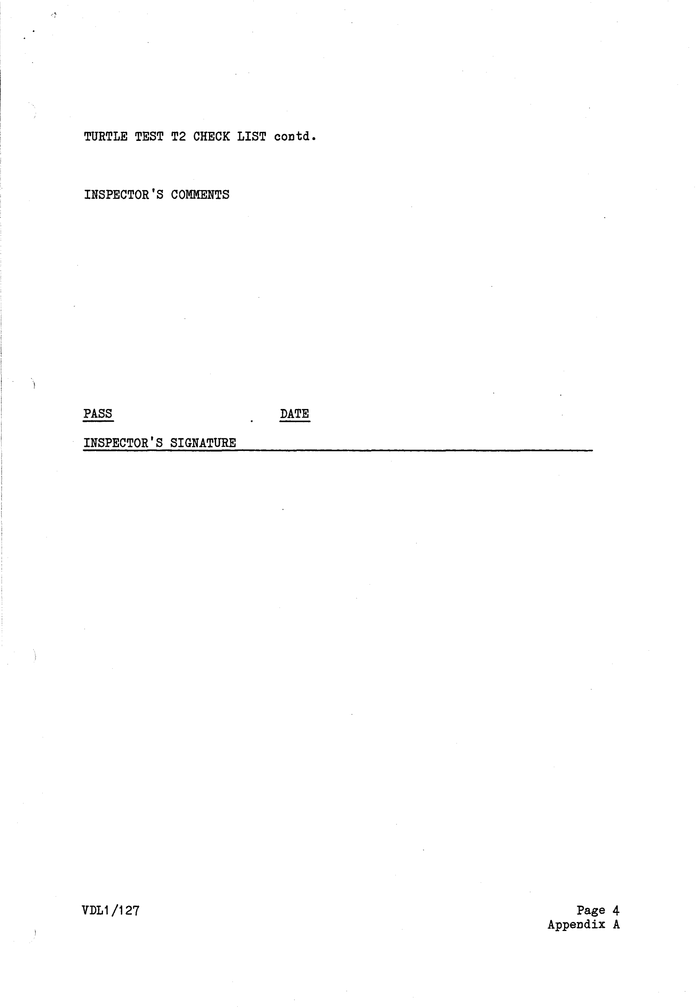
[picture p162: page 8]

TURTLE TEST T2 CHECK LIST contd.

INSPECTOR'S COMMENTS

PASS | DATE
INSPECTOR'S SIGNATURE
VDL1/127 | Page 4 Appendix A

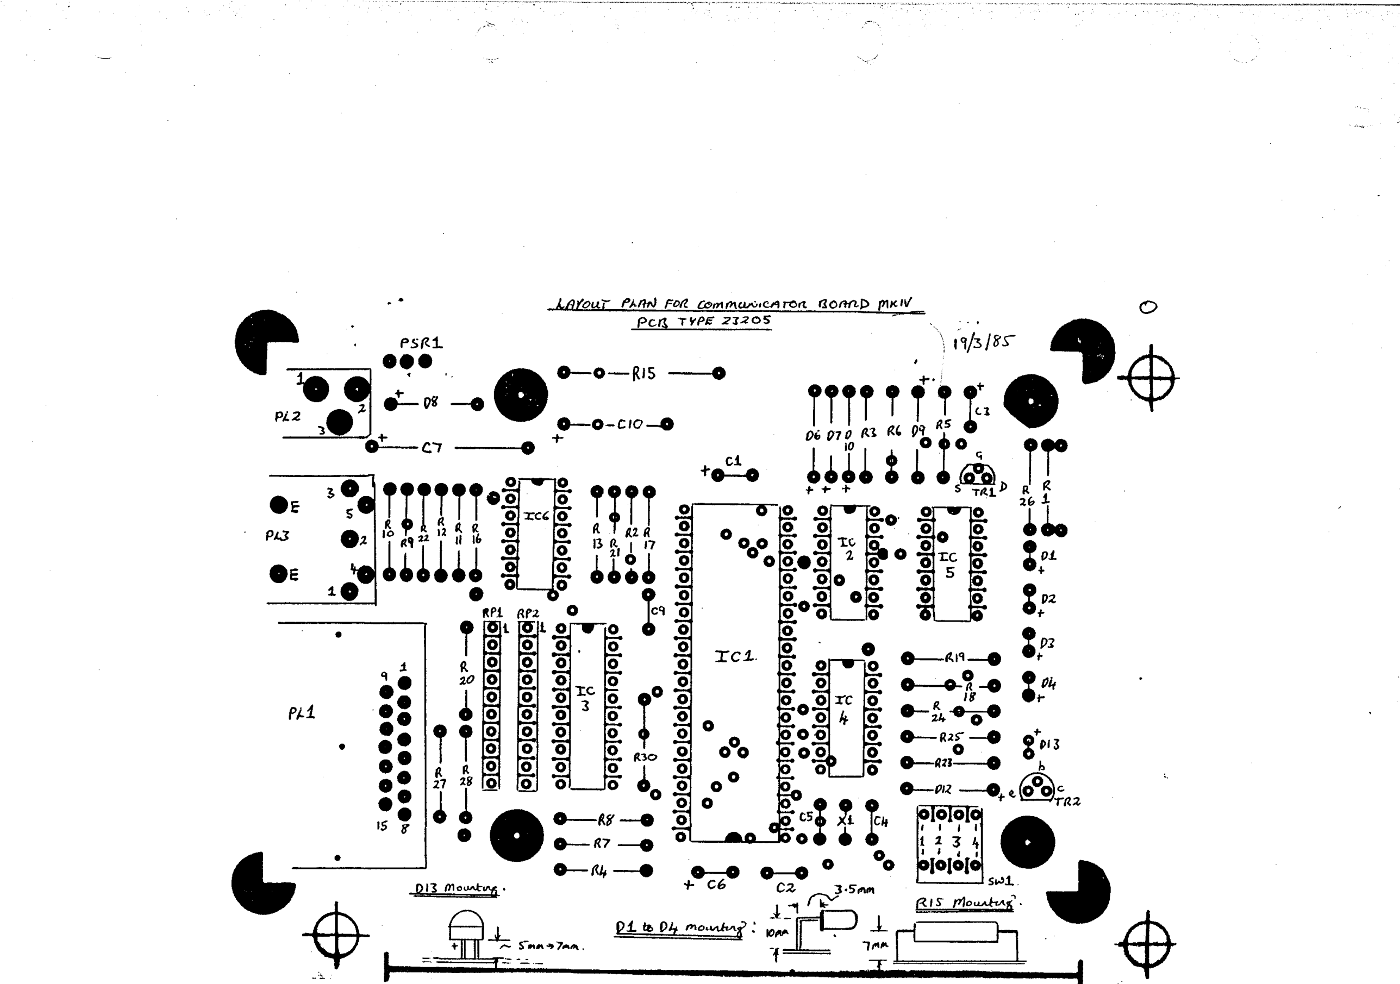
[picture p163: page 9]

/

~ . | i
LB(our l'J..nrJ FOil C(!>m mc.w,C-1'1 rort llO(l(I.P p11<11/ | 0 Per! .T'fPE 2~::zoS | ""
,;;:Br •• . | PS({ | 0-0-fVS

- ~ ~ .i-0, - - -0-CJ0----0 +

### o+ c, o

ei:

PJJ
Oe

•

'I j

P/..1.. | •• •• ••
- •• •• •• •• 15'

011 mo~".Yi.

0

ci

.,..._.

rc.1..

0
o

0
o

q 115 0
~~;~: ~
0

# l~ TT°

S Tlt.1p R ~ . :H, .1.

0

::L
::2

: Vl
O-tt.1'1--e t

# 0 0, ... :Pit

IB r --:4...,..

0-R2'-0 g\, 3
0-'121--0 | I,
0 0 | 'E°_ ..,L..__IV | 0-111< -+~®.c
0 | ~ -• 0 0 | ·-·-·
0 | °o 0-0 .._. | Si.Ji..
+ C6 | CZ | 3•S"'"' | 1 " . | ""I~ | (ZIS 1'10~5 · -$-, 8..L - =~ -~":.,7 .. nt.
J~ rr=CJ j_ | a | /'h.
Pi. fl> f)J., f"IO·vtlvtf: ~,..,.._=·-"---~---· 1~~ r t-i | ttt
f | -.- | • | T , | d | = | I

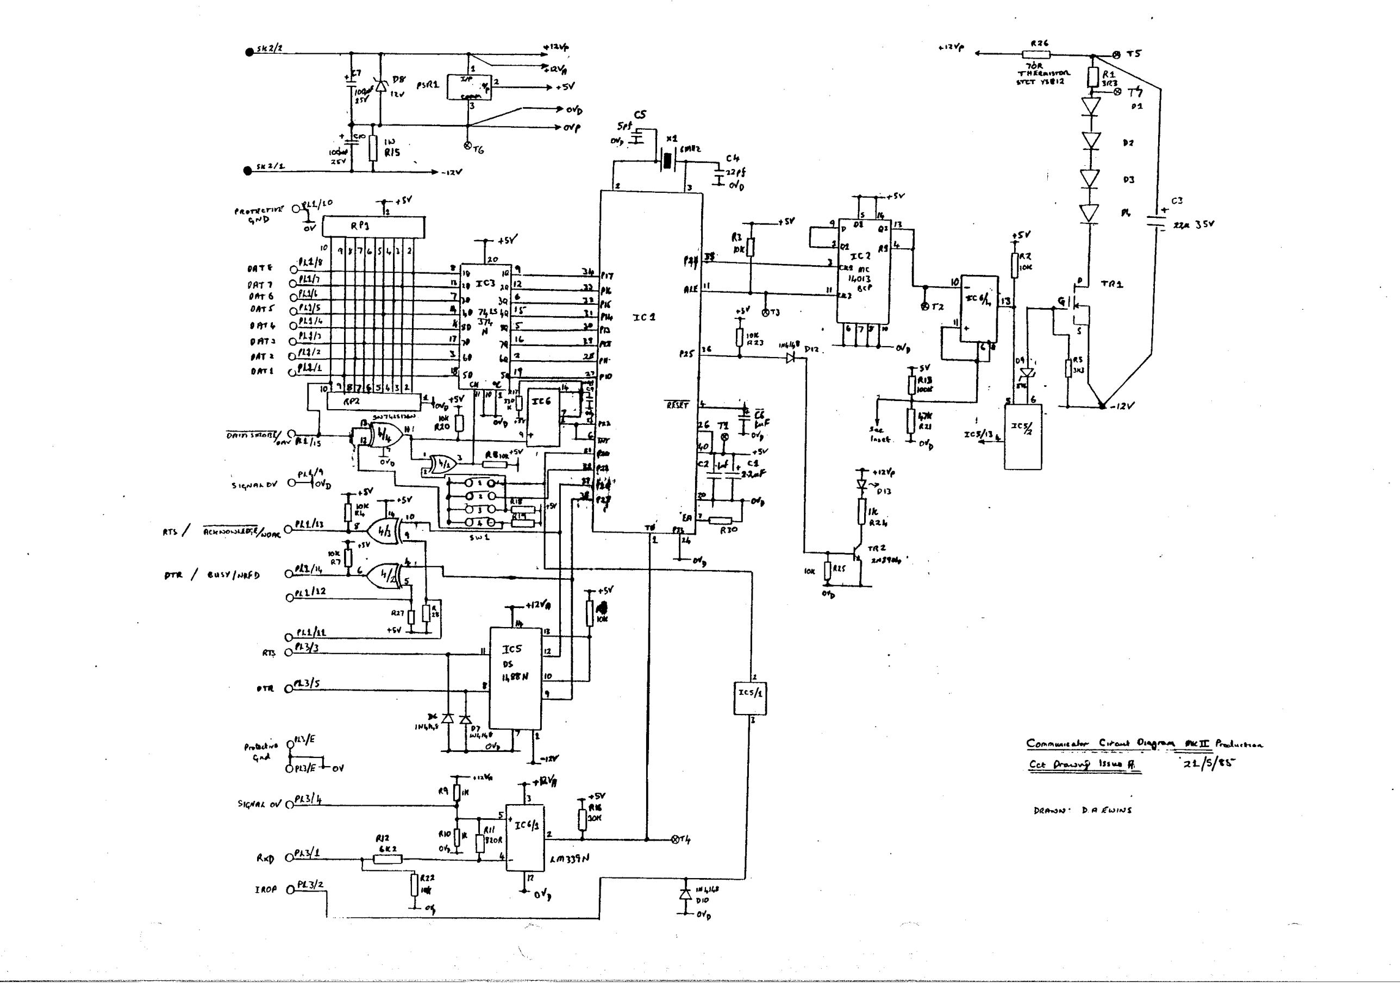
[picture p164: page 10]

)

'-

" ..

# ? i ... ~ ... ,. ~ .,, i, . "" ,. ~ ~i • .~ <:)

" ... <:..

J; ,! ~

U1 i' ~~ ;! ,=. ., ~ ... ~ ~ ";;; .. "' .... :: ;: .. ...

"

i

,. fi .,.

;;

} J:

<:.;. .. s..

;: " l-1 ::I .. V, .... :. .. ! .. 0 .. w ~ 1(

~ ~ re,.,--------'

"' ;l

~ K

~ i "'. ;;. j, .!! ~

~ ~ .. ~

ii <.

;?

.Tu ,..

a- 0 | ~
J

,.- .....
r.

H
n

"' - 'S,

;:

"'

;-:

..,

<'I

,.

" =.

'

.!

=

' ~

~l

<7'j

~

~q
" ...
.., ... '° .. ... ,- ~ ..

:.:

,~

"

,a

, I I.+

~ "
"

"'
.... "'
"

,..-

-t;
"'

:

i

,..

" {-

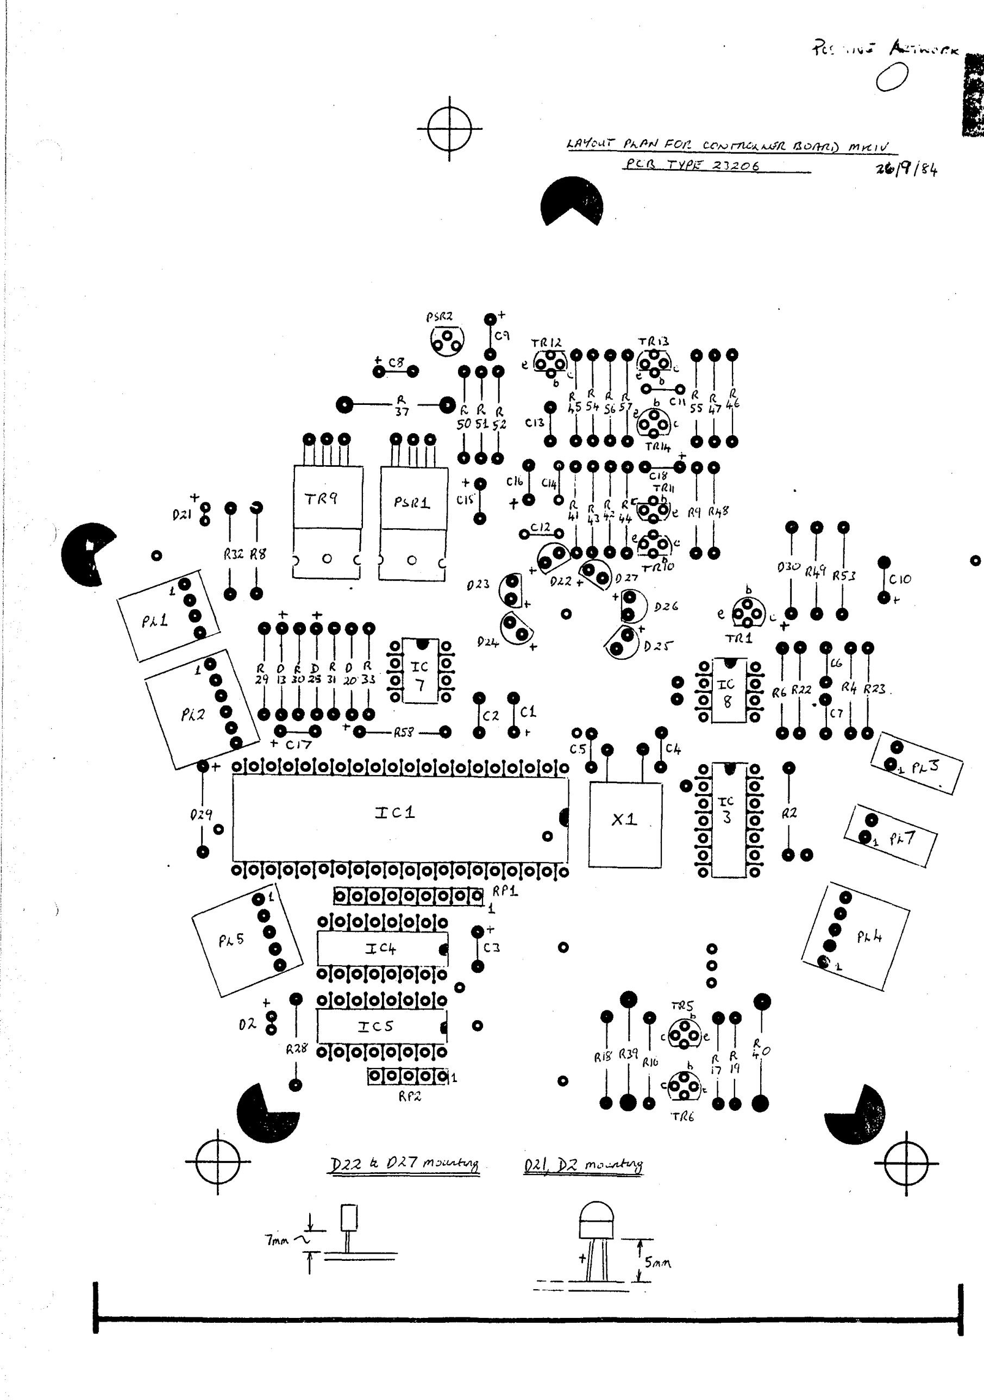
[picture p165: page 11]

Pcq, IYfif 2J206

0

I | I
