simoninns/valiant-turtle/EagleCAD/Valiant Turtle Communicator Mark II 1_0.sch

## EAGLE design EagleCAD/Valiant Turtle Communicator Mark II 1_0.sch (2024-12-11)

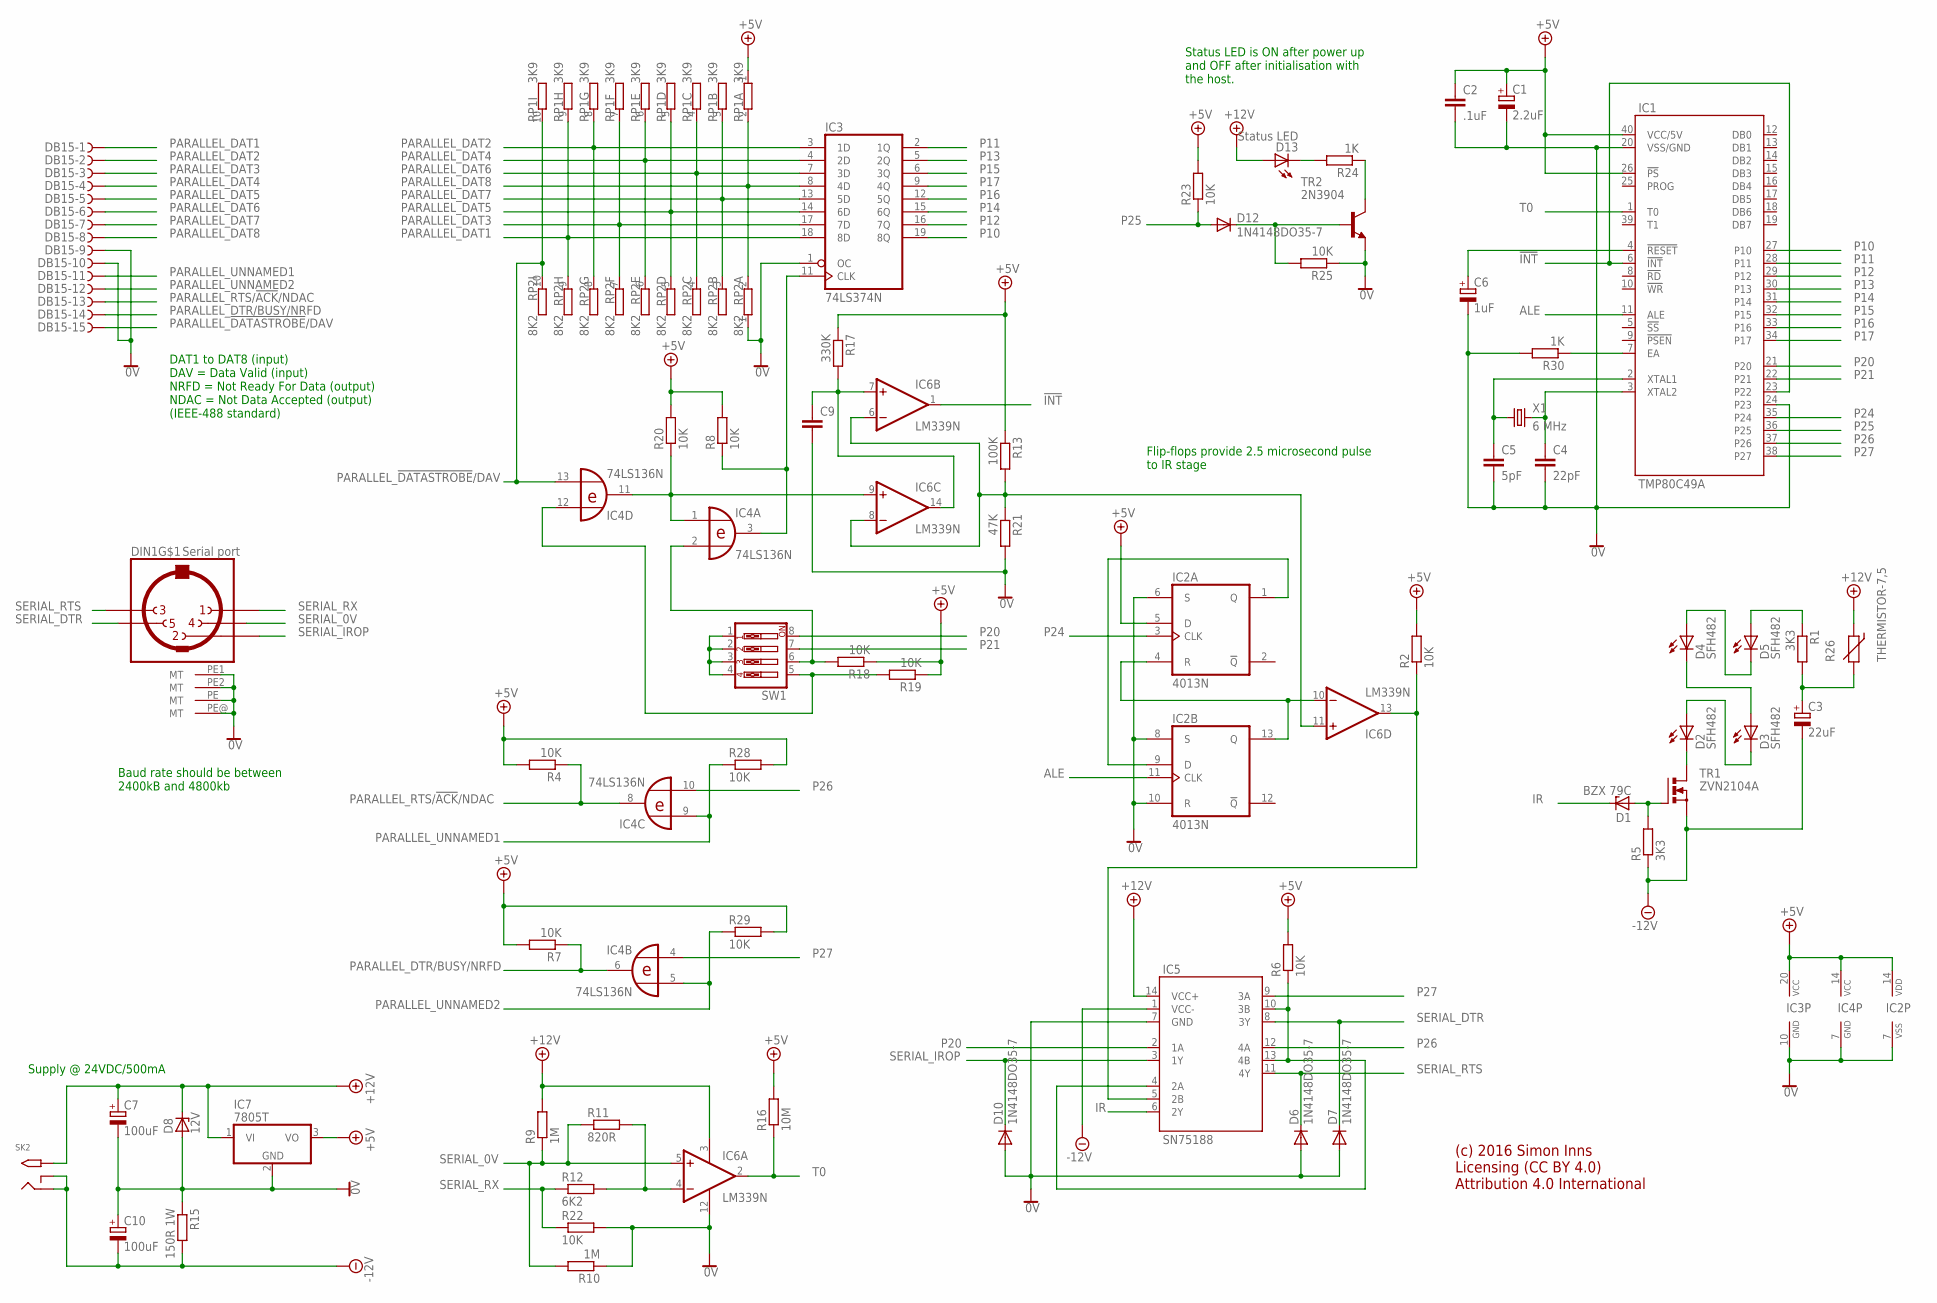
[picture p166: schematic Valiant Turtle Communicator Mark II 1_0.sch]

Parts:
C1: 2.2uF; E2,5-6E
C2: .1uF; C050-025X075
C3: 22uF; E2,5-6E
C4: 22pF; C050-025X075
C5: 5pF; C050-025X075
C6: 1uF; E2,5-6E
C7, C10: 100uF; E2,5-6E
C9: C-EU050-025X075; C050-025X075
D1: BZX 79C; DO35Z10
D2, D3, D4, D5: SFH482
D6, D7, D10, D12: 1N4148DO35-7; DO35-7
D8: 12V; DO35Z10
D13: Status LED; LED3MM
DB15: F15.590S; 177-015-212-FEMALE
DIN1: Serial port; CP-2350
IC1: TMP80C49A; DIL40
IC2: 4013N; DIL14
IC3: 74LS374N; DIL20
IC4: 74LS136N; DIL14
IC5: SN75188; DIL16
IC6: LM339N; DIL14
IC7: 7805T; TO220H
R1, R5: 3K3; 0204/7
R2, R4, R6, R7, R8, R18, R19, R20, R22, R23, R25, R28, R29: 10K; 0204/7
R9, R10: 1M; 0204/7
R11: 820R; 0204/7
R12: 6K2; 0204/7
R13: 100K; 0204/7
R15: 150R 1W; 0204/7
R16: 10M; 0204/7
R17: 330K; 0204/7
R21: 47K; 0204/7
R24, R30: 1K; 0204/7
R26: THERMISTOR-7,5; R-7,5
RP1: 3K9; SIL10
RP2: 8K2; SIL10
SK2: 2.1MMJACKTHM; PJ-102A
SW1: SW_DIP-4; EDG-04
TR2: 2N3904; TO92
X1: 6 MHz; HC49U-H

Connections:
0V: C1.-, C2.2, C4.2, C5.2, C6.-, C7.-, C9.2, C10.+, D6.A, D7.A, D8.A, D10.A, DB15.9, DB15.10, DIN1.PE (MT), DIN1.PE1 (MT), DIN1.PE2 (MT), DIN1.PE@ (MT), IC1.20 (VSS/GND), IC1.24 (P23), IC2.6 (S), IC2.7 (VSS), IC2.8 (S), IC2.10 (R), IC3.1 (OC), IC3.10 (GND), IC4.7 (GND), IC5.7 (GND), IC6.12 (GND), IC7.2 (GND), R10.1, R15.1, R21.2, R22.2, R25.1, R30.2, RP2.1, TR2.3 (E)
!INT: IC1.6 (!INT), IC1.23 (P22), IC6.1 (OUT)
+5V: C1.+, C2.1, IC1.26 (!PS), IC1.40 (VCC/5V), IC2.5 (D), IC2.14 (VDD), IC3.20 (VCC), IC4.14 (VCC), IC7.3 (VO), R2.2, R4.2, R6.2, R7.2, R8.2, R13.1, R16.2, R17.1, R18.1, R19.1, R20.2, R23.2, R28.2, R29.2, RP1.1
+12V: C7.+, D8.C, D13.A, IC5.14 (VCC+), IC6.3 (V+), IC7.1 (VI), R9.2, R26.1, SK2.TIP
-12V: C3.-, C10.-, IC5.1 (VCC-), R5.1, R15.2, SK2.RING, SK2.RING_SW
ALE: IC1.11 (ALE), IC2.11 (CLK)
IR: D1.C, IC5.6 (2Y)
unnamed: IC4.1 (I0), IC4.11 (O), IC6.9 (+IN), R20.1
unnamed: IC3.11 (CLK), IC4.3 (O), R8.1
unnamed: IC4.12 (I0), R19.2, SW1.5
unnamed: SW1.1, SW1.2, SW1.3, SW1.4
unnamed: IC4.2 (I1), R18.2, SW1.6
unnamed: IC5.4 (2A), IC5.10 (3B), IC5.13 (4B), R6.1
unnamed: C6.+, IC1.4 (!RESET)
unnamed: IC1.7 (EA), R30.1
unnamed: C9.1, IC6.7 (+IN), IC6.14 (OUT), R17.2
unnamed: IC6.6 (-IN), IC6.8 (-IN), IC6.11 (+IN), R13.2, R21.1
unnamed: C5.1, IC1.2 (XTAL1), X1.1
unnamed: C4.1, IC1.3 (XTAL2), X1.2
unnamed: R24.1, TR2.1 (C)
unnamed: D12.C, R25.2, TR2.2 (B)
unnamed: D13.K (C), R24.2
unnamed: IC2.1 (Q), IC2.9 (D)
unnamed: IC2.4 (R), IC2.13 (Q), IC6.10 (-IN)
unnamed: IC5.5 (2B), IC6.13 (OUT), R2.1
unnamed: D1.A, R5.2
unnamed: D2.A, D3.K (C)
unnamed: D3.A, D4.K (C)
unnamed: D4.A, D5.K (C)
unnamed: D5.A, R1.1
unnamed: C3.+, R1.2, R26.2
P10: IC1.27 (P10), IC3.19 (8Q)
P11: IC1.28 (P11), IC3.2 (1Q)
P12: IC1.29 (P12), IC3.16 (7Q)
P13: IC1.30 (P13), IC3.5 (2Q)
P14: IC1.31 (P14), IC3.15 (6Q)
P15: IC1.32 (P15), IC3.6 (3Q)
P16: IC1.33 (P16), IC3.12 (5Q)
P17: IC1.34 (P17), IC3.9 (4Q)
P20: IC1.21 (P20), IC5.2 (1A), SW1.8
P21: IC1.22 (P21), SW1.7
P24: IC1.35 (P24), IC2.3 (CLK)
P25: D12.A, IC1.36 (P25), R23.1
P26: IC1.37 (P26), IC4.10 (I1), IC5.12 (4A)
P27: IC1.38 (P27), IC4.4 (I0), IC5.9 (3A)
PARALLEL_!DATASTROBE!/DAV: DB15.15, IC4.13 (I1), RP1.10 (2), RP2.10 (2)
PARALLEL_DAT1: DB15.1, IC3.18 (8D), RP1.9 (2), RP2.9 (2)
PARALLEL_DAT2: DB15.2, IC3.3 (1D), RP1.8 (2), RP2.8 (2)
PARALLEL_DAT3: DB15.3, IC3.17 (7D), RP1.7 (2), RP2.7 (2)
PARALLEL_DAT4: DB15.4, IC3.4 (2D), RP1.6 (2), RP2.6 (2)
PARALLEL_DAT5: DB15.5, IC3.14 (6D), RP1.5 (2), RP2.5 (2)
PARALLEL_DAT6: DB15.6, IC3.7 (3D), RP1.4 (2), RP2.4 (2)
PARALLEL_DAT7: DB15.7, IC3.13 (5D), RP1.3 (2), RP2.3 (2)
PARALLEL_DAT8: DB15.8, IC3.8 (4D), RP1.2, RP2.2
PARALLEL_DTR/BUSY/NRFD: DB15.14, IC4.6 (O), R7.1
PARALLEL_RTS/!ACK!/NDAC: DB15.13, IC4.8 (O), R4.1
PARALLEL_UNNAMED1: DB15.11, IC4.9 (I0), R28.1
PARALLEL_UNNAMED2: DB15.12, IC4.5 (I1), R29.1
SERIAL_0V: DIN1.4, IC6.5 (+IN), R9.1, R10.2, R11.1
SERIAL_DTR: D7.C, DIN1.5, IC5.8 (3Y)
SERIAL_IROP: D10.C, DIN1.2, IC5.3 (1Y)
SERIAL_RTS: D6.C, DIN1.3, IC5.11 (4Y)
SERIAL_RX: DIN1.1, IC6.4 (-IN), R11.2, R12.1, R12.2, R22.1
T0: IC1.1 (T0), IC6.2 (OUT), R16.1

Notes on the sheet:
(c) 2016 Simon Inns Licensing (CC BY 4.0) Attribution 4.0 International
Status LED is ON after power up and OFF after initialisation with the host.
DAT1 to DAT8 (input) DAV = Data Valid (input) NRFD = Not Ready For Data (output) NDAC = Not Data Accepted (output) (IEEE-488 standard)
Flip-flops provide 2.5 microsecond pulse to IR stage
Baud rate should be between 2400kB and 4800kb
Supply @ 24VDC/500mA
